okunevpy-create/TRX_27MHz/README.md

# TRX 27 MHz — самодельная КВ/СВ радиостанция

Модульная радиостанция диапазона 27 МГц (AM + SSB фазовым методом) для автомобиля и автономной работы.

## Назначение
- Связь на частотах дальнобойщиков (15-й канал, 27.135 МГц, AM).
- Радиолюбительские связи SSB (вызывная 27.190 МГц).

## Ограничения и риски
- **Мощность**: AM — не более 4 Вт (несущая), SSB — не более 12 Вт (пиковая). Ограничитель AM — обязателен, отключаемый через физический тумблер LIMIT/FULL на УМ.
- **Термостабильность SSB**: открытый вопрос, решается отдельной сессией (кварц Si5351 ±20 ppm).
- **Регуляторика**: безлицензионная СиБи в РФ; отключение ограничителя AM — осознанное действие пользователя.

## Этапы и подэтапы
| Этап | Название | Папка | Подэтапы |
|---|---|---|---|
| **0** | Мастер-лист (интерфейсы) | `KiCad/00_master` | — |
| **1** | Плата управления | `KiCad/01_control` | 1.1–1.5 |
| **2** | Усилитель мощности | `KiCad/02_power_amp` | 2.1–2.4 |
| **3** | Тракт RX/TX | `KiCad/03_rx_tx` | 3.1–3.5 |
| **4** | Корпусирование | `Mechanical/` | 4.1–4.5 |

## Рекомендуемый порядок работ
1. **Этап 0** — мастер-лист: иерархия и все межблочные сигналы.
2. Зафиксировать контракты (`docs/contracts/`).
3. Схемотехника 1.1–1.4.
4. Схемотехника 2.1–2.2.
5. **Совместно** 1.5 + 2.3 (PTT, I_sense, SWR_sense, PWR_LIMIT_EN/SW, RX_audio).
6. ⚠️ **Только теперь** — травление и монтаж платы этапа 1.
7. Доделать 2.4 (тепловой расчёт).
8. Этап 3 (3.1–3.5).
9. Этап 4 (4.1–4.5).

> **⚠️ Важно:** изготовление платы этапа 1 (травление, монтаж) начинается **только после** завершения совместных работ 1.5 + 2.3 и фиксации контракта `control_pa.md`. До этого — только схемотехника и разводка в KiCad, без травления.

## Структура
- `docs/` — документация, контракты, BOM, расчёты.
- `Firmware/` — прошивка (PlatformIO, STM32F411).
- `KiCad/` — проекты плат, локальные библиотеки.
- `Mechanical/` — корпус, панели, крепления (FreeCAD).

## Быстрые ссылки
- [Архитектура и декомпозиция](docs/block-diagram.md)
- [Питание](docs/power-distribution.md)
- [Контракты](docs/contracts/README.md)
- [BOM](docs/bom/README.md)
- [Расчёты](docs/calculations/README.md)
- [Контекст для сессий](docs/context.md)
- [Оборудование](docs/equipment.md)
- [Распиновка](docs/inter-module-pinout.md)
- [Каналы](docs/channels.md)
- [KiCad](KiCad/README.md)
- [Прошивка](Firmware/README.md)
- [Механика](Mechanical/README.md)
