okunevpy-create/TRX_27MHz/docs/README.md

# Документация проекта

- [block-diagram.md](block-diagram.md) — архитектура и декомпозиция этапов
- [power-distribution.md](power-distribution.md) — распределение питания
- [inter-module-pinout.md](inter-module-pinout.md) — сводная распиновка
- [pcb_placement_plan.md](pcb_placement_plan.md) — компоновка плат/разъёмов/кабелей в корпусе (подготовительный регламент PCB)
- [pcb_design_rules.md](pcb_design_rules.md) — правила проектирования PCB (домашнее изготовление): стек, зазоры, VIA, Edge.Cuts, origin
- [pcb_layout_stage1.md](pcb_layout_stage1.md) — поэтапный план размещения компонентов платы `01_control` (кромки разъёмов + блочная раскладка)
- [channels.md](channels.md) — сетки каналов
- [front_panel_elements.md](front_panel_elements.md) — элементы лицевой панели (OLED, энкодер, джойстик, RIT, гарнитура, LED PWR/TX/LIM)
- [led_debug_scheme.md](led_debug_scheme.md) — отладочные светодиоды (дублирующие + power-good); **все LED 0805 — в наличии (STOCK)**
- [kicad_task_stage1.md](kicad_task_stage1.md) — ТЗ KiCad-сессии (F1–F13) для `01_control`
- [context.md](context.md) — контекст для сессий
- [equipment.md](equipment.md) — измерительное оборудование
- [contracts/](contracts/) — интерфейсные контракты
- [bom/](bom/) — списки компонентов
- [calculations/](calculations/) — расчёты
