okunevpy-create/TRX_27MHz/docs/calculations/README.md

# Расчёты

- [power_limit.md](power_limit.md) — ограничитель мощности AM (4 Вт)
- [power_budget_stage1.md](power_budget_stage1.md) — точный бюджет токов 01_control (покомпонентный, с учётом периферии передней панели)
- [rit.md](rit.md) — расстройка SSB (RIT)
- [lpf_27mhz.md](lpf_27mhz.md) — ФНЧ 27 МГц (5-й порядок, Чебышёв 0.1 дБ) — этап 2, подэтап 2.2
- [bpf_27mhz.md](bpf_27mhz.md) — BPF 27 МГц (двухконтурный, ёмкостно-связанный, 2 полюса Баттерворт) — этап 3, подэтап 3.1
- [pa_stage2.md](pa_stage2.md) — УМ этапа 2: push-pull RD16HHF1, трансформаторы, смещение/лимитер, датчики, теплоотвод — этап 2, подэтапы 2.1/2.3/2.4

## Заготовки
- Кварцевый фильтр ПЧ — этап 3, подэтап 3.2
- Согласование/КСВ 27 МГц + защита RX — этап 3
