okunevpy-create/TRX_27MHz/docs/design_decisions_stage3.md

# Проектные решения этапа 3 — тракт RX/TX (03_rx_tx)

> Сессия 2026-10-31. Фиксирует архитектуру и номиналы перед построением схемы
> одним `sch_build_circuit` (3.1–3.5 целиком).

## Частотный план
- ПЧ = **10 МГц**, VFO = **37 МГц** (верхняя гетеродинная), BFO = **10 МГц**.
- RX: 27 МГц × 37 МГц → 10 МГц (разностная). TX: 10 МГц × 37 МГц → 27 МГц (разностная).

## Архитектура (фильтровый метод SSB + AM)
- **U1** (NE612) — двунаправленный смеситель: RX-вниз (RF→ПЧ) и TX-вверх (ПЧ→RF).
- **U2** (NE612) — продукт-детектор SSB (ПЧ × BFO → НЧ).
- **U4** (NE612) — балансный модулятор TX (НЧ × BFO → DSB @10 МГц).
- **X1–X4** — лестничный кварцевый фильтр 4×10 МГц, **общий** для RX (селекция ПЧ)
  и TX (выделение одной боковой из DSB).
- **K1** (реле IM06GR, DPDT) — T/R: переключает порты U1 между RX и TX.
- **Q1** (2SC2314, TO-92L) — драйвер TX, класс A/AB (линейный), ~0.2–0.5 Вт на УМ.
- **U3** (LM386) — УНЧ на динамик.

## T/R-коммутация (K1, IM06GR)
Пинаут IM06GR (подтверждён по схеме этапа 2): катушка **1=+12V, 8=драйвер**;
полюс A **3=COM, 2=NC, 4=NO**; полюс B **7=COM, 6=NC, 5=NO**.

- Полюс A: COM(3)=вход U1 (пин 1), NC(2)=`RX_BPF_OUT`, NO(4)=`IF_MIX` (фильтр).
- Полюс B: COM(7)=выход U1 (пин 4), NC(6)=`IF_MIX` (фильтр), NO(5)=`TX_BPF_IN`.
- RX (PTT=0, реле обесточено): U1.вход←BPF_RX, U1.выход→фильтр.
- TX (PTT=1, реле под током): U1.вход←фильтр, U1.выход→BPF_TX.
- Драйвер катушки: **Q2 = 2N7002** (N-MOSFET), PTT→Q2.G через 10 кОм; катушка 8→Q2.D;
  катушка 1→+12V_RXTX; flyback **D_fb = 1N4148WS** параллельно катушке.

## Переключаемая полоса кварцевого фильтра (полярность решена)
- Топология Dishal-лестница: 4 кварца в серию, связующие ёмкости на землю.
- Направление: **больше связующая ёмкость → уже полоса** (Cc ∝ 1/BW).
- Три промежуточные связующие (между X1–X2, X2–X3, X3–X4) — переключаемые:
  - **SSB (MODE=0, узкая ~2.7 кГц):** 47 пФ + 68 пФ = 115 пФ (диод открыт).
  - **AM (MODE=1, широкая ~6 кГц):** 47 пФ (диод закрыт).
- Ключ (на каждый стык N1/N2/N3): **1N4148WS**, A→узел, K→68 пФ→GND;
  `R_bias 100 кОм` узел→`V_sw` (~+3 В, общий делитель R_a=R_b от +6V);
  `R_mode 10 кОм` K-узел→MODE. MODE=0 → диод открыт (узкий), MODE=3.3 В → закрыт (широкий).
  Диодный ток ~20 мкА (мал для идеального ВЧ-ключа — на bring-up).
- Терминация: **470 Ом** (фикс., SSB) / 220 Ом (AM) — подбор на bring-up.

## Питание
- `+12V_RXTX` → **U5 (LM7809)** → `+9V` → **U6 (L78L06)** → `+6V` (NE612 ×3).
- **U3 (LM386)** на `+9V`; **Q1 (2SC2314)** на `+12V_RXTX` (через RFC).
- Развязка: электролит + 100 нФ на входе/выходе каждого стабилизатора.

## NE612 — single-ended включение (исправлено 2026-10-31)
- VCC(8)=+6V, GND(3). Развязка 100 нФ на VCC.
- Вход: пин 1 = сигнал, пин 2 → GND через 100 нФ (U1/U2) или **4.7 нФ** (U4 — сюда же подаётся смещение несущей).
- **Выход (открытый коллектор):** оба пина **4 и 5** — каждый через свою подтяжку **2.2 кОм к +6V**.
  Пин 4 = сигнал (через 10 нФ к следующему каскаду); пин 5 = 2.2 кОм к +6V + **10 нФ на GND**.
- LO: пин 6 = сигнал (через 10 нФ), пин 7 → GND через 100 нФ.
- U1 LO = `VFO` (37 МГц); U2/U4 LO = `BFO` (10 МГц).

## Несущая AM — разбаланс U4 (решено)
- Фильтровый метод даёт DSB-SC (несущая подавлена). Для AM приоткрываем баланс U4
  постоянным смещением на IN_B (пин 2) → BFO-несущая просачивается → DSB+несущая → фильтр → AM.
- `R22 100 кОм` MODE→U4.2; `RV1 10 кОм` — **делитель**: верхний вывод (1) → `R23 100 кОм` → +6V, нижний (3) → GND, движок (2) → `R24 100 кОм` → U4.2.
- MODE=0 (SSB) → баланс (DSB-SC); MODE=1 (AM) → смещение (несущая). Уровень несущей — подбор на bring-up.

## Ключевые номиналы
| Узел | Номинал |
|---|---|
| BPF 27 МГц | 2×0.47 мкГн + 2×51 пФ + 2×18 пФ + 1×2.7 пФ на фильтр (C0G 100 В) |
| Связующие фильтра ПЧ | 47 пФ (база) + 68 пФ (диод) |
| Терминация фильтра ПЧ | 470 Ом (SSB) / 220 Ом (AM) |
| Защита RX | 1N4148WS ×2 антипараллельно + T-pad 3 дБ (8.2 Ом×2 + 150 Ом) |
| LM386 | gain 20 (пины 1/8 свободны), C_вых 10 мкФ + 47 нФ, выход→J9 |
| 2SC2314 | класс A/AB (линейный): база делитель 47к/10к + C_in 100пФ, эмиттер R_e 47Ом + 10нФ, коллектор RFC 10мкГн→+12V_RXTX + C_out 100пФ, согласование 50 Ом (bring-up) |
| Аттенюатор RX | 3 дБ T-pad (8.2 Ом×2 + 150 Ом) |
| Несущая AM | разбаланс U4: R22 100к MODE→U4.2 + RV1 10к делитель (верх→R23 100к→+6V, низ→GND, движок→R24 100к→U4.2) |

## Сигналы/разъёмы
`J1` RX_RF, `J2` TX_RF, `J3` VFO, `J4` BFO (все SMA); `J5` MODE, `J9` SP (2P);
`J6` PTT_MUTE, `J7` AUDIO (3P); `J8` PWR (клеммник 2P). Референсы схемы — `J1`–`J9`.

## Открытые точки (bring-up)
- Точные связующие ёмкости/терминация кварцевого фильтра — подбор по АЧХ.
- Согласование Q1 (2SC2314) — по выходной мощности.
- Согласование 50 Ом NE612 (при необходимости — трансформаторы/LC).
