okunevpy-create/TRX_27MHz/docs/inter-module-pinout.md

# Сводная распиновка межмодульных разъёмов

> Детальные контракты — в `contracts/`.

## Этап 1 (`01_control`) ↔ Этап 2 (`02_power_amp`)
Контракт: [contracts/control_pa.md](contracts/control_pa.md)

### J_PA_CTRL_1 (XH2.54, 4P)
| Пин | Сигнал | Направление | Примечание |
|-----|---|---|---|
| 1 | GND | — | сигнальная земля |
| 2 | PTT | control → PA | ключ TX, управление T/R реле |
| 3 | PWR_LIMIT_EN | control → PA | программное управление ограничителем |
| 4 | PWR_LIMIT_SW | PA → control | обратная связь: положение тумблера |

### J_I_SENSE_1 (XH2.54, 2P)
| Пин | Сигнал | Направление | Примечание |
|-----|---|---|---|
| 1 | I_sense | PA → control | аналоговый, с шунта (витая пара с пин 2) |
| 2 | GND | — | возврат I_sense |

### J_SWR_1 (XH2.54, 2P)
| Пин | Сигнал | Направление | Примечание |
|-----|---|---|---|
| 1 | SWR_sense | PA → control | аналоговый, направленный ответвитель (витая пара с пин 2) |
| 2 | GND | — | возврат SWR_sense |

### J_PA_PWR_1 (клеммник 2P, 5.0 мм)
| Пин | Сигнал | Направление | Примечание |
|-----|---|---|---|
| 1 | +12V_PA | control → PA | защищённые, звёздой от входного узла control |
| 2 | GND | — | силовая земля, отдельная от сигнальной, соединение в одной точке |

## Этап 1 (`01_control`) ↔ Этап 3 (`03_rx_tx`)
Контракт: [contracts/control_rxtx.md](contracts/control_rxtx.md)

### Интерфейс 1↔3 (5 сигнальных разъёмов)
Единый `J_RXTX_SIG_1` (10P) **разбит на 5 разъёмов** (2026-10-30, обновлено 2026-11-05): VFO/BFO — **SMA** (коаксиал), MODE (2P), PTT/MUTE и аудио — отдельными группами (3P). На `03_rx_tx` эти сигналы приходят на `J3`/`J4`/`J5`/`J6`/`J7`.

#### J_VFO_1 / J_BFO_1 (SMA) + J_MODE_1 (2P)
| Разъём | Пин 1 | Пин 2 | Направление | Примечание |
|---|---|---|---|---|
| J_VFO_1 | VFO | GND | control → rxtx | ~37 МГц, ~1 В pp, коаксиал → `J3` |
| J_BFO_1 | BFO | GND | control → rxtx | 10 МГц, ~1 В pp, коаксиал → `J4` |
| J_MODE_1 | MODE | GND | control → rxtx | 0/3,3 В (0=SSB, 1=AM), обычный провод → `J5` |

#### J_PTT_MUTE_1 (3P)
| Пин | Сигнал | Направление | Примечание |
|-----|---|---|---|
| 1 | PTT | control → rxtx | 0/3,3 В |
| 2 | GND | — | — |
| 3 | MUTE | control → rxtx | 1 = звук заглушён (squelch) |

#### J_AUDIO_1 (3P)
| Пин | Сигнал | Направление | Примечание |
|-----|---|---|---|
| 1 | RX_audio | rxtx → control | для squelch (ADC), витая пара |
| 2 | GND | — | — |
| 3 | MIC_LINE | control → rxtx | line-level ~100 мВ, витая пара |

### J8 (клеммник 2P, 5.0 мм)
| Пин | Сигнал | Направление | Примечание |
|-----|---|---|---|
| 1 | +12V_RXTX | WAGO → rxtx | напрямую с WAGO 221-415 (13,8 В от LTC3780) |
| 2 | GND | — | силовая земля |

## Этап 2 (`02_power_amp`) ↔ Этап 3 (`03_rx_tx`) — ВЧ напрямую, минуя control
Контракт: [contracts/rxtx_pa.md](contracts/rxtx_pa.md)

| Сигнал | Направление | Примечание |
|---|---|---|
| TX_RF | rxtx → PA | ~0,5 Вт раскачки, 50 Ом, SMA |
| RX_RF | PA → rxtx | до 1 Вт просачивания, с T/R реле, защита на входе rxtx |
| GND | — | экран |

## Корпусные соединения (не межплатные)
Гарнитура подключается к корпусным разъёмам, от них — проводами на разъёмы/пады плат.
| Откуда (корпусной разъём) | Куда (плата) | Сигнал |
|---|---|---|
| 2.5 мм (MIC, Tip) | `01_control` `J_HS_1:1` | MIC (сырой с электрета) |
| 2.5 мм (PTT, Ring) | `01_control` `J_HS_1:3` | PTT (замыкание на GND) |
| 2.5 мм (GND, Sleeve) | `01_control` `J_HS_1:2` | GND (общий + экран микрофона) |
| 3.5 мм (SP+) | `J9` на `03_rx_tx` | SP+ (выход УНЧ) |
| 3.5 мм (GND) | `J9` на `03_rx_tx` | GND (общий с УНЧ) |

> **`J_HS_1`** (XH2.54 3P, на `01_control`): 1=MIC, 2=GND, 3=PTT_IN — микрофон/PTT/земля гарнитуры одним разъёмом (экран микрофона — на `J_HS_1:2` GND).

> Полная распиновка контактов (Tip/Ring/Sleeve) гарнитурных разъёмов — в
> [contracts/control_rxtx.md](contracts/control_rxtx.md), раздел «Гарнитура →
> Распиновка корпусных разъёмов гарнитуры».

## Замечания по земле
На Этапе 0 (логическая схема) — один `GND` на всех листах. В реальных платах земля раздельная: `GND_DIG`, `GND_ANA`, `GND_PWR`, соединение — в одной точке на каждой плате.
