okunevpy-create/TRX_27MHz/docs/session_report_stage3.md

# Отчёт сессии — Этап 3 (схема `03_rx_tx`, подэтапы 3.1–3.5)

> Дата: 2026-10-31. Цель: построить схему тракта RX/TX целиком одним `sch_build_circuit` и пройти первые проверки.
>
> ⚠️ **Поправка (2026-11-05):** переименование разъёмов `J1`–`J9` → `J_*_1` (п. 1 ниже) **не сохранилось/отменено** — на схеме `03_rx_tx` разъёмы остались **`J1`–`J9`**. Документация приведена к `J1`–`J9` (см. `pcb_layout_stage3.md`, `control_rxtx.md`).

## Итог
- **Схема `03_rx_tx.kicad_sch` ПОСТРОЕНА целиком** (113 компонентов, auto_layout, лист A2): подэтапы 3.1–3.5.
- **ERC: 0 ошибок / 0 warning — PASS.**
- Разъёмы переименованы в функциональные с индексом `_1`; драйвер TX — **2SC2314**.

## Сделанные исправления (после первого ERC)
1. **Разъёмы J1–J9 → `J_*_1`** (`sch_modify_property` на поле Reference, метки не менялись — связность сохранена):
   `J_RF_RX_1`, `J_RF_TX_1`, `J_VFO_1`, `J_BFO_1`, `J_MODE_1`, `J_PTT_MUTE_1`, `J_AUDIO_1`, `J_RXTX_PWR_1`, `J_SP_1`.
2. **Q1.1 (база драйвера)** — подключён к цепи `Q1_B` (был пропущен в netlist).
3. **NC-маркеры** на неиспользуемые выводы LM386: пины 1/7/8 (gain=20).
4. **Footprint'ы** приведены к реальным именам библиотек:
   - `Package_SO:SOIC-8_3.9x4.9mm_P1.27mm` (U1–U4; handsoldering-варианта SOIC-8 в KiCad нет);
   - `Capacitor_SMD:C_0603_1608Metric_Pad1.08x0.95mm_HandSolder` (все 0603 C; был Pad1.05).

## Ключевые проектные решения (зафиксированы)
- ПЧ = 10 МГц; VFO = 37 МГц (верхняя гетеродинная), BFO = 10 МГц.
- NE612AD ×3: U1 (смеситель RX/TX), U2 (продукт-детектор SSB), U4 (балансный модулятор TX).
- **Выходы NE612 (открытый коллектор):** пин 4 = сигнал (2.2 кОм к +6V + 10 нФ к каскаду); пин 5 = 2.2 кОм к +6V + 10 нФ на GND (НЕ напрямую на +6V).
- **AM-несущая** — разбаланс U4: `R_carr 100к` MODE→U4.2 + триммер `RV_carr 10к` (последовательно 47к к +6V, движок→U4.2). `C_byp` на U4.2 = 4.7 нФ.
- **Переключаемая полоса кварцевого фильтра:** X1–X4 (10 МГц), связующие 47 пФ (база) + 68 пФ (через 1N4148WS-ключ), MODE=0 → узкая SSB / MODE=1 → широкая AM.
- **Драйвер TX = 2SC2314** (TO-92L, класс A/AB линейный; заменил 2SC2078).

## Осталось (не блокирует PCB)
- Номиналы связующих/терминации кварцевого фильтра и согласование Q1 — подбор на bring-up.
- Ревью схем 1+2+3 в GUI KiCad → перенос на PCB → разводка.

## Commits
- `hw:` — схема этапа 3 (`03_rx_tx.kicad_sch`).
- `docs:` — design_decisions_stage3, BOM stage3, context, session_report, README/block-diagram.
