okunevpy-create/TRX_27MHz/docs/session_report_stage2.md

# Отчёт сессии — Этап 2: схемотехника `02_power_amp` (2.1–2.3)

Дата: 2026-10-30

## Область
Построение полной схемы усилителя мощности (`KiCad/02_power_amp`) и приведение
BOM/контрактов в соответствие схеме (простые ref, разъёмы с индексом).

## Сделано

### Схема (KiCad)
- Построены блоки 2.1–2.3:
  - **2.1 Push-pull УМ:** Q1/Q2 (RD16HHF1), входной/выходной балуны T1/T2
    (BN-61-202), RFC L1 (T68-2), развязка стоков C1/C2, bulk C3/C4,
    затворные R1/R2, опц. ООС R17/R18 (DNP).
  - **2.2 ФНЧ 27 МГц:** L2/L3 (T50-6), C6/C8 (120 пФ), C7 (220 пФ) — C0G 100 В.
  - **2.3 Датчики + LIMIT/FULL + смещение + T/R:** реле K1 (IM06GR), ключи
    Q3/Q4 (2N7002), обратный диод D1, диоды «ИЛИ» D2/D3, смещение затворов
    R3–R6 + RV1, делитель PWR_LIMIT_SW R7/R8, I_sense (R16 шунт, U1 LM358,
    R12–R15), КСВ-детектор (L4, D4/D5), LED D6/D7 + R10/R11.
- **ERC: 0 нарушений (PASS).**
- Флаги питания в порядке: `PWR_FLAG` на `+12V_PA`.
- **Разъёмы с индексом (7):** `J_RF_TX_1`, `J_RF_RX_1`, `J_ANT_1`,
  `J_PA_CTRL_1`, `J_PA_PWR_1`, `J_SW_1`, `J_LIM_LED_1`.
- **LM358** (U1) разведён **тремя юнитами** (unit 1/2/3) отдельно от
  `sch_build_circuit`; пины питания/входы/выходы подключены.
- **K1:5/6/7** — `no-connect` (добавлено после сборки через `sch_add_no_connect`).
- **R17/R18** — **DNP** (причина: опц. ООС/стабилизация, не монтировать).

### BOM (`docs/bom/stage2_power_amp.md`)
- Все позиции на схеме — простые ref (`R1…R18`, `C1…C10`, `L1…L4`, `D1…D7`,
  `Q1…Q4`, `T1/T2`, `RV1`, `U1`, `K1`).
- Добавлены отсутствовавшие позиции (R3–R6, C5/C9/C10, D2/D3 и др.).
- **1N4148WS — ×3** (D1 + D2/D3).
- U1 footprint уточнён: `Package_SO:SOIC-8_3.9x4.9mm_P1.27mm` (HandSolder-варианта
  SOIC-8 в KiCad нет).
- В таблицу «Разъёмы (J_*)» добавлен `J_LIM_LED_1`.

### Контракты и документация
- `docs/contracts/control_pa.md`: разъёмы `J_PA_CTRL_1`, `J_PA_PWR_1`, `J_SW_1`,
  `J_LIM_LED_1`, `J_ANT_1`.
- `docs/contracts/rxtx_pa.md`: `J_RF_TX_1`, `J_RF_RX_1`, `J_ANT_1`;
  `J_ANT_1` (SMA, плата) → BNC **BJ2** (панель).
- Расчётные/панельные доки, `kicad_task_stage2.md`, `design_decisions_stage2.md`,
  `README` — разъёмы приведены к индексированным именам.

## Правила (зафиксированы в `AGENTS.md` §7)
- `auto_layout=True` и ручные координаты одновременно не работают.
- Multi-unit символы (LM358) в `sch_build_circuit` не включать — разводить отдельно.
- Разъёмы (`J`) — тоже с индексом на конце (`J_RF_TX_1`); голое имя — ошибка.
- NC добавляется **после** сборки через `sch_add_no_connect`.

## Проверки
- `run_erc`: **0 нарушений (PASS)**.
- `sch_get_symbols`: состав/разъёмы/LM358 (3 юнита) — корректны.
- `sch_get_net_names`: сигнальные/силовые цепи корректны, нет `J_*`-меток.
- `sch_check_power_flags`: флаги питания в порядке.
- `sch_get_population_status`: R17/R18 `dnp=true`.

## Следующие шаги
1. Ревью схемы в GUI KiCad (footprint'ы, в т.ч. LM358 SOIC-8; визуальная проверка
   разводки LM358 и подстроечника).
2. При необходимости — уточнить footprint LM358 (HandSolder-варианта нет,
   оставить стандартный SOIC-8).
3. PCB этапа 2 (2.1–2.3): размещение, трассировка, DRC/DFM.
4. Травление платы — **отдельный шаг** (после PCB + всех проверок).
