okunevpy-create/TRX_27MHz/docs/session_report_1.4.md

# Отчёт по KiCad-сессии: подэтап 1.4 (`01_control`) — MIC-предусилитель + RX_audio RC

> **Дата:** 2026-10-28
> **Статус:** ВЫПОЛНЕНО — ERC без новых ошибок, закоммичено.
> **Промт сессии:** [`session_prompt_1.4.md`](session_prompt_1.4.md)

## Итог

Подэтап 1.4 завершён: неинвертирующий MIC-предусилитель на U7 (LM358, unit A)
с полной обвязкой и RC-фильтр входа `RX_audio` (squelch). Новые refdes
**R23–R28 / C39–C41** уникальны, коллизий нет. Лист увеличен до **A2
(594×420 мм)**.

## Таблица «задача → сделано → отклонения»

| Задача | Сделано | Отклонения |
|---|---|---|
| 3.1 MIC-предусилитель U7 (неинвертирующий) | ✅ unit A обвязан (R23–R27, C39, C41); K≈11, DC gain=1; OUT→`MIC_LINE` | нет |
| 3.2 RC-фильтр `RX_audio` → ADC | ✅ R28=1к + C40=10нФ (τ=10 мкс), узел `RX_audio_F` | нет |
| 3.3 RIT: только цепи | ✅ проверено: `BTN_RIT` (J_BTN:7), `ENC_*` (J_ENC) заведены через RC-фильтры; ничего не добавлялось | нет |
| Unit B U7 | ✅ остаётся на GND/NC (из F3) | нет |
| ERC без новых ошибок | ✅ 68 error + 16 warning (baseline 73+16) | см. «Остаточные ERC» |

## Карта фактических refdes (1.4)

| Ref | Значение | Назначение | Footprint |
|-----|---|---|---|
| R23 | 2.2 кОм | bias электрета (+3V3 → MIC+) | R_0603…HandSolder |
| R24 | 10 кОм | делитель смещения (верх, +3V3 → V+) | R_0603…HandSolder |
| R25 | 10 кОм | делитель смещения (низ, V+ → GND) | R_0603…HandSolder |
| R26 | 100 кОм | обратная связь (Vout → V−) | R_0603…HandSolder |
| R27 | 10 кОм | усиление (V− → C41 → GND) | R_0603…HandSolder |
| R28 | 1 кОм | RC-фильтр `RX_audio` | R_0603…HandSolder |
| C39 | 1 мкФ | входная связь (MIC+ → V+) | C_0603…HandSolder |
| C40 | 10 нФ | RC-фильтр `RX_audio` | C_0603…HandSolder |
| C41 | 10 мкФ | AC-земля в ОС (последовательно с R27) | C_0805_2012Metric_Pad1.15x1.40mm_HandSolder |

## Выбранные футпринты

- Резисторы R23–R28: **0603** (Metric 1608), handsoldering-вариант.
- C39 / C40: **0603**; C41 (10 мкФ) — **0805** (в 0603 нет 10 мкФ).
- U7 LM358: `Package_SO:SOIC-8_3.9x4.9mm_P1.27mm_HandSolder` (из F3, не менялся).

## Топология цепей (подтверждено connectivity graph)

| Цепь | Пины / узлы |
|---|---|
| `MIC` | C39:1, R23:2 |
| `MIC_BIAS` | C39:2, R24:2, R25:1, U7:3 (IN+) |
| `MIC_FB` | R26:2, R27:1, U7:2 (IN−) |
| `MIC_AC` | C41:1, R27:2 |
| `MIC_LINE` | R26:1, U7:1 (OUT) |
| `RX_audio` | R28:1 |
| `RX_audio_F` | C40:1, R28:2 |

**Глобальные (межблочные):** `MIC_LINE` (выход U7), `RX_audio` (вход ADC) —
как и прочие интерфейсные сигналы (PTT, VFO, BFO, I, Q, MUTE, …).
**Локальные:** `MIC`, `MIC_BIAS`, `MIC_FB`, `MIC_AC`, `RX_audio_F`.

## Исправленное в сессии КЗ

Пересечение стабов `sch_add_pin_labels` давало КЗ `MIC`/`MIC_BIAS`/`MIC_FB`
(стабы ~10.16 мм пересекали соседние пины). Устранено переразводкой короткими
проводами/метками; висящие и дублирующие метки удалены. После правки топология
корректна, КЗ нет.

## Остаточные ERC (отложено до 1.5, согласовано)

- **68 error + 16 warning** (baseline после F3–F13: 73 + 16).
- Новых `pin_to_pin` / `multiple_net_names` / `power_pin_not_driven` — **нет**.
- Остаток: 15 висящих интерфейсных глобальных меток (`PTT`, `MIC_LINE`,
  `RX_audio`, `MUTE`, …), 28 свободных GPIO MCU, неиспользуемые пины U7/U8,
  изолированные `*_OUT`/`SPI_*`/`LCD_*`, разъёмы.
- Закрытие — в подэтапе **1.5** (совместно с 2.3, после фиксации контрактов).

## Замечания / отклонения от промта

- В промте `MIC_LINE` названа «иерархической меткой»; по факту использована
  **глобальная** метка — корректно для межблочного сигнала (AGENTS.md §4),
  электрически эквивалентно для мастер-листа `00_master`.
- Лист увеличен с A3 до **A2** (пользователем) для размещения обвязки MIC без
  наложений.
- `J_OLED` переразведён пользователем под фактический порядок модуля ST7789
  (1=GND, 2=`+3V3_DISP`, 3=`OLED_SCK`, 4=`OLED_MOSI`, 5=`LCD_RST`, 6=`OLED_DC`,
  7=`OLED_CS`, 8=`LCD_BLK`) — см. `docs/bom/stage1_control.md` §1.4.

## Definition of Done

- [x] 3.1–3.3 выполнены; каждое изменение подтверждено повторным чтением.
- [x] Нет коллизий refdes (R23–R28 / C39–C41 уникальны).
- [x] ERC без новых `pin_to_pin` / `multiple_net_names` / `power_pin_not_driven`.
- [x] Unit B U7 на GND/NC; unit A обвязан полностью.
- [x] `MIC_LINE` — глобальная метка (выход U7); `RX_audio` заведён через R28/C40.
- [x] Фактические refdes зафиксированы в `docs/bom/stage1_control.md` (1.4) и `docs/context.md`.
- [x] Отчёт — настоящий файл.
