okunevpy-create/TRX_27MHz/docs/context.md

# Контекст для сессий

Обновляетис ося после каждой сессии. Вставляется в начало новой сессии (или Continue читает сам).

## Текущий этап
**Все 3 платы: схемы ПОСТРОЕНЫ, ERC=0.** Этап 1 (`01_control`) — I/Q-балласт удалён, MODE (`J_MODE_1`, PB9), ERC=0. Этап 2 (`02_power_amp`) — ERC=0. **Этап 3 (`03_rx_tx`) — схема 3.1–3.5 ПОСТРОЕНА одним `sch_build_circuit` (113 компонентов), ERC=0 (0 ошибок / 0 warning).** Разъёмы `03_rx_tx` — `J1`–`J9`; драйвер TX = **2SC2314** (TO-92L, кл. A/AB). **01_control: PCB-разводка ЗАВЕРШЕНА (2026-11-02), DRC чист. 02_power_amp: PCB-разводка ЗАВЕРШЕНА (2026-11-04), DRC/ERC чисто.** **Следующий шаг:** изготовление плат `01_control` и `02_power_amp` (текстолит, отдельные шаги) после финального ревью; можно начинать разводку PCB этапа 3. **Этап прошивки (`Firmware/`): скелет реализован и собирается (`pio run` → SUCCESS, RAM 4.2 % / Flash 14.8 %).** Этап 0 — ОТЛОЖЕН.

## 02_power_amp: сдвиг к LTC3780 + крепления + сверка отверстий после merge (сессия 2026-11-05)
- ✅ Плата 2 сдвинута вплотную к LTC3780 (зазор 5 мм): `BOARD2_ORIGIN_X = LTC_ORIGIN_X + LTC_BOARD_X + 5.0 = 17.0` (было по центру 51.0). Освобождает плате 3 до **85 мм** «высоты» (было 51 мм).
- ✅ Добавлены в `params.py`: `BOARD2_HOLES` (H1–H4), `BOARD2_STANDOFF_*`, `board2_hole_positions()`; секция крепления LTC3780 (отверстия **TBD** — по факту заводской платы).
- ⚠️ **Дрейф после merge:** H1 платы 2 сместился на 0.63 мм (Y 52.92 → 52.29, отступ 4.81 → 4.18). Фактическое: H1=(4.83, 4.18). `pcb_layout_stage2.md` §1.1 и `params.py` обновлены.
- ⚠️ **Дрейф после merge:** в `context.md` «Текущий этап» вернулось «разъёмы переименованы в `J_*_1`» — исправлено на `J1`–`J9`. Контракт/планы (`control_rxtx.md`, `pcb_layout_stage3.md`) не пострадали.

## Stock: перенос файлов заказов/склада + оценка достаточности (сессия 2026-11-04)
- ✅ Файлы заказов и доступности остатков перенесены в `Stock/`: `ChipDipCart-Stage_1.csv`, `ChipDipCart-Stage_1.1.csv` (дозаказ этапа 1), `ChipDipCart-Stage_2.csv`, `DKO.csv`, `resistance_0603.csv`, `smd_resistors_0603.csv`, `capacitors_ 0603.csv`.
- ✅ Пути в доках обновлены на `Stock/...` (`AGENTS.md`, `.continue/rules/0603.md`, `stage1_control.md`, `stage2_power_amp.md`, `context.md`, `power_cleanup_plan.md`).
- ✅ Оценка достаточности и излишков: `Stock/surplus_stage1.md`, `Stock/surplus_stage2.md`.
- ℹ️ Тумблер LIMIT/FULL остаётся **ASW-14-102** (ON-ON, SPDT 3P) — замена на KN3(B)-101A-A1 отменена. Тумблер питания — KN3(B)-101A-A1.

## 02_power_amp: финальная проверка PCB — DRC/ERC чисто + net-классы через шаблоны (сессия 2026-11-04)
Полная проверка PCB этапа 2. Исправлено и перепроверено (**DRC=0, ERC=0**):
- ✅ `.kicad_dru`: имена цепей приведены к фактическим (`/PA_RET`, `/RFC_IN` — с ведущим слэшем); ранее правила `PA_RET`/`RFC_IN` без слэша не срабатывали.
- ✅ `/PA_RET` уширена 1.0 → 1.5 мм (обратная силовая шина, ~2–3 А).
- ✅ `/ANT_RELAY` уширена 0.6 → 1.0 мм (RF-тракт).
- ✅ Стабы `+12V_PA` к U1 VCC (LM358, пин 8, ~1 мА) доведены до 1.5 мм; пады SOIC-8 сами 0.6 мм — это норма (ширина дорожки задаётся током, а пад — корпусом компонента).
- ✅ Silkscreen-перекрытие D4 ↔ C11 устранено.
- ✅ **ЗАФИКСИРОВАНО (KiCad 10):** net-классы (`PWR_PA`/`RF_PA`) **определены в `.kicad_pro` (`net_classes`) и привязываются к цепям ЧЕРЕЗ ШАБЛОНЫ** (`netclass_patterns`), а не явным назначением (`netclass_assignments` = null). KiCad сам сопоставляет имя цепи с классом по шаблону; в `.kicad_pcb` секции `net_class` нет — это норма. См. `pcb_design_rules.md`, `pcb_layout_stage2.md` §4. **Не поднимать снова вопрос «net-классы не назначены».**
- Итог: плата этапа 2 готова (габарит 78×59 мм, **59 компонентов**, 41 net).

## 02_power_amp: подтяжка R21 — safe default LIMIT (сессия 2026-11-04)
- ✅ Добавлен **R21 (100 кОм, 0603)** между `PWR_LIMIT_SW` (глобальная метка) и `PLIM_LIM` (локальная метка) — подтяжка затвора Q5 к HIGH при отключённом тумблере → по умолчанию ограничитель активен (LIMIT, 4 Вт), а не полная мощность.
- ✅ ERC = 0; `lib_verify_component_contract(R21)` = PASS; footprint `R_0603_HandSolder` корректен.
- ✅ Счёт компонентов: 61 → **62**; число цепей не изменилось (R21 мостит уже существующие `PWR_LIMIT_SW`/`PLIM_LIM`).
- ⏳ PCB **не синхронизирована**: в GUI KiCad — `Tools → Update PCB from Schematic`, разместить и развести R21, затем `run_drc`/`run_erc`.

## 02_power_amp: вариант C — лимит только через прошивку (сессия 2026-11-04)
- ✅ Удалены **Q5** (аппаратный MOSFET от тумблера), **D2/D3** (диодное ИЛИ LED). Единственный ключ лимита — **Q3** (`PWR_LIMIT_EN`, PB10).
- ✅ Тумблер `PWR_LIMIT_SW` — чистый вход MCU (PA11). LED (`J_LIM_LED_1`/D6) — напрямую от `PWR_LIMIT_EN` (R9/R10).
- ✅ R21 остаётся как подтяжка входа `PWR_LIMIT_SW`→`PLIM_LIM` (нет тумблера = LIMIT).
- ✅ Прошивка: `_applyPowerLimit()` — `PWR_LIMIT_EN = AM && (тумблер LIMIT)`; захардкоженного дефолта нет (читается фактическое положение тумблера). Файлы `app.cpp`/`app.h`/`pins.h`.
- ✅ ERC = 0. Счёт компонентов: 62 → **59**.
- ⏳ PCB **не синхронизирована**: GUI `Tools → Update PCB from Schematic` (удалить Q5/D2/D3, обновить LED-связи), затем `run_drc`/`run_erc`.

## 02_power_amp: план разводки + токовый бюджет + net-классы + заклёпочная via (сессия 2026-11-04)
Подготовлен план разводки этапа 2. Плата изготавливается **дома**, переходные — **заклёпочные пистоны**.
- ✅ **Токовый бюджет** (`docs/calculations/power_budget_stage2.md`): покой **1.0 А** (Idq 0.5 А×2); полная мощность **1.78–2.11 А** (Po=16 Вт, η 55–65 %, 13.8 В); расчётный предел шины **3 А**. Шунт R16 (0.05 Ом) — в минусовой шине (`PA_RET → R16 → GND`).
- ✅ **Ширины дорожек** (IPC-2221, 1 oz, ΔT=10 °C): 3 А→1.367 мм, 1.5 А→0.525 мм, 0.5 А→0.115 мм.
- ✅ **Net-классы** (`docs/pcb_layout_stage2.md` §4): `PWR_PA` **1.5 мм** (`+12V_PA`/`PA_RET`/`RFC_IN`), `RF_PA` **1.0 мм** (`ANT`/`LPF_*`/`TX_RF`/`RX_RF`/`DRAIN1`/`DRAIN2`), Default **0.6 мм**. Назначение — точными именами, без wildcard.
- ✅ **VIA заклёпочная (переопределяет 0.5/1.5 мм только для этапа 2):** сверло **0.9 мм**, площадка **2.5 мм** (аннулюс 0.8 мм). Зафиксировано в `pcb_design_rules.md` §VIA и `pcb_layout_stage2.md` §5.
- ✅ **Зазоры/ширина (этап 2, 2026-11-04):** мин. дорожка **0.6 мм**, зазор медь–медь **0.4 мм**, GND-полигон **0.5 мм** (глобально 0.2/0.2/0.3 мм).
- ✅ **Габарит платы — по факту разводки** (заранее не фиксируется; минимум задают радиатор 102 мм и кромки разъёмов).
- Следующий шаг: пользователь в GUI KiCad — настройка net-классов + via Ø2.5/0.9, размещение + трассировка (Freerouting); агент проверит `run_drc`/gates.

## 02_power_amp: исправление КСВ-детектора — L4 → T3 (сессия 2026-11-04)
Блок КСВ (`L4/D4/D5/C10/R15/J_SWR_1`) был электрически оторван от остальной схемы (только GND). Исправлено:
- ✅ **L4 (2-выв. `Device:L`) → T3 (`Device:Transformer_1P_1S`, 4 выв.)** — токовый трансформатор КСВ: первичка AA/AB = **1 проход линии ANT в разрыв** (`ANT_RELAY`←`K1:3` → `ANT`→`J_ANT_1`); вторичка SA→GND, SB→`SWR_RF`.
- ✅ **D5 (фиксатор BAT54W) A→GND** (было оборвано после перехода на символ `Diode:BAT54W`); D4 (выпрямитель) A←`SWR_RF`, K→`SWR_sense`.
- ✅ **ERC = 0** (0 ошибок / 0 warning). NC-пины BAT54W (D4:2/D5:2) — штатно без no-connect.
- ✅ **Net `ANT_RELAY` добавлен** в `RF_PA` (1.0 мм) — сегмент линии ANT между K1 COM и T3.
- ✅ **Доки синхронизированы:** `bom/stage2_power_amp.md`, `design_decisions_stage2.md` §6, `kicad_task_stage2.md`, `pcb_layout_stage2.md` §4.2/§6/§8.4, `calculations/pa_stage2.md` — L4/T_swr → T3, символ/футпринт обновлены. Счёт: индуктивности 3 + трансформаторы 3 (всего 59).
- ✅ **`.kicad_dru` этапа 2 создан** (`KiCad/02_power_amp/02_power_amp.kicad_dru`) — синтаксис как у этапа 1: edge 0.5, via Ø2.5/0.8, hole-to-hole 0.5, GND clearance 0.5, ширины `+12V_PA`/`PA_RET`/`RFC_IN` 1.5 мм.
- ✅ **T1 футпринт унифицирован (по решению пользователя):** `Transformer_THT:Transformer_Toroid_Horizontal_D14.0mm_Amidon-T50` → `Connector_PinHeader_2.54mm:PinHeader_1x04_P2.54mm_Vertical` — теперь все три трансформатора на PinHeader (T1/T3 = 1x04, T2 = 1x05). BAT54W — осознанно оставлен (цоколёвка 1=A/2=NC/3=K).
- ✅ **Q4 (PTT) pull-down добавлен:** R20 (10 кОм, 0603) с затвора Q4 на GND — при отключённом разъёме реле гарантированно выключено (RX). Счёт компонентов: 60.

## 02_power_amp: return-loss мост — C11 выборка напряжения (сессия 2026-11-04)
Завершён SWR-детектор как **return-loss мост** (отражённая мощность), вместо «упрощённого детектора».
- ✅ **C11 (22 пФ C0G/NP0 100 В, подбор 10–33 пФ)** — конденсатор выборки напряжения с линии ANT на узел `SWR_RF` (`C11:1→ANT`, `C11:2→SWR_RF`).
- ✅ **Мост:** вторичка T3 (ток) + C11 (напряжение) гасят падающую волну → при согласовании 50 Ом `SWR_sense`≈0; в нагрузку/детектор уходит только отражённая волна.
- ✅ **ERC = 0** (0 ошибок / 0 warning). Счёт компонентов: **61** (конденсаторы 11).
- ✅ **Доки синхронизированы:** `design_decisions_stage2.md` §6, `bom/stage2_power_amp.md` §2.3, `pcb_layout_stage2.md` §8.4/итог.
- ⚠️ **Настройка на плате:** с эквивалентом 50 Ом на `J_ANT_1` подобрать C11 (10–33 пФ) и/или фазировку вторички T3 до минимума `SWR_sense`.

## 01_control: аудит подозрительных соединений перед заказом (сессия 2026-11-03)
Геометрический разбор `.kicad_pcb` (508 дорожек / 391 площадок / 45 переходных / 364 зоны) → вычищено полностью:
- ✅ **Маргинальный контакт `/I2C_SCL` исправлен** — дорожка от MCU `U4.42` к EEPROM `U10.6` (AT24C02, SCL) доходит до центра площадки `(124.2025, 78.925)`.
- ✅ **Висячий микро-stub удалён** (остаток правки `d7854017`, 0.0016 мм) — висячих/неприходящих дорожек больше нет.
- ✅ **DRC чисто:** 0 violations / 0 unconnected / 0 courtyard (после правки правил DRC и настроек цепей; teardrop-зазоры закрыты).
- ✅ **Переходные: 45 шт все Ø0.6 / сверло 0.3 мм** — заводские металлизированные via, стандарт завода (ПОДТВЕРЖДЕНО 2026-11-03).

## Firmware: настройка PlatformIO + UI/UX (сессия 2026-11-03)
- **PlatformIO финализирован и проверен** (`Firmware/platformio.ini`): board **`genericSTM32F411CE`** (HSI 16 МГц → 96 МГц, отказ от HSE 25 МГц BlackPill — по решению пользователя), `upload_protocol=dfu`, USB CDC (`USBCON`+`USBD_USE_CDC`), `default_envs`, lib_deps: **Si5351 + Arduino_GFX** (`moononournation/GFX Library for Arduino`). `pio run` → **SUCCESS** (RAM 3.5 %, Flash 3.6 %). Adafruit ST7789 отброшен (не собирается на STM32: `wiring_private.h`).
- **UI/UX СОГЛАСОВАН** — `docs/firmware_ui_ux.md`: экраны (RX/TX/меню/RIT/предупреждение LIM), конечный автомат, маппинг входов (энкодер/джойстик/RIT/PTT), меню, каналы EU/RUS, squelch, ограничитель AM. Остальные правки — **по факту** (bring-up/замеры).
- Маппинг GPIO зафиксирован: дисплей SPI1 PA5/PA7 (+PA4/PA6/PA3/PB0), энкодер PB12–14, джойстик PC13–15/PB1/PB2, RIT PB15, PTT_IN PB5, MODE PB9, MUTE PB8, PWR_LIMIT_* PA11/PB10, ADC PA0–2, I²C PB6/PB7.
- **Предварительные испытания и отладка — через Wokwi Simulator** (до сборки железа).

## Firmware: скелет прошивки + сборка (сессия 2026-11-03)
Реализован компилируемый скелет (`pio run` → SUCCESS, RAM 4.2 % / Flash 14.8 %):
- **`include/pins.h`** — маппинг GPIO (единая точка истины) из BOM §1.5.
- **`include/config.h`** — константы (частотный план VFO=RF+10 МГц, RIT, пороги нажатий) + `Settings` (EEPROM).
- **`src/inputs.{h,cpp}`** — `Button` (антидребезг + CLICK/DOUBLE/LONG) и `Encoder` (квадратура + кнопка).
- **`src/hal_si5351.{h,cpp}`** — Si5351: CLK0=VFO, CLK1=BFO.
- **`src/hal_display.{h,cpp}`** — ST7789 (Arduino_GFX), подсветка PWM PB0.
- **`src/hal_adc.{h,cpp}`** — I_sense/SWR/RX_audio (RMS для squelch).
- **`src/hal_eeprom.{h,cpp}`** — AT24C02C (0x50), load/save `Settings`.
- **`src/app.{h,cpp}`** — конечный автомат BOOT/VFO/TX/MENU/RIT + каналы CEPT 40 + RIT + squelch + PTT + MODE + ограничитель.
- **`src/ui.{h,cpp}`** — экраны VFO/TX/MENU/RIT/BOOT.
- **`src/main.cpp`** — setup/loop (1 мс tick).

Ключевые находки (bring-up):
- **Adafruit Si5351 v1.6.0 — другой API:** `setFrequency(output, pll, freq)` (Гц), `enableOutputs()`, `begin()`→`err_t`. Опорник в библиотеке жёстко **25 МГц** (нет сеттера), у нас TCXO **27.6 МГц** → поэтому в `hal_si5351.cpp` делители считаются сами через низкоуровневые `setupPLL()/setupMultisynth()/setupRdiv()` с реальной опорой `SI5351_REF_HZ = 27.6 МГц` (хак масштабирования ×`125/138` убран).
- **Arduino_GFX цвета** — `RGB565_BLACK/WHITE/RED/GREEN/YELLOW` (не `BLACK` и т.п.); `Arduino_HWSPI(dc, cs, &SPI)` (не пины SCK/MOSI).
- **PA6 = DC**, но это же MISO у SPI1 — решено в коде: `SPI.setMISO(PNUM_NOT_DEFINED)` в `hal_display.cpp`.
- Канальный план CEPT 40 (EU 26.965–27.405 с пропусками) + RUS −5 кГц — таблица в `app.cpp`.
- **Частотный план (в коде):** VFO = RF + 10 МГц (верхняя гетеродинная, RF = VFO − ПЧ), BFO = 10 МГц фикс. **RIT — только в приёме (SSB)**, не в TX: `_vfoHz()` прибавляет RIT лишь при `!_ptt`, пересчёт VFO по PTT (`_freqDirty`).
- **✅ Сверено со схемой (KiCad MCP, 2026-11-03):** Si5351 **CLK0 (pin 10) = VFO**, **CLK1 (pin 9) = BFO**. Путь: `VFO_RAW = U5:10(CLK0) → U8:2(A1) → U8:18(Y1) → R19(22R) → J_VFO_1`; `BFO_RAW = U5:9(CLK1) → U8:3(A2) → U8:17(Y2) → R20(22R) → J_BFO_1`. TCXO 27.6 МГц → `U5:2(XA)` (`REF_CLK`). `U5:6(CLK2)` — NC. Код (`hal_si5351.cpp`: CLK0=VFO, CLK1=BFO) **корректен**. ⚠️ **Контракт `control_rxtx.md` «CLK1 — VFO» — ошибка** — **исправлено (2026-11-03, по согласованию).**
- **Открытое (bring-up §12.1):** точный отстрой BFO от центра кварцевого фильтра (выбор боковой/качество SSB) и калибровка Si5351 (27.6 МГц) — по частотомеру.

## Firmware: BFO_OFFSET_HZ + native/Unity тесты (сессия 2026-11-03)
- **`BFO_OFFSET_HZ`** добавлен в `config.h` (int32_t, по умолч. 0) — отстрой BFO от центра кварцевого фильтра (±1.5 кГц, выбор боковой SSB). Применяется через `bfoHz()` в `app.cpp` (`begin()` + `_applyFrequency()`), со знаковой арифметикой (иначе отрицательный отстрой завернётся в uint32).
- **Каналы вынесены** в чистый header-only `include/channels.h` (`CHANNEL_COUNT`, `EU_CHANNELS`, `channelFreq`, `freqToChannel`) — из `app.cpp` убрана локальная статика; из `config.h` убран `CHANNEL_COUNT`.
- **`[env:native]` + Unity** добавлены в `platformio.ini`; тест `test/test_logic.cpp` (12 тестов: каналы + энкодер + кнопки), шам `Arduino.h` в `test/support/`.
- **Сборка:** `pio run` → SUCCESS (Flash 77804 B). Тест-код компилируется (`arm-none-eabi-g++ -fsyntax-only` → 0).
- ⚠️ **`pio test -e native` НЕ запускается** — на машине нет хостового компилятора (gcc/g++/clang/MSVC). Доступны `winget`/`choco` для установки MinGW-w64.
- **Wokwi:** эмулирует STM32, но **только F103 (Blue Pill)**; STM32F411CEU6 (BlackPill) в Wokwi не поддерживается → полный симулятор прошивки не запустить, нужна реальная плата.

## Firmware: VFO/BFO-математика + FULL@AM (сессия 2026-11-03)
- **VFO/BFO-математика вынесена** в чистый `include/rf_math.h` (`IF_HZ`, `BFO_HZ`, `vfoHz()`, `bfoHz()`); из `config.h` убраны `IF_HZ`/`BFO_HZ`, `app.cpp` использует `rf_math.h`.
- **Покрытие тестов:** +8 (VFO: RIT только в RX/SSB, игнор в TX/AM; BFO: ±отстрой) — всего **20 тестов**, все PASSED (`pio test -e native`).
- **A.2 — предупреждение «FULL @ AM!»** в `ui.cpp` (экраны VFO и TX), когда тумблер FULL при AM (контракт `control_pa.md`).
- **A.3 не делаем** — ограничитель только физический тумблер, `PWR_LIMIT_EN` (PB10) остаётся резервом.
- **Компилятор:** WinLibs 16.2.0 (MinGW-w64) установлен, прописан в пользовательский PATH; тесты 20/20 PASSED (нужен перезапуск редактора, чтобы PATH подхватился без ручного export).

## Mechanical: задняя крышка — разъёмы + держатель предохранителя (сессия 2026-11-03)
Доработана задняя крышка (`build_back_cover.py` + `params.py` секция 11):
- **Антенный разъём BNC** — сквозное отверстие **Ø9.5** (`ANT_HOLE_D`), X=25, Z=25.
- **Разъём внешнего питания KLS1-DC-025A-2.0** — отверстие **Ø8.0** (`PWR_CONN_HOLE_D=8.0`, **TBD по факту детали**), X=155, Z=25 (справа).
- **Держатель предохранителя FH10-S-MZ (5×20 на панель)** — НОВЫЙ элемент, отверстие **Ø12.8** (`FUSE_HOLE_D=12.8`, **TBD**), X=133, Z=25 — **рядом с DC-питанием** (слева, в 22 мм).
- У каждого отверстия — усиливающая бобышка на внутренней грани (`BACK_BOSS_H/WALL=3.0`).
- В сборку добавлены схематичные модели задних разъёмов (`schematic_back_controls()`), sanity — `_back_items()`.
- Проверки: `python params.py` → SANITY OK; `freecadcmd build_back_cover.py` → valid (67 граней, BOP CLEAN); `build_assembly.py` → OK.

## 01_control: точный бюджет токов потребления (сессия 2026-11-03)
Покомпонентный расчёт по фактической схеме — `docs/calculations/power_budget_stage1.md`. Итог: **~105 мА (тип.) / ~160 мА (макс.) от 13.8 В**, шины дорожек подтверждены (все ≤ 0.3 мм хватает). Ключевые находки:
- **U8 (74AC541) питается от `+3V3`** (пин 20), не от `+5V` — раньше в бюджете не был (добавлено 10–20 мА на `+3V3`).
- **MCU на HSI 16 МГц** → реально 15–30 мА, старый запас «100 мА» завышен в ~3–7 раз.
- **Подсветка ST7789 — доминирующая нагрузка (~150–200 мА) и главная неопределённость:** R35=12Ω на 3.3 В физически не даст 200 мА (упадёт 2.4 В). Фактический ток замерить на bring-up, подобрать R35.
- **U9 (RT9193, SOT-23-5) при 200 мА подсветки: P≈0.37 Вт → ΔT≈85°C** — тепловой риск; при реалистичной подсветке 50–60 мА проблемы нет.
- R5 (10Ω) в питании Si5351: падение 0.49 В (макс.) → на Si5351 2.81 В (предел 2.5 В) — запас 0.31 В.
- **U7 (LM358), второй ОУ: IN+→GND, IN−→GND, OUT→NC — НЕ критично (решено 2026-11-03).** Выход разомкнут → тока нет, генерации нет (LM358 медленный, unity-gain stable), выход просто садится на шину по знаку Vos. Травить плату как есть; переразводить/перепечатывать НЕ нужно. Опциональная причёска без респина: перерезать дорожку пин6→GND и перемычка пин6↔пин7 (повторитель).

## Mechanical: генерация корпуса — новые компоненты + плата 1 (сессия 2026-11-03)
Внесены правки в генерацию корпуса (`Mechanical/params.py` + скрипты):
- **Добавлен тумблер LIMIT/FULL (ASW-14-102)** на переднюю панель — 7-й элемент равного шага (было 6). Секция `9b` (`LIM_SW_*`), `X≈154.6`, посадочное Ø12.2/цековка Ø16 «по типу» тумблера питания (**TBD по факту детали**). Добавлен в `FRONT_LAYOUT`, `_front_items()` (sanity), `lim_switch_features()` в `build_front_panel.py`, схематику в `build_assembly.py`.
- **Габариты элементов в `_front_items()` уточнены до лицевой стороны** (энкодер = nut flat 14, джойстик = отверстие под штырёк Ø8.2) — раньше брались модульные платы за панелью, что занижало свободное место.
- **Плата 01_control (120×66) + 4 монтажных отверстия H1–H4 (Ø3.2, M3)** добавлены: `params.py` секция 17 (`BOARD1_*`, `board1_hole_positions()`), стойки Ø8+пилот M3 h=6 на дне `shell_bottom` (`board1_mount_features()` в `build_shells.py`). Позиция платы `BOARD1_ORIGIN_X/Y` — **TBD** (черновая: по центру ширины, у передней панели).
- Проверки: `python params.py` → SANITY OK (11 элементов, без наложений); `py_compile` всех скриптов → OK.

## Mechanical: новая компоновка передней панели (сессия 2026-11-03)
По решению пользователя (панель была «наляпана») компоновка переделана на **явные координаты** (вместо равного шага):
- Порядок слева направо: **гарнитура → экран → джойстик → энкодер → кнопка RIT → тумблер LIMIT/FULL → тумблер питания.**
- Гарнитура — **левее всех** (длинный провод не болтается у кнопок), экран следом.
- **Светодиоды PWR/TX/LIM — горизонтальной линией НАВЕРХУ** (Z=42, над джойстиком/энкодером/RIT), а не вертикальной колонкой справа.
- `led_positions()` переписан на горизонталь (`LED_CENTER_X/Y`, `LED_PITCH_X` вместо `LED_PITCH_Z`/`LED_COLUMN_X`).
- Проверки: SANITY OK; `freecadcmd build_front_panel.py` → valid (176 граней); `build_assembly.py` → OK.

## Mechanical: раздвинута компоновка, органы сдвинуты к экрану (сессия 2026-11-03)
По решению пользователя (первая правка была сделана «наоборот» — джойстик уехал от экрана):
- Органы управления (джойстик/энкодер/RIT) сдвинуты **К ЭКРАНУ** (влево), шаг ~20 мм: джойстик **92**, энкодер **112**, RIT **132**.
- Тумблеры справа, отодвинуты: LIMIT/FULL **154**, питание **172**.
- Светодиоды выровнены по центрам с органами управления: LED_PWR **92** = джойстик, LED_TX **112** = энкодер, LED_LIM **132** = RIT (`LED_CENTER_X=112`, `LED_PITCH_X=20`).
- Зазоры по лицевым посадочным: джойстик↔энкодер 8.9 мм, энкодер↔RIT 5 мм, RIT↔LIMIT **6 мм** (разделение), LIMIT↔PWR 2 мм.
- Проверки: SANITY OK; `freecadcmd build_front_panel.py` → valid (176 граней).

## Mechanical: энкодер↔RIT поменяны местами + крепление энкодера (сессия 2026-11-03)
По решению пользователя:
- **Энкодер и кнопка RIT поменяны местами:** джойстик 92 → кнопка RIT **112** → энкодер **132** → тумблеры 154/172. Светодиоды остались выровнены по X с контролами (LED_TX 112 = RIT, LED_LIM 132 = энкодер).
- **Крепление энкодера исправлено:** плата модуля **26×18×22 мм** (факт, `ENC_BOARD_W/H/D`), **вал смещён от центра платы на 4 мм по УЗКОЙ стороне (Z), ОТ края с отверстиями** (`ENC_SHAFT_DZ=4`), **2 монтажных отверстия по углам вдоль широкой стороны** (26 мм): `ENC_HOLES_DX=22`, `ENC_HOLES_Z=7` (было 2 отверстия в линию по центру). `ENC_STANDOFF_D` 6→5. `ENC_SCHEMA_BOARD` удалён → в схеме используется `ENC_BOARD_W/H`.
- Проверки: SANITY OK; `freecadcmd build_front_panel.py` → valid (184 граней).

## 01_control: разводка ЗАВЕРШЕНА + финальные решения (сессия 2026-11-02)

- **PCB 01_control разведена.** Размер **120 × 66 мм**, origin = левый верхний угол Edge.Cuts, 2 слоя.
- **DRC:** 10 нарушений, **все `excluded`** — на U5/Si5351 (MSOP-10, шаг 0.5 мм; зазор пад-пад 0.15 / дорожка-пад 0.175 мм против 0.2) — **штатно исключены, исправлять нельзя** (шаг корпуса). **0 unconnected, 0 courtyard.**
- **ERC:** 7 warnings, все excluded (footprint link issue), не блокирует.
- **Via:** 46 шт, все Ø1.5 / drill 0.5 (проволочные перемычки). GND — 7 шт. Лишних нет.
- **GND-полигон:** сплошной на F.Cu + B.Cu, без thermal relief, зазор 0.3. Под MCU полигон выведен **не только на внутр. пад 49, но и наружу** (короткий выход к пину GND) — исправлено.
- **Доп. сшивка GND у U4:** перемычка `(118.88, 81.24)` возле пина 47 (левая грань QFN). Одной хватило — вокруг U4 три GND-виа (118.88 слева / 124.16 низ / 130.54 справа), центр-пад 49 на верхнем полигоне. Больше не добавлять.
- **DRC-правило `HomeFab_3v3_width`** (`+3V3` min 0.3 мм) — добавлено в `01_control.kicad_dru`, синтаксис валиден. Net-класс `PWR_3V3` (0.3) покрывает `+3V3` и `/+3V3_SI_F`.
- **Монтажные отверстия H1–H4** (M3, Ø3.2) — см. `docs/pcb_layout_stage1.md` §«Монтажные отверстия».
- **MCU — внутренний HSI 16 МГц** (Y1/C9/C10 удалены). UART_TX — только отладочная консоль, прошивка по SWD.

## Разводка 01_control: размещение R/C элементов управления + что вести по B.Cu (сессия 2026-11-02)

**Вопрос пользователя:** плата в один слой не разводится. Куда ставить подтяжки/конденсаторы на элементах управления (к MCU или к разъёмам) и что вести по B.Cu (сигнал или питание, или и то и другое).

**Ответ (зафиксировано):**
- **Подтяжки + фильтрующие конденсаторы (энкодер `R12`–`R14`/`C35`–`C37`, кнопки `R6`–`R11`/`C29`–`C34`) — к MCU (U4), у входа GPIO, не к разъёмам.** Это RC-антидребезг; фильтр ставим у приёмника — после фильтра минимальный кусок проводника, и у MCU уже есть локальные `+3V3`/`GND` (к разъёму идёт одна сигнальная дорожка вместо трёх). Последовательные `R15`–`R18` (22Ω SPI OLED) — у источника (MCU).
- **B.Cu — можно и сигнал, и питание.** Ограничивают не тип цепи, а: (1) минимум смен слоёв (каждый переход = проволочная перемычка Ø1.5/drill 0.5 = лишняя пайка), (2) целостность GND-заливки на B.Cu. **F.Cu = основной слой (~90%):** короткие сигналы + вся развязка + силовой контур DC-DC U1–L1–D3 (без переходов). **B.Cu =** короткие перемычки через препятствие + опционально длинные магистрали `+5V`/`+3V3`/`VIN_PROT` с короткими подъёмами. Аналог (`RX_audio`/`I_sense`/`SWR_sense`/`MIC`) — только F.Cu, в стороне от DC-DC.

Детали — в `docs/pcb_layout_stage1.md` §«Разводка: что вести по F.Cu / B.Cu + размещение R/C элементов управления».

## PCB-правила и разводка — ФИКСАЦИЯ (сессия 2026-10-31, PCB)

### Жёсткие решения (действуют для всех плат и последующих сессий)
| Параметр | Значение |
|---|---|
| Слои / толщина / медь | 2 слоя, 1.6 мм FR4, 1 oz (35 мкм) |
| Мин. дорожка / мин. зазор | **0.2 / 0.2 мм** (дефолт KiCad — принят как предел дом. изготовления) |
| VIA (сверло / площадка) | **0.3 / 0.6 мм** — заводские металлизированные via (стандарт завода) |
| Edge.Cuts (контур) | линия шириной **0.9 мм** |
| Origin (координаты) | **левый верхний угол** Edge.Cuts |
| Drill origin (сверловка) | тот же угол (левый верхний) |
| Полигон GND | заливка **с обеих сторон**, зазор полигона **0.3 мм** |
| Маска / шелкография | маска **есть**, шелкография **нет** |
| Зазор меди от края | **0.5 мм** |
| Земля | **единый `GND`** + сплошная заливка; разделение «цифра/аналог/силовое» — **геометрией полигона** (звезда в одной точке у bulk-конденсатора C3 / входа `J_12V_IN_1`), **не** отдельными net-ами |
| ВЧ разъёмы | **SMA S-P215** (все VFO/BFO/TX_RF/RX_RF/ANT); символ `Connector:Conn_Coaxial_Small`, footprint `trx_custom:SMA_S-P215` |
| Полигон GND | сплошная заливка, **без thermal relief** |
| Идентификация компонентов | **без шелкографии** — сверка с разводкой + BOM + схема при распайке |
| Габариты | определяются **перед началом разводки**; `01_control` — рабочий лимит **120 × 90 мм** (Ш×Г) |

### Кромки разъёмов (01_control, вид со стороны F.Cu)
- **Слева** — питание: `J_12V_IN_1`.
- **Справа** — ВЧ выходы: `J_VFO_1`, `J_BFO_1`.
- **Сверху/снизу** — коммутационные: сверху межплатные (02/03): `J_PA_CTRL_1`, `J_I_SENSE_1`, `J_SWR_1`, `J_MODE_1`, `J_PTT_MUTE_1`, `J_AUDIO_1`; снизу UI/отладка: `J_OLED_1`, `J_ENC_1`, `J_BTN_1`, `J_HS_1`, `J_LED_1`, `J_SWD_1`, `J_UART_1`.
- «Верх/низ» — физические кромки платы, **НЕ** слои F.Cu/B.Cu.

### Разделение работ
- **Размещение + поворот + трассировка** — пользователь, в GUI KiCad (трассировка через плагин Freerouting).
- **Агент** — готовит правила/доки/план размещения и **проверяет результат** (`run_drc`, gates, bbox/координаты). У агента НЕТ MCP-инструментов `pcb_place/move/rotate` и `route_autoroute_freerouting` (`freeroutingAvailable=false`) — подтверждено 2026-10-31.

### Следующие шаги (для след. сессии)
- ✅ **Токи силовых цепей рассчитаны** (IPC-2221): все ≤ 0.5 А → **0.2 мм достаточно**; net-классы: `+5V` 0.3 / `VIN_PROT` 0.4 (см. `docs/calculations/power_trace_widths.md`).
- ✅ **DRC-правила созданы** в `01_control.kicad_dru` (7 шт): edge 0.5 / via Ø1.5 / annulus 0.5 / hole-to-hole 0.5 / GND зазор 0.3 / VIN 0.4 / +5V 0.3. Осталось в GUI: **Pre-defined via size 1.5/0.5** (иначе Freerouting вставит дефолтные 0.8/0.4).
- ✅ **Net-классы зафиксированы (2026-10-31):** `PWR_12V` 0.4 (`VIN_PROT`), `PWR_5V` 0.3 (`+5V`), `PWR_3V3` 0.3 (`+3V3`), остальное Default 0.2. Назначение — **точными** именами, не wildcard. См. `docs/pcb_layout_stage1.md` §Net-классы.
- ✅ **Земля — РЕШЕНО (2026-10-31):** единый `GND` + сплошная заливка, разделение «цифра/аналог/силовое» — **геометрией полигона** (звезда у bulk-конденсатора C3 / входа `J_12V_IN_1`). В схеме одна цепь `GND` (188 пинов) — это намеренно, отдельные net-ы не вводим.
- ✅ **ПОДТВЕРЖДЕНО (2026-10-31):** `pcb_place/move/rotate` и `route_autoroute_freerouting` **НЕ доступны** агенту через MCP — размещение/поворот/трассировку делает пользователь в GUI.
- Раскладка в корпусе — **в линию вдоль глубины** (задняя крышка → 02 → 03 → 01 → передняя панель); 01_control = 90 мм глубины, остаток ~54 мм на 02+03.

## Схема 01_control: правки разводки (сессия 2026-11-01)
- **Внешний кварц MCU удалён:** `Y1` (8 МГц) + `C9`/`C10` (20 пФ) сняты со схемы. MCU работает от **внутреннего HSI 16 МГц** (вариант B). UART — только отладочная консоль; прошивка — по SWD.
- **Перестановка GPIO (U4):** `PB12(25)=ENC_CLK`, `PB13(26)=ENC_DT`, `PB14(27)=ENC_SW`, `PB15(28)=BTN_RIT`.
- **`J_OLED_1` (8P) переразведён:** 1=GND, 2=+3V3_DISP, 3=LCD_BL, 4=LCD_RST, 5=OLED_CS, 6=OLED_SCK, 7=OLED_DC, 8=OLED_MOSI. **НЕ прямой шлейф 1:1** с ST7789 (шлейф кросс-разведён).
- **`J_ENC_1` (5P):** 1=GND, 2=+3V3, 3=ENC_CLK, 4=ENC_DT, 5=ENC_SW (пины 3/5 поменяны местами).
- **Маппинг развязки +3V3:** U4=C11–C14, U8=C15, U7=C38, U10=C16, C45 — запасной (выход U2.5).

## EEPROM + питание этапов 2/3 (сессия 2026-10-31)

### EEPROM (01_control) — ДОБАВЛЕН
- **U10 = AT24C02CM/TR** (символ `Memory_EEPROM:24LC02`, footprint `SOIC-8_3.9x4.9mm_P1.27mm`, SOP-8). I²C на шине `I2C_SCL`/`I2C_SDA` (PB6/PB7, общая с Si5351). A0/A1/A2→GND (адрес 0x50), WP→GND (запись разрешена) — хранение RIT/каналов. Развязка **C45 100 нФ**.
- **ERC: 0 ошибок** (7 warning `footprint_link_issues`, исключены). BOM/README обновлены. ⚠️ Компонент **TO-ORDER**.

### Питание этапов 2/3 — ответ (финальное решение 2026-10-31)
- `02_power_amp` и `03_rx_tx` питаются **не от АКБ**, а от предрегулятора **LTC3780 (13,8 В)** через **внешние клеммы WAGO 221-415**: `LTC3780 → WAGO(+12V, GND) → {01_control (J_12V_IN_1), 02_power_amp (J_PA_PWR_1), 03_rx_tx (J_RXTX_PWR_1)}`.
- **Раздача +12V снята с `01_control`**: убраны разъёмы `J_PA_PWR_1`/`J_RXTX_PWR_1` и 0Ω-звезда R29/R30; **убраны и входные D1(TVS SMBJ18A)/D2(SS34)** — на плате остался только вход `J_12V_IN_1 → VIN_PROT → C1/C2 + U1`, вся защита — на корпусе. ERC=0 (0 ошибок).
- 13,8 В в пределах «12–14,5 В» (контракты); на PA мощность/смещение задаёт ограничитель, на RXTX LM7809 имеет запас. Ревью: конденсаторы шин +12V_PA/+12V_RXTX ≥16 В.

## PCB-компоновка: черновик регламента (сессия 2026-10-31)

### Сделано
- ✅ Создан `docs/pcb_placement_plan.md` (Вариант А — мастер-док): цели, исходные данные, габариты плат, размещение в корпусе, пинаут-правила, кабельная таблица, стойки M3, DoD+порядок работ, back-annotation.
- ✅ Габариты плат прикинуты по фактическому составу (`sch_get_symbols`): `01_control` ~122 комп → **80×70** (≤9×9 см, README); `02_power_amp` ~61 → **90×70** + радиатор; `03_rx_tx` ~117 → **85×70**.
- ✅ Полость корпуса уточнена: **180×144×50** (X×Y×Z), источник `params.py` (`CASE_W/CASE_D/CASE_H`).
- ✅ Ссылка добавлена в `docs/README.md`.

### Решения пользователя (зафиксированы 2026-10-31)
1. **Силовые провода — по левой стенке**; правая стенка и центр — сигнальные/межплатные.
2. **УМ у задней крышки** + радиатор там же; **жабры на задней стенке + 2 вентилятора 40×40 мм, 12 В, на задней крышке (выдув)**.
3. Панельные органы сильно меньше — конфликта с платами нет (проверено).
4. **Стойки M3 печатаются вместе с корпусом**; на платах — монтажные отверстия Ø3.2.
5. **Габариты плат ПРИНЯТЫ** (80×70 / 90×70+радиатор / 85×70); при увеличении в PCB — правим.
6. **Тумблер PWR разрывает +12V** (вход 12 В автомобильное, GND напрямую).
7. **Предрегулятор питания — LTC3780 (buck-boost, заводская плата), выход 13,8 В, 7 А ном./10 А макс.** — ничего не заменяет; перед ним входная защита (предохранитель 5 А + TVS load dump + диод реверса). **Предохранитель F1 с `01_control` переносится на корпус (на плате убрать).**
8. **Длины жгутов — оценочные**, точность не важна.
9. **Радиатор HS 104-30 — 30 мм** (полость 50 мм, запас ок).

### Следующий шаг
- ✅ Черновик `pcb_placement_plan.md` согласован (габариты/размещение/питание/охлаждение). ✅ Правка схемы 1.1 (убрать F1) и BOM этапа 1 (входная защита: предохранитель 5 А + TVS load dump + SS54) — **ВЫПОЛНЕНЫ**. Дальше: вентиляторы 40×40 — в BOM этапа 4; перенос габаритов/отверстий M3 в PCB → `Update PCB from Schematic` → разводка (начинать с `01_control`).

## Финальная сверка перед PCB (сессия 2026-10-31)

- ✅ **ERC:** `01_control` = 0 ошибок (7 warning `footprint_link_issues`, все исключены); `02_power_amp` = 0 (PASS); `03_rx_tx` = 0 (PASS).
- ✅ **Коннекторы/пинаут сверены по фактической связности** (MCP `sch_get_connectivity_graph`): все три платы совпадают с `contracts/control_pa.md`, `control_rxtx.md`, `rxtx_pa.md` один в один (PTT, PWR_LIMIT_EN/SW, I_sense, SWR_sense, VFO, BFO, MODE, MUTE, RX_audio, MIC_LINE, TX_RF, RX_RF, +12V_PA/RXTX, GND).
- ✅ **Ответные части корпусных разъёмов** зафиксированы: передняя панель (OLED→`J_OLED_1`, энкодер→`J_ENC_1`, джойстик/RIT→`J_BTN_1`, гарнитура→`J_HS_1`+`J_SP_1`, LED PWR/TX→`J_LED_1`, LED LIM→`J_LIM_LED_1`, LIMIT/FULL→`J_SW_1`) и задняя крышка (BNC BJ2→`J_ANT_1`, DC-джек→`J_12V_IN_1` через тумблер питания).
- ⚠️ **`00_master` УСТАРЕЛ:** остались метки `I`/`Q` (удалены 2026-10-31), отсутствует `MODE`. Не блокирует (master без PCB), но перед финальным ревью интерфейсов стоит почистить.
- ⚠️ **Механика (этап 4, не блокирует PCB):** отверстие тумблера LIMIT/FULL на передней панели и отверстия BNC/DC на задней крышке ещё не внесены в FreeCAD-модели (`front_panel_elements.md` §3, `back_cover_elements.md` §4).

## Этап 3 — схема 3.1–3.5 ПОСТРОЕНА (сессия 2026-10-31)

### Сделано
- ✅ Схема `03_rx_tx` построена ЦЕЛИКОМ одним `sch_build_circuit` (auto_layout, A2): 113 компонентов, подэтапы 3.1–3.5.
- ✅ ERC: **0 ошибок / 0 warning** (PASS).
- ✅ Разъёмы переименованы в функциональные с индексом `_1`: `J_RF_RX_1`, `J_RF_TX_1`, `J_VFO_1`, `J_BFO_1`, `J_MODE_1`, `J_PTT_MUTE_1`, `J_AUDIO_1`, `J_RXTX_PWR_1`, `J_SP_1`.
- ✅ Исправлено: `Q1.1` (база драйвера) подключён к `Q1_B`; NC-маркеры на LM386 пины 1/7/8 (gain=20, не используются).
- ✅ Footprint'ы исправлены: NE612/LM386 = `Package_SO:SOIC-8_3.9x4.9mm_P1.27mm`; 0603 C = `Capacitor_SMD:C_0603_1608Metric_Pad1.08x0.95mm_HandSolder`.
- ✅ Драйвер TX = **2SC2314** (TO-92L, `Q_NPN_BCE`, класс A/AB линейный; был 2SC2078). Обновлены `stage3_rx_tx.md`, `design_decisions_stage3.md`, `block-diagram.md`, `03_rx_tx/README.md`.

### Ключевые узлы
- **U1** NE612 — двунаправленный смеситель RX/TX (LO=VFO 37 МГц); **U2** NE612 — продукт-детектор SSB (LO=BFO 10 МГц); **U4** NE612 — балансный модулятор TX (AM-несущая — разбалансом U4).
- **X1–X4** — лестничный кварцевый фильтр 10 МГц с переключаемой полосой AM/SSB (1N4148WS-ключи, `MODE`).
- **K1** (IM06GR) T/R-реле + **Q2** (2N7002) драйвер катушки; **Q1** (2SC2314) драйвер TX; **U3** (LM386) УНЧ; **U5** LM7809 / **U6** L78L06 — питание.
- Защита RX: 1N4148WS ×2 антипараллельно + T-pad 3 дБ.

### Следующий шаг
- Ревью схем 1+2+3 в GUI KiCad → перенос на PCB (`Update PCB from Schematic`) → разводка плат. Этап 0 — ОТЛОЖЕН.

## Удаление I/Q-балласта с этапа 1 (сессия 2026-10-31)

### Решение
- SSB формируется **фильтровым методом** (DSB @10 МГц → лестничный кварцевый фильтр → SSB), а не фазовым. Поэтому квадратурная цепочка этапа 1 стала балластом и **удалена** со схемы `01_control` (проверено фактической связностью через MCP: VFO/BFO идут с Si5351 напрямую, 74HC74 питал только I/Q).
- Удалено: **`U6`** (74HC74 делитель-квадратура, 3 юнита), **`J_I_1`/`J_Q_1`** (разъёмы 1↔3), **`R21`/`R22`** (22 Ом). I/Q-буферы `U8` переведены: входы A5/A6 → GND, выходы Y5/Y6 → NC, `/OE2` (U8:19) → GND. `Si5351 CLK0` (U5:6) → NC.
- Освобождён **PB9** (был `IQ_EN`) — под новый сигнал **`MODE`** (0=SSB/1=AM).
- **ERC `01_control`: 0 ошибок** (8 warning: 7 `footprint_link_issues` pre-existing excluded + 1 `isolated_pin_label` на `IQ_EN` — уйдёт при переименовании в `MODE`).

### Следующий шаг
- ✅ **`MODE` ДОБАВЛЕН** (2026-10-31): `IQ_EN`→`MODE`, новый разъём **`J_MODE_1`** (2P), PB9 ↔ J_MODE_1:1, J_MODE_1:2→GND; ERC=0 err. Доки (contracts/BOM/README/pinout/block-diagram/Firmware) очищены от I/Q и FM. **Дальше:** схема этапа 3 целиком (3.1–3.5) одним `sch_build_circuit`.

## Этап 3.1 — BPF 27 МГц (сессия 2026-10-31)

### Сделано
- ✅ Расчёт BPF 27 МГц (SPICE ngspice): двухконтурный ёмкостно-связанный полосовой фильтр (2 полюса Баттерворт), 50 Ом. Номинал на фильтр: 2×0.47 мкГн + 2×51 пФ + 2×18 пФ + 1×2.7 пФ (C0G/NPO 100 В 0805). Центр ≈27.5 МГц, полоса −3 дБ ≈1.4 МГц, подавление 47 МГц (зеркальный) / 54 МГц (2-я гармоника) ≥45 дБ.
- ✅ Расчёт задокументирован: `docs/calculations/bpf_27mhz.md`; BOM §3.1 обновлён (4×L + 10×C0G вместо черновых «6 C0G»).
- ✅ Схема 3.1 ПОСТРОЕНА (MCP `sch_build_circuit`, auto_layout): RX-входной (J_RF_RX_1 → RX_BPF_OUT) и TX-выходной (TX_BPF_IN → J_RF_TX_1) фильтры, 16 компонентов. SMA footprint = `Connector_Coaxial:SMA_Amphenol_132289_EdgeMount` (как на этапе 2).
- ✅ ERC: **0 ошибок / 2 warning** (`isolated_pin_label` на RX_BPF_OUT и TX_BPF_IN — ожидаемо: интерфейсы к 3.2/3.4, ещё не разведены). Связность: 9 групп, обе фильтра разведены верно, вся земля на GND.

### Следующий шаг
- **3.2** — смеситель NE612AD (U1) + ПЧ 10 МГц + кварцевый фильтр (RX_BPF_OUT → U1).

## Аудит разъёмов + фиксация корпусных решений (сессия 2026-10-31)

### Сделано
- ✅ Аудит разъёмов всех плат: `01_control` (19), `02_power_amp` (9), `03_rx_tx` (9 + динамик) — **все заложены, пропусков нет**; контракты ↔ схемы сходятся.
- ✅ Динамик: выход УНЧ `03_rx_tx` → разъём **`J_SP_1`** (XH2.54 2P, `JST_XH_B2B-XH-A_1x02_P2.50mm_Vertical`), вместо падов. Обновлены `stage3_rx_tx.md`, `control_rxtx.md`, `inter-module-pinout.md`, `README.md`.
- ✅ DC-джек **KLS1-DC-025A-2.0 (DS-046C)** 2.0×5.5 мм — на **задней крышке**, пайкой+проводом к `J_12V_IN_1` (`01_control`). Обновлён `back_cover_elements.md` (таблица).
- ✅ Тумблер питания **KN3(B)-101A-A1** (ON-OFF, SPST) — на **передней панели**, **в разрыв +12V** между DC-джеком и `J_12V_IN_1`; отдельного разъёма не требуется, GND напрямую. Обновлён `front_panel_elements.md`.
- ✅ Не нужны: USB, внешний PTT, тест-пойнты ВЧ/ПЧ, line-out, аксессуарный разъём (S-meter/ALC), доп. клемма заземления (корпус ABS, земля = минус питания + экран BNC BJ2).

### Следующий шаг
- **Готово к этапу 3.1 (BPF 27 МГц)** или ревью схем 1+2 в GUI → PCB.

## Этап 3 — BOM согласован + символ NE612A (сессия 2026-10-31)

### Сделано
- ✅ ПЧ этапа 3: **10,7 → 10 МГц** (кварц 10,7 трудно достать, 10 МГц есть). VFO = **37 МГц** (верхняя), BFO = **10 МГц** (Si5351 с `01_control`; меняется только прошивка/контракт, без изменения железа).
- ✅ Фиксированы компоненты: **NE612AD** (SOP-8) ×3 — смеситель RX + балансный модулятор TX + продукт-детектор SSB; **2SC2078** (TO-220) — драйвер TX; **1N4148WS** ×2 — защита RX; фильтр = **лестничный 4× 10 МГц HC-49SM** (+2 запас на подбор) + C0G.
- ✅ Заказано (весь дефицит этапа 3): NE612AD ×3, 2SC2078, 1N4148WS ×2, кварцы 10 МГц HC-49SM, LM386 (SOP-8), LM7809CT, L78L06ABZ (LDO 6 В), MLF2012DR47KT000 (0.47 мкГн).
- ✅ Символ `trx_custom:NE612A` создан (кастомный, 8 пинов: IN_A/IN_B/GND/OUT_A/OUT_B/OSC_B/OSC_E/VCC) и добавлен в библиотеку `trx_custom`; **проверен через MCP** (`lib_get_symbol_info`).
- ✅ Footprint'ы зафиксированы: NE612AD = `Package_SO:SOIC-8_3.9x4.9mm_P1.27mm`, 2SC2078 = `Package_TO_SOT_THT:TO-220-3_Vertical`, 1N4148WS = `Diode_SMD:D_SOD-323F`, кварц = `Crystal:Crystal_SMD_HC49-SD_HandSoldering`.
- ✅ Доки приведены к 10 МГц: `stage3_rx_tx.md`, `control_rxtx.md`, `inter-module-pinout.md`, `block-diagram.md`, `README.md`.
- ✅ `J_RF_RX` → `J_RF_RX_1` в `control_rxtx.md` (индекс обязателен).
- ✅ Commits: `8d2f2f4` (bom: ПЧ 10 МГц), `b622d7e` (hw: NE612A + `trx_custom`).

### Осталось (не блокирует 3.1)
- C0G/NPO конденсаторы BPF — номиналы по расчёту 3.1 (часть есть в STOCK: 120 пФ/220 пФ со 2-го этапа); разрядник (опц.).
- Номиналы BPF 27 МГц (3.1), связующих конденсаторов фильтра (3.2), фазовращателей I/Q (3.4) — расчёт при проектировании.

### Следующий шаг
- **BOM согласован ✅** → схемотехника 3.1–3.5.

## Off-board wiring cleanup — 1↔3 + гарнитура (сессия 2026-10-30)

### Сделано
- ✅ Интерфейс 1↔3 разбит на 6 разъёмов: `J_VFO_1`/`J_BFO_1`/`J_I_1`/`J_Q_1` (2P) + `J_PTT_MUTE_1`/`J_AUDIO_1` (3P) — сигнал+GND витой парой (см. `control_rxtx.md`).
- ✅ Гарнитура объединена в `J_HS_1` (XH2.54 3P): 1=MIC, 2=GND, 3=PTT_IN; экран микрофона → `J_HS_1:2` GND. `J_PTT_IN_1` (тест-пойнт) удалён.
- ✅ ERC `01_control` = 0 err / 7 warn (все `footprint_link_issues`, excluded).
- ✅ Commit `c143fbd` (hw + docs) — запушен.

### Следующий шаг
- ✅ **Спроектировано в доках (2026-10-30):** `J_PA_CTRL_1` 6P→4P (GND/PTT/PWR_LIMIT_EN/PWR_LIMIT_SW) + `J_I_SENSE_1`/`J_SWR_1` (2P, витая пара) на обеих платах; LIMIT/FULL — SPDT `ASW-14-102` (логика) + MOSFET на плате (`VGG` не покидает `02_power_amp`). Обновлены `control_pa.md`, `inter-module-pinout.md`, `stage1_control.md` §1.5, `stage2_power_amp.md`, `design_decisions_stage2.md`.
- ✅ **Внесено в схемы (2026-10-30):** `02_power_amp` (LIMIT/FULL SPDT: `J_SW_1` 3P, Q5 2N7002 + R19 100k, `J_PA_CTRL_1` 4P, `J_I_SENSE_1`/`J_SWR_1` 2P) и `01_control` (`J_PA_CTRL_1` 4P, `J_I_SENSE_1`/`J_SWR_1`). ERC `02_power_amp` = 0 err (PASS); `01_control` = 0 err / 7 warn (`footprint_link_issues`, excluded). Commits `b15a644`, `8bccf85` — запушены.
- **Осталось:** ревью GUI → PCB.

## Этап 2 — построение схемы 2.1–2.3 + сверка BOM/контрактов (сессия 2026-10-30)

### Сделано
- ✅ Схема `02_power_amp` построена целиком (2.1–2.3): push-pull RD16HHF1 (Q1/Q2), балуны T1/T2, RFC L1, ФНЧ 5-го порядка (L2/L3, C6/C7/C8), реле T/R K1 (IM06GR), смещение затворов (R3–R6, RV1), лимитер/тумблер (`J_SW_1`, Q3, D2/D3), датчики I_sense/SWR (U1 LM358, R12–R16, D4/D5, L4), LED (D6/D7, R10/R11).
- ✅ **ERC = 0 нарушений (PASS)**; флаги питания в порядке (`PWR_FLAG` на `+12V_PA`).
- ✅ Разъёмы все с индексом: `J_RF_TX_1`, `J_RF_RX_1`, `J_ANT_1`, `J_PA_CTRL_1`, `J_PA_PWR_1`, `J_SW_1`, `J_LIM_LED_1`.
- ✅ LM358 разведён 3 юнитами; K1:5/6/7 — `no-connect`; R17/R18 — **DNP**.
- ✅ BOM сверен со схемой (простые ref), добавлены отсутствовавшие позиции; 1N4148WS ×3; U1 footprint = `Package_SO:SOIC-8_3.9x4.9mm_P1.27mm`; в таблицу разъёмов добавлен `J_LIM_LED_1`.
- ✅ Контракты `control_pa.md` / `rxtx_pa.md` и расчётные/панельные доки приведены к индексированным именам.

### Правила (зафиксированы в AGENTS.md §7)
- `auto_layout=True` и ручные координаты одновременно не работают; multi-unit символы в `sch_build_circuit` не включать.
- Разъёмы (`J`) — тоже с индексом на конце; голое имя — ошибка.
- NC добавляется **после** сборки через `sch_add_no_connect`.

### Следующий шаг
- Ревью схемы в GUI KiCad (footprint'ы, в т.ч. LM358 SOIC-8).
- Затем PCB этапа 2 (2.1–2.3) + DRC/DFM, после — травление (отдельный шаг).

## Этап 2/4 — радиатор НЕ на задней крышке (сессия 2026-10-30)
По решению пользователя: **радиатора на задней крышке корпуса НЕ будет.**
- ✅ Радиатор УМ **HS 104-30** (30×102×24.5 мм, Rth 3.1 °C/Вт, общий на 2× TO-220) — **заказан** и остаётся теплоотводом УМ.
- ✅ Монтируется на плате `02_power_amp`, а **НЕ на задней крышке** (не «заменит заднюю стенку»). Задняя крышка — финальная заглушка (BNC `J_ANT` + разъём питания `KLS1-DC-025A-2.0`).
- ✅ Обновлены: `docs/back_cover_elements.md`, `Mechanical/{README,requirements}.md`, `Mechanical/params.py` (§11–12), `build_shells.py`, `docs/block-diagram.md`, `KiCad/02_power_amp/README.md`, `docs/bom/stage2_power_amp.md` (§2.4), `docs/calculations/pa_stage2.md` (§5), `docs/calculations/lpf_27mhz.md`.
- ✅ **Драйвер-каскад — НЕ НУЖЕН** (расчёт: 0.5 Вт раскачки достаточно, запас ×1.67 / +2.2 дБ); место/пады зарезервировать.
- ✅ **Термопаста — в наличии.** Разъём питания — **KLS1-DC-025A-2.0 (DS-046C)**.
- ⚠️ Нет этапа макета: вся настройка — на готовой плате после изготовления.

## Этап 1+2 — отладочные светодиоды (сессия 2026-10-30)
По запросу пользователя добавлены **дублирующие** и **вспомогательные** LED для отладки. Решение зафиксировано в **`docs/led_debug_scheme.md`**.

### Сделано
- ✅ **Принцип**: панельный LED → дубль SMD на плате (тот же сигнал, свой резистор); «power-good» LED после LDO. Новых GPIO не потребовалось.
- ✅ **`01_control` (схема, MCP):** добавлены D4–D8 (0805), R36–R42 (0603), разъём `J_LED_1` (XH2.54 3-pin, панельные PWR/TX). ERC: **0 err / 7 warn** (все `footprint_link_issues`, исключены — новые 0).
  - Дублирующие: **D4** (PWR, `+5V`), **D5** (TX, `PTT`).
  - Power-good: **D6** (`+3V3`, U2), **D7** (`+3V3_SI`, U3, до R5), **D8** (`+3V3_DISP`, U9).
  - Панель: `J_LED_1` 1=`PWR_LED`(R37), 2=`TX_LED`(R39), 3=`GND`.
- ✅ **BOM** обновлён: `stage1_control.md` §1.6 (LED 0805 ×5 — **STOCK (в наличии)**; резисторы 0603 — STOCK; `J_LED_1` — STOCK).
- ✅ **`02_power_amp` (не разводится сейчас, схема пустая):** требования в `stage2_power_amp.md` §2.5 и `kicad_task_stage2.md` §4.5 — `D_lim_b`+`R_led_b` (дубль LIM), `D_pa_pwr`+`R_pa_pwr` (power-good `+12V_PA`).
- ✅ `docs/front_panel_elements.md` §2.1/§2.5/§4 — обновлены (LED «ЗАЛОЖЕНА»).

### Ключевые решения
- Панельный **LIM** остаётся на `02_power_amp` (через существующий `J_LIM_LED`), не на `J_LED_1`.
- `D_SI` на `+3V3_SI` **до** R5 (не нагружаем фильтрованный `+3V3_SI_F` для Si5351).
- Токоограничивающие резисторы — **всегда на плате** (даже для панельных LED, аналог `J_LIM_LED`/`R_led`).
- Светодиоды 0805 — **STOCK (в наличии)**.
- Реле T/R **IM06GR** (`K1`): кастомные символ **`trx_custom:IM06GR`** + footprint **`trx_custom:Relay_DPDT_AXICOM_IM06GR_GullWing`** (gull-wing) — созданы пользователем; BOM этапа 2 и `kicad_task_stage2.md` обновлены.

### Дефицит (TO-ORDER)
- **Дефицита по LED нет** — все светодиоды 0805 (этап 1: 5 шт; этап 2: 2 шт) в наличии (STOCK). Резисторы 0603 — склад.

### Следующий шаг
- KiCad-сессия 2.1–2.3 (схемотехника УМ), включая §4.5 (LED).

## Этап 2 — заказ компонентов и символы (2026-10-30)

### Сделано
- ✅ **Символ RD16HHF1** (`trx_custom:RD16HHF1`) — создан пользователем, цоколёвка проверена (**1=G, 2=S, 3=D, 4=FIN(S)**). BOM §2.1 и `kicad_task_stage2.md` §1 обновлены.
- ✅ **RD16HHF1 по даташиту:** Po=16–19 Вт, ηD=55–65 % (VDD=12.5 В, Pin=0.4 Вт, f=30 МГц, Idq=0.5 А), Rth_j-c=2.2 °C/Вт. Покой Idq=0.5 А×2=1 А → 12.5 Вт; на транзистор радиатор ≤ ~15 °C/Вт; выбран HS 104-30 (3.1 °C/Вт) — с запасом.
- ✅ **Заказ ChipDip `Stock/ChipDipCart-Stage_2.csv`** (12 позиций, доставка 30 окт–10 ноя): BN-61-202 ×3, T50-6 ×2, T68-2 ×1, реле IM06GR ×1, шунт PA2512 ×1, 120пФ C0G ×10, 220пФ C0G ×5, подстроечник 3296W ×1, 2N7002 ×2, BAT54 ×2, 1N4148WS ×3, LM358 ×2.
- ✅ **Заказ ДКО электронщик:** RD16HHF1-501 ×2, AO3401 ×1, MMZ2012R601AT000.
- ✅ **Тумблер LIMIT/FULL:** **ASW-14-102** (ON-ON, SPDT 3P, 20A 12VDC) — заказан.
- ✅ **Теплоотвод:** радиатор **HS 104-30** ×1 + изоляторы TO-220 ×2 + втулки 3 мм (под M3) ×2 — заказаны.

### Статус BOM — СОГЛАСОВАН ✅
- **1N4148WS ×3** + **LM358 ×2** — дозаказаны в `Stock/ChipDipCart-Stage_2.csv` (EVVO / Hottech). **TO-ORDER — нет.**
- DEFERRED (не блокирует 2.1–2.3): BNC (корпус, этап 4). Радиатор/изоляторы — заказаны (см. ниже).

### ✅ Тумблер SW1 — тип подтверждён
- **ASW-14-102** — ON-ON, **SPDT 3P** (1 полюс, 3 контакта), 20A 12VDC. Коммутирует только логику `PWR_LIMIT_SW` (COM) между `PLIM_LIM` (LIMIT) и `GND` (FULL). Старый KN3(B)-202-A2 удалён.

### ✅ Ферриты/трансформаторы — символы и footprint'ы зафиксированы (2026-10-30)
- **T1** (входной балун, BN-61-202): `Device:Transformer_1P_1S` (4 выв. P1/P2/S1/S2) + `Transformer_THT:Transformer_Toroid_Horizontal_D14.0mm_Amidon-T50` (4 пада 1–4).
- **T2** (выходной балун, BN-61-202): `Device:Transformer_SP_1S` (5 выв. PR1/PM/PR2/S1/S2 — первичка с отводом) + `Connector_PinHeader_2.54mm:PinHeader_1x05_P2.54mm_Vertical` (5 падов 1–5).
- **T_swr** (токовый КСВ, BN-61-202): `Device:L` (2 выв., вторичная обмотка) + `Inductor_THT:L_Toroid_Vertical_L13.0mm_W6.5mm_P5.60mm` (2 пада).
- **L_rfc** (T68-2): `Device:L` + `Inductor_THT:L_Toroid_Vertical_L17.8mm_W8.1mm_P7.62mm_Bourns_5700`.
- **L_lpf1/2** (T50-6): `Device:L` + `Inductor_THT:L_Toroid_Vertical_L13.0mm_W6.5mm_P5.60mm`.
- **BN-61-202 — бинокуляр** (2 отверстия); стандартного footprint в KiCad нет → generic-пады (тора/пин-хедер), silkscreen декоративный. `Connector:CUI_PD-30S_CircularHoles` **отклонён** (пады пронумерованы 1/2/3/4/SH — пин 5 `S2` не связался бы). Поле `Value` = название сердечника (`BN-61-202`/`T50-6`/`T68-2`).
- **Блокирующих вопросов для 2.1–2.3 больше нет** — все символы/footprint'ы зафиксированы; можно начинать KiCad-сессию.

### ✅ J_SW (тумблер на панели) + теплоотвод (2026-10-30)
- **SW1 монтируется на панель (корпус)**; на плате `02_power_amp` — разъём **`J_SW_1`** (XH2.54 3-pin vertical). Пинаут: 1=`PWR_LIMIT_SW`, 2=`PLIM_LIM`, 3=`GND` (логика LIMIT/FULL, тумблер ASW-14-102). Зафиксировано в BOM §2.3, контракте `control_pa.md`, `kicad_task_stage2.md` §4.2.
- **Теплоотвод закрыт:** радиатор **HS 104-30** (30×102×24.5 мм, Rth 3.1 °C/Вт) ×1 (общий на 2× TO-220), изоляторы TO-220 ×2, втулки изолирующие 3 мм (под винт M3) ×2 — **заказаны**. Решение: изолированный монтаж TO-220 (изолятор + втулка + термопаста; термопаста — в наличии). Tj ≈ 96–98 °C, запас до 150 °C ~52–54 °C — с запасом. Радиатор на плате `02_power_amp`, НЕ на задней крышке корпуса.
- **Открытых вопросов для старта 2.1–2.3 больше нет.**

### ✅ BNC BJ2 + расчёт витков + правило «считать инструментами» (2026-10-30)
- **J_ANT = BNC BJ2** (панельная розетка, задняя крышка, Ø9.5 мм) — модель зафиксирована в BOM, контракте `rxtx_pa.md`, `back_cover_elements.md`.
- **Правило зафиксировано:** расчёты — только инструментами (`calculate`/`sqrt`), в уме нельзя; перед расчётом витков — определить тип намоточной проволоки. Внесено в `AGENTS.md` (Общие правила) и `.continue/rules/calculations.md`.
- **Тип провода (ПЭВ-2, 2 бухты) + витки (посчитано инструментами):** L_lpf (T50-6, AL=4.0) = **10 витков Ø0.5 мм** (√(360/4.0)=9.49); L_rfc (T68-2, AL=5.7) = **26–32 витка Ø0.5 мм**, номинал **30** (√(5000/5.7)=29.62); T1/T2 (BN-61-202) = **3–4 витка бифиляра 2×Ø0.3 мм**; T_swr = первичка 1 проход + вторичка **20–30 витков Ø0.3 мм**. Итого **2 диаметра**: Ø0.5 (iron powder) + Ø0.3 (бинокуляр). Укладка проверена (T50 24.19 мм / T68 29.53 мм; 30×Ø0.5=15.0 мм — влезает). Расход ≈ 1.9 м Ø0.5 + ~1.5 м Ø0.3. Финальная настройка — на готовой плате.

## Этап 2 — подготовка BOM/контрактов/расчётов (сессия 2026-10-29)
Подготовлена база для схемотехники УМ (`02_power_amp`). Контракты `control_pa.md` и `rxtx_pa.md` — зафиксированы; по решению пользователя уточнён `rxtx_pa.md` (`J_ANT` → **BNC**, панельный, задняя крышка).

### Сделано
- ✅ **BOM `docs/bom/stage2_power_amp.md`** — переписан из черновика: состав по подэтапам 2.1–2.4 + разъёмы, номиналы, footprint'ы/символы, статусы (STOCK/ORDERED/TO-ORDER), альтернативы, чек-лист приёмки.
- ✅ **Расчёты:** `docs/calculations/lpf_27mhz.md` (ФНЧ Чебышёв 0.1 дБ, fc=30 МГц: **C–L–C–L–C = 120 пФ–360 нГн–220 пФ–360 нГн–120 пФ**, C0G 100 В, T50-6) и `docs/calculations/pa_stage2.md` (push-pull RD16HHF1, трансформаторы BN-61-202, смещение/лимитер, I_sense/SWR_sense, теплоотвод).
- ✅ **ТЗ для KiCad-сессии `docs/kicad_task_stage2.md`** — самодостаточный промт (кастомные символы, топология 2.1–2.3, DoD).
- ✅ `docs/calculations/README.md` обновлён.

### Ключевые проектные решения (этап 2)
- **УМ:** 2× **RD16HHF1** (push-pull, класс AB), ~12–15 Вт на 50 Ом при раскачке ~0.5 Вт; активный драйвер — опционально (место зарезервировать).
- **Трансформаторы:** входной/выходной балун — бифиляр на **BN-61-202**; RFC стока — T68-2 (4–6 мкГн).
- **ФНЧ:** 5-й порядок Чебышёв 0.1 дБ, fc=30 МГц; конденсаторы **C0G 100 В (не X7R!)**, индуктивности T50-6.
- **Ограничитель AM (2.3, блокирующий):** тумблер **DPDT** LIMIT/FULL: полюс A — смещение (RV1=4 Вт vs полный Vgg), полюс B — `PWR_LIMIT_SW` (делитель 27к/10к от +12 В → 3.3 В). `PWR_LIMIT_EN` — ключ 2N7002 («ИЛИ» с тумблером). LED — горит при LIMIT.
- **Смещение:** Vgg ≈ 2–2.5 В делителем от `+12V_PA`, опц. NTC/диод для термокомпенсации.
- **Датчики:** I_sense — шунт 0.05 Ом 1%/2 Вт (Yageo PA2512FKE7W0R05E) + LM358 (single 12 В, G≈22, 0–3.3 В); SWR_sense — мост Стоктона (BN-61-202) + BAT54.
- **T/R:** реле **TE IM06GR (2-1462037-3)** — SMD gull-wing, 12 В/140 мВт, DPDT 2А (K1), ключ Q_ptt (2N7002/MMBT3904) + 1N4148WS; COM→J_ANT, NO→ФНЧ(TX), NC→RX_RF; антенна J_ANT = BNC (задняя крышка).
- **Питание:** `+12V_PA` напрямую через LC (без стабилизатора), электролит 470 мкФ/25 В + керамика.

### Сводный дефицит (TO-ORDER)
RD16HHF1-501 ×2 — **ЗАКАЗАН (ДКО электронщик)**; **плата (TO-ORDER):** сердечники BN-61-202 ×3, T68-2 ×1, T50-6 ×2; конденсаторы C0G 100 В 0805 (120 пФ×2 + 220 пФ×1), подстроечник Bourns 3296W-1-103LF (10к), реле **TE IM06GR (2-1462037-3)**, шунт 0.05 Ом 1%/2 Вт (Yageo PA2512FKE7W0R05E), радиатор+изоляторы TO-220 (заказ после готовности PCB, 2.4), 2N7002 ×2, BAT54 ×2, 1N4148WS, LM358 (2-я). **Корпус (DEFERRED, не в этой сессии):** тумблер LIMIT/FULL, BNC (J_ANT), светодиод LIMIT (на панель).

> ⚠️ **Корзина ChipDip (`Stock/ChipDipCart-Stage_1.csv`) — этап 1** (для этапа 2 в ней ничего нет).
> ✅ **Заказ «ДКО электронщик»:** **RD16HHF1-501 ×2** (этап 2) + **AO3401 ×1** (этап 1). Остальные позиции `02_power_amp` — TO-ORDER (заказ отдельной корзиной).

### Уточнения после ревью (пользователь)
- **Тумблер LIMIT/FULL → на корпус (передняя панель)** — внесён в `docs/front_panel_elements.md` (§2.4; раскладка требует пересчёта 6→7 элементов). На плате `02_power_amp` — только разъём XH2.54. **Заказ отложен до этапа 4 (сборка в корпус).**
- **Антенный разъём → BNC на заднюю крышку** — создан `docs/back_cover_elements.md`; `Mechanical/params.py` → `ANT_CONN_TYPE="BNC"`, `ANT_HOLE_D=9.5`. Туда же — **разъём внешнего питания** (тип НЕ определён, факт наличия зафиксирован).
- **Драйвер-каскад — опция, сразу не делаем** (место зарезервировать).
- **RD16HHF1 — корпус TO-220, footprint штатный (`TO-220-3`), НО цоколёвка НЕСТАНДАРТНАЯ: 1=G, 2=S, 3=D, 4=FIN(S)** (вывод 2=Source, вывод 3=Drain, фланец=Source) — учесть в символе. Риск — доступность (EOL). Альтернативы: RD15HVF1 / RD06HVF1 / 2SC2078.
- **AL сердечников — комментарий добавлен** (`docs/calculations/pa_stage2.md` §2.6): формула `N=√(L/AL)`, типовые AL, вариант воздушной катушки для ФНЧ, готовые тора Amidon/Fair-Rite.
- **SMD-корпуса:** 1N4148 → **1N4148WS (SOD-323)**, шунт → **2512 SMD**, LED → **0805 SMD**.
- **Аудит STOCK/TO-ORDER:** исправлены ошибочные STOCK (1N4148, LED, LM358-2-я) → TO-ORDER.
- **Реле T/R:** выбран **TE IM06GR (2-1462037-3)** — SMD gull-wing, 12 В/140 мВт, DPDT 2А, RF-пригодно (37 дБ @100 МГц). ✅ **РЕШЕНО (2026-10-30):** созданы кастомные символ `trx_custom:IM06GR` + footprint `trx_custom:Relay_DPDT_AXICOM_IM06GR_GullWing` (gull-wing).
- **Светодиод LIMIT (D_lim) → на переднюю панель** (не на плату); на плате `02_power_amp` — только разъём `J_LIM_LED` (XH2.54 2-pin). C_bulk_pa → 470 мкФ/35 В SMD 10×10.5 (в наличии, STOCK).

### Следующий шаг
1. **Перепроверка BOM пользователем** (STOCK/TO-ORDER) → зафиксировать базовый BOM.
2. **Обсудить каждую TO-ORDER-деталь отдельно** (RD16HHF1, сердечники, реле, тумблер, BNC, шунт, разъём питания и т.д.).
3. Заказ TO-ORDER (срок 3–4 дня).
4. **KiCad-сессия `docs/kicad_task_stage2.md`** — схемотехника 2.1–2.3 (MCP).
5. Совместно **2.3 + 1.5**; затем — травление платы этапа 1.

## BOM сверен с реальным заказом (сессия BOM этапа 1)
BOM `docs/bom/stage1_control.md` перезаписан под фактическое наличие и заказ ChipDip. Введены статусы **STOCK / ORDERED / TO-ORDER** по каждой позиции.

**Заказано ChipDip (заказ НЕ ОТПРАВЛЕН, редактируется):** U4 STM32F411 (29 окт), U5 Si5351 (26 окт), U6 74HC74D (26 окт), **U8 74AC541SC** (29 окт), **U1 LM2596S-5.0 TO-263-5** (29 окт), **U2+U3+U9 RT9193-33GB ×3** (29 окт), D1 SMBJ18A (29 окт), Y1 8 МГц (26 окт), Y2 TG2520SMN (29 окт), **C3 EEEFK1C471P** (26 окт), **L1 SPQ105-330M** (29 окт), **F1 держатель BC507-040 + 522.1300 T3A 5×20 ×2**, **L2/L3 MMZ2012R601AT000 ×2**, **WJ127R-5.0-02P ×2**.
**Заказано Ozon:** C1 1000 мкФ/25 В SMD 12.5×13, энкодер HW-040 (KY-040).
**TO-ORDER:** **ST7789 2.0" 240×320 SPI** (основной дисплей), кнопки/джойстик.
**В наличии (STOCK):** LM358DR (U7), SS34 ×2, OLED 0.96" SSD1306 (резервный), резисторы/конденсаторы 0603, XH2.54, PinHeader 2.54, SMA s-p215, провода 26 AWG.

## UX-решения (сессия BOM этапа 1)
- **Дисплей: переход на SPI.** Основной — **ST7789 2.0" 240×320 SPI** (TO-ORDER). Причины: SPI+DMA → нет фризов отрисовки; не блокирует Si5351 (I²C на отдельной шине); 2-колоночное меню + S-метр влезают. OLED 0.96" остаётся резервным/отладочным.
- **Питание дисплея:** отдельный LDO **U9 = RT9193-33GB** (третий), т.к. подсветка ST7789 150–200 мА не должна грузить U2.
- **`J_OLED_1` → 8-pin** (VCC/GND/SCK/MOSI/CS/DC/RST/BLK).
- **Интерфейс 1↔3 (2026-10-30):** единый `J_RXTX_SIG_1` (10-pin) **заменён на 6 разъёмов** — `J_VFO_1`/`J_BFO_1`/`J_I_1`/`J_Q_1` (2P, сигнал+GND витой парой), `J_PTT_MUTE_1` (3P), `J_AUDIO_1` (3P). См. `contracts/control_rxtx.md`.
- **Разъёмы:** заказан **набор XH2.54 угловых 2P–12P** — покрывает J_OLED_1 8P, J_BTN_1 8P, J_PA_CTRL_1 6P / J_ENC_1 5P, VFO/BFO/I/Q (2P), PTT/MUTE и аудио (3P) + запас на этапы 2/3.
- **`J_ENC_1` → 5-pin, кнопка энкодера ФУНКЦИОНАЛЬНА:** фиксация частоты / выбор канала (короткое), режим частота↔канал (длинное).
- **`J_BTN_1` → 8-pin:** **джойстик 5-поз.** (UP/DOWN/LEFT/RIGHT/PUSH) **+ отдельная кнопка RIT** + GND. Все кнопки — тактильные «без фиксации», состояние в прошивке (короткое/двойное/длинное нажатие). Джойстик — модуль с платой **20×25 мм**, 6 выводов (5 кнопок + COM), крепление винтами к стойкам, штырёк в отверстие панели Ø8 мм + резиновый колпачок.
- **RC-фильтры UI — обязательны:** R_pu 10к + C 100нФ на каждую линию кнопок (J_BTN_1 ×6, J_ENC_1 ×3), R 22 Ом последовательно в SPI-линии OLED ×4. Провода до корпуса = антенна, рядом ВЧ 37 МГц.
**Дозаказ (TO-ORDER):** **ДЕФИЦИТА НЕТ — BOM этапа 1 закрыт.**
**Ozon:** C1 1000 мкФ/25 В SMD, энкодер HW-040, **ST7789 2.0" 240×320 SPI**, **джойстик 5-поз. 20×25 мм**.
**ChipDip:** 15 позиций + RT9193 ×3 (U2, U3, U9).
**Буферы VFO/BFO/IQ решены:** **74AC541SC** (SOIC-20, буфер ×8, OE) — в заказе (ORDERED); альтернатива 74AC244 (SO-20).

**⚠️ ЗАДАНИЕ KICAD-СЕССИИ (F1–F7) — привести проект к реальному BOM до начала 1.4.** Правки в KiCad выполняет отдельная сессия с MCP; BOM — это ТЗ для неё.
- F1: U1 LM2596S-5.0 → **TO-263-5** (`TO-263-5_TabPin3`), сейчас TO-263-3.
- F2: U2/U3 → **RT9193-33GB SOT-23-5**, сейчас AMS1117-3.3 SOT-223.
- F3: U7 → **LM358DR SOIC-8 `SOIC-8_3.9x4.9mm_P1.27mm_HandSolder`** (символ LM358 + footprint).
- F4: U6 74HC74D,653 SO-14 — проверить цоколёвку.
- F5: J_OLED_1/J_ENC_1/J_BTN_1/J_PA_CTRL_1/J_RXTX_SIG_1 → **XH2.54 угловые папы**. **F5b: J_SWD_1/J_UART_1 — ОСТАВИТЬ PinHeader 2.54** (в наличии, удобно для отладки).
- F6: J_PA_PWR_1/J_RXTX_PWR_1 → **WJ127R-5.0-02P**.
- F7: добавить **U8 = 74AC541SC** (буфер ×8, **SOIC-20**, OE) — буферы VFO/BFO/IQ (**ORDERED**; альтернатива 74AC244 SO-20).
- F8: C1/C3 — **SMD-электролиты** (не THT!): `CP_Elec_12.5x13` (C1) и `CP_Elec_8x10.2` (C3 EEEFK1C471P).
- F9: L2/L3 — **феррит MMZ2012R601AT000** (0805, 600 Ом@100 МГц), `Inductor_SMD:L_0805_2012Metric`. L1 = SPQ105-330M (10.4×10.2 мм SMD).
- F11: **U9 = RT9193-33GB** — отдельный LDO 3.3 В для дисплея ST7789 (подсветка 150–200 мА), + C22 1 мкФ / C23 10 мкФ.
- F12: **U10 = ST7789 2.0" 240×320 SPI** — основной дисплей; `J_OLED_1` → **8-pin** (VCC/GND/SCK/MOSI/CS/DC/RST/BLK).
- F13: **RC-фильтры UI (ОБЯЗАТЕЛЬНО)** — R_pu 10к ×6 + C 100нФ ×6 (J_BTN_1), R_pu 10к ×3 + C 100нФ ×3 (J_ENC_1), R 22 Ом ×4 (SPI OLED). Все 0603 со склада. τ = 1 мс.
- Доп.: в схеме 1.2 VCAP1 — **4.7 мкФ** (рекомендовано для одного VCAP; VCAP2 отсутствует; альтернатива 2.2 мкФ + 100 нФ) + VDDA 100 нФ+1 мкФ; старый единый C17 неверен.
- Прочее: XH2.54 папа/мама — комплектом; сигнальные провода — **26 AWG** (AWG-16 избыточен, только для силовых).

> Этап 0 в KiCad — концептуальная блок-схема. Источник правды по интерфейсам — `docs/contracts/` и `docs/inter-module-pinout.md`, а НЕ ERC мастера.

## Принятые решения (кратко)
- 4 этапа + этап 0 (мастер-лист); подэтапы внутри.
- Питание: общая защита, локальная стабилизация. **Топология — звезда**: входной узел защиты физически на `01_control`, отдельные линии на PA и rxtx (PA даёт импульсные броски — общая шина недопустима).
- Имена питания межблочные: `+12V_PA` (control→PA), `+12V_RXTX` (control→rxtx) — разные цепи.
- Ограничитель AM: физический тумблер LIMIT/FULL на УМ, обратная связь PWR_LIMIT_SW.
- RIT: программный, энкодер 10/100 Гц, кнопка, OLED, EEPROM.
- Squelch: программный на `01_control`, сигнал RX_audio с `03_rx_tx`.
- T/R: реле на `02_power_amp`, защита RX диодами + аттенюатор на `03_rx_tx`.
- ВЧ-связь PA↔rxtx — **напрямую, минуя control**: `TX_RF` (rxtx→PA), `RX_RF` (PA→rxtx). Отдельный контракт `rxtx_pa.md`.
- Земля: на Этапе 0 один `GND`; на реальных платах раздельная (GND_DIG/GND_ANA/GND_PWR), соединение в одной точке.
- Гарнитура — Baofeng/Kenwood 2-pin (K1). Разъёмы на корпусе, на платах — пады под проводной монтаж. MIC/PTT → `01_control`, SP+/GND → `03_rx_tx`. `MIC_LINE` и `MUTE` — в контракте `control_rxtx.md`.
- FM: опционально, место заложено, монтаж после AM/SSB.
- BOM: обязателен до разводки, срок доставки 3–4 дня.
- **BOM этапа (новое правило):** перед началом каждого этапа — подготовить и согласовать базовый BOM, убедиться в наличии/доступности к заказу, зафиксировать корпуса (особенно заказываемых), проверить наличие footprint'ов/символов.
- **Изготовление платы (новое правило):** отдельный шаг каждого этапа; допустимо только после готового PCB + устранения недочётов + прохождения проверок; шаг не блокирует начало следующего этапа.
- **ЭЛЕМЕНТЫ УПРАВЛЕНИЯ (энкодер KY-040, кнопки, OLED) монтируются НА КОРПУС, подключаются проводами. На платах — только разъёмы/пады под провода.**

## Правила работы (зафиксированы в Rules)
- Не редактировать один файл параллельно — по одной операции, перечитывать перед следующей.
- Не запускать параллельно несколько KiCad MCP запросов — по одному, ждать результат.
- Если не удаётся отредактировать текстовый файл за 3 попытки — удалить и пересоздать целиком (create_new_file).
- **Добавление кастомных компонентов/footprint'ов (обновлено 2026-10-29):** после генерации через MCP **ничего не переносить и не копировать** — пользователь сам добавляет компонент в нужное место; после его подтверждения проверить доступность (`sch_get_symbols` для символа, `pcb_get_footprints`/`lib_search_footprints` для footprint).

## Статус Этапа 0 — ОТЛОЖЕН (вариант А)
**Сделано и оставлено:**
- ✅ Контракты: `control_pa.md`, `control_rxtx.md` (+MIC_LINE/MUTE, раздел «Гарнитура»), `rxtx_pa.md`.
- ✅ `docs/inter-module-pinout.md` — новые имена + раздел «Корпусные соединения».
- ✅ Все 4 проекта выровнены (`.kicad_pro`+`.kicad_sch`+`.kicad_pcb` в корне; у `00_master` — без PCB).
- ✅ Мастер: 3 листа, пины импортированы (36, вкл. MIC_LINE/MUTE).

**Отложено:** доведение `00_master` до чистого ERC.
- Причина: `sch_wire_sheet_pins` породил 72 ошибки `label_dangling`; ручные правки меток/проводов и вариант global labels — не устраняют.
- Решение: мастер остаётся концептуальной блок-схемой. Чистый ERC НЕ требуется.
- Если когда-нибудь вернёмся: соединять пины вручную проводами по одному сигналу.

"## Сессия KiCad F1–F13 (этап 1) — фиксация состояния (проект заморожен)

**Важно:** это фиксация факта. Проверки/разводку в этой сессии НЕ продолжаем; проект остановлен на текущем состоянии до отдельного решения.

### Сделано
- **F8**: C1 → `CP_Elec_10x12.5`, C3 → `CP_Elec_8x10.5` (SMD-электролиты).
- **F2 (символы)**: U2, U3 заменены на **RT9193-33** (в схеме `trx_custom:RT9193-33`, footprint `SOT-23-5`).
- **U2/U3 разводка** — выполнена вручную в GUI (power-символы на пины; **C20 = 10 нФ на BP U2**, **C21 = 10 нФ на BP U3**).
- Кастомный символ: `KiCad/libs/symbols/RT9193-33.kicad_sym`; библиотека `trx_custom` в `sym-lib-table` проекта. **Папка `libs` возвращена в `KiCad/libs` (корень).**

### Выявленные дефекты — ЧАСТИЧНО ИСПРАВЛЕНЫ (сессия чистки питания)
1. ✅ **КЗ +5V↔GND на L2** — устранено (удалены `#PWR40021 GND` и `#PWR38286 PWR_FLAG`).
2. ✅ **Топология V3V3_SI** — метка выхода U3 переименована `V3V3_SI_F` → `+3V3_SI`.
3. ✅ **КЗ VIN_PROT(12В)↔GND** — устранено (удалён провод `e0530440`).
4. ✅ Удалены ошибочные GND на шине +3V3 (`#PWR43497`, `#PWR47002`).
5. ✅ **КЗ +3V3↔GND устранено** (сессия 3): удалены мостовые провода `08dcc58a`, `14f965ea`, `6a784c95` (по одному `+3V3`→`GND` в развязке MCU) и лишний junction `3b23953a`. Группа `+3V3, GND` распалась на отдельные `+3V3` (U2:5) и `GND` (U2:2/U3:2). Коммит `bda50b5`.
   ⚠️ **Секция питания требует системной переразводки**: выявлено, что провода входного узла (F1/D1/D2/C1), выхода U1 (L1/D3) и развязки C5/C6/C7/C8/L2 частично **не соединяются с пинами** (концы проводов смещены на 1.27 мм от пинов; пины U1 не входят ни в одну именованную цепь). Осталось: вход 12В (PWR_FLAG, C1), FB→+5V, +5V→L2→U3 IN, +3V3→C5/C6→U4 VDD, +3V3_SI→C7/C8→U5 VDD, BOOT0/VCAP1/VDDA. См. **`docs/next_session_prompt.md`**.
6. ✅ **Конфликт имён C21 РАЗРЕШЁН** (сессия MCP-продолжение): `C21→C24` (10нФ BP U3),
   `C20(BP U2)→C23` (10нФ); `C20` = VDDA 100нФ. Освободившийся `C21` — под F10 (1мкФ).
7. ✅ **Секция U2/U3 переразведена** (сессия 4): `+5V→L2→U3 IN` (новая цепь `+5V_SI`), `C5/C6→+3V3`, `C7→+3V3_SI` (выходные конденсаторы LDO). Устранён скрытый КЗ +3V3↔GND — лишний power-символ `#PWR42306 +3V3` стоял на C5:2. C20/C21 (BP) и C8 уже были корректны, не трогались.
   ✅ **L3 (феррит +5V→U2 IN) + PWR_FLAG на `U2_IN`** — СДЕЛАНО (сессия MCP-продолжение): L3 добавлен в GUI, PWR_FLAG добавлен MCP — ERC `power_pin_not_driven` U2:1 снят. Финальный ERC: 43 error + 4 warning (всё отложенное до 1.5).
   ⚠️ **Уточнения (важно для следующих сессий):** (1) шаг выводов 2-выводных пассивов (`Device:C`/`C_Polarized`/`FerriteBead`) = **±3.81 мм** (пин1 сверху = y−3.81), а не ±2.54. (2) MCP видит только библиотеку `trx_custom` — `sch_add_power_symbol`/`sch_add_pin_labels` не работают; для +5V/+3V3/GND используются **глобальные метки** (электрически эквивалентно). Следствие: `U3 IN` даёт `power_pin_not_driven` — нужен `PWR_FLAG` на `+5V_SI` (добавить в GUI или после восстановления power-библиотеки MCP).
8. ✅ **Секция U1 (вход/выход 12В→5В) переразведена** (сессия 5): исправлены неверные метки/символы — D1(TVS) левый пин `VIN_PROT`→`VIN_F` (TVS теперь на VIN_F), C1(−) `VIN_PROT`→`GND`, C3(−) `+5V`→`GND`, C4(−) отсоединён от U4 VDD и заземлён. Удалены: плавающий `#PWR23689 PWR_FLAG` + локальная метка `VIN_F`@(59.69,64.77), `#PWR11374 +5V`, `#PWR19962 +3V3`, провод `0a6b338c` (C4↔VDD). Итоговая топология: `+12V_IN→F1→VIN_F→D1(TVS→GND)+D2(анод)`, `D2(катод)→VIN_PROT→C1(+)+U1 VIN`, `U1 OUT→SW_OUT→L1→+5V`, `D3(катод→SW_OUT, анод→GND)`, `+5V→C3(+)/C4(+)→GND`, `U1 FB→+5V`, `U1 ON/OFF→GND`, `U1 GND→GND`. ERC: 51 err / 5 warn (убран warning `same_local_global_label` VIN_F). ⚠️ Дальше (сессия 5, часть C): **U4 VDD(36)→+3V3 сделано** (провод+глобальная метка на пине 36, ERC 49 err / 5 warn). ⚠️ Осталось: BOOT0→R1 (R1 сейчас оба пина на GND, «оторван»), VCAP1→4.7µF, VDDA→100nF+1µF; PWR_FLAG на VIN_PROT/GND/+5V/+3V3/+5V_SI — в GUI (MCP не добавляет power-символы).

### Не сделано (из задания до 1.4)
- ✅ C5/C6/C7/C8/C17/VCAP/VDDA — выровнены сессией «чистка питания» (см. `docs/power_cleanup_plan.md`).
- L3 (феррит +5V→U2 IN) — отсутствует (MCP не резолвит пины `trx_custom`; делать в GUI).
- R_si 10 Ом + C21 1мкФ в питание Si5351 (F10) + разделение `+3V3_SI_F` — отсутствует (GUI).
- U8 = 74AC541SC — отсутствует (F7).
- U6 74HC74 (unit A/B/PWR) — цоколёвка не проверена.
- U1 LM2596S-5 (5 пинов, FB/ON-OFF) — не проверено.
- Адекватность C4/C5/C7/C17 — не проверена.

### Инфраструктура MCP
- MCP-сервер перезапускался пользователем (смена конфига).
- Симптом: `PERMISSION_DENIED: Errno 13 'libs/symbols'` и `Request timed out` на `lib_search_symbols`/`get_pin_positions` — **транслируется из KiCad** (не баг MCP). После возврата `libs` в `KiCad/libs` доступ не перепроверялся (по решению — не проверяем).
- ERC на текущей схеме: ~87 нарушений (прогон ранее); по категориям (КЗ/висящие/конфликты) **не разбирались**.

### Следующий шаг
Питание **полностью готово** (сессия F10): U1/U2/U3 переразведены, L3 добавлен,
PWR_FLAG на `U2_IN` и `+3V3_SI_F` добавлены, VCAP1/VDDA сделаны, refdes BP зафиксированы (C23/C24).
**F10 выполнен**: R5(=R_si) 10Ω + C21(1мкФ) → цепочка `+3V3_SI → R5 → +3V3_SI_F`
(C18/C19/C21/R3/R4/U5:1/U5:7 на фильтрованной стороне; C7 остаётся на `+3V3_SI`).
ERC по питанию чист (43 error + 4 warning — только отложенное до 1.5). Осталась мелочь:
сдвинуть C5 вниз (~2.54 мм) для снятия наложения C5/L3 (~1 мм²).
Затем F3–F13 (U7/U8/U9/U10, разъёмы, RC-фильтры) и 15 интерфейсных меток. Разводка платы
запрещена до чистого ERC по питанию.

**📄 Промт новой KiCad-сессии: [`docs/session_prompt_F3_F13.md`](session_prompt_F3_F13.md)** — самодостаточный, вставлять целиком в **новый диалог** (контекст сброшен). Артефакты синхронизированы: `docs/kicad_task_stage1.md` (F9/F10/F11, секция 3) и `docs/bom/stage1_control.md` (refdes, ферриты, VCAP/VDDA).

**Выполнено (питание):** F1 (U1 TO-263-5), F2 (U2/U3 RT9193), F8 (электролиты SMD), F9 (L2/L3 = **MMZ2012R601AT000**), F10 (R5 + C21).

**Осталось:** F3 (U7 LM358DR), F4 (проверка U6 74HC74), F5 (разъёмы XH2.54; F5b — J_SWD_1/J_UART_1 оставить), F6 (J_PA_PWR_1/J_RXTX_PWR_1 — клеммники 5.0 мм), F7 (U8 74AC541SC), F11 (U9 RT9193 + C26/C27/C28), F12 (J_OLED_1 цепи), F13 (RC-фильтры UI).

**J_PA_CTRL_1 — РЕШЕНО: 6-pin XH2.54** (PTT/I_sense/SWR_sense/PWR_LIMIT_EN/PWR_LIMIT_SW/GND, по одному на пин). VCAP — **C22 = 4.7 мкФ** (рекомендовано для одного VCAP; альтернатива 2.2 мкФ + 100 нФ). Феррит L2/L3 = **MMZ2012R601AT000 — заказан**.

## Открытые вопросы"
- Термостабильность SSB (кварц Si5351 ±20 ppm) — отдельная сессия.
- Архитектура прошивки (UI, меню, real-time, watchdogs) — отдельная сессия.

## Следующий шаг — Этап 1 (`01_control`): 1.5 + 2.3 (совместно)
BOM `stage1_control.md` сверен с реальным заказом. Схемотехника 1.1–1.4 готова; **KiCad-сессия F1–F13 — ВЫПОЛНЕНА**; **1.4 — ГОТОВА**; **1.5 (control-часть) — ГОТОВА** (GPIO-привязка + питание-звезда R29/R30, ERC 0/0 (чисто)).
**📄 Подробное ТЗ для KiCad-сессии: [`docs/kicad_task_stage1.md`](kicad_task_stage1.md)** (F1–F13) и [`docs/session_prompt_F3_F13.md`](session_prompt_F3_F13.md) (F3–F13).
**Порядок:**
1. **KiCad-сессия F1–F13 — ГОТОВО** (см. «Прогресс Этапа 1»).
2. **1.4 (UI / RIT / squelch / MIC-предусилитель)** — ГОТОВО (сессия `session_prompt_1.4.md`).
3. **1.5 (control-часть: GPIO-привязка, интерфейсные метки, буферы VFO/BFO/IQ, питание-звезда)** — ГОТОВО (сессия `session_prompt_1.5.md`).
4. **2.3 (УМ: лимитер/тумблер LIMIT/FULL, смещение RD16HHF1)** — следующий блокирующий шаг перед травлением этапа 1.

### Решения (Этап 1 — анализ)
- MCU: корпус **UFQFPN-48 7x7** (STM32F411CEUx + QFN-48-1EP_7x7mm_P0.5mm_EP5.6x5.6mm).
- TVS: **SMBJ18A** (SMB, D_SMB_Handsoldering).
- Диод входа: SS34 (SMA, D_SMA_Handsoldering).
- Пассивные: **0603** (номиналы из Stock/resistance_0603.csv / Stock/capacitors_ 0603.csv).
- Footprint: правило handsoldering (при наличии), иначе обычный SMD/THT.
- BOM `stage1_control.md` разбит по подэтапам 1.1–1.5.

### Прогресс Этапа 1
- **1.1 — СХЕМОТЕХНИКА ГОТОВА** (17 компонентов: F1/D1/D2, DC-DC LM2596 U1+L1+D3, LDO 3.3В U2+C5/C6, LDO +3V3_SI U3+L2+C7/C8, пассив C1/C2/C3/C4). Цепи соединены метками. ERC: реальных ошибок 1.1 нет.
- 15 каркасных интерфейсных меток (PTT…MUTE) оставлены в корне до 1.5 → ERC «красный» по ним (согласовано).
- Footprint'ы: L1=L_12x12mm_H4.5mm, C6=Tantalum CP_EIA-3216-18_Kemet-A_HandSolder.
- **1.2 — СХЕМОТЕХНИКА ГОТОВА** (U4 STM32F411CEU6 QFN-48, Y1 8МГц+C9/C10 20пФ, развязка C11–C17, R2 NRST pull-up 10к, R1 BOOT0 pull-down 10к, J_SWD_1, J_UART_1 1x04). Цепи: +3V3/GND, OSC_IN/OUT, NRST, BOOT0, SWDIO/SWCLK, UART_TX/RX. Лист A4→A3.
- ERC 1.2: реальных ошибок по задействованным пинам нет; «Pin not connected» у неиспользуемых GPIO — ожидаемо.
- **1.3 — СХЕМОТЕХНИКА ГОТОВА**: U5 Si5351A-B-GT (MSOP-10), Y2 TG2520SMN-27.6МГц (TCXO 2520, 4-pin: OUT→REF_CLK→XA, XB→NC, VCC→+3V3_SI_F, C42 100нФ), C18/C19 развязка, R3/R4 I2C pull-up 4.7к; U6 74HC74 (3 юнита) — делитель IQ (CLK←IQ_CLK, D1=/Q2, D2=Q1, CLR/PRE→+3V3). Выходы: CLK0→BFO_RAW, CLK1→VFO_RAW, CLK2→IQ_CLK; I(Q1), Q(Q2). I2C: MCU PB6/PB7 → I2C_SCL/SDA. Буферы VFO/BFO/IQ и подключение VFO_RAW/BFO_RAW — в 1.5.
- ERC 1.3: ошибки по U5/U6/Y2/C18/C19 устранены. Остаются: неиспользуемые GPIO MCU (до 1.5) + изолированные VFO_RAW/BFO_RAW (до буферов 1.5).
- **F3–F13 — ВЫПОЛНЕНЫ** (сессия `session_prompt_F3_F13.md`): U7 LM358 (символ, unit B→GND/NC), U8 74AC541 (буферы `VFO_OUT`/`BFO_OUT`/`I_OUT`/`Q_OUT`, входы A3/A4/A7/A8→GND, `IQ_EN`), U9 RT9193 (`+3V3_DISP`), разъёмы J_OLED_1 8P / J_ENC_1 5P / J_BTN_1 8P / J_PA_CTRL_1 6P / J_RXTX_SIG_1 10P, клеммники J_PA_PWR_1/J_RXTX_PWR_1 5.0 мм, RC-фильтры (R6–R14, C29–C37) и SPI-резисторы (R15–R18).
- ERC F3–F13: **без новых** `pin_to_pin` / `multiple_net_names` / `power_pin_not_driven`. Остаток (73 error + 16 warning) — «отложено до 1.5» (15 интерфейсных меток, 28 свободных GPIO MCU, неиспользуемые пины U8/U7, разъёмы, изолированные `*_OUT`/`SPI_*`/`LCD_*`).
- **1.4 — СХЕМОТЕХНИКА ГОТОВА** (сессия `session_prompt_1.4.md`): MIC-предусилитель U7 LM358 unit A (неинвертирующий, K≈11) с обвязкой R23–R27/C39/C41 (`MIC`→C39→`MIC_BIAS`→IN+, `MIC_FB`→IN−, OUT→`MIC_LINE`); вход `RX_audio` через R28/C40 (RC τ=10 мкс → ADC squelch). Исправлено КЗ `MIC`/`MIC_BIAS`/`MIC_FB` (пересечение стабов `sch_add_pin_labels`). ERC: 68 error + 16 warning, **без новых** `pin_to_pin`/`multiple_net_names`/`power_pin_not_driven`.
- **ST7789 ПРИШЁЛ (сверено, J_OLED_1 переразведён — ГОТОВО):** модуль 8-pin `GND/VDD/SCL/SDA/RES/DC/CS/BL` = SPI 4-wire (`SCL`=SCK, `SDA`=MOSI). `J_OLED_1` разведён под порядок модуля (прямой шлейф 1:1): 1=GND, 2=`+3V3_DISP`, 3=`OLED_SCK`, 4=`OLED_MOSI`, 5=`LCD_RST`, 6=`OLED_DC`, 7=`OLED_CS`, 8=`LCD_BLK`.
- **1.5 (control-часть) — СХЕМОТЕХНИКА ГОТОВА** (сессия `session_prompt_1.5.md`): привязка GPIO (23 сигнала) + питание-звезда **R29/R30 = 0 Ом 1206** (`VIN_PROT`→`+12V_PA` / `VIN_PROT`→`+12V_RXTX`); буферы VFO/BFO/IQ разведены (`VFO_OUT`/`BFO_OUT`/`I_OUT`/`Q_OUT`), NC на неиспользуемые GPIO. ERC: **0 error + 3 warning** (предсуществующие: `lib_symbol_mismatch` U9, 2× микро-стаб U6). Блокер `isolated_pin_label` на `+12V_PA`/`+12V_RXTX` устранён.
  - **GPIO (MCU → сигналы):** PA0=I_sense, PA1=SWR_sense, PA2=RX_audio_F, PA3=LCD_RST, PA4=SPI_CS, PA5=SPI_SCK, PA6=SPI_DC, PA7=SPI_MOSI, PA8=PTT, PA11=PWR_LIMIT_SW; PB0=LCD_BLK, PB1=BTN_RIGHT, PB2=BTN_PUSH, PB5=PTT_IN, PB8=MUTE, PB9=IQ_EN, PB10=PWR_LIMIT_EN, PB12=BTN_RIT, PB13=ENC_CLK, PB14=ENC_DT, PB15=ENC_SW; PC13=BTN_UP, PC14=BTN_DOWN, PC15=BTN_LEFT. (полная таблица — `docs/bom/stage1_control.md` §1.5)
  - **Валидация (read-only) — ИСПРАВЛЕНО** (сессия `session_report_validation.md`): добавлен входной клеммник **J_12V_IN_1** (2P 5.0 мм, `+12V_IN`/GND), феррит **L4** на VDDA (`+3V3`→VDDA, MMZ2012R601AT000; VDDA-сеть = U4:9 + C20 + C25), F1 → держатель **Keystone 3512P** (5×20 THT), C1 размер/footprint исправлены (**10×12.5**, `CP_Elec_10x12.5`), Phoenix MKDS-1,5-2 ≡ WJ127R-5.0-02P (функциональные эквиваленты). ERC: **0 error / 7 warning** (все `footprint_link_issues`, `excluded`).
    - **Y2 → TCXO TG2520SMN (исправлено):** символ `Device:Crystal` (2 pin) заменён на `Oscillator:TG2520SMN-xx.xxxxxxMhz-xxxxNM` (4 pin), footprint Epson 2520 4-pin. Разводка: OUT(3)→`REF_CLK`→U5 XA(2), XB(3)→NC, VCC(4)→`+3V3_SI_F`, GND(2)→GND, NC(1)→NC; добавлена развязка **C42 100 нФ**. ERC: **0 error / 7 warning** (все `footprint_link_issues`, `excluded`).
      - **C43 (bulk входа U3) — добавлен:** на `+5V_SI` не хватало ≥1 мкФ (был только C8=100 нФ; RT9193 рекомендует 1 мкФ на IN). Добавлен **C43 = 1 мкФ** (0603 X7R) параллельно C8, у U3 IN.
        - **J_SWD_1 (SWD 5-pin + NRST) — добавлен NRST:** разъём расширен 4→5 pin, pin 5 = `NRST` (connect-under-reset + аппаратный сброс со ST-Link). Footprint → `PinHeader_1x05_P2.54mm_Vertical`, символ `Conn_01x05`. Раскладка: 1=SWDIO, 2=SWDCLK, 3=GND, 4=+3V3, 5=NRST.

### Уточнения компонентов (по решению пользователя)
- TVS D1: **SMBJ18A** (SMB, uni 18В), footprint D_SMB_Handsoldering; value обновлён.
- Кварц MCU Y1: **8 МГц HC-49SM, P/N SJK-6C-8.000-16-30-50-C-50-H** (SMD), footprint Crystal_SMD_HC49-SD_HandSoldering; value = P/N.
- TCXO Si5351 Y2: **TG2520SMN-27.6000M-MCGNNM3** (27.6 МГц, SMD 2520, 4-pin), footprint Oscillator_SMD_SeikoEpson_TG2520SMN-xxx-xxxxxx-4Pin_2.5x2.0mm. Цоколёвка: 1=NC, 2=GND, 3=OUT, 4=VCC; OUT→XA (REF_CLK), XB→NC, VCC→+3V3_SI_F, развязка C42=100нФ.
- Энкодер: **KY-040 на корпус**, на плате — разъём 5-pin (J_ENC_1).
- Дисплей: **ST7789 2.0" 240×320 SPI на корпус** (ПРИШЁЛ, сверено), на плате — разъём 8-pin J_OLED_1. Маркировка модуля: GND/VDD/SCL/SDA/RES/DC/CS/BL (SPI 4-wire; `SCL`=SCK, `SDA`=MOSI).
- Кнопки: на корпус, на плате — разъём J_BTN_1 (8-pin).

Схемотехника подэтапов:
1. **1.1** — входной узел защиты + DC-DC 12→5 В + LDO 3.3 В + `+3V3_SI`. (ГОТОВО)
2. **1.2** — MCU STM32F411 + кварц + SWD + UART. (ГОТОВО)
3. **1.3** — Si5351 + 74HC74 + буферы VFO/BFO/IQ. (ГОТОВО; U8 74AC541 размещён, финальное подключение `VFO_OUT`/`BFO_OUT`/`I_OUT`/`Q_OUT` — 1.5)
4. **1.4** — UI (разъёмы J_OLED_1/J_ENC_1/J_BTN_1), RIT, squelch; MIC-предусилитель (U7), `MIC_LINE`, вход RX_audio (ADC). (ГОТОВО)
5. **1.5 + 2.3 совместно** — control-часть ГОТОВА: интерфейсные метки (PTT, I_sense, SWR_sense, PWR_LIMIT_*, RX_audio, MUTE), питание-звезда R29/R30, буферы VFO/BFO/IQ разведены (`VFO_OUT`/`BFO_OUT`/`I_OUT`/`Q_OUT`), NC на неиспользуемые GPIO, привязка GPIO (1.5). Осталась **2.3 (УМ): лимитер/тумблер LIMIT/FULL + смещение RD16HHF1** на `02_power_amp`.

⚠️ Плату этапа 1 не травить до завершения 1.5 + 2.3. `control_pa.md` — **зафиксирован** (2026-10-28); `control_rxtx.md` — зафиксирован только пинаут разъёмов, остальное черновик до этапа 3.

### Решения по итогам валидации (session_report_validation.md)
- **PTT гарнитуры добавлен:** `PTT_IN` (J_PTT_IN_1, Conn_01x01, тест-пойнт) → R32 1к → R31 10к (pull-up +3V3) + C44 100 нФ → **PB5**. Имя `PTT_IN` не конфликтует с выходным `PTT` (PA8).
- **+5V:** одиночная глобальная метка заменена на power-символ `power:+5V` (warning `single_global_label` устранён).
- **C3:** footprint зафиксирован `CP_Elec_8x10.5` (деталь 8×10.2, запас 0.3 мм).
- **C38:** внесён в BOM (100 нФ, развязка +3V3).
- **R29/R30 → 1206 (ИСПРАВЛЕНО пользователем):** 0 Ом-джампер в звезде питания `+12V_PA`/`+12V_RXTX` переведён с 0805 на **1206** (запас по току ~1.8 А пик). Закрывает §8 п.4.
- **C44 → `100nF` (ИСПРАВЛЕНО пользователем):** value символа приведён к `100nF` (единообразие BOM). Закрывает §8 п.6.
- **I²C pull-up R3/R4 = 4.7 кОм (ПРИНЯТО):** Si5351 работает на **100 кГц** (типовой режим); 4.7 кОм для 100 кГц — норма, 400 кГц не нужен. Закрывает §8 п.3.
- **`LCD_BLK` (PB0) — ключ ДОБАВЛЕН в схему (Q1 AO3401 + R33 100R + R34 100k + R35 12R):** PB0→R33→Q1.G, Q1.S/R34→`+3V3_DISP`, Q1.D→R35→`LCD_BL`→`J_OLED_1:8`; active-low. Полярность `BL` = анод (подтверждено). **AO3401 — заказан.** R35 — заглушка, проверить яркость при bring-up. Закрывает §8 п.2.
- Остальные замечания §8 (U8 AHC/AC, I_sense/SWR_sense, Y1 20пФ, делитель /4, R19–R22) — зафиксированы как принятые решения/отложены.

### Read-only валидация схемы 01_control (2026-10-29)
Проведена read-only валидация `01_control.kicad_sch` — см. `docs/session_report_validation.md` (схема НЕ менялась). Итог: ERC **0 error / 7 warning** (все `footprint_link_issues`, все excluded); review `stm32f4` **0 error / 14 warning** (все безвредные NC/ложные); contract-проверка всех IC/passive/разъёмов — **PASS** (только `J_PTT_IN_1` WARN — нет 3D на тест-пойнте). Решения по замечаниям (приняты пользователем 2026-10-29): **R35** (подсветка 12R/0.5Вт, derating 96 % при 200 мА) → **резистор подбирается по факту включения дисплея (bring-up)**; **U8** `74AHC541` vs `74AC541SC` → принято как совместимые; **Si5351** `CLK0→BFO_RAW, CLK1→VFO_RAW` → **§1.3 приведён в соответствие** (прошивка: VFO на CLK1, BFO на CLK0).
- **`LCD_RST` (PA3 → `J_OLED_1:5` RESET) — подтяжка подтверждена (2026-10-29):** на модуле ST7789 есть pull-up на RESET (замер: **3.26 В** на `RES` при питании модуля и свободном `RES`). Advisory `reset_pullup` закрыт — правок схемы не требуется.

### Подстроечные места и настройка ВЧ (решение)
- В `01_control` **подстроечных элементов нет** (ни потенциометров, ни подстроечных конденсаторов) — намеренно.
- **R19–R22 = 22 Ом** (0603) — демпфирующие резисторы на выходах VFO/BFO/I/Q (74AC541 → межплатный разъём). На 37/10 МГц это гашение звона, а не точное согласование; точное значение некритично. При необходимости уточняется **перепайкой 0603**, не респином платы.
- **Уровни VFO/BFO выставляются прошивкой**, а не железом: у Si5351 программируемый ток выхода (2/4/6/8 мА на CLK).
- **R15–R18 = 22 Ом** — последовательные в SPI-линии OLED (гашение звона); **R5 = 10 Ом** — RC-ячейка в питание Si5351 (+C21 1 мкФ).
- Реальные подстроечные места — на этапах **2** (ограничитель AM 4 Вт, подстроечник по `control_pa.md`) и **3** (согласование/КСВ 27 МГц, защита RX).

## Зафиксированные контракты и пинаут разъёмов (2026-10-28)

Интерфейсные контракты зафиксированы для подэтапов 1.5 + 2.3. Источник правды — `docs/contracts/` + `docs/inter-module-pinout.md`.

### `control_pa.md` — ЗАФИКСИРОВАН
- **J_PA_CTRL_1** (`Connector_JST:JST_XH_B6B-XH-A_1x06_P2.50mm_Vertical`, XH2.54 6P vertical):
  1=GND, 2=PTT, 3=PWR_LIMIT_EN, 4=PWR_LIMIT_SW, 5=I_sense, 6=SWR_sense
- **J_PA_PWR_1** (`TerminalBlock_Phoenix:TerminalBlock_Phoenix_MKDS-1,5-2_1x02_P5.00mm_Horizontal`, клеммник 2P 5.0 мм horizontal):
  1=+12V_PA, 2=GND

### `control_rxtx.md` — зафиксирован для разводки этапа 1 (2026-10-29, пинаут обновлён 2026-10-30)
Зафиксировано для разводки этапа 1: тип+пинаут разъёмов, направления и уровни сигналов (проектные цели, подтверждение на bring-up этапа 3). Черновик до этапа 3 (на плату этапа 1 не влияет): `J_RF_RX`, защита входа RX, физическая прозвонка гарнитуры, RIT/XIT (прошивка).
- **Интерфейс 1↔3** (единый `J_RXTX_SIG_1` 10P **разбит на 6 разъёмов**, 2026-10-30):
  - `J_VFO_1` (XH2.54 2P): 1=VFO, 2=GND · `J_BFO_1` (2P): 1=BFO, 2=GND
  - `J_I_1` (2P): 1=I, 2=GND · `J_Q_1` (2P): 1=Q, 2=GND
  - `J_PTT_MUTE_1` (3P): 1=PTT, 2=GND, 3=MUTE
  - `J_AUDIO_1` (3P): 1=RX_audio, 2=GND, 3=MIC_LINE
- **J_RXTX_PWR_1** (тот же клеммник 2P 5.0 мм):
  1=+12V_RXTX, 2=GND

> `00_master` содержит только имена сигналов (иерархические пины), физического пинаута там нет. Пинаут — в `docs/contracts/` и `docs/inter-module-pinout.md`.

## Этап 4 (Mechanical) — прогресс
- **Передняя панель (корытце)** `Mechanical/enclosure/front_panel.FCStd` — **готово**
  (186 × 13.4 × 56 мм, STEP чистый). Раскладка — `docs/front_panel_elements.md`.
- **Наружная галтель сделана** (`OUTER_FILLET = 2.0`) — по всему периметру лицевой
  стороны (кромка «фронтальная плита → стенки»), нативный `makeFillet`. Ключ:
  галтель наносится на простую призму ДО выреза полости (иначе дефекты и
  `InvalidCurveOnSurface`). Финал: valid, 1 solid, 35 659.0 мм³, BOP check CLEAN.
- **Внутреннее скругление `BASIN_FILLET`** — остаётся отключено (0.0), отдельная задача.
- **Тумблер питания + раскладка**: добавлен KN3(B)-101A-A1 (ON-OFF 10A, Ø12.2 +
  цековка Ø16) справа; все элементы размещены с равным шагом — «экран → край
  панели» поделено на 6 равных отрезков (гарнитура, энкодер, RIT, джойстик, LED,
  тумблер). `sanity_check` — без перекрытий.
- **Скорлупы (верх/низ)** `Mechanical/scripts/build_shells.py` — **готово**.
  Вместо 6 деталей — 3: корытце + две скорлупы (верх = крышка + верхние половины
  боковин, низ = дно + нижние половины). Шов на Z=25 — **«1 язычок + 1 паз» на
  каждой скорлупе** (верх: язычок слева + паз справа; низ — зеркально), без
  винтов; язычки скорлуп — в пазы корытца + **саморез M3 сквозь язычок в гайку
  бобышки панели** (конусная зенковка на наружной грани язычка); жабры в
  боковинах; на верхней/нижней и боковых гранях — **8 задних пазов под крышку**
  (2 сверху + 2 снизу + 2 слева + 2 справа, зеркально передней панели; паз +
  отверстие + бобышка); зад закрывается задней крышкой. Галтель `SHELL_FILLET=2.5`
  (=`CORNER_R`) на двух рёбрах «крышка↔боковина» (до выреза полости). Финал:
  top 102 984.0 / bottom 102 981.8 мм³, оба 1 solid, BOP CLEAN; попарные
  пересечения четырёх тел сборки = 0.
- **Исправлен дефект**: правый паз шва нижней скорлупы откалывал угол-«занозу»
  (2 solid) — паз был с зазором внутрь полости (`CASE_W - c`), переведён на
  `CASE_W` (зазор наружу, зеркально левому).
- **Доработки сессии**: (1) исправлен баг цековок — цилиндр цековки начинался с
  `-DEPTH` и фактически не углублялся (~0.02 мм); теперь старт `-0.02`, высота
  `DEPTH + 0.02` (углубление реальное). (2) Радиус скругления унифицирован:
  `SHELL_FILLET` 2.0 → 2.5 = `CORNER_R`. (3) На язычки скорлуп добавлены
  отверстия Ø3.4 + конусные зенковки Ø6.0 (винт снаружи внутрь). (4) На
  верхней/нижней грани скорлуп — пазы под заднюю крышку (паз + винт + бобышка).
- **Задняя крышка + сборочный макет**: `build_back_cover.py` (плоская панель
  186×56, **8 язычков** (2+2+2+2) в задние пазы скорлуп — зеркально передней
  панели, 26 211.6 мм³, 1 solid, BOP CLEAN; на язычках — конусная зенковка под
  потайную головку, винт снаружи внутрь) + `build_assembly.py` (4 детали +
  схематичные модели органов управления в одном документе `assembly.FCStd`,
  сводный STL/STEP). Попарные пересечения четырёх тел = 0 (язычки входят в пазы
  без наложения).
- **Боковые язычки/пазы заднего соединения**: задняя крышка теперь зеркалит
  переднюю панель — 8 язычков (2 сверху + 2 снизу + 2 слева + 2 справа) против
  8 пазов передней; скорлупы получили 8 задних пазов (верх/низ + лево/право выше/
  ниже шва). Задняя крышка стыкуется с передней панелью даже без скорлуп.
- Зафиксировано: в `freecadcmd script.py` `__name__` = basename (не `"__main__"`);
  признак прямого запуска — basename скрипта в `sys.argv[1:]` (см. `_is_main()` в
  `Mechanical/scripts/build_front_panel.py`).

## Технический долг / прочее
- `00_master` в рабочем дереве может содержать несохранённые эксперименты (метки/провода) — на работу не влияет.
- NC-GPIO MCU: NC-крестики расставлены в 1.5 (все пины распределены и привязаны).
- Git: коммит сессии 1.3 сделан, залито в remote пользователем (сессия закрыта).
- Сессия BOM этапа 1: BOM сверен с заказом ChipDip/Ozon и складом, **дефицита нет**, задание KiCad-сессии F1–F13 вынесено в отдельный документ **`docs/kicad_task_stage1.md`**. **UX: SPI-дисплей ST7789 2.0" 240×320**, отдельный LDO U9, J_OLED_1 8-pin, J_ENC_1 5-pin (кнопка энкодером функциональна), **J_BTN_1 8-pin (джойстик 5-поз. + RIT)**, **RC-фильтры UI обязательны**.
- Открыто: ~~при получении ST7789 проверить пины (DC/CS/BLK)~~ ✅; замерить Ø и высоту штырька джойстика → требования этапа 4; к 2.3 — согласование выхода 74AC541SC с 50-омным трактом VFO/BFO/IQ. ~~GPIO для `IQ_EN` и всех UI-линий~~ ✅ (1.5).
- **Насадка-колпачок на штырёк джойстика + окантовка панели — этап 4 (3D-печать в FreeCAD)**, не покупная позиция BOM.
- Буферы 74AC541SC: **банк 1 (VFO/BFO) — OE на GND** (всегда вкл.); **банк 2 (I/Q) — OE на `IQ_EN`** (GPIO MCU, активный низкий; 1 = I/Q погашены в AM/FM/настройке).
