okunevpy-create/TRX_27MHz/docs/pcb_layout_stage2.md

# План разводки — 02_power_amp (этап 2)

Дата: **2026-11-04**. Плата **2 слоя (F.Cu / B.Cu)**, **1.6 мм FR4**, **1 oz (35 мкм)**.
Вид — **со стороны F.Cu**, origin — **левый верхний угол** Edge.Cuts (X → вправо, Y → вниз).

Источник правды: `docs/contracts/control_pa.md`, `docs/contracts/rxtx_pa.md`,
`docs/bom/stage2_power_amp.md`, `docs/calculations/power_budget_stage2.md` (токи/ширины),
`docs/pcb_design_rules.md` (глобальные правила).

> ⚠️ **Особенность изготовления (зафиксировано пользователем):** плата изготавливается
> **дома**, переходные отверстия — **заклёпочные (пистоны)**: сверло **Ø0.9 мм**,
> площадка **Ø2.5 мм**. Это **переопределяет** глобальное правило VIA 0.5/1.5 мм
> (проволочные перемычки) **только для платы этапа 2**.

---

## 1. Габариты (ЗАФИКСИРОВАНО 2026-11-05)

| Параметр | Значение | Статус |
|---|---|---|
| Радиатор HS 104-30 | база **30 × 102 мм** (высота 24.5 мм), 2× TO-220 | заказан |
| Габарит платы | **78 × 59 мм** (X × Y) | ✅ зафиксировано 2026-11-05 (по факту разводки) |
| Монтажные отверстия | **4 × M3 Ø3.2** (H1–H4) | ✅ добавлены 2026-11-05 |

> Решение (2026-11-04): габарит определялся по факту разводки. Финальный контур —
> **78 × 59 мм** (`gr_rect start 108.07 48.11 / end 186.07 107.11`).

### 1.1 Монтажные отверстия (плата 02_power_amp)

Origin = левый верхний угол Edge.Cuts (X → вправо, Y → вниз). Координаты центров
отверстий (относительно origin платы):

| Отв. | X (мм) | Y (мм) | Примечание |
|---|---|---|---|
| H1 | **4.83** | **4.18** | верхний левый ⚠️ дрейф 0.63 |
| H2 | **4.83** | **53.68** | нижний левый |
| H3 | **66.77** | **4.81** | верхний правый |
| H4 | **66.77** | **53.68** | нижний правый |

> Абсолютные координаты в `.kicad_pcb`: H1 (112.90, 52.29), H2 (112.90, 101.79),
> H3 (174.84, 52.92), H4 (174.84, 101.79). Отступы от края: слева 4.83, справа
> **11.23**, сверху 4.81 (H3) / 4.18 (H1), снизу 5.32 мм. Правый отступ больше —
> осознанно под edge-mount SMA `J_ANT_1`/`J_RF_TX_1`/`J_RF_RX_1` на правой кромке.
>
> ⚠️ **H1 сместился на 0.63 мм** после merge (в доке было 52.92, стало 52.29) —
> сверить с KiCad: если нужна симметрия, вернуть H1 на Y=52.92 (отступ 4.81).

---

## 2. Кромки разъёмов (рекомендация, вид F.Cu)

Раскладка в корпусе — в линию вдоль глубины: **задняя крышка → 02 → 03 → 01 → передняя панель**.

| Кромка | Назначение | Разъёмы |
|---|---|---|
| **ТЫЛ** (к задней крышке) | антенна + питание | `J_ANT_1` (SMA → BNC BJ2 на крышке), `J_PA_PWR_1` (клеммник 2P 5.0 мм, +12V_PA) |
| **ПЕРЕД** (к 03/01) | ВЧ + управление | `J_RF_TX_1` (SMA, вход), `J_RF_RX_1` (SMA, выход), `J_PA_CTRL_1` (XH 4P), `J_I_SENSE_1` (XH 2P), `J_SWR_1` (XH 2P) |
| **БОК** | панельный монтаж | `J_SW_1` (XH 3P, тумблер LIMIT/FULL), `J_LIM_LED_1` (XH 2P, LED LIMIT) |

> Пины разъёмов — строго по контрактам `control_pa.md` / `rxtx_pa.md` и BOM §2.3.
> `J_RF_TX_1`/`J_RF_RX_1`/`J_ANT_1` — SMA s-p215 (footprint `trx_custom:SMA_S-P215`).

---

## 3. Зональная схема (рекомендация)

```
        ТЫЛ (Y≈0): J_ANT_1 (SMA)                     J_PA_PWR_1 (+12V_PA/GND)
      ┌───────────────────────────────────────────────────────────────┐
      │                                                               │
      │  [1. ВЧ/СИЛОВОЙ ТРАКТ]                                        │
      │   T1 → R1/R2 → Q1/Q2 (2× TO-220 на радиаторе HS 104-30)      │
      │   → T2 → L1(RFC) → ФНЧ L2/L3+C6/C7/C8 → K1 (реле)            │
      │                                                               │
      │  [2. ДАТЧИКИ + УПРАВЛЕНИЕ + СМЕЩЕНИЕ]                          │
      │   R16(шунт) + U1(LM358) + Q3/Q4(2N7002) + RV1     │
      │   + J_PA_CTRL_1/J_I_SENSE_1/J_SWR_1                           │
      │                                                               │
      │  [3. LED + разъёмы панели]  D6/D7 + J_SW_1 + J_LIM_LED_1      │
      └───────────────────────────────────────────────────────────────┘
        ПЕРЕД: J_RF_TX_1  J_RF_RX_1  J_PA_CTRL_1  J_I_SENSE_1  J_SWR_1
```

- **Силовой ВЧ-тракт** (Q1/Q2, T1/T2, L1, LPF, K1) — компактно, по одной линии
  сигнала, вдали от датчиков и разъёмов управления.
- **Радиатор HS 104-30** — вдоль одной из длинных кромок, 2× TO-220 на общий
  радиатор (изоляторы + втулки M3 + термопаста).
- **Датчики/управление** (LM358, 2N7002, шунт, RV1) — отдельно от ВЧ, у разъёмов
  управления; аналоговые `I_sense`/`SWR_sense` — короткими дорожками к своим разъёмам.
- **Шунт R16 (2512)** — в минусовой шине `PA_RET → R16 → GND`, максимально близко
  к истокам Q1/Q2 и ко входу LM358 (IN1+ = `PA_RET`).

---

## 4. Net-классы цепей (Board Setup → Net Classes, через шаблоны)

> ✅ **ЗАФИКСИРОВАНО (2026-11-04, KiCad 10):** net-классы `PWR_PA` (1.5 мм) и
> `RF_PA` (1.0 мм) **определены и привязываются к цепям ЧЕРЕЗ ШАБЛОНЫ**, а не явным
> назначением. В KiCad 10 это хранится в проектном файле `.kicad_pro` (не в
> `.kicad_pcb`):
> - секция `net_classes` — сами классы (`track_width`, `clearance`, `priority`);
> - секция `netclass_patterns` — список `{ "netclass": "...", "pattern": "..." }`,
>   по которому KiCad **сам** сопоставляет имя цепи с классом;
> - `netclass_assignments` = `null` (явного назначения цепей нет).
>
> ⚠️ Поэтому в `.kicad_pcb` секции `net_class` **нет**, а `pcb_get_net_statistics`
> может показывать пустой `class_name` — это **не** означает отсутствие классов:
> класс вычисляется KiCad по шаблону из `.kicad_pro`. **Не поднимать снова вопрос
> «net-классы не назначены»** — механизм здесь — шаблоны, а не явное назначение.
> Кастомные DRC-правила `.kicad_dru` (§6) дублируют те же имена как страховку.

### 4.1 Классы для создания

| Net class | Ширина (мм) | Зазор (мм) | Назначение |
|---|---|---|---|
| `PWR_PA` | **1.5** | 0.4 | силовая магистраль УМ (3 А) |
| `RF_PA` | **1.0** | 0.4 | ВЧ-тракт 50 Ом + стоки (низкие потери) |
| *Default* | 0.6 | 0.4 | всё остальное (логика/датчики) |

### 4.2 Назначение цепей (шаблоны `netclass_patterns`, точные имена)

| Имя цепи | Net class |
|---|---|
| `+12V_PA` | `PWR_PA` |
| `PA_RET` | `PWR_PA` |
| `RFC_IN` | `PWR_PA` |
| `ANT` | `RF_PA` |
| `ANT_RELAY` | `RF_PA` |
| `LPF_IN` | `RF_PA` |
| `LPF_MID1` | `RF_PA` |
| `LPF_OUT` | `RF_PA` |
| `TX_RF` | `RF_PA` |
| `RX_RF` | `RF_PA` |
| `DRAIN1` | `RF_PA` |
| `DRAIN2` | `RF_PA` |
| всё остальное | *Default* |

> ⚠️ **Точные имена, НЕ wildcard** (`+12V*` и т.п.): иначе под шаблон попадут
> низкотоковые ветки `GATE1/GATE2`, `VGG*`, `G1_RF/G2_RF` — они должны остаться
> на Default 0.6.

### 4.3 Земля — отдельно (не net-класс)

- В схеме одна цепь `GND` (69 пинов). Отдельных `GND_DIG/GND_ANA/GND_PWR` **нет**.
- `GND` — сплошная заливка **с обеих сторон**, зазор полигона **0.5 мм**, **без
  thermal relief** (прямое соединение падов с полигоном).
- Разделение «силовое/сигнальное» — геометрией полигона (звезда в одной точке у
  bulk `C4` / входа `J_PA_PWR_1`), не отдельными net-ами.

---

## 5. Переходные отверстия (VIA) — ЗАФИКСИРОВАНО

Технология — **заклёпочные пистоны** (не проволочные перемычки).

| Параметр | Значение |
|---|---|
| Сверло | **0.9 мм** |
| Площадка (внешний Ø) | **2.5 мм** |
| Аннулюс | (2.5 − 0.9)/2 = **0.8 мм** |
| Pre-defined via (Board Setup) | **Ø2.5 / drill 0.9** |

> Один глобальный размер **Ø2.5 / drill 0.9** (Board Setup → Pre-defined Sizes).
> Per-class via не нужен. **Переопределяет** глобальный 0.5/1.5 мм только для этой платы.

---

## 6. DRC-правила `.kicad_dru` (добавить в GUI, синтаксис KiCad 10)

> ⚠️ MCP `drc_rule_create` пишет невалидный для KiCad 10 формат — правила добавлять
> **вручную в GUI** (как на этапе 1, см. `pcb_design_rules.md` §DRC).

| Правило | Ограничение | Назначение |
|---|---|---|
| `Stage2_edge_clearance` | `A.Type != 'Pad'` → `edge_clearance min 0.5mm` | зазор меди от края |
| `Stage2_via_geometry` | `A.Type == 'Via'` → `via_diameter min 2.5mm`, `annular_width min 0.8mm` | заклёпочная via |
| `Stage2_hole_to_hole` | `A.Type == 'Pad' \|\| A.Type == 'Via'` → `hole_to_hole min 0.5mm` | сверление 0.9 мм |
| `Stage2_gnd_clearance` | `A.NetName == 'GND'` → `clearance min 0.5mm` | зазор земли 0.5 мм |
| `Stage2_12v_width` | `A.NetName == '+12V_PA'` → `track_width min 1.5mm` | контроль силовой шины |
| `Stage2_pa_ret_width` | `A.NetName == '/PA_RET'` → `track_width min 1.5mm` | контроль силовой шины |
| `Stage2_rfc_in_width` | `A.NetName == '/RFC_IN'` → `track_width min 1.5mm` | контроль силовой шины |

> Плюс дефолтные (Board Setup / Net Classes, НЕ custom-правило): мин. дорожка **0.6 мм**, мин. зазор медь–медь **0.4 мм**.

> ⚠️ **Локальные метки = ведущий слэш (KiCad 10).** Цепи от локальных меток в PCB
> получают имя с ведущим слэшем (`/PA_RET`, `/RFC_IN`, `/ANT`, `/DRAIN1`…), а цепи
> питания/глобальные — без (`+12V_PA`, `GND`). В `.kicad_dru` имя в условии
> `A.NetName == '...'` должно **точно** совпадать с `pcb_get_nets`. Прецедент
> 2026-11-04: правила `PA_RET`/`RFC_IN` без слэша не срабатывали, из-за чего
> `/PA_RET` 1.0 мм не ловилась — исправлено на `/PA_RET`, `/RFC_IN`.

---

## 7. Разводка: F.Cu / B.Cu

**Ограничивает не тип цепи, а (1) минимум смен слоёв и (2) целостность GND-заливки.**

| Слой | Что ведём |
|---|---|
| **F.Cu** (основной, ~90 %) | весь ВЧ-тракт (`TX_RF`→T1→Q1/Q2→T2→LPF→K1→`ANT`), силовая магистраль `+12V_PA`/`PA_RET`/`RFC_IN`, датчики |
| **B.Cu** | короткие «перемычки через препятствие» (не влезло на F.Cu), при необходимости магистрали `+12V_PA` |

Жёсткие ограничения:
- **Каждый переход F.Cu↔B.Cu = заклёпочный пистон = лишняя ручная операция** → переходов минимум.
- **ВЧ-тракт — только F.Cu**, одной короткой линией, без перемычек по B.Cu; под ВЧ-дорожками — сплошной GND (B.Cu полигон).
- **Аналог (`I_sense`, `SWR_sense`, `PA_RET` к U1) — только F.Cu**, коротко, в стороне от ВЧ.
- **GND-заливка на B.Cu — максимально цельная** (обратный путь тока); длинные параллельные сигнальные дорожки по B.Cu режут землю — избегать.
- Силовой контур `C4/C3/C1/C2 → L1 → T2` — компактно, минимальная петля.

---

## 8. Размещение компонентов (полный состав — сверка по схеме, 59 шт)

Порядок блоков: **1 ВЧ-тракт → 2 Питание → 3 Смещение/LIMIT → 4 Датчики → 5 T/R → 6 Разъёмы → 7 LED**.

### 8.1 Блок 1 — Силовой ВЧ-тракт (14)
| Ref | Значение | Роль | Куда |
|-----|---|---|---|
| Q1, Q2 | RD16HHF1 | push-pull, класс AB | 2× TO-220 на радиаторе HS 104-30 (изоляторы + втулки M3) |
| T1 | BN-61-202 | входной балун 50 Ом → затворы | рядом с J_RF_TX_1 / Q1-Q2 |
| T2 | BN-61-202 | выходной балун (стоки → 50 Ом) | между Q1/Q2 и ФНЧ |
| L1 | T68-2 (4–6 мкГн) | RFC питания стоков | у T2 (центр первички) |
| L2, L3 | T50-6 (360 нГн) | катушки ФНЧ | в линии ФНЧ C–L–C–L–C |
| C6, C8 | 120 пФ C0G 100 В | конденсаторы ФНЧ (вх/вых) | в линии ФНЧ |
| C7 | 220 пФ C0G 100 В | конденсатор ФНЧ (серед.) | в линии ФНЧ |
| R1, R2 | 4.7 Ом | затворные антипаразитные | у затворов Q1/Q2 (между T1 и Q) |
| R17, R18 | 150 Ом (DNP) | отрицательная ОС (резерв) | место зарезервировать, не монтировать |

### 8.2 Блок 2 — Питание/развязка (5)
| Ref | Значение | Роль | Куда |
|-----|---|---|---|
| J_PA_PWR_1 | клеммник 2P 5.0 мм | вход +12V_PA/GND | тыльная кромка |
| C4 | 470 мкФ/35 В | электролит bulk | у J_PA_PWR_1 |
| C3 | 10 мкФ X7R | керамика bulk 12 В | у C4 |
| C1, C2 | 100 нФ | ВЧ-развязка +12V_PA | у C4 / у L1 (стоки) |

### 8.3 Блок 3 — Смещение затворов + LIMIT/FULL (16)
| Ref | Значение | Роль | Куда |
|-----|---|---|---|
| R5 / R6 | 10к / 2.7к | делитель VGG_FULL (≈2.55 В) | у RV1 |
| RV1 | 3296W 10к | подстроечник VGG_LIMIT (калибр. 4 Вт) | у R5/R6 |
| R19 | 100к | подтяжка VGG к VGG_FULL (по умолч. FULL) | у узла VGG |
| R3, R4 | 10к | подача VGG на затворы Q1/Q2 | между узлом VGG и R1/R2 |
| R7 / R8 | 27к / 10к | делитель PLIM_LIM (3.24 В) | у J_SW_1 |
| C5 | 100 нФ | фильтр узла VGG | у R19/R3/R4 |
| Q3 | 2N7002 | единственный LIMIT (PWR_LIMIT_EN) | у RV1/R19 |
| R9 | 2.2к | токоограничение панельного LED LIM | у J_LIM_LED_1 |
| J_SW_1 | XH 3P | разъём тумблера LIMIT/FULL | боковая кромка |
| J_LIM_LED_1 | XH 2P | разъём панельного LED LIM | боковая кромка |

### 8.4 Блок 4 — Датчики (12)
| Ref | Значение | Роль | Куда |
|-----|---|---|---|
| R16 | 0.05 Ом 1 %/2 Вт (2512) | шунт тока | в минусовой шине PA_RET→GND, у истоков Q1/Q2 |
| U1 | LM358 | усилитель I_sense (G≈23) | рядом с R16 |
| R12 | 1к | вход усилителя I_sense | у U1 |
| R13 | 22к | ОС усилителя I_sense | у U1 |
| R14 | 1к | выход I_sense | у U1 → J_I_SENSE_1 |
| C9 | 100 нФ | фильтр I_sense | у R14/J_I_SENSE_1 |
| T3 | BN-61-202 | токовый трансформатор КСВ (первичка — 1 проход линии ANT в разрыв) | на линии ANT (K1 COM → J_ANT_1), вторичка → SWR_RF |
| D4, D5 | BAT54 | детектор SWR | у T3 |
| C11 | 22 пФ C0G 100 В (10–33 пФ) | конденсатор выборки напряжения return-loss моста (ANT → SWR_RF) | у T3 |
| R15 | 10к | нагрузка/фильтр SWR_sense | у D4/D5 |
| C10 | 100 нФ | фильтр SWR_sense | у R15/J_SWR_1 |

### 8.5 Блок 5 — T/R реле (4)
| Ref | Значение | Роль | Куда |
|-----|---|---|---|
| K1 | IM06GR | реле T/R (DPDT 12 В) | между ФНЧ (TX) и J_ANT_1 (COM) |
| Q4 | 2N7002 | ключ реле (PTT) | у K1 |
| D1 | 1N4148WS | обратный диод катушки | у K1 (параллельно катушке) |
| R20 | 10к | подтяжка затвора Q4 (PTT) к GND | у Q4 |

### 8.6 Блок 6 — Разъёмы ВЧ + управления (6) — на кромках (§2)
| Ref | Тип | Куда |
|-----|-----|---|
| J_RF_TX_1 | SMA | передняя кромка (вход TX_RF) |
| J_RF_RX_1 | SMA | передняя кромка (выход RX_RF) |
| J_ANT_1 | SMA | тыльная кромка (антенна) |
| J_PA_CTRL_1 | XH 4P | передняя кромка |
| J_I_SENSE_1 | XH 2P | передняя кромка |
| J_SWR_1 | XH 2P | передняя кромка |

### 8.7 Блок 7 — LED + панель (4)
| Ref | Значение | Роль | Куда |
|-----|---|---|---|
| D6 | LED красный 0805 | дубль LIMIT (PWR_LIMIT_EN) | у R10 |
| R10 | 2.2к | ток D6 | у D6 |
| D7 | LED зелёный 0805 | power-good (+12V_PA) | у R11 |
| R11 | 3.3к | ток D7 | у D7 |

> Итого **61 компонент** (сверено с `sch_get_symbols`): диоды/LED 7 + транзисторы 5 +
> U1 1 + резисторы 20 + конденсаторы 11 + индуктивности 3 + трансформаторы 3 +
> реле K1 1 + потенциометр RV1 1 + разъёмы 9 = **61**. Плюс 39 power-символов
> (GND / +12V_PA / PWR_FLAG) — не компоненты.

---

## 9. Разделение работ

- **Размещение + поворот + трассировка** — пользователь в GUI KiCad (Freerouting).
- **Агент** — подготовил правила/доки/план (этот файл) и **проверяет результат**
  (`run_drc`, gates, bbox/координаты). У агента нет `pcb_place/move/rotate` и
  `route_autoroute_freerouting` (подтверждено 2026-10-31).

---

## 10. Статус

**PCB-разводка этапа 2 ЗАВЕРШЕНА (2026-11-04), DRC=0, ERC=0.** Зафиксированы:
токовый бюджет и ширины (`power_budget_stage2.md`), ширины цепей (контроль —
кастомные `.kicad_dru` правила, **net-классы НЕ назначаются**, см. §4), размер
заклёпочной via (Ø2.5 / drill 0.9), мин. дорожка **0.6 мм**, зазор медь–медь
**0.4 мм**, зазор GND-полигона **0.5 мм**, габарит платы — **по факту разводки**
(§1). Итоговый габарит: **78 × 59 мм**, 61 компонент, 41 net.
