okunevpy-create/TRX_27MHz/docs/pcb_layout_stage3.md

# План разводки — 03_rx_tx (этап 3)

Дата: **2026-11-05**. Плата **2 слоя (F.Cu / B.Cu)**, **1.6 мм FR4**, **1 oz (35 мкм)**.
Вид — **со стороны F.Cu**, origin — **левый верхний угол** Edge.Cuts (X → вправо, Y → вниз).

Источник правды: `docs/contracts/control_rxtx.md`, `docs/contracts/rxtx_pa.md`,
`docs/bom/stage3_rx_tx.md`, `docs/calculations/power_budget_stage3.md`,
`docs/design_decisions_stage3.md`, `docs/pcb_design_rules.md` (глобальные правила).

> ⚠️ **Особенность изготовления (зафиксировано пользователем):** плата изготавливается
> **дома**, переходные отверстия — **заклёпочные (пистоны)**: сверло **Ø0.9 мм**,
> площадка **Ø2.5 мм**. **Дефолтная ширина дорожки — 0.6 мм.** Это повторяет рецепт
> платы этапа 2 (`02_power_amp`) и переопределяет глобальное правило VIA 0.5/1.5 мм
> только для этой платы.

---

## 1. Габариты (предварительно зафиксированы 2026-11-05)

| Параметр | Значение |
|---|---|
| Габарит платы 3 | **90 × 60 мм** (итоговый: X=90, Y=60 в СК платы/KiCad) |
| Размещение | вдоль **правой стенки**, за платой 1 (X 120..180, Y 87..177) |

> Глубина корпуса увеличена до **180 мм** (`CASE_D = 180`). Раскладка плат:
> плата 1 — фронт (по центру), плата 2 — зад (по центру), плата 3 — правая стенка
> (за платой 1), LTC3780 — левая стенка (вертикально, посередине).

---

## 2. Кромки разъёмов (вид F.Cu)

Плата 3 стоит **вдоль правой стенки** (90 × 60 мм: 90 вдоль стенки, 60 от стенки). Разъёмы по кромкам:

| Кромка | Разъёмы |
|---|---|
| **ЛЕВО** (к плате 2) | `J2` (TX_RF, SMA → 02 TX), `J1` (RX_RF, SMA → 02 RX) |
| **ПРАВО** (к плате 1) | `J3` (VFO, SMA → 01 VFO), `J4` (BFO, SMA → 01 BFO) |
| **НИЗ** (питание + управление) | `J8` (клеммник 2P), `J5` (2P), `J6` (3P), `J7` (3P), `J9` (2P) |

Пинаут разъёмов — по `control_rxtx.md` и BOM §Разъёмы:
- `J1` / `J2` / `J3` / `J4` — SMA S-P215 (footprint `trx_custom:SMA_S-P215`).
- `J6`: 1=PTT, 2=GND, 3=MUTE. `J7`: 1=RX_audio, 2=GND, 3=MIC_LINE.

---

## 3. Зональная схема (рекомендация)

```
            ЛЕВО (к плате 2):                  ПРАВО (к плате 1):
            J2  (TX_RF, SMA → 02 TX)           J3   (VFO, SMA → 01 VFO)
            J1  (RX_RF, SMA → 02 RX)           J4   (BFO, SMA → 01 BFO)
          ┌──────────────────────────────────────────────────────────────┐
          │                                                              │
          │  [1. RX-ВХОД 27 МГц]                                         │
          │   J1 → D1/D2 + T-pad (R1/R2/R3) → BPF RX (L1/L2+C1–C5)       │
          │   → K1 (реле, NC)                                            │
          │                                                              │
          │  [2. СМЕСИТЕЛЬ U1 + T/R]  U1 (NE612) + K1 (IM06GR) + Q2      │
          │                                                              │
          │  [3. КВАРЦЕВЫЙ ФИЛЬТР 10 МГц]  X1–X4 + C16–C21 + D3–D5        │
          │                                                              │
          │  [4. ДЕТЕКТОР/МОДУЛЯТОР + УНЧ + ДРАЙВЕР TX]                   │
          │   U2 → U3 (LM386) → J9;  U4 → Q1 → BPF TX → J2               │
          │                                                              │
          │  [5. ПИТАНИЕ]  U5 (LM7809) + U6 (L78L06) + C40–C45           │
          └──────────────────────────────────────────────────────────────┘
            НИЗ (питание + управление): J8  J5  J6  J7  J9
```

- **Тракт 27 МГц** (RX: `J1` → BPF RX → K1/U1; TX: U4 → Q1 → BPF TX → `J2`) —
  у левой кромки, по одной линии сигнала, компактно, вдали от аудио.
- **Кварцевый фильтр 10 МГц** — симметричный «лесенкой», X1–X4 в одну линию,
  связующие ёмкости/диоды по бокам; минимум паразитных петель.
- **Гетеродины VFO (37 МГц) / BFO (10 МГц)** — приходят справа (`J3`/`J4`), дорожки к своим
  NE612 вести раздельно (VFO → U1, BFO → U2/U4); не вести параллельно длинными участками.
- **Аудио (U2 → LM386 → J9; RX_audio/MIC_LINE)** — у нижней кромки, в стороне от ВЧ.
- **Питание (U5/U6)** — у нижнего входа `J8`, развязка у каждой ИС.

---

## 4. Ширина дорожек — единый Default (Board Setup → Net Classes)

**Решение (2026-11-05): всё разводим одним классом `Default` 0.6 мм.**

- Отдельные net-классы (`RF_RXTX`/`LO_RXTX`/`PWR_RXTX`) **не создаём**: все токи
  ≤ 0.25 А, единая ширина **0.6 мм** покрывает всё с запасом >10×
  (`power_budget_stage3.md` §4 — ΔU ≤ 8.4 мВ, ΔT ≤ 0.1 °C).
- `Board Setup → Net Classes`: **Default = 0.6 мм**, зазор **0.4 мм**. Больше ничего.
- Классы не давали бы выигрыша: они не меняли бы ширину (всё и так 0.6 мм), а явных
  DRC-правил по ширине нет (нет цепей с током > 0.25 А). Согласование 50 Ом не
  требуется — на 27 МГц все трассы ≪ λ/20 (λ ≈ 11 м).

### 4.1 «Чувствительные» цепи — заметка для трассировки (НЕ net-класс)

Ниже — **список для дисциплины трассировки**, а не для Net Class Assignment.
Эти цепи ведём коротко/прямо и вдали от аудио, но ширина у них та же 0.6 мм.

| Группа | Имена цепей |
|---|---|
| Тракт 27 МГц | `RX_RF`, `RX_PROT`, `RX_ATT`, `RX_T1`, `RX_T2`, `RX_BPF_OUT`, `U1_IN`, `U1_OUT`, `TX_BPF_IN`, `TX_T1`, `TX_T2`, `TX_BPF_OUT`, `TX_RF`, `Q1_B`, `Q1_C` |
| ПЧ 10 МГц (кварцевый фильтр) | `IF_MIX`, `N1`, `N2`, `N3`, `IF_BB`, `DSB`, `U2_IN` |
| Гетеродины | `VFO`, `BFO`, `U1_LO`, `U2_LO`, `U4_LO` |

### 4.2 Земля — отдельно (не net-класс)

- В схеме одна цепь `GND` (129 пинов). Отдельных `GND_DIG/GND_ANA/GND_PWR` **нет**.
- `GND` — сплошная заливка **с обеих сторон**, зазор полигона **0.5 мм**, **без
  thermal relief** (прямое соединение падов с полигоном).
- Разделение «ВЧ/аудио/питание» — геометрией полигона и зонированием (§3), не
  отдельными net-ами. Звезда земли — у bulk-конденсатора входа `J8` (C40/C41).

---

## 5. Переходные отверстия (VIA) — ЗАФИКСИРОВАНО

Технология — **заклёпочные пистоны** (не проволочные перемычки).

| Параметр | Значение |
|---|---|
| Сверло | **0.9 мм** |
| Площадка (внешний Ø) | **2.5 мм** |
| Аннулюс | (2.5 − 0.9)/2 = **0.8 мм** |
| Pre-defined via (Board Setup) | **Ø2.5 / drill 0.9** |

> Один глобальный размер **Ø2.5 / drill 0.9** (Board Setup → Pre-defined Sizes).
> Per-class via не нужен. Переопределяет глобальный 0.5/1.5 мм только для этой платы.

---

## 6. DRC-правила `.kicad_dru` (добавить в GUI, синтаксис KiCad 10)

> ⚠️ MCP `drc_rule_create` пишет невалидный для KiCad 10 формат — правила добавлять
> **вручную в GUI** (см. `pcb_design_rules.md` §DRC).

| Правило | Ограничение | Назначение |
|---|---|---|
| `Stage3_edge_clearance` | `A.Type != 'Pad'` → `edge_clearance min 0.5mm` | зазор меди от края |
| `Stage3_via_geometry` | `A.Type == 'Via'` → `via_diameter min 2.5mm`, `annular_width min 0.8mm` | заклёпочная via |
| `Stage3_hole_to_hole` | `A.Type == 'Pad' \|\| A.Type == 'Via'` → `hole_to_hole min 0.5mm` | сверление 0.9 мм |
| `Stage3_gnd_clearance` | `A.NetName == 'GND'` → `clearance min 0.5mm` | зазор земли 0.5 мм |

> Плюс дефолтные (Board Setup / Net Classes, НЕ custom-правило): мин. дорожка
> **0.6 мм**, мин. зазор медь–медь **0.4 мм**. Явных DRC-правил по ширине не нужно —
> всё Default 0.6 мм (нет цепей с током > 0.25 А).

---

## 7. Разводка: F.Cu / B.Cu

**Ограничивает не тип цепи, а (1) минимум смен слоёв и (2) целостность GND-заливки.**

| Слой | Что ведём |
|---|---|
| **F.Cu** (основной, ~95 %) | весь тракт 27 МГц (`RX_RF`→…→`TX_RF`), ПЧ 10 МГц (`IF_MIX`/`N1–N3`/`IF_BB`/`DSB`), гетеродины `VFO`/`BFO`, питание `+12V_RXTX`/`+9V`/`+6V`, аудио |
| **B.Cu** | только короткие «перемычки через препятствие» (не влезло на F.Cu); **GND-заливка** |

Жёсткие ограничения:
- **Каждый переход F.Cu↔B.Cu = заклёпочный пистон = лишняя ручная операция** → переходов минимум.
- **ВЧ/ПЧ/гетеродины — только F.Cu**, одной короткой линией, без перемычек по B.Cu; под ними — сплошной GND (B.Cu полигон).
- **Кварцевый фильтр** — X1–X4 по одной прямой, связующие ёмкости/диоды прижаты к узлам N1/N2/N3; дорожки N-узлов минимальной длины, симметрично.
- **Гетеродины VFO и BFO — разнести** (VFO у U1, BFO у U2/U4), дорожки короткие, не вести параллельно длинными участками (наводка 37↔10 МГц).
- **Аудио (LM386, `RX_audio`, `MIC_LINE`, `SP`) — в стороне от ВЧ/гетеродинов**, обратный путь аудио — своя зона GND.
- **GND-заливка на B.Cu — максимально цельная**; длинные параллельные сигнальные дорожки по B.Cu режут землю — избегать.
- **Flyback `D6`** — максимально близко к катушке реле `K1` (параллельно катушке 1–8).

---

## 8. Размещение компонентов по узлам (полный состав — сверка по схеме, 113 шт)

Порядок блоков — по тракту сигнала: **1 RX-вход → 2 TX-выход → 3 Смеситель/T-R →
4 Кварцевый фильтр → 5 Детектор+УНЧ → 6 Модулятор → 7 Питание → 8 Разъёмы**.

> **Ссылочные обозначения (ref) в схеме — `J1`–`J9`**, значение (`Value`) = функциональное
> имя: `J1`=RX_RF, `J2`=TX_RF, `J3`=VFO, `J4`=BFO, `J5`=MODE, `J6`=PTT_MUTE, `J7`=AUDIO,
> `J8`=PWR, `J9`=SP. На стороне `01_control` те же сигналы сидят на `J_VFO_1`/`J_BFO_1`/
> `J_MODE_1`/`J_PTT_MUTE_1`/`J_AUDIO_1` (см. `control_rxtx.md`).

### 8.1 Блок 1 — RX-вход 27 МГц (13)   ✅ ВЫПОЛНЕНО
| Ref | Значение | Роль | Куда |
|-----|---|---|---|
| J1 | RX_RF (SMA) | вход приёма с УМ (до 1 Вт просачивания) | левая кромка (§2) |
| D1, D2 | 1N4148WS | антипараллельная защита входа | сразу у J1 |
| R1, R3 | 8.2 Ом | T-pad аттенюатор (последовательные) | между D1/D2 и BPF |
| R2 | 150 Ом | T-pad аттенюатор (параллельный) | между R1 и R3 |
| L1, L2 | 0.47 мкГн | BPF RX (катушки) | в линии RX-фильтра |
| C1, C5 | 18 пФ | BPF RX (крайние ёмкости) | у L1/L2 |
| C2, C4 | 51 пФ | BPF RX (ёмкости связи) | у L1/L2 |
| C3 | 2.7 пФ | BPF RX (связь контуров, середина) | между L1 и L2 |

### 8.2 Блок 2 — TX-выход 27 МГц + драйвер (16) ✅ ВЫПОЛНЕНО
| Ref | Значение | Роль | Куда |
|-----|---|---|---|
| J2 | TX_RF (SMA) | выход TX на УМ (02) | левая кромка (§2) |
| L3, L4 | 0.47 мкГн | BPF TX (катушки) | в линии TX-фильтра |
| C6, C10 | 18 пФ | BPF TX (крайние ёмкости) | у L3/L4 |
| C7, C9 | 51 пФ | BPF TX (ёмкости связи) | у L3/L4 |
| C8 | 2.7 пФ | BPF TX (связь контуров, середина) | между L3 и L4 |
| Q1 | 2SC2314 | драйвер TX (кл. A/AB, TO-92L) | между U1 и BPF TX |
| L5 | 10 мкГн | RFC питания коллектора Q1 | у Q1 |
| C46 | 100 пФ | связь входа драйвера (DSB → Q1.B) | у Q1 (вход) |
| C48 | 100 пФ | связь выхода драйвера (Q1.C → BPF TX) | у Q1 (выход) |
| C47 | 10 нФ | эмиттерный bypass Q1 | у R27 |
| R25 | 47 кОм | верхнее плечо делителя смещения Q1 | у Q1 |
| R26 | 10 кОм | нижнее плечо делителя смещения Q1 | у Q1 |
| R27 | 47 Ом | эмиттерный резистор Re | у Q1 (эмиттер) |

### 8.3 Блок 3 — Смеситель U1 + T/R K1 (13) ✅ ВЫПОЛНЕНО
| Ref | Значение | Роль | Куда |
|-----|---|---|---|
| U1 | NE612A | смеситель RX (27 МГц → 10 МГц IF) | центр тракта RX |
| K1 | IM06GR | реле T/R (DPDT 12 В, GullWing) | между BPF RX/TX и U1 |
| Q2 | 2N7002 | ключ реле (PTT) | у K1 |
| D6 | 1N4148WS | flyback-диод катушки K1 | параллельно катушке 1–8 |
| R6 | 10 кОм | PTT → затвор Q2 | у Q2 |
| R7 | 100 кОм | pull-down затвора Q2 | у Q2 |
| R4, R5 | 2.2 кОм | подтяжки OUT_A/OUT_B (U1) | у U1 |
| C11 | 100 нФ | IN_B U1 (связь) | у U1 |
| C12 | 10 нФ | OUT_B U1 (IF) | у U1 |
| C13 | 10 нФ | LO U1 (VFO 37 МГц) | у U1 |
| C14 | 100 нФ | OSC_E U1 (развязка) | у U1 |
| C15 | 100 нФ | VCC U1 (+6V развязка) | у U1 |

### 8.4 Блок 4 — Кварцевый фильтр 10 МГц (23) ✅ ВЫПОЛНЕНО
| Ref | Значение | Роль | Куда |
|-----|---|---|---|
| X1–X4 | 10 МГц | кварцы «лесенкой» (HC49-SD) | в одну линию, симметрично |
| C16–C18 | 47 пФ | ёмкостный мост (связь) | между узлами N1/N2/N3 |
| C19–C21 | 68 пФ | ёмкостный мост (связь) | между узлами N1/N2/N3 |
| D3–D5 | 1N4148WS | ключи AM/SSB (перестройка полосы) | у узлов N1/N2/N3 |
| R12–R14 | 100 кОм | bias N → V_sw | у D3–D5 |
| R15–R17 | 10 кОм | S → MODE | у D3–D5 |
| R10, R11 | 100 кОм | делитель V_sw | у узла V_sw |
| R8, R9 | 470 Ом | терминация входа/выхода фильтра | у входа/выхода X1/X4 |

### 8.5 Блок 5 — Детектор U2 + УНЧ U3 (19)
| Ref | Значение | Роль | Куда |
|-----|---|---|---|
| U2 | NE612A | детектор SSB/AM (10 МГц → аудио) | тракт ПЧ |
| U3 | LM386 | УНЧ (динамик) | нижняя зона, вдали от ВЧ |
| Q3 | 2N7002 | MUTE-ключ (squelch) | у U3 |
| R28 | 10 кОм | MUTE → затвор Q3 | у Q3 |
| R29 | 100 кОм | pull-down затвора Q3 | у Q3 |
| C27 | 10 нФ | IF → U2 | у U2 |
| C24 | 10 нФ | BFO → U2 | у U2 |
| C22 | 100 нФ | развязка U2 | у U2 |
| C23 | 10 нФ | связь U2 | у U2 |
| C25, C26 | 100 нФ | развязка U2/U3 | у U2/U3 |
| R18, R19 | 2.2 кОм | подтяжки U2 | у U2 |
| C35 | 100 нФ | AUDIO → RX_audio (squelch) | у J_AUDIO |
| C36 | 100 нФ | AUDIO → SP_IN (LM386) | у U3 |
| C38 | 100 мкФ | выход УНЧ → SP | у U3/J_SP |
| R30 | 10 Ом | Zobel-цепь LM386 | у U3 (выход) |
| C39 | 47 нФ | Zobel-цепь LM386 | у R30 |
| C37 | 100 нФ | +9V развязка LM386 | у U3 |

### 8.6 Блок 6 — Модулятор U4 (14)
| Ref | Значение | Роль | Куда |
|-----|---|---|---|
| U4 | NE612A | модулятор TX (DSB) | тракт TX |
| C28 | 1 мкФ | MIC вход (связь) | у U4 |
| C29 | 4.7 нФ | IN_B U4 | у U4 |
| C30 | 10 нФ | OUT_B U4 | у U4 |
| C31 | 10 нФ | BFO LO U4 | у U4 |
| C32 | 100 нФ | развязка U4 | у U4 |
| C33 | 100 нФ | VCC U4 (+6V) | у U4 |
| C34 | 10 нФ | DSB выход (→ Q1.B) | у U4 |
| R20, R21 | 2.2 кОм | подтяжки U4 | у U4 |
| R22 | 100 кОм | MODE → U4.2 | у U4 |
| R23 | 100 кОм | +6V → RV1 | у RV1 |
| R24 | 100 кОм | RV1 → U4.2 | у RV1/U4 |
| RV1 | 10 кОм | несущая AM (подстроечник 3214W) | у R23/R24 |

### 8.7 Блок 7 — Питание (8)
| Ref | Значение | Роль | Куда |
|-----|---|---|---|
| U5 | L7809 | стабилизатор +9V (TO-220) | нижняя зона, у J8 |
| U6 | L78L06 | стабилизатор +6V (TO-92) | у U5 |
| C40 | 10 мкФ | bulk +12V (вход U5) | у J8/U5 |
| C41 | 100 нФ | развязка +12V | у U5 |
| C42 | 10 мкФ | bulk +9V (выход U5) | у U5 |
| C43, C44 | 100 нФ | развязка +9V | у U5/U6 |
| C45 | 100 нФ | развязка +6V | у U6 |

### 8.8 Блок 8 — Разъёмы управления/питания (7) — на кромках (§2)
| Ref | Тип | Куда |
|-----|-----|---|
| J3 | SMA | правая кромка (VFO 37 МГц с 01) |
| J4 | SMA | правая кромка (BFO 10 МГц с 01) |
| J5 | XH 2P | нижняя кромка (MODE) |
| J6 | XH 3P | нижняя кромка (PTT/MUTE) |
| J7 | XH 3P | нижняя кромка (RX_audio/MIC_LINE) |
| J8 | клеммник 2P (MKDS 5.0) | нижняя кромка (+12V_RXTX/GND) |
| J9 | XH 2P | нижняя кромка (SP+ динамик) |

> Итого **113 компонентов** (сверено с `sch_get_symbols`): разъёмы 9 + диоды 6 +
> транзисторы 3 + ИС 6 (U1–U6) + реле K1 1 + кварцы 4 + подстроечник RV1 1 +
> резисторы 30 + конденсаторы 48 + индуктивности 5 = **113**. Плюс 89 power-символов
> (GND / +9V / +6V / PWR_FLAG) — не компоненты.

### 8.9 Порядок трассировки (рекомендация, по убыванию чувствительности)

1. **Кварцевый фильтр 10 МГц** (X1–X4, C16–C21, D3–D5, R8–R17) — симметрично, компактно.
2. **Тракт 27 МГц**: `J1 → D1/D2 → T-pad → BPF RX → K1 → U1`; `U4 → Q1 → BPF TX → J2`.
3. **Гетеродины**: `J3 → VFO → C13 → U1`; `J4 → BFO → C24/C31 → U2/U4`.
4. **Питание**: `J8 → U5 (L7809) → +9V → U6 (L78L06) → +6V` + развязка у ИС.
5. **Аудио/управление**: U2 → U3 (LM386) → `J9`; `J5`, `J6`, `J7`.

---

## 9. Разделение работ

- **Размещение + поворот + трассировка** — пользователь в GUI KiCad (Freerouting).
- **Агент** — подготовил правила/доки/план (этот файл) и **проверяет результат**
  (`run_drc`, gates, bbox/координаты). У агента нет `pcb_place/move/rotate` и
  `route_autoroute_freerouting` (подтверждено 2026-10-31).

**Пользователь в GUI:**
1. `Board Setup → Net Classes` — **Default 0.6 мм / зазор 0.4 мм** (классы не создавать).
2. `Board Setup → Pre-defined Sizes` — via **Ø2.5 / drill 0.9**.
3. `Board Setup → Design Rules → Custom Rules` — добавить 4 правила §6.
4. Трассировка (Freerouting) + заливка GND (0.5 мм, без thermal relief).
5. Агент проверит `run_drc` / `pcb_quality_gate` / `validate_design`.

---

## 10. Статус

**Подготовлен план разводки этапа 3.** Зафиксированы: бюджет токов
(`power_budget_stage3.md`), единая ширина **Default 0.6 мм** (отдельные net-классы
отменены решением 2026-11-05), размер заклёпочной via (Ø2.5 / drill 0.9), мин.
дорожка **0.6 мм**, зазор медь–медь **0.4 мм**, зазор GND-полигона **0.5 мм**,
габарит платы — **по факту разводки** (§1).
