okunevpy-create/TRX_27MHz/docs/back_cover_elements.md

# Задняя крышка — размещаемые элементы

Документ фиксирует **что именно** выносится на заднюю крышку корпуса. Аналог
`docs/front_panel_elements.md` для передней панели.

Геометрические параметры задней части — в [`Mechanical/params.py`](../Mechanical/params.py)
(секция 11 «Разъёмы задней крышки»). Модель задней крышки —
`Mechanical/enclosure/back_cover.FCStd` (186 × 56, заглушка заднего проёма).

> **Радиатора на задней крышке НЕТ.** Охлаждение УМ — радиатор **HS 104-30**
> (общий на 2× TO-220) на плате `02_power_amp`. Задняя крышка — заглушка; в ней
> только отверстия под разъёмы (антенна, питание).

---

## 1. Размещаемые элементы

| # | Элемент | Тип | Статус | Источник |
|---|---|-----|---|---|
| 1 | **Антенный разъём BNC** | BNC (панельный, гайка, **BJ2**) | **тип зафиксирован** | решение (этап 2, `docs/bom/stage2_power_amp.md` J_ANT_1) |
| 2 | **Разъём внешнего питания** | **KLS1-DC-025A-2.0 (DS-046C)** DC jack, 2.0×5.5 мм | **тип зафиксирован** | решение (этап 1, вход 12 В) |
| 3 | **Держатель предохранителя** | **FH10-S-MZ** на панель, 5×20 мм (винтовой колпачок) | **тип задан** | решение (2026-11-03, вход 12 В, предохранитель 5 А) |

---

## 2. Антенный разъём BNC

- **Куда:** задняя крышка (задняя часть корпуса). В ВЧ-тракте это `J_ANT_1`
  (антенна) — контракт `docs/contracts/rxtx_pa.md`.
- **Тип:** BNC (панельный, с гайкой/фланцем, **BJ2**). Посадочное отверстие **Ø9.5 мм**
  (`params.py` `ANT_HOLE_D = 9.5`).
- **Связь с платой:** BNC ↔ `02_power_amp` коротким коаксиалом (RG-174/RG-316,
  50 Ом) или пайкой на пады платы.
- **Координаты:** `ANT_CENTER_X = 155.0`, `ANT_CENTER_Z = 25.0` (**справа**, вид с фронта).

---

## 3. Разъём внешнего питания

- **Факт:** на задней крышке предусматривается разъём подачи внешнего питания
  (12 В от бортовой сети/АКБ) на `01_control` (вход `+12V_IN`, `J_12V_IN_1`).
- **Тип — ЗАФИКСИРОВАН:** **KLS1-DC-025A-2.0 (DS-046C)** — гнездо питания на
  панель **2.0×5.5 мм** с гайкой (DC jack, панельный).
- **Посадочное:** отверстие **Ø8.0 мм** под резьбу (M8×0.75) — в
  `Mechanical/params.py` (`PWR_CONN_HOLE_D=8.0`, **TBD по факту детали**).
- **Положение:** `PWR_CONN_CENTER_X=25.0`, `PWR_CONN_CENTER_Z=25.0` (**слева**, вид с фронта).

---

## 4. Держатель предохранителя FH10-S-MZ (5×20, на панель)

- **Факт:** предохранитель **5 А, 5×20 мм, медленный (T)** перенесён с платы
  `01_control` на корпус (входная защита перед предрегулятором LTC3780) — см.
  `docs/power-distribution.md` и `docs/bom/stage1_control.md`.
- **Тип — ЗАДАН:** **FH10-S-MZ** — держатель предохранителя **5×20 мм на панель**
  (винтовой колпачок), встраивается в отверстие панели с гайкой.
- **Посадочное:** отверстие **Ø12.8 мм** — в `Mechanical/params.py`
  (`FUSE_HOLE_D=12.8`, **TBD по факту детали**).
- **Положение:** `FUSE_CENTER_X=47.0`, `FUSE_CENTER_Z=25.0` — **рядом с разъёмом
  внешнего питания** (справа от него, в 22 мм).

---

## 5. Статус

| Пункт | Состояние |
|---|---|
| Задняя крышка (модель) | готово (`back_cover.FCStd`, 186×56, язычки) |
| Антенный разъём BNC | **отверстие Ø9.5 внесено** (`ANT_HOLE_D=9.5`, X=155, Z=25, справа) |
| Разъём внешнего питания | **отверстие Ø8.0 внесено** (`PWR_CONN_HOLE_D=8.0`, X=25, Z=25, слева) |
| Держатель предохранителя FH10-S-MZ | **отверстие Ø12.8 внесено** (`FUSE_HOLE_D=12.8`, X=47, Z=25, рядом с питанием) |
| Посадочные Ø (DC/предохранитель) | ⚠️ TBD — замерить по факту деталей и обновить `params.py` |
