okunevpy-create/TRX_27MHz/docs/power_cleanup_plan.md

# План чистки питания — `01_control` (сессия «переразводка питания»)

## Цель
Привести секцию питания платы управления (`KiCad/01_control/01_control.kicad_sch`)
в соответствие с BOM и финальными решениями пользователя, устранить
короткозамкнутые развязочные конденсаторы, добавить недостающие элементы
(VDDA, F10, L3, R_si) и выровнять refdes/значения. **Только schematic — PCB не трогать.**
Плату этапа 1 не травить/монтировать (запрет до 1.5+2.3 и фиксации `control_pa.md`).

## Финальные решения (согласованы с пользователем — НЕ переспрашивать)
1. **VCAP2 отсутствует.** `MCU_ST_STM32F4:STM32F411CEUx` имеет единственный VCAP
   (pin 22 = VCAP1, `power_out`). → **C17b удалить из BOM**, VCAP1 = **C22 (2.2 мкФ)**.
2. **F10 (R_si) топология:** `U3 OUT → C7(10мкФ) → GND`, затем
   `+3V3_SI → R_si(10Ω) → +3V3_SI_F`, локально `C21(1мкФ)+C18(100нФ)+C19(100нФ) → GND`.
   Выходной конденсатор U3 (C7) стоит **до** R_si.
3. **Тантал C6 убирается.** RT9193 требует керамику 1–10 мкФ на выходе; тантала нет
   на складе; правило 0603. C6 = **10 мкФ 10В X7R** (керамика).
4. **Ферриты L2 и L3:** BLM21SP181SN1D → **MMZ2012R601AT000** (0805, 600Ω@100МГц).

## Наличие номиналов (сверено по складу)
- `Stock/capacitors_ 0603.csv`: **10 мкФ в 0603 НЕТ** (ряд до 2.2 мкФ). Есть: 1 мкФ/10В/X7R,
  100 нФ/25В/X7R, 2.2 мкФ/6.3В/X7R, 10 нФ/25В/X7R.
- Правило для 10 мкФ: приоритет 0603; номинала нет → **0805**
  `C_0805_2012Metric_Pad1.15x1.40mm_HandSolder` (или 1206 `C_1206_3216Metric_...`).
- `Stock/resistance_0603.csv`: **10Ω есть** (R_si), 10к/4.7к есть.

## Финальная таблица конденсаторов
| Ref | Значение | Назначение | Корпус |
|-----|---|---|---|
| C1 | 1000 мкФ/25В | VIN_PROT (электролит) | CP_Elec_12.5x13 |
| C2 | 100 нФ | VIN_PROT (вход) | 0603 |
| C3 | 470 мкФ/16В | +5V (электролит) | CP_Elec_8x10.2 |
| C4 | 10 мкФ 10В X7R | +5V bulk | **0805** |
| C5 | 1 мкФ 10В X7R | вход U2 (после L3, +5V) | 0603 |
| C6 | 10 мкФ 10В X7R | выход U2 = +3V3 | **0805** |
| C7 | 10 мкФ 10В X7R | выход U3 = +3V3_SI | **0805** |
| C8 | 100 нФ | вход U3 = +5V_SI | 0603 |
| C9,C10 | 20 пФ | кварц | 0603 |
| C11–C16 | 100 нФ | развязка +3V3 MCU | 0603 |
| C18,C19 | 100 нФ | Si5351 | 0603 |
| C20 | 100 нФ | VDDA | 0603 |
| C21 | 1 мкФ 10В X7R | F10 (`+3V3_SI_F`) | 0603 |
| C22 | 2.2 мкФ | VCAP1 (U4:22) | 0603 |
| C23 | 10 нФ | BP U2 (bypass) | 0603 |
| C24 | 10 нФ | BP U3 (bypass) | 0603 |
| C25 | 1 мкФ 10В X7R | VDDA (2-й) | 0603 |

### Резисторы / ферриты
| Ref | Значение | Назначение |
|-----|---|---|
| R1 | 10 к | BOOT0 pull-down |
| R2 | 10 к | NRST pull-up |
| R3,R4 | 4.7 к | I2C pull-up |
| R5 (=R_si) | 10 Ω | F10 последовательно (НОВЫЙ) |
| L1 | 33 мкГн | DC-DC |
| L2 | **MMZ2012R601AT000** (600Ω@100МГц, 0805) | +5V → +5V_SI → U3 IN |
| L3 | **MMZ2012R601AT000** (600Ω@100МГц, 0805) | +5V → U2 IN (НОВЫЙ) |

## Целевая топология питания
```
+12V_IN → F1 → VIN_F → D1(TVS→GND) + D2(анод)
D2(катод) → VIN_PROT → C1(+)+C2(+) → GND; U1 VIN
U1 OUT → SW_OUT → L1 → +5V; D3(SW_OUT→GND)
+5V → C3+C4 → GND
+5V → L3(MMZ2012R601) → U2 IN; C5(1мкФ) на входе U2
U2 OUT → +3V3 → C6(10мкФ) → GND
+5V → L2(MMZ2012R601) → +5V_SI → U3 IN; C8(100нФ) на входе U3
U3 OUT → +3V3_SI → C7(10мкФ) → GND
+3V3_SI → R_si(10Ω, refdes R5) → +3V3_SI_F
   └─ C21(1мкФ)+C18(100нФ)+C19(100нФ) → GND; R3/R4 → I2C; U5:1, U5:7
+3V3: C11–C16(100нФ), C20(VDDA 100нФ)+C25(VDDA 1мкФ), U4 VDD/VDDA
VCAP1 = C22 (2.2мкФ) → U4:22
BP U2 = C23 (10нФ), BP U3 = C24 (10нФ)
```

## Изменения refdes
- `C20` (10нФ BP U2) → **C23**; `C21` (10нФ BP U3) → **C24**.
- Освободившиеся `C20` = VDDA 100нФ, `C21` = F10 1мкФ.
- Добавить: `C25` = VDDA 1мкФ, `R5` = R_si 10Ω, `L3` = феррит.
- Удалить: старый `C17` (1мкФ, КЗ). VCAP1 = `C22` (C17b удалить из BOM).

## Текущие КЗ (ERC не видит; подтверждено connectivity graph)
- **C2** — оба пина GND → pin1 должен быть `VIN_PROT`.
- **C11/C12/C13** — оба пина `+3V3` → pin2 должен быть GND.
- **C15/C16** — оба пина GND → pin1 должен быть `+3V3`.
- C14 корректен (+3V3/GND).

## Порядок работ
1. Переименовать `C20→C23`, `C21→C24` (`sch_update_properties`, поле Reference).
2. Удалить старый `C17` (1мкФ, КЗ).
3. Снять КЗ: C2 pin1→`VIN_PROT`; C11/C12/C13 pin2→GND; C15/C16 pin1→`+3V3`.
4. Значения/рельсы: C4→10мкФ(0805), C5→1мкФ на вход U2 (+5V), C6→10мкФ(0805) на +3V3,
   C7→10мкФ(0805) на +3V3_SI, C8→+5V_SI (вход U3).
5. Добавить VDDA: `C20`(100нФ)+`C25`(1мкФ) на U4 pin9 (+3V3).
6. Добавить F10: `R5`(10Ω) последовательно + `C21`(1мкФ) на `+3V3_SI_F`;
   C18/C19/R3/R4/U5 — на фильтрованную сторону.
7. Добавить `L3` (MMZ2012R601AT000) +5V→U2 IN; обновить value `L2` → MMZ2012R601AT000.
8. Проверка: `sch_get_connectivity_graph` (нет КЗ) + `run_erc`.
   Бороться с наложениями (`sch_visual_qa`; игнорировать ложный ~6.5мм² на power-на-пине).
9. Обновить `docs/context.md` и `docs/bom/stage1_control.md`; коммит `hw:`.

## Подводные камни
- **ERC не ловит короткие пассивы** — проверять по `sch_get_connectivity_graph` + `sch_get_wires`.
- **U2/U3 не резолвятся в connectivity graph / pin positions** (MCP не резолвит координаты
  пинов `trx_custom`). Выводить пины по `lib_get_symbol_info` (1 IN, 2 GND, 3 EN, 4 BP, 5 OUT)
  + координатам соседних power-символов/проводов; не полагаться на граф для U2/U3.
- Пины 2-выводных пассивов (`Device:C`/`C_Polarized`/`FerriteBead`) rot=0: pin1 сверху = y−3.81,
  pin2 снизу = y+3.81.
- Требование: **никаких наложений** символов/полей/текста — проверять после вставок.

## Статус выполнения (сессия MCP)
✅ **Сделано (через MCP, проверено по connectivity graph + ERC):**
1. Все КЗ сняты: C2 → VIN_PROT/GND; C11/C12/C13 → +3V3/GND; C15/C16 → +3V3/GND.
2. Удалён старый C17 (КЗ) + 2 осиротевших GND-символа (#PWR52, #PWR63425).
3. Переименованы BP-конденсаторы: C20→C23 (BP U2), C21→C24 (BP U3).
4. Значения: C4=10мкФ(0805), C5=1мкФ(0603, +5V), C6=10мкФ(0805, +3V3), C7=10мкФ(0805),
   L2=MMZ2012R601AT000.
5. C6 переведён из тантала (C_Polarized) в керамику (Device:C).
6. Рельсы: C5 → +5V (вход U2), C8 → +5V_SI (вход U3).
7. Добавлены VDDA: **C20 = 100нФ**, **C25 = 1мкФ** (на +3V3, рядом с U4 pin 9).

✅ **Сделано (сессия MCP-продолжение — проверено по connectivity graph + ERC):**
8. **L3** — феррит MMZ2012R601AT000 последовательно `+5V → U2 IN` (нов. узел `U2_IN`);
   C5 перенесён на `U2_IN`. (Сделано пользователем в GUI, проверено MCP.)
9. **PWR_FLAG на `U2_IN`** — добавлен (снимает ERC `power_pin_not_driven` U2:1).
10. **Refdes BP-конденсаторов фактически зафиксированы:** `C21→C24` (BP U3),
   `C20(BP U2)→C23`; `C20` остаётся VDDA (100нФ).

✅ **Сделано (сессия F10 — проверено по connectivity graph + ERC):**
11. **R5 (=R_si) 10Ω** добавлен последовательно `+3V3_SI → R5 → +3V3_SI_F`;
    **C21 (1мкФ, F10)** добавлен на `+3V3_SI_F` (pin2 → GND).
12. **Цепь `+3V3_SI_F`** сформирована: C18/C19/C21/R3/R4/R5:2/U5:1/U5:7;
    `+3V3_SI` = C7/U3 OUT/R5:1.
13. **PWR_FLAG на `+3V3_SI_F`** — добавлен (снимает ERC `power_pin_not_driven` U5:1).
14. **C22** — символ уже `Device:C` (неполярная керамика 2.2мкФ) — подтверждено.

⏳ **Осталось (мелочь, не блокирует):**
- Сдвинуть C5 вниз (~2.54 мм), чтобы убрать наложение C5/L3 (~1 мм²).

### Финальный ERC: 43 error + 4 warning (только отложенное до 1.5 — 15 интерфейсных
меток + 28 свободных GPIO MCU + 4 предупреждения I/Q, VFO_RAW/BFO_RAW).
