okunevpy-create/TRX_27MHz/Stock/surplus_stage1.md

# Излишки — Этап 1 (01_control)

Дата оценки: 2026-11-04. Источники: `docs/bom/stage1_control.md` (потребность),
`Stock/ChipDipCart-Stage_1.csv`, `Stock/ChipDipCart-Stage_1.1.csv`,
`Stock/DKO.csv`, Ozon-заказ, склад 0603 (`Stock/*.csv`).

## Итог
Этап 1 обеспечен полностью — **дефицита нет**. Ниже — излишки/резерв (заказано
сверх потребности или снято со схемы).

## Излишки (таблица)

| Позиция | Кол-во | Источник | Причина |
|---|---|---|---|
| 74HC74D,653 (D-триггер SO-14) | 1 | `Stock/ChipDipCart-Stage_1.csv` | U6 удалён (I/Q-квадратура — балласт) |
| SMBJ18A (TVS) | 1 | `Stock/ChipDipCart-Stage_1.csv` | D1 снят (защита перенесена на корпус) |
| Кварц 8 МГц HC-49SM | 1 | `Stock/ChipDipCart-Stage_1.csv` | Y1 удалён (MCU на HSI) |
| Предохранитель 3 А 5×20 (522.1300) | 2 | `Stock/ChipDipCart-Stage_1.csv` | F1 снят с платы; корпус — 5 А |
| MMZ2012R601AT000 (феррит 0805) | 2 | Stage_1 ×2 + Stage_1.1 ×2 + DKO ×1 = 5 | нужно 3 (L2/L3/L4) → излишек 2 |
| BC507-040 (держатель 5×20) | 1 | `Stock/ChipDipCart-Stage_1.csv` | перенесён на корпус (этап 4), на плате этапа 1 не ставится |

## Примечания
- Тумблеры: питание — `KN3(B)-101A-A1` ×1; LIMIT/FULL — `ASW-14-102` (из
  `Stock/ChipDipCart-Stage_2.csv`). В `Stock/ChipDipCart-Stage_1.1.csv`
  `KN3(B)-101A-A1` ×2 → 1 = тумблер питания, 1 = запас (излишек).
- `WJ127R-5.0-02P` (клеммник 2P 5.0 мм) ×2 — закрывает J_12V_IN_1 (этап 1) и
  J_PA_PWR_1 (этап 2); для J_RXTX_PWR_1 (этап 3) понадобится ещё 1 шт.
- Склад 0603 (`Stock/resistance_0603.csv`, `Stock/smd_resistors_0603.csv`,
  `Stock/capacitors_ 0603.csv`) покрывает все номиналы 0603 этапа 1 (10 мкФ — 0805).
