okunevpy-create/TRX_27MHz/Stock/surplus_stage2.md

# Излишки — Этап 2 (02_power_amp)

Дата оценки: 2026-11-04. Источники: `docs/bom/stage2_power_amp.md` (потребность),
`Stock/ChipDipCart-Stage_2.csv`, `Stock/DKO.csv`, `Stock/ChipDipCart-Stage_1.1.csv`.

## Итог
Этап 2 обеспечен полностью — **дефицита нет**. Ниже — излишки/резерв (заказано
сверх потребности или заменено).

## Излишки (таблица)

| Позиция | Кол-во | Источник | Причина |
|---|---|---|---|
| Конденсатор 120 пФ C0G 100 В (0805) | 8 | `Stock/ChipDipCart-Stage_2.csv` (×10) | нужно 2 (C6, C8) |
| Конденсатор 220 пФ C0G 100 В (0805) | 4 | `Stock/ChipDipCart-Stage_2.csv` (×5) | нужно 1 (C7) |
| LM358 SOP-8 | 1 | `Stock/ChipDipCart-Stage_2.csv` (×2) | нужно 1 (U1, I_sense) |

## Примечания
- Тумблер LIMIT/FULL — `ASW-14-102` ×1 (`Stock/ChipDipCart-Stage_2.csv`) — используется, не излишек. Тумблер питания — `KN3(B)-101A-A1` ×1; второй KN3 из дозаказа — запас (см. `surplus_stage1.md`).
- 2N7002: в `Stock/ChipDipCart-Stage_2.csv` фактически **×3** (Q3/Q4/Q5) — ровно
  по потребности; в тексте BOM местами осталось устаревшее «×2» (править на ×3).
- FH10-S-MZ (панельный держатель 5×20) ×1 — на корпус (этап 4), не на плату этапа 2.
- Покрытие ровно (без излишков): RD16HHF1-501 ×2, BN-61-202 ×3, T50-6 ×2,
  T68-2 ×1, IM06GR ×1, PA2512 ×1, 3296W ×1, BAT54 ×2, 1N4148WS ×3,
  втулки изолирующие ×2, радиатор HS 104-30 ×1.
