okunevpy-create/TRX_27MHz/docs/front_panel_elements.md

# Передняя панель — размещаемые элементы (зафиксировано)

Документ фиксирует **что именно** вынесено на переднюю панель корпуса и
**откуда это взялось**. Разделён на две части: заложенное в проекте
(контракты/README этапов) и добавленное решением по корпусу — с явным
указанием, что требует доработки прошивки/разводки.

Геометрические параметры — в [`Mechanical/params.py`](../Mechanical/params.py).

---

## 1. Заложено в проекте (документировано ранее)

| Элемент | Источник | Статус |
|---|---|---|
| Экран OLED / ST7789 | `01_control` README (1.4 UI), `docs/kicad_task_stage1.md` (J_OLED_1, F12) | ✅ разводка есть |
| Энкодер | `01_control` README (1.4 UI), J_ENC_1 | ✅ разводка есть |
| Джойстик 5-позиционный | `01_control` (J_BTN_1: BTN_UP/DOWN/LEFT/RIGHT/PUSH) | ✅ разводка есть |
| **Кнопка RIT** | `docs/contracts/control_rxtx.md` — «отдельная кнопка RIT» | ✅ цепь BTN_RIT в J_BTN_1 |
| Гарнитура Kenwood 2-pin 3.5 + 2.5 мм | `docs/contracts/control_rxtx.md`, «Разъёмы — на корпусе (передняя панель)» | ✅ пады на платах |

---

## 2. Добавлено решением по корпусу — ТРЕБУЕТ ДОРАБОТКИ

### 2.1. Светодиодная индикация PWR / TX / LIM — ✅ ЗАЛОЖЕНА (дубль на плате + power-good)

**Решение (2026-10-30):** каждый панельный LED дублируется SMD-LED на плате;
дополнительно добавлены «power-good» LED после LDO. Полная схема и номиналы —
[`docs/led_debug_scheme.md`](../led_debug_scheme.md); BOM обновлён
(`stage1_control.md` §1.6, `stage2_power_amp.md` §2.5).

| LED (панель) | Смысл | Откуда сигнал | Дубль на плате |
|---|---|---|---|
| PWR | питание включено | `+5V` | **D4** (`01_control`) |
| TX | передача | `PTT` | **D5** (`01_control`) |
| LIM | ограничитель активен | узел ограничителя УМ | **D_lim_b** (`02_power_amp`) |

**Power-good (только на плате):** `D6` (`+3V3`, U2), `D7` (`+3V3_SI`, U3),
`D8` (`+3V3_DISP`, U9) на `01_control`; `D_pa_pwr` (`+12V_PA`) на `02_power_amp`.

**Реализация:** новых GPIO MCU **не требуется** (PWR/питание — на шине, TX —
с `PTT`, LIM — с узла ограничителя). Панельные PWR/TX — разъём `J_LED_1`
(XH2.54 3-pin) на `01_control`; панельный LIM — существующий `J_LIM_LED_1` на
`02_power_amp`. Токоограничивающие резисторы — на платах (0603).

### 2.2. Разъёмы гарнитуры — уточнение

Контракт говорит «на корпусе (передняя панель)», но **между пунктами
контракта есть противоречие**: фраза «MIC, PTT → пады на `01_control` →
корпусной разъём 2.5 мм» не указывает сторону панели.

**Зафиксировано решением по корпусу:** оба разъёма — на **передней** панели,
в зазоре между экраном и энкодером, вертикально (3.5 сверху, 2.5 снизу).

**Риск:** провод гарнитуры будет свисать спереди через экран и энкодер.
Если окажется неудобно — перенос на заднюю панель это правка одного
параметра (`HS_CENTER_X/Y`), геометрия пересоберётся.

### 2.3. Тумблер питания KN3(B)-101A-A1 — ✅ РЕШЕНО (в разрыв +12V)

**Добавлено:** тумблер ON-OFF (10A 250VAC, SPST, 2 вывода), крепление гайкой
на резьбу M12×0.75 (отверстие Ø12.2). Размещён справа (вместо светодиодов),
светодиодная колонка смещена левее.

**Решение:** тумблер включается **в разрыв +12V** между DC-джеком
`KLS1-DC-025A-2.0` (задняя крышка) и клеммником `J_12V_IN_1` на `01_control`;
отдельного разъёма на плате не требуется, GND идёт напрямую.

### 2.4. Тумблер LIMIT/FULL (ограничитель AM) — ⚠️ ДОБАВЛЕН (этап 2)

**Источник:** контракт `docs/contracts/control_pa.md` («физический тумблер
SPDT/DPDT на `02_power_amp`»), BOM `docs/bom/stage2_power_amp.md` (§2.3).

**Решение:** тумблер LIMIT/FULL (**ASW-14-102**, ON-ON, SPDT 3P, 20A 12VDC) выносится **на корпус
(переднюю панель)** — рядом с тумблером питания / светодиодами. На плате
`02_power_amp` — только разъём XH2.54 под проводной монтаж (3 цепи тумблера).

**Смысл положений:** LIMIT (по умолчанию) — ограничитель AM активен (4 Вт
несущей), FULL — полная мощность (12 Вт PEP, SSB). Обратная связь положения —
`PWR_LIMIT_SW` (читается MCU).

**Что требуется:**
1. **Раскладка панели** — добавить 7-й элемент (пересчитать равный шаг
   «экран → край»: сейчас 6 элементов, станет 7). ✅ **ВЫПОЛНЕНО (2026-11-03):**
   тумблер LIMIT/FULL добавлен в `params.py` (7 элементов, X≈154.6).
2. **Схема `02_power_amp`** — контактные пады/разъём под тумблер (KiCad-сессия
   `docs/kicad_task_stage2.md`).
3. **BOM** — тумблер **ASW-14-102** (ON-ON, SPDT 3P, 20A 12VDC) — **заказан**.

---

## 2.5. Светодиод LIMIT (этап 2)

**Источник:** BOM `docs/bom/stage2_power_amp.md` (§2.3, `D_lim`). Ранее светодиод
был на плате `02_power_amp`; решено перенести **на переднюю панель** (тот же
индикатор LIMIT, что в колонке PWR/TX/LIM, §2.1).

**Решение:** светодиод LIMIT (красный, 3 мм THT) — **на передней панели**. На
плате `02_power_amp` — разъём **J_LIM_LED_1 (XH2.54 2-pin)** под проводной
монтаж + **дубль на плате `D_lim_b`** (0805 SMD, через `R_led_b`);
резистор-ограничитель панельного `R_led` (0603) остаётся на плате.

**Статус:** DEFERRED (корпус, заказ на этапе 4). Контракт `control_pa.md`
обновлён (2026-10-29): «Индикация: светодиод LIMIT — на передней панели; на
плате `02_power_amp` — только разъём `J_LIM_LED_1`».

## 3. Раскладка (итог)

| Элемент | X (центр) | Z (центр) | Посадочный размер |
|---|---|---|---|
| Гарнитура 3.5 мм | 14.0 | 32.0 | Ø6.2 + цековка Ø9 |
| Гарнитура 2.5 мм | 14.0 | 17.0 | Ø4.2 + цековка Ø7 |
| Экран | 50.0 | 25.0 | окно 42.4 × 32.2 + 4 стойки M3 |
| Джойстик | 92.0 | 25.0 | Ø8.2 + 4 стойки M2 |
| Кнопка RIT | 112.0 | 25.0 | Ø12.2 + цековка Ø16 |
| Энкодер | 132.0 | 25.0 | плата 26×18, 2 стойки M2 в линию |
| Тумблер LIMIT/FULL | 154.0 | 25.0 | Ø12.2 + цековка Ø16 (TBD) |
| Тумблер питания | 172.0 | 25.0 | Ø12.2 + цековка Ø16 |
| LED PWR | 92.0 | 42.0 | Ø3.2 + цековка Ø5.2 |
| LED TX | 112.0 | 42.0 | Ø3.2 + цековка Ø5.2 |
| LED LIM | 132.0 | 42.0 | Ø3.2 + цековка Ø5.2 |

Порядок слева направо: **гарнитура → экран → джойстик → кнопка RIT → энкодер →
тумблер LIMIT/FULL → тумблер питания**. Светодиоды — **горизонтальной линией
наверху**, выровнены по центрам с органами управления (джойстик/RIT/энкодер).
Координаты — `params.py` (секции 4/4a/8).

> ⚠️ Тумблер LIMIT/FULL добавлен (2026-11-03), посадочное Ø12.2 — «по типу»
> тумблера питания, **TBD по факту детали** (ASW-14-102).
> Энкодер: плата модуля **26×18×22 мм** (факт), вал **смещён от центра платы на
> 4 мм по УЗКОЙ стороне (Z), ОТ края с отверстиями**, 2 монтажных отверстия
> **по углам вдоль широкой стороны** (26 мм), `params.py` секция 5
> (`ENC_SHAFT_DZ`, `ENC_HOLES_DX/Z`).
> Компоновка (2026-11-03): гарнитура — **левее всех** (длинный провод);
> органы управления сдвинуты **к экрану**; тумблеры — справа; джойстик выровнен с LED_PWR.

Валидация раскладки (перекрытия, выход за контур) — `params.sanity_check()`.

---

## 4. Статус

| Пункт | Состояние |
|---|---|
| Геометрия панели | готово (186 × 13.4 × 56, STEP чистый) |
| Наружная галтель | **сделана** (`OUTER_FILLET = 2.0`, кромка «лицо → стенки») |
| Внутреннее скругление | отключено (`BASIN_FILLET = 0.0`) — отдельная задача |
| Решение по LED | **заложено**: дубль на плате + power-good (см. `docs/led_debug_scheme.md`) |
| Тумблер LIMIT/FULL | **добавлен (этап 2), раскладка требует пересчёта** |
| Контракты | **без изменений** (LED не меняют межблочные сигналы) |
| BOM `01_control` | **обновлён** (§1.6, отладочные LED) |

Наружная галтель по периметру лицевой стороны реализована
(`makeFillet` по простой призме ДО выреза полости) — STEP чистый, BOP check
CLEAN. Подробности — [`Mechanical/README.md`](../Mechanical/README.md).
