okunevpy-create/TRX_27MHz/docs/session_prompt_F3_F13.md

# Промт для новой KiCad-сессии: F3–F13 (`01_control`)

> Самодостаточный промт. Вставляй целиком в **новый диалог** (контекст сброшен).
> Ты — агент с доступом к KiCad MCP. Работаешь по шагам, ничего не перескакивая.

## 0. Проект и файл

- Активный проект: **`KiCad/01_control`** (путь `D:\Sources\git-hub\OkunevPY\TRX_27MHz\KiCad\01_control`).
- Целевой файл схемы: **`01_control.kicad_sch`**.
- Перед началом: прочитай `docs/context.md`, `docs/bom/stage1_control.md`, `docs/contracts/control_pa.md`, `docs/contracts/control_rxtx.md`.
- Убедись через `kicad_set_project`, что активен именно `01_control` (не `00_master`).

## 1. Правила (КРИТИЧНО, не нарушать)

1. Файлы `.kicad_sch` / `.kicad_pro` / `.kicad_pcb` править **ТОЛЬКО через KiCad MCP-инструменты**. `write_file`/`edit_file`/`str_replace` на них **запрещены**.
2. Не редактировать один файл параллельно. Одна MCP-операция → перечитать → следующая. Не запускать параллельные KiCad-вызовы.
3. **Не запускать `sch_annotate`** — он перенумерует уже зафиксированные refdes.
4. **Никаких наложений** символов/полей/текста/проводов (§6 AGENTS.md). Перед вставкой смотри `sch_get_bounding_boxes`/`sch_find_free_placement`, после — `sch_visual_qa` (игнорируй ложное ~6.5 мм² «power-на-пине»).
5. Корпуса пассивов: **0603** (Metric 1608) + **HandSolder**-вариант футпринта. Исключения (осознанные): ферриты и электролиты — SMD; 10 мкФ в 0603 нет → **0805** `C_0805_2012Metric_Pad1.15x1.40mm_HandSolder`.
6. Пины 2-выводных пассивов (`Device:C`/`C_Polarized`/`FerriteBead`) при rot=0: **pin1 сверху = y−3.81 мм**, pin2 снизу = y+3.81 мм (НЕ ±2.54).
7. Питание (+5V/+3V3/+3V3_SI/+3V3_DISP) и GND соединять **глобальными метками** (MCP не добавляет power-символы для `trx_custom`). Это электрически эквивалентно. Для «горячих» цепей, которые ERC помечает `power_pin_not_driven`, ставь **`PWR_FLAG`** (символ `power:PWR_FLAG`).
8. Не трогай `sym-lib-table`/`fp-lib-table`. Символ **`trx_custom:RT9193-33`** резолвится, цоколёвка: **1=IN, 2=GND, 3=EN, 4=BP, 5=OUT**.
9. Имена межблочных сигналов НЕ менять: `VFO`, `BFO`, `I`, `Q`, `PTT`, `MIC_LINE`, `MUTE`, `RX_audio`, `+12V_PA`, `+12V_RXTX`, `PWR_LIMIT_EN`, `PWR_LIMIT_SW`, `I_sense`, `SWR_sense`.

## 2. Текущее состояние (УЖЕ СДЕЛАНО — НЕ переделывать)

Секция питания `01_control` **полностью завершена и согласована**. ERC-базовая линия: **43 error + 4 warning** — всё «отложенное до 1.5» (15 интерфейсных меток, 28 свободных GPIO MCU, I/Q, VFO_RAW/BFO_RAW). Новых КЗ/`power_pin_not_driven` по питанию нет.

**Фиксированная таблица refdes (заняты):**

| Ref | Значение / назначение |
|-----|---|
| C1 | 1000 мкФ/25В (VIN_PROT, электролит) |
| C2 | 100 нФ (вход) |
| C3 | 470 мкФ/16В (+5V, электролит) |
| C4 | 10 мкФ (+5V bulk, 0805) |
| C5 | 1 мкФ (вход U2, после L3) |
| C6 | 10 мкФ (выход U2 = +3V3, 0805) |
| C7 | 10 мкФ (выход U3 = +3V3_SI, 0805) |
| C8 | 100 нФ (вход U3 = +5V_SI) |
| C9,C10 | 20 пФ (кварц) |
| C11–C16 | 100 нФ (развязка MCU) |
| C18,C19 | 100 нФ (Si5351) |
| C20 | 100 нФ (VDDA) |
| C21 | 1 мкФ (F10, +3V3_SI_F) |
| C22 | 4.7 мкФ (VCAP, U4:22) |
| C23 | 10 нФ (BP U2) |
| C24 | 10 нФ (BP U3) |
| C25 | 1 мкФ (VDDA 2-й) |
| R1 | 10 к (BOOT0 pull-down) |
| R2 | 10 к (NRST pull-up) |
| R3,R4 | 4.7 к (I2C pull-up) |
| R5 | 10 Ом (= R_si, F10) |
| L1 | 33 мкГн (DC-DC) |
| L2 | MMZ2012R601AT000 (0805, +5V→+5V_SI→U3 IN) |
| L3 | MMZ2012R601AT000 (0805, +5V→U2 IN) |
| U1 | LM2596S-5 (DC-DC) |
| U2,U3 | RT9193-33 (LDO) |
| U4 | STM32F411CEU6 (MCU) |
| U5 | Si5351A-B-GTR |
| U6 | 74HC74 (3 юнита A/B/PWR) |
| D1,D2,D3 | TVS / Шоттки |
| Y1,Y2 | кварцы |
| J_SWD,J_UART | PinHeader 2.54 (ОСТАВИТЬ) |

**Уже выполненные F:** F1 (U1 TO-263-5), F2 (U2/U3 RT9193), F8 (электролиты SMD), F9 (L2/L3 = MMZ2012R601AT000), F10 (R5 + C21). **C17 (VCAP/VDCA) удалён; VCAP2 отсутствует (UFQFPN-48 — один VCAP).** **VCAP C22 = 4.7 мкФ** (0603, X7R, ≥6.3 В — рекомендовано для одного VCAP). Если в схеме значение ещё 2.2 мкФ — обновить через `sch_modify_property` (C22 → Value = «4.7 мкФ»). Допустимая альтернатива: 2.2 мкФ + 100 нФ параллельно.

## 3. Задачи сессии (F3–F13, по порядку)

После каждой вставки — перечитать элемент через MCP и проверить наложения.

### F3 — U7: LM358DR (SOIC-8)
- Символ: `Amplifier_Operational:LM358` (unit A; unit B — не используется).
- Footprint: `Package_SO:SOIC-8_3.9x4.9mm_P1.27mm_HandSolder`.
- Unit B: оба входа на GND, выход — NC (no-connect). Питание unit A/B общее (+3V3 / GND).
- Полную обвязку MIC-предусилителя (R_bias/R_in/R_fb/R_g/C_cpl) делать **НЕ здесь** — это 1.4.

### F4 — U6: 74HC74D (проверка цоколёвки)
- Символ `74xx:74HC74`, footprint `Package_SO:SOIC-14_3.9x8.7mm_P1.27mm` — оставить.
- Сверить цоколёвку со стандартом: 1=1CLR, 2=1D, 3=1CLK, 4=1PRE, 5=1Q, 6=1/Q, 7=GND, 8=2/Q, 9=2Q, 10=2PRE, 11=2CLK, 12=2D, 13=2CLR, 14=VCC. Отклонение — зафиксировать в отчёте.

### F5 — разъёмы → XH2.54 (угловые)
| Ref | Пины | Footprint |
|---|---|---|
| J_OLED | 8 | `Connector_JST:JST_XH_B8B-XH-A_1x08_P2.54mm_Vertical` (или `..._Horizontal` по монтажу) |
| J_ENC | 5 | `JST_XH_B5B-XH-A_1x05_P2.54mm_*` |
| J_BTN | 7 | `JST_XH_B7B-XH-A_1x07_P2.54mm_*` |
| J_PA_CTRL | **6** | `JST_XH_B6B-XH-A_1x06_P2.54mm_*` |
| J_RXTX_SIG | **10 (ОДИН, не 2×5)** | `JST_XH_B10B-XH-A_1x10_P2.54mm_*` |

Нет `Horizontal`-варианта XH — брать `Vertical` и зафиксировать.

### F5b — J_SWD / J_UART: НЕ МЕНЯТЬ (PinHeader 2.54, осознанное решение).

### F6 — J_PA_PWR / J_RXTX_PWR → клеммник 2-pin 5.0 мм (угловой)
- Footprint: `TerminalBlock_*:...1x02_P5.00mm_Horizontal` — подобрать ближайший (например `TerminalBlock_Phoenix:TerminalBlock_Phoenix_MKDS-1.5-2_1x02_P5.00mm_Horizontal`), зафиксировать выбор.
- Сигналы: `+12V_PA`/GND и `+12V_RXTX`/GND.

### F7 — U8: 74AC541SC (SOIC-20) + буферы VFO/BFO/IQ
- Символ `74xx:74AC541`; footprint `Package_SO:SOIC-20W_7.5x12.8mm_P1.27mm` (HandSolder при наличии).
- R_buf ×4 = **R19–R22** (22–47 Ом, 0603); C_buf ×1 = **C38** (100 нФ, 0603) у Vcc.
- Разводка:

| Банк | Буфер | Вход | Выход | OE |
|---|---|---|---|---|
| 1 | A1 | `VFO_RAW` (от U5 CLK1) | `VFO_OUT` через R_buf | 1OE → GND |
| 1 | A2 | `BFO_RAW` (от U5 CLK0) | `BFO_OUT` через R_buf | 1OE → GND |
| 1 | A3, A4 | **GND** | NC | 1OE → GND |
| 2 | A5 | `I` (от U6 Q1) | `I_OUT` через R_buf | 2OE → `IQ_EN` |
| 2 | A6 | `Q` (от U6 /Q2) | `Q_OUT` через R_buf | 2OE → `IQ_EN` |
| 2 | A7, A8 | **GND** | NC | 2OE → `IQ_EN` |

- `IQ_EN` — GPIO MCU (активный низкий), локальный, в межплатный разъём не выходит.
- Неиспользуемые входы (A3/A4/A7/A8) — **обязательно на GND** (AC-family не терпит висящих входов).

### F11 — U9: RT9193-33 (LDO дисплея) + развязка
- Символ `trx_custom:RT9193-33`, footprint `Package_TO_SOT_SMD:SOT-23-5` (как U2/U3).
- Вход от **+5V**, выход **+3V3_DISP** (только для J_OLED). EN → IN (всегда вкл), GND → GND.
- Развязка: **C26 = 1 мкФ (вход, 0603)**, **C27 = 10 мкФ (выход, 0805)**, **C28 = 10 нФ (BP, 0603)** — ровно как блок U2 (C5/C6/C23).

### F12 — J_OLED (8-pin) + именованные цепи
`J_OLED` (уже добавлен в F5) — раскладка:
| Пин | Сигнал | Цепь |
|---|---|---|
| 1 | VCC | `+3V3_DISP` (от U9) |
| 2 | GND | GND |
| 3 | SCK | `SPI_SCK` |
| 4 | MOSI | `SPI_MOSI` |
| 5 | CS | `SPI_CS` |
| 6 | DC/RS | `SPI_DC` |
| 7 | RST | `LCD_RST` |
| 8 | BLK | `LCD_BLK` |

Отдельный символ модуля (U10) не нужен — модуль на корпусе, на плате только разъём `J_OLED`.

### F13 — RC-фильтры UI (ОБЯЗАТЕЛЬНО)
| Назначение | Refdes | Значение | Кол-во |
|---|---|---|---|
| Pull-up J_BTN ×6 | R6–R11 | 10 кОм | 6 |
| Фильтр J_BTN ×6 | C29–C34 | 100 нФ | 6 |
| Pull-up J_ENC ×3 (CLK/DT/SW) | R12–R14 | 10 кОм | 3 |
| Фильтр J_ENC ×3 | C35–C37 | 100 нФ | 3 |
| Последоват. SPI OLED ×4 | R15–R18 | 22 Ом | 4 |

Схема на линию кнопки/энкодера:
```
+3V3 ── R_pu 10к ──┬── линия разъёма (кнопка замыкает на GND)
                   ├── C 100нФ ── GND
                   └── пин MCU
```
SPI-линии дисплея: R 22 Ом последовательно в SCK, MOSI, CS, DC. RST и BLK — без резистора.

## 4. Рекомендованная карта новых refdes (сводно)

| Диапазон | Что |
|---|---|
| C26 | 1 мкФ — вход U9 |
| C27 | 10 мкФ (0805) — выход U9 |
| C28 | 10 нФ — BP U9 |
| C29–C34 | 100 нФ ×6 — фильтры J_BTN |
| C35–C37 | 100 нФ ×3 — фильтры J_ENC |
| C38 | 100 нФ — развязка U8 |
| R6–R11 | 10 кОм ×6 — pull-up J_BTN |
| R12–R14 | 10 кОм ×3 — pull-up J_ENC |
| R15–R18 | 22 Ом ×4 — SPI OLED |
| R19–R22 | 22–47 Ом ×4 — R_buf U8 |
| U7 | LM358DR |
| U8 | 74AC541SC |
| U9 | RT9193-33 |

> Если при размещении фактический порядок изменится — допустимо перенумеровать **последовательно**, но без коллизий, и **обязательно** отразить фактические имена в `docs/bom/stage1_control.md` (раздел 1.4) в конце сессии.

## 5. J_PA_CTRL — РЕШЕНО: 6-pin (XH2.54 6P)

Сигналы (по одному на пин): `PTT`, `I_sense`, `SWR_sense`, `PWR_LIMIT_EN`, `PWR_LIMIT_SW`, `GND`.
Footprint: `JST_XH_B6B-XH-A_1x06_P2.54mm_*` (Vertical, если нет Horizontal).
Не объединять и не убирать сигналы — все 6 по отдельному пину.

## 6. Новые цепи, которые должны появиться

`+3V3_DISP` (выход U9 → J_OLED:1), `VFO_OUT`, `BFO_OUT`, `I_OUT`, `Q_OUT` (иерархические метки, для 1.5), `IQ_EN` (локально, GPIO MCU без номера), `SPI_SCK/MOSI/CS/DC`, `LCD_RST`, `LCD_BLK`, `ENC_CLK/DT/SW`, `BTN_UP/DOWN/LEFT/RIGHT/PUSH/RIT`.

> Номера GPIO — задача **1.5**. Сейчас допустимы именованные метки без номеров.

## 7. Definition of Done

- [ ] F3–F13 выполнены; каждое изменение подтверждено повторным чтением элемента через MCP.
- [ ] Нет коллизий refdes (проверить `sch_get_symbols` — каждый Reference уникален).
- [ ] `run_erc(save_report=true)`: нет **новых** `pin_to_pin` / `multiple_net_names` / `power_pin_not_driven` по добавленным компонентам (кроме штатных «Pin not connected» на неиспользуемых GPIO и изолированных `*_OUT`).
- [ ] Неиспользуемые входы U8 (A3/A4/A7/A8) и unit B U7 — на GND.
- [ ] C22 = **4.7 мкФ** (VCAP; значение обновлено, если было 2.2 мкФ).
- [ ] Разъёмы: J_OLED 8P, J_ENC 5P, J_BTN 7P, J_PA_CTRL 6P, J_RXTX_SIG 10P (один); J_SWD/J_UART остались PinHeader; J_PA_PWR/J_RXTX_PWR — клеммники 5.0 мм.
- [ ] Фактические refdes зафиксированы в `docs/bom/stage1_control.md` (раздел 1.4).
- [ ] Отчёт: таблица «F# → сделано → отклонения», выбранные футпринты, остаточные ERC.

## 8. Что НЕ делать

- Не трогать `00_master`, не трогать `libs`-таблицы.
- Не менять уже зафиксированную таблицу refdes из §2.
- Не запускать `sch_annotate`.
- Не разводить PCB (`01_control.kicad_pcb`) — только схема.
- Не травить/монтировать плату (запрет до 1.5+2.3 и фиксации `control_pa.md`).
- Не выполнять 1.4 (полная обвязка MIC U7) и 1.5 (привязка GPIO, интерфейсные метки) — это следующие сессии.

## 9. Порядок работы (checkpoints)

1. `kicad_set_project` → активен `01_control`; перечитать `docs/context.md`.
2. F4 (проверка U6) → F3 (U7) → F5/F6 (разъёмы) → F7 (U8) → F11 (U9) → F12 (J_OLED цепи) → F13 (RC).
3. `sch_get_symbols` — проверка уникальности refdes.
4. `run_erc(save_report=true)` — сравнение с базовой линией.
5. Обновить `docs/bom/stage1_control.md` (фактические refdes) и `docs/context.md`.
6. Коммит (стиль `<scope>: <описание>`, scope `hw`/`docs`/`bom`). Не коммитить без явного согласия пользователя.
