okunevpy-create/TRX_27MHz/docs/session_prompt_1.4.md

# Промт для KiCad-сессии: подэтап 1.4 (`01_control`) — UI / RIT / squelch / MIC-предусилитель

> Самодостаточный промт. Вставляй целиком в **новый диалог** (контекст сброшен).
> Ты — агент с доступом к KiCad MCP. Работаешь по шагам, ничего не перескакивая.

## 0. Проект и файл

- Активный проект: **`KiCad/01_control`** (`D:\Sources\git-hub\OkunevPY\TRX_27MHz\KiCad\01_control`).
- Целевой файл: **`01_control.kicad_sch`**.
- Перед началом прочитай: `docs/context.md`, `docs/bom/stage1_control.md` (раздел 1.4), `docs/contracts/control_rxtx.md` (справочно — уровни `MIC_LINE`/`RX_audio`).
- Убедись через `kicad_set_project`, что активен `01_control` (не `00_master`).

> **Контракты:** `control_pa.md` / `control_rxtx.md` — статус «Черновик». Для **1.4** фиксация НЕ требуется (сигналы `MIC_LINE`/`RX_audio` уже определены и не меняются). **1.5 — только после фиксации контрактов** (совместно с 2.3).

## 1. Правила (КРИТИЧНО, не нарушать)

1. `.kicad_sch` / `.kicad_pro` / `.kicad_pcb` править **ТОЛЬКО через KiCad MCP**. `write_file`/`edit_file`/`str_replace` на них запрещены.
2. Не редактировать один файл параллельно. Одна MCP-операция → перечитать → следующая. Не запускать параллельные KiCad-вызовы.
3. **Не запускать `sch_annotate`** — перенумерует зафиксированные refdes.
4. **Никаких наложений** символов/полей/текста/проводов (§6 AGENTS.md). Перед вставкой — `sch_get_bounding_boxes`/`sch_find_free_placement`, после — `sch_visual_qa`.
5. Корпуса пассивов: **0603** (Metric 1608) + **HandSolder**-вариант. Исключения: ферриты/электролиты SMD; **10 мкФ в 0603 нет → 0805** `C_0805_2012Metric_Pad1.15x1.40mm_HandSolder`.
6. Пины 2-выводных пассивов (`Device:C`/`C_Polarized`/`FerriteBead`) при rot=0: **pin1 сверху = y−3.81 мм**, pin2 снизу = y+3.81 мм (НЕ ±2.54).
7. Питание (`+3V3`/`+5V`/`+3V3_SI`/`+3V3_DISP`) и GND — **глобальными метками** (MCP не добавляет power-символы для `trx_custom`). Для «горячих» цепей, где ERC пишет `power_pin_not_driven`, — `power:PWR_FLAG`.
8. Не трогать `sym-lib-table`/`fp-lib-table`. Символ `trx_custom:RT9193-33`: 1=IN, 2=GND, 3=EN, 4=BP, 5=OUT.
9. Имена межблочных сигналов НЕ менять: `VFO`, `BFO`, `I`, `Q`, `PTT`, `MIC_LINE`, `MUTE`, `RX_audio`, `+12V_PA`, `+12V_RXTX`, `PWR_LIMIT_EN`, `PWR_LIMIT_SW`, `I_sense`, `SWR_sense`.

## 2. Текущее состояние (УЖЕ СДЕЛАНО — НЕ переделывать)

- **1.1** (питание), **1.2** (MCU), **1.3** (Si5351 + 74HC74) — готовы.
- **F3–F13 — готовы:** U7 LM358 (символ, unit B → GND/NC), U8 74AC541, U9 RT9193 (`+3V3_DISP`), разъёмы J_OLED/J_ENC/J_BTN/J_PA_CTRL/J_RXTX_SIG, клеммники J_PA_PWR/J_RXTX_PWR, RC-фильтры (R6–R14, C29–C37), SPI-резисторы (R15–R18), буферы R19–R22, C38.
- **ERC baseline: 73 error + 16 warning** — «отложено до 1.5» (интерфейсные метки, свободные GPIO MCU, неиспользуемые пины U7/U8, изолированные `*_OUT`/`SPI_*`/`LCD_*`).
- **U7 уже размещён** (unit A свободен, unit B входы на GND / выход NC). В 1.4 обвязать **unit A**.

**Занятые refdes (не трогать):** C1–C38 (C17 удалён; C22=4.7 мкФ), R1–R22, L1–L3, U1–U9, D1–D3, Y1–Y2, J_OLED / J_ENC / J_BTN / J_PA_CTRL / J_RXTX_SIG / J_PA_PWR / J_RXTX_PWR / J_SWD / J_UART. **Новые — строго R23+, C39+.**

## 3. Задачи (1.4)

### 3.1 — MIC-предусилитель U7 (LM358, unit A, **неинвертирующий**)

Цоколёвка LM358 (SOIC-8): 1=OUT A, 2=IN− A, 3=IN+ A, 4=GND(V−), 8=VCC(V+). Unit B (5/6/7) уже на GND/NC.

Однополярное питание **+3V3**, смещение 0.5×Vcc = **1.65 В**, усиление ≈ **11** (`1 + R_fb/R_g = 1 + 100к/10к`).

```
+3V3 ── R_bias 2.2к ── MIC+   (электрет; MIC− → GND)
MIC+ ── C_cpl 1мкФ ── V+   (U7 pin 3)
V+ ── R_in 10к ── +3V3
V+ ── R_g 10к  ── GND        → смещение 1.65 В
Vout(pin1) ── R_fb 100к ── V− (U7 pin 2)
V− ── R_gain 10к ── C_fb ── GND   → усиление ≈ 11 (DC gain = 1 за счёт C_fb)
Vout(pin1) ── MIC_LINE (иерархическая метка)
```

> **Почему R_gain и C_fb:** неинвертирующий усилитель требует путь от V− к земле (R_gain) для задания усиления. На однополярном питании C_fb в ОС нужен, чтобы по постоянному току усиление было = 1 (выход держится на 1.65 В), а по переменному — ≈ 11. Без C_fb выход уйдёт в насыщение (~1.8 В) и потеряет переменную составляющую.

### 3.2 — Вход `RX_audio` → ADC MCU (RC, squelch программный)

```
RX_audio ── R_rc 1к ──┬── к пину MCU (ADC)
                       └── C_rc 10нФ ── GND
```
τ = 1к × 10нФ = 10 мкс — антиалиасинг, не давит звук (squelch — в прошивке).

### 3.3 — RIT: только цепи (логика в прошивке)

Кнопка RIT уже в `J_BTN` (8-pin), энкодер в `J_ENC` (5-pin). Ничего нового не добавлять — проверить, что линии `BTN_RIT`/`ENC_*` заведены через RC-фильтры.

## 4. Карта новых refdes (строго последовательно, без коллизий)

| Ref | Значение | Назначение | Footprint |
|-----|---|---|---|
| R23 | 2.2 кОм | bias электрета (+3V3 → MIC+) | R_0603…HandSolder |
| R24 | 10 кОм | делитель смещения (верх, +3V3 → V+) | R_0603…HandSolder |
| R25 | 10 кОм | делитель смещения (низ, V+ → GND) | R_0603…HandSolder |
| R26 | 100 кОм | обратная связь (Vout → V−) | R_0603…HandSolder |
| R27 | 10 кОм | усиление (V− → C_fb → GND) | R_0603…HandSolder |
| R28 | 1 кОм | RC-фильтр `RX_audio` | R_0603…HandSolder |
| C39 | 1 мкФ | входной конденсатор связи (MIC+ → V+) | C_0603…HandSolder |
| C40 | 10 нФ | RC-фильтр `RX_audio` | C_0603…HandSolder |
| C41 | 10 мкФ | AC-земля в ОС (последовательно с R27) | C_0805…HandSolder |

> 10 мкФ (C41) — **0805**. Остальные — 0603. Все номиналы — склад/стандарт; при необходимости отразить в `docs/bom/stage1_control.md` (1.4) в конце сессии.

## 5. Новые цепи, которые должны появиться

`MIC` (узел электрета), `MIC_LINE` (иерархическая метка, выход U7 → J_RXTX_SIG), `RX_audio` (уже есть как метка, добавить RC-узел `RX_audio_F`).

## 6. Definition of Done

- [ ] 3.1–3.3 выполнены; каждое изменение подтверждено повторным чтением через MCP.
- [ ] Нет коллизий refdes (`sch_get_symbols` — каждый Reference уникален, новые R23–R28 / C39–C41 не пересекаются с занятыми).
- [ ] `run_erc(save_report=true)`: нет **новых** `pin_to_pin` / `multiple_net_names` / `power_pin_not_driven` по добавленным компонентам (кроме штатных изолированных `MIC_LINE`/`RX_audio`).
- [ ] Unit B U7 остаётся на GND/NC; unit A обвязан полностью.
- [ ] `MIC_LINE` — иерархическая метка (выход U7); `RX_audio` заведён на MCU через R28/C40.
- [ ] Фактические refdes зафиксированы в `docs/bom/stage1_control.md` (1.4) и `docs/context.md`.
- [ ] Отчёт: таблица «задача → сделано → отклонения», остаточные ERC.

## 7. Что НЕ делать

- Не выполнять **1.5** (привязка GPIO, интерфейсные метки, PTT/I_sense/SWR_sense/PWR_LIMIT_*/MUTE) — это совместно с 2.3, после фиксации контрактов.
- Не трогать `00_master`, `sym-lib-table`/`fp-lib-table`.
- Не менять занятую таблицу refdes (C1–C38, R1–R22, U1–U9, …).
- Не запускать `sch_annotate`.
- Не разводить PCB (`01_control.kicad_pcb`) — только схема.
- Не травить/монтировать плату (запрет до 1.5+2.3 и фиксации `control_pa.md`).

## 8. Порядок работы (checkpoints)

1. `kicad_set_project` → активен `01_control`; перечитать `docs/context.md`.
2. `sch_get_symbols` → проверить уникальность refdes и текущее состояние U7.
3. 3.1 (MIC-предусилитель U7) → 3.2 (RX_audio RC) → 3.3 (проверка RIT).
4. `sch_get_symbols` — уникальность refdes.
5. `run_erc(save_report=true)` — сравнение с baseline (73+16).
6. Обновить `docs/bom/stage1_control.md` (1.4) и `docs/context.md`.
7. Коммит (стиль `<scope>: <описание>`, scope `hw`/`docs`/`bom`). **Не коммитить без явного согласия пользователя.**
