okunevpy-create/TRX_27MHz/docs/calculations/power_budget_stage3.md

# Бюджет токов и ширины цепей — 03_rx_tx (этап 3)

Дата: **2026-11-05**. Метод: **IPC-2221**, внешний слой, **1 oz (35 мкм)**, ΔT = 10 °C.
Источник токов — фактические имена цепей схемы `03_rx_tx` (`sch_get_symbols` +
`sch_get_connectivity_graph`), `docs/bom/stage3_rx_tx.md` и
`docs/design_decisions_stage3.md`. Все арифметические операции — инструментами
(`calculate`/`sqrt`, правило AGENTS.md).

Дополняет `docs/calculations/power_budget_stage1.md` (этап 1) и
`power_budget_stage2.md` (этап 2). Плата этапа 3 — **малосигнальная** (в отличие от
силового `02_power_amp`), все токи ≪ 0.5 А.

---

## 1. Дерево питания (факт, по схеме)

```
J8:1 (+12V_RXTX, 13.8 В от LTC3780 через WAGO 221-415)
  │
  ├─ K1:1 (катушка реле IM06GR) → K1:8 → RELAY_DRV → Q2 (2N7002) → GND
  ├─ L5:1 (RFC драйвера TX) → L5:2 → Q1_C (коллектор 2SC2314)
  ├─ R25:1 → Q1_B (делитель базы драйвера 47к/10к)
  ├─ C40/C41 (развязка) + D6 (flyback реле)
  └─ U5:1 (LM7809) → +9V
         │
         ├─ U3:6 (LM386, питание УНЧ)
         ├─ C42/C43/C44 (развязка)
         └─ U6:3 (L78L06) → +6V
                │
                ├─ U1/U2/U4:8 (NE612 ×3, VCC)
                ├─ R4/R5, R10/R11, R18/R19, R20/R21, R23 (подтяжки/делители)
                └─ C15/C26/C33/C45 (развязка)
```

Ключевые узлы питания:
- `+12V_RXTX` — силовая шина: катушка реле + драйвер TX + вход LM7809.
- `+9V` (LM7809) — УНЧ LM386 + вход L78L06.
- `+6V` (L78L06) — питание NE612 ×3 и делителей смещения.

---

## 2. Токи (худший случай)

### 2.1 Постоянные / НЧ

| Узел | Ток | Расчёт (инструментами) |
|---|-----|---|
| Драйвер TX `Q1` (2SC2314), класс A/AB | **≈ 91 мА** | Po=0.5 Вт, η=0.4 → Pin=0.5/0.4=**1.25 Вт**; I=1.25/13.8=**0.0906 А** |
| Катушка реле `K1` (IM06GR, ~720 Ом) | **≈ 17 мА** | 12/720 = **0.0167 А** |
| Вход `LM7809` (≈ вся нагрузка +9V) | ≈ 100–250 мА | LM386 (аудио, до 250 мА пик) + L78L06 (≈15 мА) |
| **Шина `+12V_RXTX` (итог)** | **≤ 150 мА** | 91 (драйвер) + 17 (реле) + ~40 (7809 вход, типовой) |
| `+9V` (LM7809 выход) | ≤ 250 мА (пик аудио) | LM386 + L78L06 |
| `+6V` (L78L06 выход) | ≈ 5–10 мА | NE612 ×3 (≈2.4–5 мА каждая) + делители |

### 2.2 ВЧ-токи (50 Ом)

| Цепь | Мощность | I_rms = √(P/R) |
|---|---|---|
| `TX_RF` (выход драйвера на УМ) | 0.5 Вт | √(0.5/50)=**0.100 А** |
| `RX_RF` (просачивание с УМ) | ≤1 Вт | √(1/50)=**0.141 А** |
| VFO/BFO/ПЧ (гетеродины и тракт ПЧ) | ~1 В pp, мВт | ≪ 1 мА |

---

## 3. Требуемая ширина дорожки (IPC-2221, внешний слой, 1 oz, ΔT = 10 °C)

| Ток | Требуемая ширина |
|-----|---|
| 0.25 А | 0.041 мм |
| 0.15 А | 0.021 мм |
| 0.02 А | ≈ 0.003 мм |

> Наименьшая практически используемая ширина по правилам домашнего изготовления
> этапов 2/3 — **0.6 мм**. При 0.6 мм и 1 oz расчётная токонесущая способность
> составляет единицы ампер — то есть **0.6 мм покрывает все токи этапа 3 с
> многократным запасом**.

---

## 4. Проверка падения напряжения (0.6 мм) — инструмент `pdn_calculate_voltage_drop`

| Цепь | Ток | Ширина × длина | ΔU | ΔT | Вердикт |
|---|-----|---|-----|-----|---|
| `+12V_RXTX` | 0.15 А | 0.6 мм × 50 мм | **6.3 мВ** | 0.0 °C | PASS |
| `+9V` | 0.25 А | 0.6 мм × 40 мм | **8.4 мВ** | 0.1 °C | PASS |
| `+6V` | 0.02 А | 0.6 мм × 30 мм | **0.5 мВ** | 0.0 °C | PASS |

> Оценка первого порядка (не распределённый solver, не sign-off). Все три — PASS
> с практически нулевым нагревом.

---

## 5. Выбранные ширины (итог)

| Группа цепей | Ток (расч.) | **Ширина** | Обоснование |
|---|---|---|---|
| `+12V_RXTX`, `+9V`, `+6V` | ≤ 0.25 А | **0.6 мм** | питание, запас > 10× |
| ВЧ/ПЧ/гетеродины (27 МГц + 10 МГц) | ≪ 0.15 А | **0.6 мм** | малосигнальный тракт, короткие линии |
| всё остальное (логика/аудио/смещение) | ≪ 0.1 А | **0.6 мм** | дефолт |

**Вывод: единая ширина 0.6 мм для всей платы.** На 27 МГц длина всех трактов
много меньше λ/20 (λ≈11 м), поэтому точная 50-омная микрополоска (~3 мм) не
требуется — важна **короткая прямая разводка над сплошной землёй**, а не ширина.
Отдельные net-классы **отменены решением 2026-11-05** — всё разводится одним
`Default` 0.6 мм (см. `pcb_layout_stage3.md` §4).
