okunevpy-create/TRX_27MHz/docs/contracts/control_rxtx.md

# Контракт: этап 1 (`01_control`) ↔ этап 3 (`03_rx_tx`)

## Статус фиксации
- ✅ **Зафиксировано для разводки этапа 1 (2026-10-29, пинаут обновлён 2026-10-30):**
  - тип + пинаут разъёмов (см. таблицу ниже) — меняется только по явному согласованию;
  - направления сигналов;
  - **уровни сигналов** (проектные цели; подтверждаются при bring-up этапа 3).
- 🔁 **Изменение (2026-10-30, согласовано; обновлено 2026-11-05):** единый `J_RXTX_SIG_1` (10P XH2.54) **разбит на 5 сигнальных разъёмов** (Вариант A): `J_VFO_1`/`J_BFO_1` (SMA), `J_MODE_1` (2P), `J_PTT_MUTE_1` (3P), `J_AUDIO_1` (3P). Причина: физическое разнесение гетеродинов; VFO/BFO — коаксиалом (SMA) для помехозащищённости.
- ⏳ **Черновик до этапа 3 (на плату этапа 1 не влияет):**
  - `J_RF_RX_1` (27 МГц, SMA);
  - защита входа RX (диоды + аттенюатор + разрядник);
  - физическая прозвонка гарнитуры (распиновка корпусных разъёмов уже зафиксирована);
  - RIT/XIT — прошивка.

## Разъёмы
| Разъём | Назначение | Тип | Footprint |
|---|---|-----|---|
| J_VFO_1 | VFO (гетеродин 37 МГц) | SMA (розетка) | `trx_custom:SMA_S-P215` |
| J_BFO_1 | BFO (гетеродин 10 МГц) | SMA (розетка) | `trx_custom:SMA_S-P215` |
| J_MODE_1 | MODE (0=SSB / 1=AM) | XH2.54, 2-pin, vertical | `Connector_JST:JST_XH_B2B-XH-A_1x02_P2.50mm_Vertical` |
| J_PTT_MUTE_1 | PTT, MUTE | XH2.54, 3-pin, vertical | `Connector_JST:JST_XH_B3B-XH-A_1x03_P2.50mm_Vertical` |
| J_AUDIO_1 | RX_audio, MIC_LINE | XH2.54, 3-pin, vertical | `Connector_JST:JST_XH_B3B-XH-A_1x03_P2.50mm_Vertical` |
| J_RF_RX_1 | Вход приёма с УМ (RX_RF) | SMA (см. [rxtx_pa.md](rxtx_pa.md)) | — |

> **Сторона `03_rx_tx` (референсы схемы — `J1`–`J9`):** VFO → `J3`, BFO → `J4`,
> MODE → `J5`, PTT/MUTE → `J6`, RX_audio/MIC_LINE → `J7`, SP → `J9`, RX_RF → `J1`,
> TX_RF → `J2`, питание → `J8`. VFO/BFO — **SMA** с обеих сторон.

## Сигналы (пинаут по разъёмам)

### J_VFO_1 (SMA)
| Контакт | Сигнал | Направление | Уровень | Тип | Провод |
|---|---|---|---|-----|---|
| центр | VFO | control → rxtx | ~1 В pp | ВЧ ~37 МГц | коаксиал (экран = GND) |
| экран | GND | — | — | — | |

### J_BFO_1 (SMA)
| Контакт | Сигнал | Направление | Уровень | Тип | Провод |
|---|---|---|---|-----|---|
| центр | BFO | control → rxtx | ~1 В pp | ВЧ 10 МГц | коаксиал (экран = GND) |
| экран | GND | — | — | — | |

### J_MODE_1 (2P)
| Пин | Сигнал | Направление | Уровень | Тип | Провод |
|-----|---|---|---|-----|---|
| 1 | MODE | control → rxtx | 0/3,3 В | цифровой (0=SSB, 1=AM) | обычный |
| 2 | GND | — | — | — | |

### J_PTT_MUTE_1 (3P)
| Пин | Сигнал | Направление | Уровень | Тип | Провод |
|-----|---|---|---|-----|---|
| 1 | PTT | control → rxtx | 0/3,3 В | цифровой | обычный |
| 2 | GND | — | — | — | |
| 3 | MUTE | control → rxtx | 0/3,3 В | цифровой (1=заглушён, 0=открыт) | обычный |

### J_AUDIO_1 (3P)
| Пин | Сигнал | Направление | Уровень | Тип | Провод |
|-----|---|---|---|-----|---|
| 1 | RX_audio | rxtx → control | ~0,5 В pp | аналоговый (squelch, ADC) | витая пара (с пин 2) |
| 2 | GND | — | — | — | |
| 3 | MIC_LINE | control → rxtx | ~100 мВ pp | аналоговый (line-level с микрофона) | витая пара (с пин 2) |

> VFO/BFO — гетеродины, передаются **коаксиалом (SMA)**. Строгое 50-Ом согласование не требуется (в отличие от антенного тракта).

## Питание RX/TX (+12V_RXTX)
- Разъём `J_RXTX_PWR_1` **убран** (2026-10-31). Питание тракта RX/TX теперь подаётся на клеммник `J8` (2P 5.0 мм) **напрямую с внешней клеммы WAGO 221-415** (шина +12V, фактически 13,8 В от LTC3780), а не звездой с `01_control`.
- Уровень `+12V_RXTX` = **12–14,5 В** (13,8 В от LTC3780), защита входа — общая (5 А + TVS load dump + SS54) перед LTC3780; на плате — LM7809 → 9 В.
- GND — силовая земля (общая шина GND).

## Сигналы (J_RF_RX_1)
| Сигнал | Направление | Уровень | Тип | Примечание |
|---|---|---|-----|---|
| RX_RF | PA → rxtx | до 1 Вт просачивания | ВЧ 27 МГц | защита: диоды + аттенюатор 3–6 дБ |
| GND | — | — | — | экран |

## Гарнитура (микрофон + динамик + PTT)
- **Тип**: Baofeng/Kenwood 2-pin (K1), 3.5 мм (SP+/GND) + 2.5 мм (MIC/PTT).
- **Разъёмы — на корпусе** (передняя панель), не на платах. На плате `01_control` — разъём `J_HS_1` (XH2.54 3P) под проводной монтаж микрофона/PTT/земли гарнитуры.
- **Микрофон**: электретный, ~2.2 кОм, ~−38 дБ. Питание — на `01_control`.
- **Предусилитель**: на `01_control`, выдаёт `MIC_LINE` (line-level ~100 мВ).
- **Динамик**: 8 Ом. Выход УНЧ (LM386) с `03_rx_tx` идёт на разъём `J9` (XH2.54 2P), оттуда проводом на корпусной разъём 3.5 мм (SP+/GND).
- **PTT**: кнопка на гарнитуре замыкает линию на GND. Читается MCU на `01_control` (вход `PTT_IN`, разъём `J_HS_1:3`).
- **MUTE**: сигнал с `01_control` на `03_rx_tx`, закрывает УНЧ при squelch.
- **Физическое подключение гарнитуры**:
  - MIC, PTT_IN, GND → `J_HS_1` (XH2.54 3P) на `01_control` → корпусной разъём 2.5 мм (экран микрофона — на `J_HS_1:2` GND).
  - SP+, GND → `J9` (XH2.54 2P) на `03_rx_tx` → корпусной разъём 3.5 мм.

### Распиновка корпусных разъёмов гарнитуры (ЗАФИКСИРОВАНО)

**2.5 мм (TRS) — микрофон / PTT:**
| Контакт | Сигнал | Назначение | Подключение (плата) |
|---|---|---|---|
| Tip | `MIC` | электретный микрофон, сигнал (+) | `J_HS_1:1` на `01_control` |
| Ring | `PTT_IN` | кнопка, замыкается на GND при передаче | `J_HS_1:3` на `01_control` |
| Sleeve | `GND` | общий (в т.ч. экран микрофона) | `J_HS_1:2` на `01_control` |

**3.5 мм (TS) — динамик:**
| Контакт | Сигнал | Назначение | Подключение (плата) |
|---|---|---|---|
| Tip | `SP+` | динамик, сигнал (+) | `J9:1` (выход УНЧ LM386, `03_rx_tx`) |
| Sleeve | `GND` | динамик, обратный (−) | `J9:2` (общий GND УНЧ, `03_rx_tx`) |

### J_HS_1 (XH2.54 3P) — разъём гарнитуры на плате `01_control`
| Пин | Сигнал | Назначение |
|-----|---|---|
| 1 | `MIC` | электретный микрофон, сигнал (+) (Tip 2.5 мм) |
| 2 | `GND` | общий + экран микрофона (Sleeve 2.5 мм) |
| 3 | `PTT_IN` | кнопка, замыкается на GND при передаче (Ring 2.5 мм) |

> Микрофон и PTT приходят с корпусного гнезда 2.5 мм тремя проводами (MIC/PTT/GND); экран микрофонного провода сажается на `J_HS_1:2` GND.

> **Стандарт**: Kenwood K1 2-pin (Baofeng UV-5R и совместимые).
> **При получении гарнитуры** прозвонить контакты и сверить с таблицей;
> при расхождении у конкретного экземпляра корректировать распайку панельных
> гнёзд, а не контракт. Линия `PTT_IN` требует pull-up на стороне MCU
> (`01_control`, обвязка в 1.5).

## Расстройка SSB (RIT/XIT) — обязательное требование
- **RIT**: ±1 кГц, шаг 10 Гц (мелкий) / 100 Гц (крупный, при нажатой кнопке).
- **XIT**: опционально.
- **Управление**: энкодер в режиме SSB; отдельная кнопка «RIT» — вкл/сброс; двойное нажатие — быстрый сброс.
- **Индикация**: OLED — «RIT +250 Hz».
- **Хранение**: в EEPROM, привязано к каналу (опционально — глобально).
- **Реализация**: программная поправка Si5351 (VFO = CLK0, BFO = CLK1; RIT сдвигает VFO/CLK0).
- **Плавность**: обновление Si5351 раз в 50–100 мс, без «щелчков».
- **Автосброс при смене канала** — настраиваемо.

## Защита входа RX
- Антипараллельные диоды (1N4148 или BAT54).
- Аттенюатор 3–6 дБ (резистивный).
- Место под разрядник (опционально).

## Статус
Зафиксировано для разводки этапа 1 (2026-10-29; пинаут разъёмов обновлён 2026-10-30 — см. «Статус фиксации» вверху). **Изменение 2026-10-31:** `J_RXTX_PWR_1` убран — питание RX/TX через внешнюю клемму WAGO 221-415 (шина +12V от LTC3780). **Изменение 2026-11-03:** исправлена ошибка в §«Расстройка SSB (RIT/XIT)» — VFO на **CLK0**, BFO на **CLK1** (сверено со схемой `01_control` через KiCad MCP). Черновик до этапа 3 — только пункты, не влияющие на плату этапа 1.
