okunevpy-create/TRX_27MHz/docs/calculations/power_budget_stage2.md

# Бюджет токов и ширины силовых цепей — 02_power_amp (этап 2)

Дата: **2026-11-04**. Метод: **IPC-2221**, внешний слой, **1 oz (35 мкм)**, ΔT = 10 °C.
Источник токов — фактические имена цепей схемы `02_power_amp` (`sch_get_symbols` +
`sch_get_connectivity_graph`) и расчёты `docs/calculations/pa_stage2.md`. Все
арифметические операции — инструментами (`calculate`/`divide`/`sqrt`, правило AGENTS.md).

Дополняет `docs/calculations/power_trace_widths.md` (там — только `01_control`).

---

## 1. Дерево питания (факт, по схеме)

```
J_PA_PWR_1:1 (+12V_PA, 13.8 В от LTC3780 через WAGO 221-415)
  │
  ├─ C4 (470 мкФ/35 В, bulk) + C3 (10 мкФ) + C1/C2 (100 нФ) — развязка
  │
  ├─ L1 (RFC, T68-2) ──► RFC_IN ──► T2 (центр первички выходного балуна)
  │                                     │
  │                     ┌───────────────┴──────────────┐
  │                     ▼                              ▼
  │                 DRAIN1 (Q1.3)                 DRAIN2 (Q2.3)
  │                     │                              │
  │              Q1.2 (Source) ────────────► Q2.2 (Source)
  │                     └──────────────┬───────────────┘
  │                                    ▼
  │                                 PA_RET ──► R16 (шунт 0.05 Ом, 2512) ──► GND
  │
  ├─ K1:1 (+12V_PA, катушка реле) → K1:8 → RELAY_DRV → Q4 → GND
  ├─ U1:8 (LM358, питание +12V_PA)
  ├─ R5/R6 (делитель VGG_FULL), R7/R8 (делитель PLIM_LIM)
  └─ R11 (D7 power-good LED)
```

Ключевая находка по графу связности: **шунт R16 включён в минусовую шину** —
`PA_RET → R16 (0.05 Ом) → GND`. Весь ток УМ возвращается через истоки Q1/Q2 в узел
`PA_RET`, затем через шунт в `GND`. LM358 канал A снимает падение на шунте (IN1+ =
`PA_RET`), канал B заглушён повторителем (IN2+ → GND, IN2− → OUT2).

---

## 2. Токи

| Узел | Режим | Ток | Расчёт (инструментами) |
|---|---|-----|---|
| Покой (Idq) | приём, FULL | **1.0 А** | 0.5 А × 2 = 1 А |
| Полная мощность (Po=16 Вт, η=55 %) | CW/PEP | **2.11 А** | Pin=16/0.55=29.09 Вт; I=29.09/13.8=2.108 А |
| Полная мощность (Po=16 Вт, η=65 %) | CW/PEP | **1.78 А** | Pin=16/0.65=24.62 Вт; I=24.62/13.8=1.784 А |
| **Расчётный предел силовой шины** | запас | **3 А** | (документировано в BOM: «полный ток ~2–3 А») |

**ВЧ-токи (50 Ом):**

| Цепь | Мощность | I_rms = √(P/R) |
|---|---|---|
| `ANT` (выход на антенну) | 12 Вт PEP | √(12/50)=0.490 А |
| `LPF_IN`/`LPF_MID1`/`LPF_OUT` (тракт ФНЧ) | 12 Вт PEP | 0.490 А |
| `TX_RF` (раскачка) | 0.5 Вт | √(0.5/50)=0.100 А |
| `RX_RF` (просачивание) | ≤1 Вт | √(1/50)=0.141 А |

**Служебные:**

| Цепь | Ток |
|---|-----|
| `RELAY_DRV` (катушка реле K1) | 12/1029 = 11.7 мА |
| `PTT`, `PWR_LIMIT_EN`, `PWR_LIMIT_SW`, `PLIM_LIM`, `VGG*`, `I_sense`, `SWR_sense`, LED | ≪ 10 мА |

---

## 3. Требуемая ширина дорожки (IPC-2221, внешний слой, 1 oz, ΔT = 10 °C)

| Ток | Требуемая ширина |
|-----|---|
| 3.0 А | 1.367 мм |
| 2.5 А | 1.063 мм |
| 2.0 А | 0.781 мм |
| 1.5 А | 0.525 мм |
| 0.5 А | 0.115 мм |

---

## 4. Выбранные ширины (с запасом)

| Группа цепей | Ток (расч.) | Мин. ширина | **Выбрано** | Обоснование |
|---|---|---|---|---|
| `+12V_PA`, `PA_RET`, `RFC_IN` | 3 А (запас) | 1.367 мм | **1.5 мм** | силовая магистраль УМ |
| `DRAIN1`, `DRAIN2` | ~1.5 А на плечо | 0.525 мм | **1.0 мм** | DC + ВЧ, короткий участок сток→балун |
| `ANT`, `LPF_IN`, `LPF_MID1`, `LPF_OUT`, `TX_RF`, `RX_RF` | 0.5 А (ВЧ) | 0.115 мм | **1.0 мм** | ВЧ 50 Ом: малые потери/индуктивность, не ток |
| всё остальное (логика, делители, датчики) | ≪ 0.1 А | — | **0.6 мм** | дефолт |

> **Падение напряжения (худший случай):** `+12V_PA`, 3 А, 1.5 мм × 50 мм →
> **50.5 мВ** (ΔT = 8.7 °C, PASS). Проверено инструментом
> `pdn_calculate_voltage_drop` (оценка первого порядка, не sign-off).

> **Примечание:** настоящая 50-омная микрополоска на 1.6 мм FR4 (εr≈4.5) требует
> ~2.9–3.0 мм. Но на 27 МГц длина тракта ФНЧ/АУ много меньше λ/20, а посадочные
> площадки конденсаторов 0805 ≈ 1.2 мм — поэтому выбран компромисс **1.0 мм**
> (низкие потери и индуктивность без нереально широких дорожек). Точное согласование —
> на готовой плате по КСВ.

---

## 5. Итог

Плата в steady-state потребляет от `+12V_PA`:
- **покой ~1.0 А** (Idq 0.5 А × 2),
- **полная мощность 1.78–2.11 А** (Po=16 Вт, η 55–65 %),
- расчётный предел шины принят **3 А**.

Ширины дорожек: силовые 1.5 мм, ВЧ/стоковые 1.0 мм, логика 0.6 мм. Net-классы и их
назначение — в `docs/pcb_layout_stage2.md` §Net-классы.
