okunevpy-create/TRX_27MHz/docs/contracts/control_pa.md

# Контракт: этап 1 (`01_control`) ↔ этап 2 (`02_power_amp`)

Фиксируется **до** разводки подэтапов 1.5 и 2.3. От него зависит, можно ли травить плату этапа 1.

> **ВЧ-связь `03_rx_tx` ↔ `02_power_amp` вынесена в отдельный контракт** — см. [rxtx_pa.md](rxtx_pa.md). Антенный разъём (J_ANT_1) и ВЧ-вход УМ там же. В этом контракте — только управление, датчики и питание.

## Разъёмы
| Разъём | Назначение | Тип | Footprint |
|---|---|-----|---|
| J_PA_CTRL_1 | Цифровое управление (PTT, PWR_LIMIT) | XH2.54, 4-pin, vertical | `Connector_JST:JST_XH_B4B-XH-A_1x04_P2.50mm_Vertical` |
| J_I_SENSE_1 | Датчик тока I_sense (витая пара с GND) | XH2.54, 2-pin, vertical | `Connector_JST:JST_XH_B2B-XH-A_1x02_P2.50mm_Vertical` |
| J_SWR_1 | Датчик КСВ SWR_sense (витая пара с GND) | XH2.54, 2-pin, vertical | `Connector_JST:JST_XH_B2B-XH-A_1x02_P2.50mm_Vertical` |

## Сигналы (J_PA_CTRL_1)
| Пин | Сигнал | Направление | Уровень | Тип | Примечание |
|-----|---|---|---|-----|---|
| 1 | GND | — | — | — | сигнальная земля |
| 2 | PTT | control → PA | 0/3,3 В | цифровой | ключ TX, управление T/R реле |
| 3 | PWR_LIMIT_EN | control → PA | 0/3,3 В | цифровой | 1 = программно включить ограничитель |
| 4 | PWR_LIMIT_SW | PA → control | 0/3,3 В | цифровой | 1 = тумблер в LIMIT, 0 = FULL (обратная связь) |

## Сигналы (J_I_SENSE_1)
| Пин | Сигнал | Направление | Уровень | Тип | Примечание |
|-----|---|---|---|-----|---|
| 1 | I_sense | PA → control | 0–3,3 В | аналоговый | с шунта, через делитель (витая пара с пин 2) |
| 2 | GND | — | — | — | возврат для I_sense |

## Сигналы (J_SWR_1)
| Пин | Сигнал | Направление | Уровень | Тип | Примечание |
|-----|---|---|---|-----|---|
| 1 | SWR_sense | PA → control | 0–3,3 В | аналоговый | направленный ответвитель (витая пара с пин 2) |
| 2 | GND | — | — | — | возврат для SWR_sense |

## Питание PA (+12V_PA)
- Разъём `J_PA_PWR_1` **убран** (2026-10-31). Питание УМ теперь подаётся **напрямую с внешней клеммы WAGO 221-415** (шина +12V, фактически 13,8 В от LTC3780), а не звездой с `01_control`.
- Уровень `+12V_PA` = **12–14,5 В** (13,8 В от LTC3780), защита входа — общая (5 А + TVS load dump + SS54) перед LTC3780; на УМ — LC-фильтр.
- GND — силовая земля (с общей шины GND, соединение в одной точке).

## T/R switch
- **Реле на `02_power_amp`**, антенный разъём (J_ANT_1) там же — см. [rxtx_pa.md](rxtx_pa.md).
- Управление — PTT с `01_control`.
- Защита входа RX на `03_rx_tx`: антипараллельные диоды + аттенюатор 3–6 дБ.

## Ограничитель мощности AM (обязательное требование)
- **Назначение**: не превышать 4 Вт (несущая) в AM согласно нормам РФ.
- **Реализация**: управление смещением на затворах RD16HHF1 через подстроечник RV1.
- **`VGG` (аналог) остаётся на плате `02_power_amp`**; на панель через тумблер уходит только логика.
- **Физический тумблер** (SPDT, **ASW-14-102**, ON-ON 3P, 20A 12VDC) — монтируется **на панель (корпус)**; на плате `02_power_amp` — разъём **`J_SW_1`** (XH2.54 3-pin):
  - **LIMIT** — ограничитель активен (прошивка включает Q3), 4 Вт.
  - **FULL** — ограничитель отключён, полная мощность.
- **Выбор смещения на плате**: `VGG` по умолчанию = FULL (через R19); единственный ключ **Q3** (`PWR_LIMIT_EN`) притягивает `VGG` к `VGG_LIMIT` (RV1). Ключ Q5 и диодное ИЛИ D2/D3 **удалены** (вариант C).
- **Управление — только прошивка**: тумблер `PWR_LIMIT_SW` — вход в MCU; MCU сам выставляет `PWR_LIMIT_EN` (1 = ограничить). Захардкоженного дефолта нет — прошивка читает фактическое положение тумблера.
- **Обратная связь**: `PWR_LIMIT_SW` — прошивка знает реальное положение.
- **Индикация**: светодиод LIMIT (на **передней панели**; на плате `02_power_amp` — только разъём `J_LIM_LED_1`, XH2.54 2-pin) — зажигается от `PWR_LIMIT_EN` (состояние Q3). На OLED — «LIM» + предупреждение при FULL в AM.
- **Логика**: `PWR_LIMIT_EN = AM && (тумблер LIMIT)`. Тумблер в FULL + AM → предупреждение на OLED.
- **SSB**: ограничитель не действует (лимит 12 Вт пиковой).
- **Калибровка**: подстроечником RV1 выставить 4 Вт в LIMIT.

> **`J_SW_1` (внутренний разъём тумблера, не межмодульный):** пины 1=`PWR_LIMIT_SW` (COM), 2=`PLIM_LIM` (LIMIT), 3=`GND` (FULL) (подробно — `docs/bom/stage2_power_amp.md` §2.3).

## Статус
**Зафиксирован** (2026-10-28; обновлён 2026-10-30): типы и пинаут разъёмов согласованы. Изменение 2026-10-30: `J_PA_CTRL_1` 6P→4P (I_sense/SWR_sense вынесены в `J_I_SENSE_1`/`J_SWR_1`), LIMIT/FULL переведён на SPDT ASW-14-102 + MOSFET на плате (`VGG` не покидает плату). **Изменение 2026-10-31:** `J_PA_PWR_1` убран — питание УМ через внешнюю клемму WAGO 221-415 (шина +12V от LTC3780). **Изменение 2026-11-04 (вариант C):** лимит управляется только прошивкой — Q5 и D2/D3 удалены; `PWR_LIMIT_SW` — чистый вход MCU, `PWR_LIMIT_EN` (PB10) — единственный ключ Q3. Изменение — только по явному согласованию.
