okunevpy-create/TRX_27MHz/.continue/rules/0603.md

---
description: Для резисторов и конденсаторов в этом проекте по умолчанию
  использовать корпус 0603 (при наличии номинала в наличии). Применять при
  выборе footprint и составлении BOM.
alwaysApply: true
---

Для резисторов и керамических конденсаторов по умолчанию выбирать SMD-корпус 0603 (Metric 1608), если номинал присутствует в наличии (Stock/resistance_0603.csv / Stock/smd_resistors_0603.csv / Stock/capacitors_ 0603.csv). Только если номинала нет в 0603 — брать другой корпус. Мощные/силовые и электролитические элементы — вне этого правила. Решение фиксировать в BOM.
