okunevpy-create/TRX_27MHz/docs/calculations/power_budget_stage1.md

# Бюджет токов потребления — плата 01_control (этап 1)

Дата: **2026-11-03**. Метод: **покомпонентный расчёт** по фактической схеме
(`sch_get_symbols` + `sch_get_connectivity_graph`) с учётом **всех подключаемых
периферийных элементов передней панели**. Все арифметические операции выполнены
инструментом `calculate` (правило AGENTS.md: «в уме считать нельзя»).

Дополняет и уточняет `docs/calculations/power_trace_widths.md` (там токи заданы
«с запасом», здесь — точный покомпонентный разбор).

---

## 1. Дерево питания (факт, по схеме)

```
J_12V_IN_1 (13.8 В от LTC3780)
  └─ VIN_PROT ──► U1 LM2596S-5.0 (buck) ──► +5V
                    │
                    ├─ L3 (феррит) → U2_IN → U2 (RT9193) → +3V3      (MCU+цифра)
                    ├─ L2 (феррит) → +5V_SI → U3 (RT9193) → +3V3_SI → R5(10Ω) → +3V3_SI_F (Si5351+TCXO)
                    ├─ U9 (RT9193) → +3V3_DISP                        (ST7789+подсветка)
                    ├─ D4 PWR-LED (R36=1к)                            (с +5V)
                    └─ панельный PWR-LED (R37=1к)                     (с +5V)
```

Подтверждено по графу связности (ключевые находки):
- **`U8` (74AC541, буфер VFO/BFO) питается от `+3V3`** (пин 20), НЕ от `+5V`.
- **`U7` (LM358) — от `+3V3`** (пин 8).
- **`U9` (LDO дисплея) — напрямую от `+5V`** (пины 1=VIN, 3=EN), без феррита.
- **Подсветка ST7789 — от `+3V3_DISP`**: `+3V3_DISP → Q1(S) → Q1(D) → R35(12Ω) → LCD_BL → J_OLED_1:3`.
- **I²C подтяжки `R3`/`R4` (4.7к) — на `+3V3_SI_F`**, не на `+3V3`.

---

## 2. Покомпонентный разбор токов

### 2.1. Шина `+3V3` (выход U2, RT9193-33)

| Потребитель | Тип. | Макс. | Источник значения |
|---|---|---|---|
| MCU U4 STM32F411CEU6 (HSI 16 МГц, не 100 МГц) | 15 мА | 30 мА | DS10314: Run@16МГц ~3.5–4.5 мА ядро + периферия (I²C+SPI+USART+ADC+TIM) |
| EEPROM U10 AT24C02 | 1 мА | 3 мА | DS: активное чтение/запись ≤3 мА, standby ~1 мкА |
| LM358 U7 (MIC-предусилитель, 1 ОУ) | 1 мА | 1.2 мА | DS: supply current ~0.5–1.2 мА (весь чип) |
| 74AC541 U8 (2 выхода: VFO 37 МГц + BFO 10 МГц) | 10 мА | 20 мА | динамический ток 2 выходов в ~50 Ом тракт (оценка, **замерить**) |
| D6 power-good LED (R40=470Ω) | 2.8 мА | 2.8 мА | (3.3−2.0)/470 |
| Смещение микрофона R23 (2.2к, ~0.5 мА на электрет) | 0.5 мА | 0.5 мА | ток FET электрета |
| Делитель смещения R24/R25 (10к+10к) | 0.17 мА | 0.17 мА | 3.3/20к |
| Подтяжки кнопок/энкодера R6–R14, PTT R31 (idle) | ~0 | ~2 мА | 3.3/10к = 0.33 мА на нажатую линию |
| **ИТОГО `+3V3`** | **30.5 мА** | **60 мА** | |

### 2.2. Шина `+3V3_SI` / `+3V3_SI_F` (выход U3, RT9193-33)

| Потребитель | Тип. | Макс. | Источник значения |
|---|---|---|---|
| Si5351A U5 (2 выхода + 1 PLL) | 22 мА | 45 мА | DS Si5351A: IDD@3.3В, 2–3 выхода |
| TCXO Y2 TG2520SMN 27.6 МГц | 2 мА | 3 мА | DS: supply current CMOS-выход |
| I²C подтяжки R3/R4 (4.7к, `+3V3_SI_F`) | 0.5 мА | 0.7 мА | 3.3/4.7к на заниженную линию (сред.) |
| D7 power-good LED (R41=470Ω, до R5) | 2.8 мА | 2.8 мА | (3.3−2.0)/470 |
| **ИТОГО `+3V3_SI`** | **27.3 мА** | **51.5 мА** | |
| — из них `+3V3_SI_F` (через R5=10Ω) | 24.5 мА | 48.7 мА | без D7 |

> **Падение на R5 (10Ω):** 0.245 В (тип.) / 0.487 В (макс.) → Si5351 получает
> **3.06 В (тип.) / 2.81 В (макс.)**. Нижний предел Si5351A = 2.5 В — запас есть,
> но при макс. токе всего 0.31 В. Привести к замечанию (см. §6).

### 2.3. Шина `+3V3_DISP` (выход U9, RT9193-33)

| Потребитель | Тип. | Макс. | Источник значения |
|---|---|---|---|
| ST7789 логика (VDD) | 10 мА | 15 мА | типовой контроллер+панель 240×320 @3.3В |
| **Подсветка** (Q1 → R35 → BL) | **150 мА** | **200 мА** | BOM §1.4 (документировано) |
| D8 power-good LED (R42=470Ω) | 2.8 мА | 2.8 мА | (3.3−2.0)/470 |
| R34 (100к, затвор) | ~0 | 33 мкА | пренебрежимо |
| **ИТОГО `+3V3_DISP`** | **162.8 мА** | **217.8 мА** | |

> ⚠️ **Подсветка — главная неопределённость всего бюджета.** См. §6, п.1.

### 2.4. Шина `+5V` (выход U1, LM2596S-5.0)

| Потребитель | Тип. | Макс. |
|---|---|---|
| U2 (→ `+3V3`) | 30.5 мА | 60 мА |
| U3 (→ `+3V3_SI`) | 27.3 мА | 51.5 мА |
| U9 (→ `+3V3_DISP`) | 162.8 мА | 217.8 мА |
| D4 PWR-LED (R36=1к) | 3.0 мА | 3.0 мА |
| Панельный PWR-LED (R37=1к) | 3.0 мА | 3.0 мА |
| **ИТОГО `+5V`** | **226.6 мА** | **335.3 мА** |

> TX-LED (D5, R38) и панельный TX-LED (R39) питаются **от линии `PTT` (GPIO
> PA8)**, т.е. уже внутри тока MCU — отдельно не суммируются.

### 2.5. Вход `VIN_PROT` (13.8 В)

Входной ток = `+5V` ток, пересчитанный через КПД buck + собственный Iq LM2596.

- КПД LM2596 (13.8→5 В, нагрузка 0.23–0.34 А): **0.82** (DS, консервативно).
- Iq LM2596: 5 мА (тип.) / 10 мА (макс.).

| Режим | +5V ток | Мощность на выходе | Ток VIN_PROT (через КПД) | + Iq | **Итог VIN_PROT** |
|---|---|---|---|---|---|
| тип. | 226.6 мА | 1.133 Вт | 100.1 мА | 5 мА | **105 мА** |
| макс. | 335.3 мА | 1.677 Вт | 148.2 мА | 10 мА | **158 мА** |

> Пусковой бросок (заряд C1 1000 мкФ) краток и перекрывается медленным
> предохранителем 5 А на корпусе; на steady-state бюджет не влияет.

---

## 3. Сводная таблица (итог)

| Цепь | U | Тип. | Макс. | Регулятор | Запас регулятора (макс.) |
|---|---|---|---|---|---|
| `+3V3` | 3.3 В | 30.5 мА | 60 мА | U2 RT9193 (300 мА) | 5× (20%) |
| `+3V3_SI` | 3.3 В | 27.3 мА | 51.5 мА | U3 RT9193 (300 мА) | 5.8× (17%) |
| `+3V3_DISP` | 3.3 В | 162.8 мА | 217.8 мА | U9 RT9193 (300 мА) | 1.4× (73%) ⚠️ |
| `+5V` | 5 В | 226.6 мА | 335.3 мА | U1 LM2596 (3 А) | 9× (11%) |
| `VIN_PROT` | 13.8 В | 105 мА | 158 мА | (вход) | — |

---

## 4. Передняя панель — явный список потребителей

| Элемент панели | Разъём | Потребление от платы |
|---|---|---|
| Энкодер HW-040 (KY-040) | J_ENC_1 | ~0 (механика; ток только через подтяжки R12–R14 при замыкании, ≤0.33 мА/линия) |
| Джойстик 5-поз. (5 кнопок) | J_BTN_1 | ~0 (механика; подтяжки R6–R11) |
| Кнопка RIT (тактильная) | J_BTN_1 (BTN_RIT) | ~0 (механика; подтяжка R11) |
| **ST7789 2.0"** — логика VDD | J_OLED_1:2 | **10–15 мА** (с `+3V3_DISP`) |
| **ST7789 2.0"** — подсветка BL | J_OLED_1:3 | **150–200 мА** (с `+3V3_DISP`, через Q1+R35) |
| Панельный LED PWR (3 мм, зел.) | J_LED_1:1 | 3.0 мА (с `+5V` через R37) |
| Панельный LED TX (3 мм, красн.) | J_LED_1:2 | ~2.8 мА (с `PTT` через R39, при TX) |
| Панельный LED LIM | (с 02_power_amp, не сюда) | — |

**Итого периферия панели добавляет к бюджету платы:** ~166–218 мА, из них
**~160–215 мА — один только дисплей** (логика + подсветка). Всё остальное —
пренебрежимо (механика).

---

## 5. Проверка разводки (ширины дорожек vs фактические токи)

Ширины по `docs/pcb_layout_stage1.md`: сигнал 0.2 / `+3V3` 0.3 / `+5V` 0.3 / `VIN_PROT` 0.4 мм.

Требуемая ширина (IPC-2221, внешний слой, 1 oz, ΔT=10°C, из `power_trace_widths.md`):
0.5 А → 0.115 мм; 0.25 А → 0.044 мм.

| Цепь | Факт. ток (макс.) | Ширина в разводке | Требуемая | Вердикт |
|---|---|---|---|---|
| `VIN_PROT` | 158 мА | 0.4 мм | 0.03 мм | ✅ с запасом ×13 |
| `+5V` | 335 мА | 0.3 мм | 0.07 мм | ✅ с запасом ×4 |
| `+3V3` | 60 мА | 0.3 мм | 0.01 мм | ✅ |
| `+3V3_DISP` | 218 мА | 0.2 мм (Default) | 0.04 мм | ✅ |
| `+3V3_SI` | 51 мА | 0.2 мм (Default) | 0.01 мм | ✅ |

> Вывод: **все дорожки достаточны**, подтверждено фактическими токами (не
> только запасом). Трассировка `+3V3_DISP` (0.2 мм) при 218 мА допустима, но
> участок `U9.out → Q1 → R35 → J_OLED_1:3` желательно держать коротким и
> широким (см. §6, п.3).

---

## 6. Находки и риски (для bring-up)

1. **Подсветка ST7789 — доминирующая и неопределённая нагрузка.** В документации
   заложено 150–200 мА, но **R35 = 12 Ом на шине 3.3 В физически не даст такой
   ток**: при 200 мА на R35 падает 12×0.2 = **2.4 В**, на светодиоды остаётся
   ~0.9 В — подсветка не загорится. Реалистичная оценка:
   - один белый LED (~3.0 В): (3.3−3.0)/12 ≈ **25 мА**;
   - несколько LED в параллель: ~40–60 мА.
   → **R35 — заглушка; фактический ток подсветки замерить амперметром на
   bring-up и подобрать R35** (это уже отмечено в BOM §1.4). До замера считать
   худший случай 200 мА.

2. **Тепловой режим U9 (RT9193, SOT-23-5) при подсветке 200 мА.** P =
   (5−3.3)×0.218 = **0.37 Вт**. При θJA ≈ 230 °C/Вт (SOT-23-5) подъём **~85 °C**
   → в корпусе (T_amb 50–60 °C) переход приближается к пределу 125 °C. При
   реалистичной подсветке 50–60 мА (P ≈ 0.11 Вт) — проблемы нет. **Если
   подсветка реально окажется >150 мА — рассмотреть** перевод подсветки на
   `+5V` напрямую (мимо U9) или LDO в более крупном корпусе.

3. **Запас U9 по току 73%** — электрически в норме (RT9193 = 300 мА), но это
   самый нагруженный LDO на плате; остальные (U2 20%, U3 17%) — с большим
   запасом.

4. **`U8` (74AC541) реально сидит на `+3V3`** (пин 20), чего не было в старом
   бюджете `power_trace_widths.md`. Динамический ток 2 выходов (VFO 37 МГц +
   BFO 10 МГц в ~50 Ом) оценён в 10–20 мА — **замерить** при bring-up, т.к. он
   зависит от реального импеданса входа смесителя этапа 3.

5. **MCU работает от HSI 16 МГц** (внешний кварц удалён), поэтому старый бюджет
   «100 мА» завышен в ~3–7 раз: реально 15–30 мА. Это освобождает запас U2.

6. **R5 (10 Ом) в питании Si5351** даёт при макс. токе падение 0.49 В → на
   Si5351 остаётся 2.81 В (предел 2.5 В). Запас 0.31 В — приемлемо, но не
   увеличивать R5; при малейших проблемах зарядки Si5351 проверить это
   напряжение первым.

---

## 7. Статус

Расчёт выполнен по фактической схеме (`sch_get_connectivity_graph`), все суммы —
инструментом `calculate`. Итог: **плата в steady-state потребляет ~105 мА от
13.8 В (тип.) / ~160 мА (макс.)**, что существенно ниже прежнего запаса 0.5 А.
Ширины дорожек подтверждены. Главный риск — подсветка дисплея (200 мА) и
тепло U9; до bring-up считать худший случай.
