okunevpy-create/TRX_27MHz/docs/calculations/power_trace_widths.md

# Ширины силовых цепей — 01_control (расчёт)

Дата: **2026-10-31**. Метод: **IPC-2221**, внешний слой, **1 oz (35 мкм)**, ΔT = 10 °C.
Источник токов — BOM (`docs/bom/stage1_control.md`) и фактические имена цепей со схемы
(`sch_get_net_names`).

## Дерево питания и токи (с запасом)

| Цепь | U | Потребители | Ток (запас) |
|---|---|---|---|
| `VIN_PROT` | 13.8 В | вход LM2596S-5.0 (buck 5 В) | **0.5 А** (ном. ~0.2 А + пусковой бросок) |
| `+5V` (вых. LM2596) | 5 В | U2 (120 мА) + U3 (50 мА) + U9 (213 мА) + LED (~6 мА) | **0.5 А** |
| `U2_IN` (через L3) | 5 В | вход U2 (LDO 3.3 В) | ~0.12 А |
| `+5V_SI` (через L2) | 5 В | вход U3 (LDO 3.3 В) | ~0.06 А |
| `+3V3` | 3.3 В | MCU (100 мА) + EEPROM (3) + LM358 (2) + LED (3) | **0.15 А** |
| `+3V3_SI` / `+3V3_SI_F` | 3.3 В | Si5351 (40 мА) + TCXO (3) + LED (3) | **0.08 А** |
| `+3V3_DISP` | 3.3 В | ST7789 логика (10 мА) + подсветка (200 мА) + LED (3) | **0.25 А** |
| `VDDA` | 3.3 В | аналоговое питание MCU (входит в 100 мА MCU) | ~0.02 А |

> Детализация токов:
> - **MCU STM32F411** — до 100 мА (ядро 100 МГц + периферия).
> - **Si5351A** — до 40 мА (3 выхода).
> - **Подсветка ST7789** — 150–200 мА (через Q1/R35 с `+3V3_DISP`, BOM §1.4).
> - **LED** — ~3 мА каждый (3.3 В / 470 Ом).

## Расчёт ширины (IPC-2221, внешний слой, 1 oz, ΔT = 10 °C)

| Ток | Требуемая ширина |
|---|---|
| 0.5 А | 0.115 мм |
| 0.25 А | 0.044 мм |
| 0.15 А | 0.022 мм |
| 0.08 А | 0.009 мм |

## Вывод

Все токи ≤ 0.5 А → требуемые ширины **меньше 0.2 мм**. Дефолтный минимум **0.2 мм
достаточен для всех силовых цепей**.

Падение напряжения (худший случай): `+5V`, 0.5 А, 0.2 мм × 60 мм → **76 мВ**
(ΔT = 4.1 °C, PASS). Для RT9193 (LDO) запас по входному напряжению сохраняется.

## Рекомендованные net-классы (для разводки)

| Цепь | Ширина | Примечание |
|---|---|---|
| Сигнал | **0.2 мм** | дефолт |
| `+3V3`, `+3V3_SI`, `+3V3_DISP`, `+5V_SI`, `U2_IN`, `VDDA` | **0.2 мм** | ток ≤ 0.25 А |
| `+5V` | **0.3 мм** | комфорт (0.5 А, меньше падение) |
| `VIN_PROT` | **0.4 мм** | запас на пусковой бросок (заряд C1 1000 мкФ) |
