okunevpy-create/TRX_27MHz/.continue/rules/kicad-custom-symbols-location.md

---
description: "Расположение кастомных символов и footprint'ов KiCad: MCP пишет
  в output, агент ничего не переносит — пользователь сам размещает компонент
  в нужном месте; каноническая папка хранения библиотек — KiCad/libs."
alwaysApply: true
---

Сгенерированные кастомные символы KiCad (.kicad_sym) и посадочные места (.kicad_mod) MCP-инструменты пишут в output/ проекта. Агент НИЧЕГО НИКУДА НЕ ПЕРЕНОСИТ и не копирует: пользователь сам добавляет компонент в нужное место вручную в GUI KiCad. Каноническая папка хранения кастомных библиотек — KiCad/libs (символы — KiCad/libs/symbols, footprint'ы — KiCad/libs/footprints, 3D-модели — KiCad/libs/3dmodels); регистрацию в sym-lib-table/fp-lib-table при необходимости выполняет пользователь.
