okunevpy-create/TRX_27MHz/.continue/rules/wires.md

---
globs: '["**/*.kicad_sch"]'
description: "Правило для схемотехники KiCad: если провода (wires) получаются
  слишком длинными или их не удаётся развести без пересечений/наложений,
  использовать локальные или глобальные метки (labels / global labels) вместо
  прокладки длинных проводов."
alwaysApply: false
---

При проектировании схемы в KiCad, если провод (wire) получается слишком длинным либо его не удаётся развести без наложений/пересечений, не тянуть длинный провод — соединять цепи по имени с помощью локальных меток (local labels), а для межлистовых/межблочных соединений — глобальных меток (global labels). Одинаковое имя метки = одна цепь. Предпочитать этот подход длинной запутанной разводке.
