okunevpy-create/TRX_27MHz/Mechanical/README.md

# Mechanical — корпусирование (этап 4)

Корпус станции: **3D-печать, ABS**, сборка **шип/паз (без винтов)**.
Компоновка — **Вариант B «рация-коробка»** (не 1-DIN).

## Что делаем / что НЕ делаем

**Делаем:** внешнюю оболочку — передняя панель (корытце) + верхняя/нижняя скорлупы (крышка+боковины / дно+боковины) + задняя крышка-заглушка + сборочный макет. Радиатора на задней крышке нет (охлаждение УМ — радиатор HS 104-30 на плате `02_power_amp`).

**НЕ делаем:** внутреннюю компоновку. Платы (`01_control`, `02_power_amp`, `03_rx_tx`) ещё в разработке, кабель-менеджмент неизвестен. Крепления плат, стойки, кабельные каналы — **не прорабатываются** на этой итерации.

## Документы

| Файл | Назначение |
|---|---|
| [`requirements.md`](requirements.md) | Зафиксированные требования (что и почему) |
| [`params.py`](params.py) | **ЕДИНСТВЕННЫЙ** источник числовых параметров |
| `scripts/` | Скрипты генерации геометрии (FreeCAD Python) |
| `enclosure/` | Исходники `.FCStd`, `exports/` — `.stl` / `.step` |
| `mounting/` | Кронштейны, крепления в авто (4.4) |
| `drawings/` | 2D-чертежи, скриншоты, PDF |

## Статус деталей

| Деталь | Файл | Статус |
|---|---|---|
| Передняя панель (корытце) | `enclosure/front_panel.FCStd` | **готово**, 186 × 13.4 × 56 мм, STEP чистый |
| Верхняя скорлупа (крышка + боковины) | `enclosure/shell_top.FCStd` | **готово**, галтель R2.5, жабры |
| Нижняя скорлупа (дно + боковины) | `enclosure/shell_bottom.FCStd` | **готово**, галтель R2.5, жабры |
| Задняя крышка | `enclosure/back_cover.FCStd` | **готово**, 186 × 56, язычки в задние пазы |

### Передняя панель — конструктив

Передняя панель — **корытце**: фронтальная плита 2.4 мм + стенки по контуру
3.0 мм глубиной 11 мм. Соединение с дном/крышкой/боковинами — **паз +
язычок** (язычок принадлежит будущим деталям).

* **Пазы** — выемки **со стороны полости**, 11 × 11 мм, высота выреза 1.5 мм
  (стенка остаётся 1.5 + 1.5 = 3.0). Снаружи стенка гладкая. 8 шт:
  верх 2, низ 2, боковины по 2 (верх/низ — под верхнюю и нижнюю скорлупы).
* **Саморез** M3 вкручивается снаружи сквозь язычок скорлупы в **закладную
  гайку** на бобышке панели. Конусная зенковка (потайная головка) — на
  наружной грани язычка скорлупы.
* **Бобышки** под гайку M3 (Ø8 × 4 мм) — на внутренней стороне стенки, за
  пазом. Карман под гайку и отверстие под винт — **сквозные**, строго
  в пределах бобышки/стенки, за габариты не выходят.
* **Углы контура** — R2.5 (`CORNER_R`).
* **Раскладка по X** — явные координаты (слева направо): **гарнитура → экран →
  джойстик → энкодер → кнопка RIT → тумблер LIMIT/FULL → тумблер питания**.
  Координаты — `params.py` (секции 4/4a).
* **Светодиоды (PWR/TX/LIM)** — горизонтальной линией **наверху** (над
  джойстиком/энкодером/RIT) — `params.py` секция 8.
* **Тумблер питания** KN3(B)-101A-A1 (ON-OFF, 10A 250VAC, SPST): Ø12.2 +
  цековка под гайку Ø16. Размещён справа.
* **Тумблер LIMIT/FULL** ASW-14-102 (ON-ON, SPDT 3P, 20A 12VDC): Ø12.2 +
  цековка Ø16 (посадочное «по типу» тумблера питания, **TBD по факту детали**).
  Рядом с тумблером питания (`params.py` секция 9b).

### Статус выпуска

```
bad faces   0        BOP check   CLEAN
volume      35 659.0 мм³          solids 1, valid
outer fillet R2.0 (лицевая кромка), STEP без InvalidCurveOnSurface
```

### Скругления

**Наружная галтель — сделана.** `OUTER_FILLET = 2.0` — галтель по всему
периметру лицевой стороны (кромка «фронтальная плита → стенки», 4 прямые
+ 4 дуги углов). Торец открытого конца (стык с дном/крышкой/боковинами)
и внутренние переходы не затрагиваются.

Ключ к работоспособности — **порядок операций**: `makeFillet` наносится
на простую призму ДО выреза полости и прочих элементов. Нанесение по телу
с вырезами давало дефекты (потеря объёма ~850 мм³, «пропавшие» отверстия,
`InvalidCurveOnSurface` в STEP). В правильном порядке:
- заготовка (призма + галтель) — valid, 1 solid;
- финал — valid, 1 solid, **36 290.2 мм³** (галтель R2 убирает ~409.4 мм³ с
  периметра лицевой стороны);
- BOP check — CLEAN, STEP пишется без `InvalidCurveOnSurface`.

**Внутреннее скругление (`BASIN_FILLET`) — по-прежнему отключено (0.0).**
Переход «пол → стенка» внутри корытца остаётся под 90°. Это отдельная
задача, на посадочные места не влияет.

### Скорлупы (верхняя/нижняя) — конструктив

Вместо 6 деталей — 3: передняя панель + две скорлупы. Скорлупы флеш с
корытцем (наружный габарит 186 × 56 мм), стенка 3 мм.

* **Верхняя скорлупа** (`shell_top`) = крышка + верхние половины левой/правой
  боковин. **Нижняя** (`shell_bottom`) = дно + нижние половины боковин.
* **Шов** скорлуп — горизонталь на Z=25 (середина высоты), **«1 язычок + 1 паз»
  на каждой скорлупе** (зазор `SEAM_CLEAR`): верхняя — язычок ВНИЗ слева +
  паз ВВЕРХ справа, нижняя — зеркально. Без винтов.
* **Соединение с передней панелью** — **язычки** скорлуп (внешние 1.5 мм
  стенки, продолженные вперёд) входят в пазы корытца + **саморез M3 сквозь
  язычок в закладную гайку бобышки панели** (конусная зенковка на наружной
  грани язычка).
* **Задняя крышка** (отдельная деталь) — её **8 язычков** входят в **8 задних
  пазов** скорлуп (2 сверху + 2 снизу + 2 слева + 2 справа, зеркально передней
  панели): паз + отверстие под винт + бобышка под гайку (по аналогии с передней).
* **Жабры** — в боковинах (верх и низ), сетка `VENT_ROWS × VENT_COLS`.
* **Зад** закрывается задней крышкой (отдельная деталь, 8 язычков).

**Скругление скорлуп:** галтель `SHELL_FILLET = 2.5` (нативный `makeFillet`) по
двум продольным рёбрам «крышка ↔ боковина» (верх: z=+53; низ: z=−3). Наносится
на простую призму ДО выреза полости. Шов и торцы (стык с панелью, открытый зад)
не скругляются.

Статус выпуска скорлуп: `shell_top` — 102 984.0 мм³, `shell_bottom` —
102 981.8 мм³, оба 1 solid, BOP CLEAN. Попарные пересечения четырёх тел сборки —
0 (язычки/шипы заполняют пазы без наложения).

### Стойки под плату `01_control` (на дне нижней скорлупы)

Плата `01_control` — **120 × 66 мм**, монтируется горизонтально на дне
(плоскость X-Y). 4 монтажных отверстия H1–H4 (Ø3.2 мм, M3) — по факту разводки
(`docs/pcb_layout_stage1.md` §«Монтажные отверстия»).

* Стойки печатаются вместе с нижней скорлупой: бобышки **Ø8** + пилот под
  самонарез M3 (Ø2.5), высота **6 мм** (по `pcb_placement_plan.md` §6).
* Координаты и габарит — `params.py` секция **17** (`BOARD1_*`,
  `board1_hole_positions()`); позиция платы в корпусе — `BOARD1_ORIGIN_X/Y`
  (**TBD**, черновая: по центру ширины, у передней панели).
* Стойки добавляются только к `shell_bottom` (функция `board1_mount_features()`
  в `build_shells.py`).

### Задняя крышка — конструктив

Плоская панель **186 × 56** (углы R2.5, `CORNER_R`), толщина `T_BACK` = 2.4 мм.
Закрывает задний проём, выступая назад от торца скорлуп (y=160).

* **8 язычков** (2 сверху + 2 снизу + 2 слева + 2 справа) входят в задние пазы
  скорлуп — зеркально 8 пазам передней панели. Язычок = `GROOVE_W` (11 мм),
  паз в скорлупе = `GROOVE_W + GROOVE_CLEAR` (зазор 0.2 мм под печать).
* **Винт M3 Ø3.4** проходит сквозь язычок (ось Z сверху/снизу, ось X слева/справа)
  в бобышку скорлупы. Конусная зенковка (потайная головка) — на наружной грани,
  винт снаружи внутрь (по аналогии с передней).
* Радиатора на задней крышке нет — охлаждение УМ радиатором HS 104-30 на плате `02_power_amp`.

Статус выпуска: `back_cover` — **26 211.6 мм³**, 1 solid, BOP CLEAN. Попарные
пересечения четырёх тел сборки — 0 (язычки входят в пазы без наложения).

### Сборочный макет

`Mechanical/scripts/build_assembly.py` собирает в один документ
(`enclosure/assembly.FCStd`) все 4 детали + **схематичные модели органов
управления** (простые боксы/цилиндры): экран ST7789, энкодер HW-040, джойстик,
тумблер KN3, 3 светодиода, 2 гнезда гарнитуры, кнопка RIT. Габариты моделей —
placeholder в `params.py` (секция 16), уточняются по фактическим компонентам.

Экспорт: `exports/assembly.stl` + `exports/assembly.step` (сводная сборка).

## Подэтапы
- **4.1** — Корпус (передняя панель-корытце + две скорлупы)
- **4.2** — Передняя панель (окно экрана, энкодер, джойстик; разъёмы гарнитуры Kenwood 2-pin — резерв)
- **4.3** — Задняя панель (антенный разъём BNC, разъём питания)
- **4.4** — Крепления в автомобиль
- **4.5** — Вентиляция (жабры в боковинах)

## Параметризация — правило

Все размеры — **только в `params.py`**. Никаких «магических чисел» в скриптах.
Посадочные отверстия (антенна, экран, энкодер, джойстик) — отдельные переменные,
чтобы менять диаметр/положение одной правкой.

Проверка инвариантов раскладки:
