okunevpy-create/TRX_27MHz/KiCad/02_power_amp/README.md

# 02_power_amp — усилитель мощности (этап 2)

## Подэтапы
- **2.1** — Драйвер + 2× RD16HHF1 (push-pull, класс AB)
- **2.2** — ФНЧ 27 МГц (5-го порядка)
- **2.3** — Датчики тока/КСВ + тумблер LIMIT/FULL + подстроечник + светодиод + вход PWR_LIMIT_EN + выход PWR_LIMIT_SW
- **2.4** — Тепловой расчёт + радиатор

## Назначение
- ~10–15 Вт на 50 Ом при раскачке ~0,5 Вт.
- В AM — ограничение до 4 Вт (тумблер LIMIT + подстроечник).
- Питание: 12 В напрямую через LC-фильтр.
- Радиатор обязателен.

## T/R switch и антенна
- **Реле на `02_power_amp`**, антенный разъём J_ANT_1 — здесь.
- Управление — PTT с `01_control`.

## Контракт
- `docs/contracts/control_pa.md` — PTT, I_sense, SWR_sense, PWR_LIMIT_EN, PWR_LIMIT_SW, 12 В.

## Связь с этапом 1
Подэтап **2.3** разводится совместно с **1.5**, до изготовления платы этапа 1.

## Статус
Заготовка. Схемотехника 2.1–2.2 — после 1.4.
