okunevpy-create/TRX_27MHz/docs/contracts/README.md

# Интерфейсные контракты

Контракт фиксирует сигналы на межмодульном разъёме **до** разводки плат. Это **предварительное условие**, а не этап. Меняется только по явному согласованию.

## Правила
- Каждый контракт — отдельный файл.
- Таблица: сигнал, направление, уровень, тип, разъём/пин.
- При изменении — обновить контракт, затем обе платы.
- Если контракт не зафиксирован — разводку не начинать.

## Список
- [control_pa.md](control_pa.md) — этап 1 ↔ этап 2 (фиксируется первым)
- [control_rxtx.md](control_rxtx.md) — этап 1 ↔ этап 3 (фиксируется до этапа 3)
