okunevpy-create/TRX_27MHz/Mechanical/requirements.md

# Требования к корпусу (этап 4) — зафиксированы

> **Статус:** зафиксировано, прототип (v0). Меняется только по явному согласованию.
> **Источник числовых значений — ТОЛЬКО `Mechanical/params.py`.** Этот документ объясняет *что* и *почему*, а не хранит цифры.

## 0. Рамки работ (важно)

**Прорабатываем только внешнюю оболочку:** передняя панель (корытце) + две скорлупы (верхняя/нижняя) + задняя крышка (заглушка). Радиатора на задней крышке нет (охлаждение УМ — радиатор HS 104-30 на плате `02_power_amp`).

**Внутренняя компоновка НЕ прорабатывается.** Платы (`01_control`, `02_power_amp`, `03_rx_tx`) находятся в разработке, кабель-менеджмент неизвестен. Крепления плат, отверстия под стойки, кабельные каналы — **не делаем**. Оставляем внутренний объём пустым; при необходимости крепления добавляются на следующей итерации.

## 1. Технология и материал

| Параметр | Значение |
|---|---|
| Технология | **3D-печать (FDM)** |
| Материал | **ABS** |
| Усадка ABS | ~0.6–0.8% — учитывать в допусках посадок (заложено в `params.py`) |
| Минимальная стенка | см. `params.py` (`T_WALL`, `T_LID`) |

## 2. Компоновочный вариант

**Вариант B — «рация-коробка»** (аналог автомобильной CB-рации, не 1-DIN).

Обоснование: экран ST7789 2.0" имеет габарит платы 37.5 × 58.04 мм; при DIN-габарите 180×50 он не помещается по высоте в portrait-ориентации. Формат «коробка» даёт место под экран + энкодер + джойстик и оставляет резерв под будущие органы управления.

## 3. Разбивка на блоки (модульность)

Каждая часть — **отдельный body / отдельный `.stl`**. Это упрощает печать (нет поддержек в глубине), замену одной детали и доработку.

| # | Блок | Описание |
|---|---|---|
| 1 | **Передняя панель (корытце)** | Экран, энкодер, джойстик, органы управления |
| 2 | **Верхняя скорлупа** | Крышка + верхние половины левой/правой боковин (жабры) |
| 3 | **Нижняя скорлупа** | Дно + нижние половины боковин (жабры) |
| 4 | **Задняя крышка** | Заглушка заднего проёма, язычки в задние пазы скорлуп |

Радиатора на задней крышке нет — задняя крышка финальная заглушка; охлаждение УМ — радиатор HS 104-30 на плате.

## 4. Сборка

- Соединение скорлуп между собой — **шип/паз** по шву (горизонталь на середине высоты, Z=25), **«1 язычок + 1 паз» на каждой скорлупе**, **без винтов**.
- Соединение скорлуп с передней панелью — **язычки скорлуп в пазы корытца** (скрытое соединение «внешние 1.5 мм стенки») + **саморез M3 сквозь язычок в закладную гайку бобышки панели** (конусная зенковка на наружной грани язычка).
- Задняя крышка — язычки крышки входят в **пазы на верхней/нижней грани скорлуп** (паз + отверстие под винт + бобышка под гайку), по аналогии с передней панелью.
- Крепёж/бобышки M3 на передней панели — используются как ответная часть для саморезов язычков скорлуп.

## 5. Внешние элементы на передней панели

Гарантированно:

| Элемент | Посадочное | Примечание |
|---|---|---|
| **Экран ST7789 2.0"** | окно под активную область + 4 стойки M3 по посадочным отверстиям | габарит платы 37.5×58.04, отверстия Ø3.0, межцентровые 31.0×53.4 |
| **Энкодер HW-040 (KY-040)** | отверстие под вал + паз под язычок-фиксатор + гайка | размеры — типовые (см. `params.py`) |
| **Джойстик 5-поз.** | отверстие под штырёк Ø8 мм + 4 отверстия M2 под плату 20×25 мм | **фактические Ø/высота штырька — TBD, замерить по получении** |
| **Тумблер питания KN3(B)-101A-A1** | отверстие Ø12.2 + цековка под гайку Ø16 | ON-OFF, 10A 250VAC, SPST (2 вывода) |

Остальные органы управления — **резерв**, на прототипе не размещаем.

## 6. Охлаждение УМ (не на корпусе)

Радиатора на задней крышке корпуса **НЕТ**. Охлаждение усилителя мощности — радиатор **HS 104-30** (30×102×24.5 мм, Rth 3.1 °C/Вт, общий на 2× TO-220 RD16HHF1, изолированный монтаж), монтируется на плате `02_power_amp`, а не на корпусе. Тепловой расчёт — `docs/calculations/pa_stage2.md` §5. Задняя крышка — финальная заглушка (отверстия только под разъёмы).

## 7. Вентиляция

**Боковины скорлуп — воздухозаборные жабры.** Жалюзи/жабры в левой и правой стенках (верхняя и нижняя половины). Отдельный вентилятор на прототипе не предусматривается. Сплошных отверстий в крышке/дне не делаем.

## 8. Параметризация — КРИТИЧНО

Все числовые значения (габариты, толщины, диаметры отверстий, координаты, допуски, зазоры) хранятся **в одном файле `Mechanical/params.py`**.

Требования к параметризации:

- Каждое посадочное отверстие — **переменная** (например, `ANT_HOLE_D`), чтобы быстро поменять «диаметр под выход антенны» и т.п.
- Ни одна геометрическая величина в скриптах **не должна быть магическим числом** — только через `params.py`.
- TBD-величины помечены явно и собраны в отдельный блок, чтобы их было видно и легко заменить после замеров.
- Внешние скругления унифицированы: `CORNER_R = SHELL_FILLET = 2.5 мм` (радиус углов контура = радиус галтели «крышка ↔ боковина» скорлуп).

## 9. Инструмент и структура скриптов

| Что | Где |
|-----|-----|
| Параметры | `Mechanical/params.py` |
| Скрипты генерации геометрии | `Mechanical/scripts/*.py` (FreeCAD Python) |
| Исходники `.FCStd` | `Mechanical/enclosure/*.FCStd` |
| Экспорты | `Mechanical/enclosure/exports/*.stl`, `*.step` |
| Чертежи/скриншоты | `Mechanical/drawings/` |

Скрипты должны запускаться:

- из GUI FreeCAD (Macro → Execute), и
- из консоли: `freecadcmd Mechanical/scripts/<script>.py` (с добавлением пути к `Mechanical/` в `sys.path`).

Экспорт — автоматически в `enclosure/exports/`.

## 10. Открытые вопросы (TBD, не блокируют прототип)

| # | Вопрос | Что делать |
|---|---|---|
| 1 | Ø и высота штырька джойстика | замерить по получении → `params.py` |
| 2 | Реальные габариты энкодера/вала | замерить по получении → `params.py` |
| 3 | Тип и габарит антенного разъёма — **решено: BNC** | `ANT_CONN_TYPE="BNC"`, `ANT_HOLE_D=9.5` |
| 4 | Тип разъёма внешнего питания — **решено: KLS1-DC-025A-2.0 (DS-046C)** | DC jack 2.0×5.5 мм, панельный, с гайкой |
| 5 | Колпачок джойстика и окантовка панели | отложено (отдельная задача) |
| 6 | Монтажные отверстия/крепления плат | не делаем (платы в разработке) |
