okunevpy-create/TRX_27MHz/docs/power-distribution.md

# Распределение питания

## Принцип
Общая только защита. Стабилизация — локально на каждом модуле.

## Входной узел (на плате этапа 1)
12 В (бортсеть/АКБ) → DC-джек → тумблер PWR (разрыв +12V) → **предохранитель 5 А (перенесён с платы на корпус)** + **TVS load dump** + **диод реверса** → **LTC3780 (buck-boost, заводская плата, выход 13,8 В, 7 А ном.)** → `J_12V_IN_1` → электролит ≥1000 мкФ + керамика 0,1–1 мкФ → шина 12 В (номинал, фактически 13,8 В).

> LTC3780 — заводская buck-boost плата **до** `01_control`, ничего не заменяет
> (LM2596S-5.0 на плате — как есть). **Вход LTC3780 ≤ 32 В**, поэтому
> входная защита (TVS load dump + диод + предохранитель) перед ним обязательна.
> **Предохранитель F1 и входные TVS/диод (D1/D2) с `01_control` убраны** — их роль
> выполняет входная защита на корпусе (5 А + TVS load dump + SS54). Раздача 12 В
> на другие платы **снята с платы**, вынесена на WAGO.
> Подробнее — `pcb_placement_plan.md`.

## Плата этапа 1 (`01_control`)
- Вход: защищённые 12 В.
- **LM2596S-5.0** (TO-263) → LC-фильтр → 5 В.
- **LDO 3,3 В** (AMS1117-3.3 или RT9193-33) → 3,3 В.
- **Отдельная ветка `+3V3_SI`**: от 5 В → LC-фильтр → отдельный LDO 3,3 В только для Si5351.
- Джамперы по питанию для поэтапной отладки.

## Плата этапа 2 (`02_power_amp`)
12 В (с WAGO, факт. 13,8 В) → LC-фильтр → напрямую, без стабилизатора. Датчик тока и КСВ (подэтап 2.3).

## Плата этапа 3 (`03_rx_tx`)
12 В (с WAGO, факт. 13,8 В) → LM7809 (аналог) → 9 В → локальные LDO 5 В / 3,3 В.

## Раздача 12 В — внешние клеммы WAGO (2026-10-31)
Раздача `+12V` (номинал 12 В, фактически **13,8 В** от LTC3780) **снята с платы `01_control`** — убраны `J_PA_PWR_1`, `J_RXTX_PWR_1` и 0Ω-звезда R29/R30. Вместо этого — внешняя коммутация клеммами **WAGO 221-415** (5-проводные, 32 А / 450 В, 0.14–4 мм²).

Топология:
- **+12V**: один WAGO 221-415 — провода от LTC3780, `01_control` (`J_12V_IN_1`), `02_power_amp`, `03_rx_tx` (4 провода, 1 свободная клемма).
- **GND**: отдельный WAGO 221-415 — те же 4 провода.

На `01_control` остаётся только свой вход: `J_12V_IN_1 → VIN_PROT → C1/C2 + U1(LM2596S-5.0)`. Входные D1 (TVS)/D2 (SS34) **сняты** — вся защита на корпусе.

Влияние 13,8 В вместо 12 В (изменений схемы не требуется):
- **02_power_amp** (напрямую на RD16HHF1, через LC): 13,8 В в пределах «12–14,5 В» (`contracts/control_pa.md`). Мощность/смещение задаёт ограничитель (VGG/RV1).
- **03_rx_tx** (LM7809 → 9 В): запас 4,8 В, в норме.
- **Ревью-пункт:** конденсаторы на шинах `+12V_PA`/`+12V_RXTX` ≥16 В (уже рассчитаны на 14,5 В макс).

## Ограничение мощности AM
Физический тумблер LIMIT/FULL на `02_power_amp` управляет смещением RD16HHF1. В положении LIMIT — не более 4 Вт (несущая). Подробности — `contracts/control_pa.md`.

## Запрещено
- AMS1117-5.0 от 12 В (перегрев).
- Питание Si5351 от общего 3,3 В без отдельного LDO/LC.
