okunevpy-create/TRX_27MHz/docs/channels.md

# Каналы и сетки

Шаг перестройки: **5 кГц**.

## Европейская сетка (EU)
Каналы от 26,965 МГц с шагом 10 кГц (и 5 кГц для «промежуточных»).

## Русская сетка (RUS)
Сдвиг **−5 кГц** относительно EU.
Пример: 15-й канал дальнобойщиков — **27,135 МГц** (в EU был бы 27,140).

## Радиолюбительские частоты
- Вызывная SSB: **27,190 МГц**.

## Хранение
Память каналов во внутренней Flash STM32F411 (эмуляция EEPROM через сектор).
Формат записи: TBD при разработке прошивки.
