okunevpy-create/TRX_27MHz/docs/equipment.md

# Измерительное оборудование

## Есть
- (заполнить)

## Нужно / желательно
- Осциллограф (полоса ≥ 50 МГц).
- Частотомер (до 50 МГц).
- Генератор сигналов (или Si5351 как источник).
- КСВ-метр / эквивалент нагрузки 50 Ом (≥ 20 Вт).
- Мультиметр.
- SDR-приёмник (RTL-SDR) — как панорама и анализатор спектра.
- Антенный анализатор (опционально).

## Статус
Заготовка. Заполняется по мере приобретения.
