okunevpy-create/TRX_27MHz/docs/calculations/pa_stage2.md

# УМ этапа 2 — расчёты и проектные решения

Покрывает подэтапы 2.1 (push-pull RD16HHF1, трансформаторы), 2.3 (смещение/лимитер, датчики) и 2.4 (теплоотвод).

## 1. Целевые параметры
| Параметр | Значение |
|---|---|
| Питание | `+12V_PA` — номинал 12 В, факт. **13,8 В** от LTC3780 через внешние WAGO 221-415 |
| Выход SSB (PEP) | до 12 Вт (норма РФ, пиковая) |
| Выход AM (несущая) | ≤ 4 Вт (обязательный ограничитель) |
| Раскачка | ~0.5 Вт (`TX_RF`, 50 Ом, контракт `rxtx_pa.md`) |
| Класс | AB (push-pull, 2× RD16HHF1) |
| Нагрузка | 50 Ом |

## 2. Выходной каскад и трансформаторы (2.1)
### 2.1 Выбор транзистора
**RD16HHF1** (Mitsubishi): N-MOSFET, `VDS=30 В`, `ID=4 А`. По даташиту: **Po=16–19 Вт, ηD=55–65 %** (условия: `VDD=12.5 В, Pin=0.4 Вт, f=30 МГц, Idq=0.5 А`), **`Rth_j-c=2.2 °C/Вт`**. Пара в push-pull даёт 16–19 Вт на 50 Ом; в проекте ограничена нормами РФ — SSB ≤12 Вт PEP, AM ≤4 Вт (несущая).

**Корпус:** **TO-220**, но **цоколёвка НЕСТАНДАРТНАЯ: 1=GATE, 2=SOURCE, 3=DRAIN, 4=FIN(SOURCE)** — вывод 2 = **Source** (а не Drain), вывод 3 = **Drain** (а не Source), фланец = Source. Footprint штатный (`TO-220-3`); нюанс только в нумерации пинов символа. **Риск — доступность (возможен EOL):** альтернативы — RD15HVF1 (TO-220), RD06HVF1 (TO-220, меньшая мощность), BJT 2SC2078/2SC1971 (TO-220).

**Драйвер (раскачка) — РЕШЕНО: НЕ НУЖЕН.** По даташиту RD16HHF1 (single-ended, VDD=12.5 В, f=30 МГц, Idq=0.5 А): Po=16–19 Вт при Pin=0.4 Вт → усиление 16.0–16.8 дБ. Для push-pull 12 Вт PEP (по 6 Вт на транзистор) требуется Pin ≈ 6/40 ≈ 0.15 Вт на транзистор → 0.3 Вт суммарно; раскачка `TX_RF` = 0.5 Вт даёт запас ×1.67 (+2.2 дБ). Активный драйвер не ставим; место/пады зарезервировать (не монтировать).

### 2.2 Сопротивление нагрузки (push-pull, класс AB)
Для одного плеча в классе AB при напряжении питания `Vdd` и мощности `Po`:
`RL = Vdd² / (2·Po_на_плечо)`.

Для `Po=12 Вт` (по 6 Вт на плечо, `Vdd=12 В`):
`RL = 12² / (2·6) = 12 Ом` на плечо.

Между стоками (двухтактно) нагрузка `RL_dd = 2·RL = 24 Ом` (каждое плечо видит половину).

### 2.3 Выходной трансформатор T2
Преобразует `24 Ом (сток-сток)` → `50 Ом` (несбалансированный выход). Коэффициент импеданса `k = 50/24 ≈ 2` → отношение витков `n ≈ √2 ≈ 1.4` (практически 1:1 или 2:1 в зависимости от намотки). Центральный отвод первички — на `+12V_PA` через RFC. Сердечник — **BN-61-202** (бинокуляр, феррит 61), бифилярная намотка.

> Точное число витков/коэффициент подбирается на готовой плате (материал 43 — 10–50 МГц). Место под 1:1 и 2:1 — зарезервировать.

### 2.4 Входной трансформатор T1
Согласует `TX_RF` (50 Ом, несбаланс.) с затворным контуром пары (балансный вход). Бифилярный балун на **BN-61-202** (1:1 или 4:1). Затворные резисторы **R_g 4.7–10 Ом** — антипаразитное гашение (предотвращает самовозбуждение на ВЧ). Опционально отрицательная ОС **R_fb 100–220 Ом** (сток→затвор) для устойчивости и линейности.

### 2.5 RFC (дроссель питания стоков)
Индуктивность 4–6 мкГн на ток ~2 А. Тор **T68-2** (iron powder №2), ~26–32 витка. Параллельно питанию — электролит **C_bulk_pa 470 мкФ/25 В** + керамика **10 мкФ** и **100 нФ** (развязка ВЧ).

### 2.6 Сердечники: AL, расчёт витков и готовые варианты
**AL** — индуктивность одного витка² сердечника. Индуктивность намотки: `L = AL · N²` → число витков `N = √(L / AL)`.

> **Соглашение AL:** в Amidon/Micrometals AL указывается как «мкГн на 100 витков». Пересчёт в «нГн/вит²»: `AL[нГн/вит²] = AL[мкГн/100вит] × 10` (100² = 10⁴; 1 мкГн = 10³ нГн). Пример: 40 мкГн/100вит → 4.0 нГн/вит².

**Мотаем (тип провода зафиксирован — 2 бухты) и число витков (посчитано инструментами):**
| Элемент | Сердечник | Провод (ПЭВ-2 эмаль) | AL (нГн/вит²) | Цель L / роль | N = √(L/AL) → витков |
|---|---|---|---|---|---|
| L_lpf1/2 | T50-6 (µ=8) | **Ø0.5 мм** (бухта 1) | 4.0 | 360 нГн | √(360/4.0)=√90=9.49 → **10** (→400 нГн) |
| L_rfc | T68-2 (µ=10) | **Ø0.5 мм** (бухта 1) | 5.7 | 4–6 мкГн | 26.49 / 29.62 / 32.44 → **26–32**, номинал **30** (≈5 мкГн) |
| T1 (вх. балун) | BN-61-202 (µ=125) | бифиляр **2×Ø0.3 мм** (бухта 2) | ~340 | 1:1 | **3–4 витка бифиляра** |
| T2 (вых. балун) | BN-61-202 | бифиляр **2×Ø0.3 мм** (бухта 2) | ~340 | 24Ω→50Ω | **3–4 витка бифиляра** + отвод |
| T3 (токовый КСВ) | BN-61-202 | вторичка **Ø0.3 мм** (бухта 2) | ~340 | мост КСВ | первичка **1 проход**, вторичка **20–30** |

> **Итого 2 диаметра (2 бухты):** Ø0.5 мм (iron powder) + Ø0.3 мм (бинокуляр).

> **Проверка укладки (внутренняя окружность сердечника, π·ID):**
> - T50-6: 24.19 мм против 10×0.5 = 5.0 мм — свободно.
> - T68-2: 29.53 мм против 30×0.5 = 15.0 мм — в один слой (запас большой).
> - BN-61-202: бифиляр 2×Ø0.3 ≈ 0.6 мм через отверстия (~2.4 мм) — 3–4 витка свободно.

> **Расход провода (прикидка):**
> - Ø0.5 мм: T50 10 витков × 2 катушки = 641 мм + T68 30 витков = 1268 мм → **~1.9 м** (+ выводы ≈ 2.2 м).
> - Ø0.3 мм: T1/T2 бифиляр (4 витка × 2 провода × 2 тр.) + T3 (25 витков) → **~1–1.5 м**.
> - Брать по одной бухте (или на отрез); остаток — ходовые диаметры для дальнейших катушек (этап 3).

> **BN-61-202 (реактивное сопротивление для проверки):** 3 витка → L=3.06 мкГн, XL(27 МГц)=519 Ом; 4 витка → L=5.44 мкГн, XL=923 Ом (требование XL>200 Ом выполнено). AL полного витка ≈ 0.3–0.4 мкГн/вит² — **уточнить по даташиту Fair-Rite** (µ=125). Трансформаторы — по коэффициенту, не по абсолютной L; T3 (токовый) — первичка = 1 проход линии ANT (центрального проводника коаксиала).

**Готовые варианты (не мотать):**
- **Индуктивности ФНЧ (360 нГн):** основной вариант — тор **T50-6** (заказан). Запасной — **воздушная катушка** (~10 витков эмалированной проволоки Ø0.5–0.7 мм на оправке Ø6 мм, формула Уилера: `L(µH) ≈ d²·N²/(18d+40l)`, d/l в дюймах). Готовые SMD power-индукторы 360 нГн — только с проверкой рабочего тока/добротности на 27 МГц (мелкие чип-индукторы не держат 15 Вт).
- **Трансформаторы (T1/T2, RFC, мост КСВ):** ферритовые тора/бинокуляры Amidon/Fair-Rite (BN-61-202, T68-2) — дешёвые, широко доступны (AliExpress/Amidon). Готовых «трансформаторов 27 МГц под RD16HHF1» в продаже нет — мотается вручную (типовое решение для КВ-УМ).

## 3. Смещение затворов и ограничитель AM (2.3)
### 3.1 Принцип
RD16HHF1 — MOSFET: выходная мощность и ток покоя определяются напряжением затвор-исток (`VGS`). Снижение `VGS` → снижение тока покоя и усиления → снижение выходной несущей при том же уровне раскачки.

- **LIMIT (AM):** пониженное `VGS` через подстроечник RV1 → несущая **4 Вт**.
- **FULL (SSB):** полное `VGS` → **12 Вт PEP** (линейность для SSB).

### 3.2 Формирование `VGS`
Делитель от `+12V_PA` (стабилизированный, опционально с NTC/диодом для термокомпенсации). Рабочая точка AB: `VGS ≈ 2–2.5 В`, ток покоя **`Idq = 0.5 А` на плечо** (по даташиту RD16HHF1; для пары суммарно 1 А). Смещение выставить на готовой плате по току покоя.

- Путь **FULL**: `VGS` полный (резистивный делитель).
- Путь **LIMIT**: `VGS` через **RV1** (многооборотный 10к) — калибруется на 4 Вт.

### 3.3 Логика тумблера и сигналов
| Сигнал | Направление | Логика |
|---|---|---|
| `PWR_LIMIT_SW` | PA → control | 1 = тумблер в LIMIT, 0 = FULL |
| `PWR_LIMIT_EN` | control → PA | 1 = программно включить LIMIT |
| Тумблер LIMIT/FULL | (на PA) | аппаратно выбирает путь смещения |

**DPDT тумблер:**
- Полюс A: общий → `VGS`; LIMIT → RV1; FULL → полный `VGS`.
- Полюс B: формирует `PWR_LIMIT_SW` (делитель 27к/10к от +12 В → 3.3 В = LIMIT; GND = FULL).

**`PWR_LIMIT_EN` (active-high):** ключ **2N7002** принудительно подключает RV1 (LIMIT) независимо от тумблера. Итоговая логика — «ИЛИ»: ограничитель активен, если `(тумблер=LIMIT) ИЛИ (PWR_LIMIT_EN=1)`. В LIMIT программное отключение игнорируется (контракт `control_pa.md`).

**Светодиод:** горит при активном LIMIT (та же логика «ИЛИ»); размещён на **передней панели**, на плате — разъём `J_LIM_LED_1` (XH2.54 2-pin).

### 3.4 Расчёт делителя `PWR_LIMIT_SW`
`+12 В → R1(27к) → узел → R2(10к) → GND`; узел = `12 · 10/(27+10) = 3.24 В` (логическая «1», > VIH=2.31 В для 3.3 В CMOS). В FULL узел принудительно заземляется тумблером → 0 В. Резисторы 0603 (27к и 10к — есть на складе).

## 4. Датчики (2.3)
### 4.1 I_sense (ток)
Шунт **R_shunt = 0.05 Ом 1% / 2 Вт** (Yageo PA2512FKE7W0R05E) в шине `+12V_PA`. При токе `I=2–3 А` падение `V = I·R = 100–150 мВ`.

Усиление LM358 (single supply `+12V_PA`) → масштаб 0–3.3 В на ADC (PA0).
`Vout = V_shunt · G`; при полной шкале 3 А и `V_shunt = 150 мВ` → `G ≈ 22`. Выход ограничивается делителем/стабилитроном до ≤3.3 В.

### 4.2 SWR_sense (return-loss мост, отражённая мощность)
Return-loss мост: трансформатор тока **T3 (BN-61-202)** (первичка — 1 проход линии ANT в разрыв, вторичка SA→GND / SB→`SWR_RF`) + конденсатор выборки напряжения **C11 = 22 пФ C0G/NP0** (`ANT → SWR_RF`). Xc(C11) = 1/(2π·27 МГц·22 пФ) ≈ **268 Ом**; вместе с вторичкой T3 гасит падающую волну → при согласовании 50 Ом `SWR_sense`≈0, в детектор уходит только отражённая волна.

Диодный детектор **BAT54 (D4/D5)** → DC 0–3.3 В (PA1). Подбор: с эквивалентом 50 Ом на `J_ANT_1` подобрать C11 (10–33 пФ) и/или фазировку вторички до минимума `SWR_sense`.

## 5. Тепловой расчёт радиатора (2.4)
### 5.1 Диссипация
- **Полная мощность (Po=16 Вт, ηD=55–65 %):** `Pdiss = Po/η - Po`:
  - η=55 %: `16/0.55 - 16 = 13.1 Вт` суммарно (~6.5 Вт на транзистор).
  - η=65 %: `16/0.65 - 16 = 8.6 Вт` суммарно (~4.3 Вт на транзистор).
- **Покой (Idq=0.5 А × 2 = 1 А, VDD=12.5 В):** `Pdiss = 12.5 × 1 = 12.5 Вт` суммарно (~6.25 Вт на транзистор) — это максимум при зажатой передаче без сигнала в FULL.
- **AM (4 Вт, ограничитель):** смещение снижено → `Pdiss ≈ 4–6 Вт` — заметно ниже.

### 5.2 Требуемое тепловое сопротивление
`Rth_sa ≤ (Tj_max - Tamb) / Pdiss - Rth_jc - Rth_cs`
- `Tj_max = 150 °C`, `Tamb = 40 °C` → `Tj_max - Tamb = 110 °C`.
- **`Rth_jc = 2.2 °C/Вт`** (по даташиту RD16HHF1), `Rth_cs ≈ 0.5 °C/Вт` (изолятор+паста; с втулкой/силпадом — до 1 °C/Вт).

На транзистор (покой FULL, Pdiss ≈ 6.25 Вт): `Rth_sa ≤ 110/6.25 - 2.2 - 0.5 = 17.6 - 2.7 = 14.9 °C/Вт`.

**Вывод:** на каждый транзистор нужен радиатор **≤ ~15 °C/Вт**. Выбран **HS 104-30** (30×102×24.5 мм, **Rth 3.1 °C/Вт**, общий на 2× TO-220): покой Tj = 40 + 12.5×3.1 + 6.25×2.7 = **95.6 °C**; полная (Po=16 Вт) Tj = 40 + 13.1×3.1 + 6.55×2.7 = **98.3 °C**. Запас до `Tj_max=150 °C` — **~52–54 °C** — с запасом. Радиатор монтируется на плате `02_power_amp` (не на задней крышке корпуса).

> Изоляторы (слюда/силпад) обязательны, если фланец (Source) не общий; при общем Source на корпус — заземление.

## 6. Итог
Проектные решения зафиксированы; номиналы внесены в BOM. Точная настройка (смещение, трансформаторы, ФНЧ) — на готовой плате с 50-омной нагрузкой и КСВ-метром/осциллографом.
