okunevpy-create/TRX_27MHz/docs/calculations/power_limit.md

# Ограничитель мощности AM (4 Вт)

## Требование
Не превышать 4 Вт несущей в AM (нормы РФ, безлицензионная СиБи). SSB — до 12 Вт пиковой.

## Реализация
- Управление смещением на затворах RD16HHF1: снижение напряжения смещения → снижение тока покоя → снижение выходной мощности.
- **Физический тумблер SPDT/DPDT** на `02_power_amp`:
  - LIMIT (по умолчанию) — смещение идёт через подстроечник, задающий 4 Вт.
  - FULL — смещение полное, мощность не ограничена.
- Сигнал `PWR_LIMIT_EN` с `01_control` (0/3,3 В) — программное управление.
- Сигнал `PWR_LIMIT_SW` с `02_power_amp` на `01_control` — обратная связь о положении тумблера.
- Светодиод LIMIT (красный, 3 мм) — **на передней панели**; на плате `02_power_amp` — только разъём `J_LIM_LED_1` (XH2.54 2-pin) под проводной монтаж. Индикация активного ограничителя.
- Калибровка: подстроечником выставить 4 Вт при LIMIT.
- Отключение: только физическим тумблером (осознанно).

## Статус
Черновик. Уточняется в подэтапах 1.5 + 2.3.
