okunevpy-create/TRX_27MHz/docs/contracts/rxtx_pa.md

# Контракт: этап 3 (`03_rx_tx`) ↔ этап 2 (`02_power_amp`)

Прямая ВЧ-связь между трактом RX/TX и усилителем мощности. `01_control` в ВЧ-тракте не участвует — только PTT и питание.

## Разъёмы
| Разъём | Сторона | Назначение | Тип |
|---|---|---|-----|
| J_RF_TX_1 | 03_rx_tx → 02_power_amp | ВЧ раскачка на вход УМ | SMA |
| J_RF_RX_1 | 02_power_amp → 03_rx_tx | ВЧ с T/R реле на вход приёма | SMA |
| J_ANT_1 | со схемы `02_power_amp` (SMA, на плате) → гнездо BNC **BJ2** на задней крышке (панель) | Антенна | SMA (плата) → BNC BJ2 (панель) |

## Сигналы
| Сигнал | Направление | Уровень | Тип | Примечание |
|---|---|---|-----|---|
| TX_RF | rxtx → PA | ~0,5 Вт | ВЧ 27 МГц | 50 Ом, раскачка УМ |
| RX_RF | PA → rxtx | до 1 Вт просачивания | ВЧ 27 МГц | с T/R реле, защита на входе rxtx |
| GND | — | — | — | экран |

## T/R switch
- **Реле на `02_power_amp`**, антенный разъём (J_ANT_1) там же.
- Управление — PTT с `01_control` (см. `control_pa.md`).
- Защита входа RX на `03_rx_tx`: антипараллельные диоды + аттенюатор 3–6 дБ (см. `control_rxtx.md`).

## Статус
Зафиксирован на Этапе 0. Меняется только по явному согласованию.
> Уточнение (2026-10-30): со схемы `02_power_amp` выходит `J_ANT_1` (SMA, на плате) и уходит коаксиалом на гнездо **BNC BJ2** на задней крышке корпуса.
