okunevpy-create/TRX_27MHz/.continue/rules/calculations.md

---
description: Расчёты выполнять только через инструменты (calculate/sqrt/…),
  не в уме. Перед расчётом витков определить тип намоточной проволоки.
alwaysApply: true
---

# Расчёты — только инструментами

- **В уме считать нельзя.** Любые арифметические/инженерные расчёты выполнять
  через инструменты (`calculate`, `sqrt`, `logarithm`, `trigonometry` и т.п.),
  не в уме и не «на глаз». Каждый результат — с единицами измерения.
- **Прежде чем считать витки — определить, что мотаем.** Число витков зависит от
  типа/диаметра намоточной проволоки (эмаль ПЭВ/ПЭТВ, обмотка бифиляром, толщина
  меди и изоляции) и от сердечника. Порядок:
  1) зафиксировать тип провода и сердечник;
  2) посчитать `N = √(L / AL)` инструментом;
  3) проверить укладку витков на сердечник (внутренняя окружность/окно).
