okunevpy-create/TRX_27MHz/.continue/rules/max-retry.md

---
description: Применяется при редактировании любых текстовых (markdown/текст)
  файлов, когда последовательные правки не проходят или вносят артефакты.
alwaysApply: true
---

Если не удаётся отредактировать текстовый файл (edit/single_find_and_replace) за 3 попытки — прекрати точечные правки, удали файл и создай его заново целиком через create_new_file с полным корректным содержимым.
