okunevpy-create/TRX_27MHz/docs/bom/stage1_control.md

# BOM — Этап 1: плата управления (01_control)

> Правила: пассивные резисторы/керамика — корпус 0603; footprint — по правилу handsoldering (при наличии), иначе обычный SMD/THT; крупные THT/TO-263/SOT-223 — стандартные (ручная пайка).
>
> **ЭЛЕМЕНТЫ УПРАВЛЕНИЯ (энкодер KY-040, кнопки, OLED-дисплей) монтируются НА КОРПУС и подключаются проводами. На плату ставятся только разъёмы/пады под эти провода — сами элементы управления на плате отсутствуют.**

## Назначение документа
BOM сверен с реальным заказом/складом и **служит техническим заданием для отдельной сессии, работающей с KiCad через MCP**. Правки footprint'ов в этом документе не выполняются — здесь только зафиксировано, что и как должно быть в проекте.

## Статус наличия — BOM ЗАКРЫТ, ДЕФИЦИТА НЕТ
**Все позиции этапа 1 заказаны или в наличии.**

| Статус | Значение |
|---|---|
| **STOCK** | Подтверждено в наличии у пользователя (найдено физически) |
| **ORDERED** | Заказано (ChipDip / Ozon), с датой доставки |
| **TO-ORDER** | Нет, требуется заказать/найти |

> Источники:
> **ChipDip:** Si5351A-B-GTR, STM32F411CEU6, 74AC541SC, **RT9193-33GB ×3** (U2, U3, U9-дисплей), LM2596S-5.0 (TO-263-5), кварц 8 МГц HC-49SM, TG2520SMN 27.6 МГц, EEEFK1C471P (C3), SPQ105-330M (L1), BC507-040 (F1 держатель), 522.1300 T3A 5×20 ×2 (F1), MMZ2012R601AT000 ×2 (L2/L3), WJ127R-5.0-02P ×3 (J_12V_IN_1 — 01_control; J_PA_PWR_1 — 02_power_amp; J_RXTX_PWR_1 — 03_rx_tx).
> - **Ozon:** C1 1000 мкФ/25 В SMD 10×12.5, энкодер HW-040 (KY-040), **ST7789 2.0" 240×320 SPI**, джойстик 5-поз. 20×25 мм.
> - **Склад 0603:** `Stock/smd_resistors_0603.csv`, `Stock/resistance_0603.csv`, `Stock/capacitors_ 0603.csv`.
> - **STOCK:** SS34 (SMA) ×1 (D3), SMA s-p215, XH2.54 набор 2P–12P, PinHeader 2.54, провода 26 AWG, OLED SSD1306 0.96" (резерв), LM358DR.

## ⚠️ ЗАДАНИЕ ДЛЯ KICAD-СЕССИИ: расхождения footprint'ов/символов
**KiCad-сессия (с MCP) должна привести проект к реальному BOM. Ниже — карта исправлений. Выполнить до начала 1.4.**

| # | Ref | Что сейчас в проекте | Что должно быть (реально) | Действие в KiCad |
|---|-----|---|---|---|
| F1 | U1 | `TO-263-3_TabPin2` | **TO-263-5** (`Package_TO_SOT_SMD:TO-263-5_TabPin3`) — LM2596S-5.0 в заказе 5-выводной | Сменить footprint; проверить соответствие пинов символа (VIN/OUT/GND/FB/ON-OFF) |
| F2 | U2, U3 | `AMS1117-3.3` / `SOT-223-3_TabPin2` | **RT9193-33GB** (Richtek), `SOT-23-5` | Сменить символ на RT9193-33 и footprint на `Package_TO_SOT_SMD:SOT-23-5` |
| F3 | U7 | TBD | **LM358DR**, `SOIC-8_3.9x4.9mm_P1.27mm_HandSolder` | Добавить символ LM358 (unit A), footprint SOIC-8 HandSolder |
| F4 | U6 | ~~`Package_SO:SOIC-14_3.9x8.7mm_P1.27mm`~~ | ~~**74HC74D,653**~~ **УДАЛЁН** (квадратура — балласт) | Удалён со схемы |
| F5 | J_OLED_1, J_ENC_1, J_BTN_1, J_PA_CTRL_1, J_RXTX_SIG_1 | `PinHeader_2.54mm` | **XH2.54** угловые папы; **J_OLED_1 → 8-pin (SPI)**, J_ENC_1 → 5-pin, **J_BTN_1 → 8-pin** (джойстик 5-поз. + RIT + GND), **J_PA_CTRL_1 → 6-pin** | Сменить footprint'ы |
| F5b | J_SWD_1, J_UART_1 | `PinHeader_2.54mm` | **ОСТАВИТЬ PinHeader 2.54** (в наличии; удобно для отладки) | Без изменений |
| F6 | ~~J_PA_PWR_1, J_RXTX_PWR_1~~ | ~~клеммник 2-pin~~ | **УБРАНО (2026-10-31)**: раздача +12V снята с платы → внешние WAGO 221-415 | Удалены со схемы (свои входные разъёмы `J_PA_PWR_1`/`J_RXTX_PWR_1` есть на платах 2/3) |
| F7 | U8 (BUF) | нет | **74AC541SC** (буфер ×8, **SOIC-20**, OE) — буферы VFO/BFO | Добавить символ 74AC541 + `Package_SO:SOIC-20W_7.5x12.8mm_P1.27mm` (HandSolder при наличии). См. 1.3 |

| F8 | C1, C3 | `CP_Radial_D10.0mm_P5.00mm` / `CP_Radial_D8.0mm_P3.50mm` (THT) | **SMD-электролиты**: C1 1000 мкФ/25 В 10×12.5 мм (Ozon), C3 470 мкФ/16 В EEEFK1C471P 8×10.2 мм | Сменить footprint'ы на SMD `CP_Elec_10x12.5` / `CP_Elec_8x10.5` (`Capacitor_SMD:CP_Elec_*`); C3 — деталь 8×10.2, footprint 8×10.5 (запас 0.3 мм, принято) |
| F9 | L2, L3 | ✅ сделано | **Феррит MMZ2012R601AT000** (600 Ом@100 МГц, **0805**) | Добавить символ FerriteBead + `Inductor_SMD:L_0805_2012Metric` ✅ |
| F10 | R5, C21 | ✅ сделано | **Компенсация слабого ВЧ-фильтра Si5351**: R5(=R_si) 10 Ом последовательно в питание Si5351, C21 1 мкФ 0603 параллельно C8 | Добавить R + C в схему 1.3 ✅ |
| F11 | **U9 (LDO дисплея)** | нет | **RT9193-33GB** (SOT-23-5) — отдельный LDO 3.3 В для ST7789 (подсветка 150–200 мА не должна грузить U2) | Добавить U9 + развязку: **C26=1 мкФ (вход, 0603), C27=10 мкФ (выход, 0805), C28=10 нФ (BP, 0603)** в схему 1.4 |
| F12 | **U10 (ST7789)** | нет | **ST7789 2.0" 240×320 SPI** — основной дисплей | Добавить символ/разъём; J_OLED_1 8-pin |
| F13 | **R/C фильтры UI** | нет | **RC-фильтры (обязательно):** R_pu 10к ×6 + C 100нФ ×6 (J_BTN_1), R_pu 10к ×3 + C 100нФ ×3 (J_ENC_1), R 22 Ом ×4 (SPI-линии OLED) | Добавить в схему 1.4 |

> **Доп. проверка схемы 1.2 (ФИНАЛ):** UFQFPN-48 имеет один VCAP — **C22 = 4.7 мкФ** (U4:22). **VCAP2 отсутствует.** VDDA = **C20 100 нФ** + **C25 1 мкФ**. Старый единый **C17 удалён**. Допустимая альтернатива VCAP: 2.2 мкФ + 100 нФ параллельно.
> **Правило 0603 не распространяется на ферриты и электролиты** — феррит 0805, электролиты SMD-корпуса. Это осознанное исключение.

## Принятые решения по корпусам
- MCU: UFQFPN-48 7x7 (STM32F411CEUx + QFN-48-1EP_7x7mm_P0.5mm_EP5.6x5.6mm). — ORDERED
- ~~TVS: SMBJ18A (SMB uni-directional 18В)~~ — **СНЯТ** (2026-10-31): защита на корпусе (TVS load dump), на плате не нужен.
- Диод DC-DC: SS34, SMA (Diode_SMD:D_SMA_Handsoldering) — STOCK (1 шт, D3).
- 74AC541: SOIC-20 — буферы ВЧ VFO/BFO (неинвертирующие, 8 буферов, OE).
- LDO 3.3 В: **RT9193-33GB** (SOT-23-5), не AMS1117.
- MIC-предусилитель: **LM358DR** (SO-8, HandSolder), однополярное +3V3.
- Электролиты: **SMD** (C1 1000мкФ/25В 10×12.5; C3 EEEFK1C471P 470мкФ/16В — деталь 8×10.2, footprint `CP_Elec_8x10.5`, запас 0.3 мм, принято), не THT.
- Индуктивность L1: **SPQ105-330M** (33 мкГн, 2.4 А, 10.4×10.2×4.8 SMD).
- Ферриты L2/L3: **MMZ2012R601AT000** (0805, 600 Ом@100 МГц).
- Держатель предохранителя: **BC507-040** (5×20, на плату THT) + сам предохранитель 3 А.

## Ключевые позиции
| Позиция | Кол-во | Статус | Примечание | Альтернатива |
|---|---|---|---|---|
| STM32F411CEU6 | 1 | ORDERED (29 окт) | UFQFPN-48 7x7 | STM32F103C8T6 |
| Si5351A-B-GTR | 1 | ORDERED (26 окт) | MSOP-10 | готовый модуль Si5351 |
| 74AC541SC | 1 | **ORDERED** (SOIC-20) | буфер ×8, OE — буферы VFO/BFO | 74AC244 (SO-20) |
| LM2596S-5.0 | 1 | ORDERED (29 окт) | **TO-263-5** (UMW) | MC34063 + обвязка |
| RT9193-33GB | **3** | **ORDERED** (29 окт) | SOT-23-5 (U2, U3, U9-дисплей) | AMS1117-3.3 (SOT-223) |
| ~~SMBJ18A (TVS)~~ | ~~1~~ | **СНЯТ** (2026-10-31) | дублирует TVS load dump на корпусе | — |
| SS34 | 1 | **STOCK** | SMA, D_SMA_Handsoldering (D3, catch-диод LM2596) | B340A |
| Кварц 8 МГц | 1 | ORDERED (26 окт) | SJK HC-49SM SMD | — |
| TCXO 27.6 МГц | 1 | ORDERED (29 окт) | TG2520SMN (2520 SMD) | — |
| LM358DR | 1 | **STOCK** | SO-8, MIC-предусилитель | — |
| **ST7789 2.0" 240×320 SPI** (осн. дисплей) | 1 | **ORDERED** (Ozon) | на корпус, J_OLED_1 8-pin | SSD1306 1.3" |
| OLED 0.96" 128×64 I2C синий | 1 | **STOCK** | резервный/отладочный, разъём не делаем | — |
| Энкодер HW-040 (KY-040) | 1 | **ORDERED** (Ozon) | модуль, 5 В, 20 шагов/оборот, на корпус | — |
| **Джойстик 5-поз. (модуль)** | 1 | **ORDERED** | плата **20×25 мм**, 6 выводов (UP/DOWN/LEFT/RIGHT/PUSH + COM), монтажные отверстия | — |
| Разъёмы XH2.54 (набор 2P–12P угловые) | по числу разъёмов | **ORDERED** (набор) | J_OLED_1 8P, J_BTN_1 8P, J_PA_CTRL_1 6P, J_ENC_1 5P, J_MODE_1 (2P), J_PTT_MUTE_1/J_AUDIO_1 (3P) + запас | — |
| PinHeader 2.54 | для SWD/UART | **STOCK** | J_SWD_1, J_UART_1 | — |
| SMA s-p215 («стульчик») | — | **STOCK** | 5 выводов (центр + 4), VFO/BFO на этапе 1 + этапы 2/3 | — |

## 1.1 — Входная защита + питание (DC-DC + LDO + +3V3_SI)
| Ref | Позиция | Значение | Кол-во | Символ | Footprint | Статус |
|-----|---|---|---|---|---|---|
| J_12V_IN_1 | Вход 12В (клеммник 2-pin 5.0 мм) | +12V_IN, GND | 1 | Conn_01x02 | TerminalBlock_Phoenix:TerminalBlock_Phoenix_MKDS-1,5-2_1x02_P5.00mm_Horizontal | **ORDERED** |
| ~~F1~~ | Предохранитель — **перенесён на корпус** (см. примечание) | **5 А**, 5×20, медленный (T) | 1 | — | — | **СНЯТ С ПЛАТЫ** |
| ~~D1~~ | ~~TVS SMBJ18A~~ | ~~SMBJ18A~~ | ~~1~~ | ~~Device:D_TVS~~ | ~~Diode_SMD:D_SMB_Handsoldering~~ | **СНЯТ** (2026-10-31) |
| ~~D2~~ | ~~Шоттки вход~~ | ~~SS34~~ | ~~1~~ | ~~Diode:SS34~~ | ~~Diode_SMD:D_SMA_Handsoldering~~ | **СНЯТ** (2026-10-31) |
| C1 | Электролит вход | 1000 мкФ/25В, SMD 10×12.5 | 1 | Device:C_Polarized | **CP_Elec_10x12.5** ⚠️ F8 | **ORDERED** (Ozon) |
| U1 | DC-DC 5В | LM2596S-5 | 1 | LM2596S-5 | **TO-263-5_TabPin3** ⚠️ F1 | ORDERED (29 окт) |
| L1 | Индуктивность | **SPQ105-330M**, 33 мкГн, 2.4 А, 10.4×10.2×4.8 | 1 | Device:L | L_10.4x10.2mm / SMD | **ORDERED** |
| D3 | Диод DC-DC | SS34 | 1 | Diode:SS34 | D_SMA_Handsoldering | **STOCK** |
| C3 | Электролит 5В | **EEEFK1C471P**, 470 мкФ/16В, SMD 8×10.2 | 1 | Device:C_Polarized | **CP_Elec_8x10.5** ⚠️ F8 | **ORDERED** (ChipDip) |
| U2 | LDO 3.3В | RT9193-33GB | 1 | RT9193-33 | SOT-23-5 ⚠️ F2 | ORDERED (29 окт) |
| U3 | LDO +3V3_SI | RT9193-33GB | 1 | RT9193-33 | SOT-23-5 ⚠️ F2 | **ORDERED** |
| L2 | Феррит +5V→+5V_SI | **MMZ2012R601AT000**, 600Ω@100МГц, 1А, 0805 | 1 | Device:FerriteBead | `Inductor_SMD:L_0805_2012Metric` ⚠️ F9 | **ORDERED** |
| L3 | Феррит +5V→U2 IN | **MMZ2012R601AT000**, 600Ω@100МГц, 1А, 0805 | 1 | Device:FerriteBead | `Inductor_SMD:L_0805_2012Metric` ⚠️ F9 | **ORDERED** |
| C2 | Керамика вход | 100 нФ | 1 | Device:C | C_0603...HandSolder | **STOCK** |
| C4 | Керамика 5В (bulk) | 10 мкФ (10В X7R) | 1 | Device:C | **C_0805_2012Metric_Pad1.15x1.40mm_HandSolder** | **STOCK** |
| C5 | Керамика вход U2 | 1 мкФ (10В X7R) | 1 | Device:C | C_0603...HandSolder | **STOCK** |
| C6 | Керамика выход U2 (+3V3) | 10 мкФ (10В X7R) | 1 | Device:C | **C_0805_2012Metric_Pad1.15x1.40mm_HandSolder** | **STOCK** |
| C7 | Керамика выход U3 (+3V3_SI) | 10 мкФ (10В X7R) | 1 | Device:C | **C_0805_2012Metric_Pad1.15x1.40mm_HandSolder** | **STOCK** |
| C8 | Керамика вход U3 (+5V_SI) | 100 нФ | 1 | Device:C | C_0603...HandSolder | **STOCK** |
| C43 | Bulk вход U3 (+5V_SI) | 1 мкФ (10В X7R) | 1 | Device:C | C_0603...HandSolder | **STOCK** |
| C21 | Керамика F10 (+3V3_SI_F) | 1 мкФ (10В X7R) | 1 | Device:C | C_0603...HandSolder | **STOCK** |
| R_si (R5) | Последоват. в питание Si5351 | 10 Ом | 1 | Device:R | R_0603...HandSolder | **STOCK** |
| C23 | Керамика BP U2 (bypass) | 10 нФ | 1 | Device:C | C_0603...HandSolder | **STOCK** |
| C24 | Керамика BP U3 (bypass) | 10 нФ | 1 | Device:C | C_0603...HandSolder | **STOCK** |

> ⚠️ **Фильтр питания Si5351 (F10):** ферриты L2/L3 = **MMZ2012R601AT000** (600Ω@100МГц, 0805, 1А). Дополнительно в питание Si5351 — **R_si (R5) 10 Ом последовательно + C21 1 мкФ** (RC-ячейка ≈15.9 кГц, давит НЧ-помехи; бусина — ВЧ). 10 мкФ — 0805 (нет в 0603), остальное 0603 из склада.

> Ряд 0603 — склад (`Stock/capacitors_ 0603.csv`); 10 мкФ в 0603 нет → 0805. Наличие подтверждено.

> ⚠️ **Входное питание (ИЗМЕНЕНИЕ 2026-10-31):** предохранитель **F1 (3 А)** и входные **D1 (TVS SMBJ18A)/D2 (SS34)** **сняты с платы** — вся входная защита (предохранитель 5 А + TVS load dump + диод реверса SS54) на корпусе перед предрегулятором LTC3780. Плата `01_control` питается напрямую: `J_12V_IN_1 → VIN_PROT → C1/C2 + U1(LM2596S-5.0)` — см. `docs/power-distribution.md` и `docs/pcb_placement_plan.md`.

> ⚠️ **Защита на корпусе (перед LTC3780, узел этапа 4):** предохранитель **5 А** (5×20 мм, медленный T, держатель BC507-040 или аналогичный) + **TVS под load dump** (SM8T/SMDJ 18–24 В или LDP24A) + **диод реверса SS54 (5 А)**.

## 1.2 — MCU STM32F411 + SWD + UART (внешний кварц удалён → HSI)
| Ref | Позиция | Значение | Кол-во | Символ | Footprint | Статус |
|-----|---|---|---|---|---|---|
| U4 | MCU STM32F411CEU6 | — | 1 | STM32F411CEUx | QFN-48-1EP_7x7mm_P0.5mm_EP5.6x5.6mm | ORDERED (29 окт) |
| ~~Y1~~ | ~~Кварц 8 МГц HC-49SM~~ | — | — | — | — | **УДАЛЁН (2026-11-01)** |
| ~~C9,C10~~ | ~~Нагруз. кварца~~ | — | — | — | — | **УДАЛЁН (2026-11-01)** |
| C11–C16 | Развязка VDD | 100 нФ | 6 | Device:C | C_0603...HandSolder | **STOCK** |
| C38 | Развязка +3V3 (доп.) | 100 нФ | 1 | Device:C | C_0603...HandSolder | **STOCK** |
| C22 | VCAP1 | 4.7 мкФ | 1 | Device:C | C_0603...HandSolder | **STOCK** |
| C20 | VDDA развязка | 100 нФ | 1 | Device:C | C_0603...HandSolder | **STOCK** |
| C25 | VDDA фильтр | 1 мкФ (10В X7R) | 1 | Device:C | C_0603...HandSolder | **STOCK** |
| L4 | Феррит +3V3→VDDA | MMZ2012R601AT000, 600Ω@100МГц, 0805 | 1 | Device:FerriteBead | Inductor_SMD:L_0805_2012Metric | **ORDERED** |
| R1 | BOOT0 pull-down | 10 к | 1 | Device:R | R_0603...HandSolder | **STOCK** |
| R2 | NRST pull-up | 10 к | 1 | Device:R | R_0603...HandSolder | **STOCK** |
| J_SWD_1 | SWD 5-pin (+NRST) | — | 1 | Conn_01x05 | **PinHeader_1x05_P2.54mm_Vertical** | **STOCK** |
| J_UART_1 | UART 4-pin | — | 1 | Conn_01x04 | **PinHeader_2.54mm** (оставить) | **STOCK** |
| U10 | EEPROM AT24C02C | AT24C02CM/TR (2 Кб = 256×8, I²C 2-wire, 1.7–5.5 В) | 1 | Memory_EEPROM:24LC02 | Package_SO:SOIC-8_3.9x4.9mm_P1.27mm | **TO-ORDER** |
| C45 | Развязка питания EEPROM | 100 нФ | 1 | Device:C | C_0603...HandSolder | **STOCK** |

> На STM32F411CEU6 — **один** VCAP (pin 22 = VCAP1), требует **4.7 мкФ** (рекомендовано для одного VCAP) → **C22**; допустимо: 2.2 мкФ + 100 нФ параллельно. VDDA — отдельно 100 нФ (**C20**) + 1 мкФ (**C25**). См. F7 в задании для KiCad.

> **J_SWD_1 (SWD 5-pin):** 1=SWDIO, 2=SWDCLK, 3=GND, 4=+3V3, 5=NRST. NRST выведен для connect-under-reset (аппаратный сброс со ST-Link).

> **U10 (EEPROM AT24C02C):** I²C на шине `I2C_SCL`/`I2C_SDA` (PB6/PB7, общая с Si5351). A0/A1/A2 → GND (7-бит адрес **0x50**), **WP → GND** (запись разрешена) — хранение RIT и каналов. Развязка C45 100 нФ по +3V3. Питание 1.7–5.5 В → +3V3.

## 1.3 — Синтезатор Si5351 + буферы
| Ref | Позиция | Значение | Кол-во | Символ | Footprint | Статус |
|-----|---|---|---|---|---|---|
| U5 | Si5351A-B-GTR | — | 1 | Oscillator:Si5351A-B-GTR | Package_SO:MSOP-10_3x3mm_P0.5mm | ORDERED (26 окт) |
| Y2 | TCXO 27.6 МГц TG2520SMN | TG2520SMN-27.6000M-MCGNNM3 | 1 | Oscillator:TG2520SMN-xx.xxxxxxMhz-xxxxNM | Oscillator:Oscillator_SMD_SeikoEpson_TG2520SMN-xxx-xxxxxx-4Pin_2.5x2.0mm | ORDERED (29 окт) |
| C18,C19 | Развязка Si5351 | 100 нФ | 2 | Device:C | C_0603...HandSolder | **STOCK** |
| C42 | Развязка VCC TCXO Y2 | 100 нФ | 1 | Device:C | C_0603...HandSolder | **STOCK** |
| R3,R4 | I2C pull-up | 4.7 к | 2 | Device:R | R_0603...HandSolder | **STOCK** |
| **U8** | **74AC541SC** (буфер ×8, OE) | — | 1 | 74xx:74AC541 | Package_SO:SOIC-20W_7.5x12.8mm_P1.27mm ⚠️ F7 | **ORDERED** |
| R_buf ×n | Нагруз./согласование буферов | 22–47 Ом | 2 | Device:R | R_0603...HandSolder | **STOCK** |
| C_buf ×n | Развязка 74AC541 | 100 нФ | 1 | Device:C | C_0603...HandSolder | **STOCK** |

> **Y2 — TCXO TG2520SMN (27.6 МГц), не кварц.** Цоколёвка: 1=NC, 2=GND, 3=OUT, 4=VCC. Подключение: OUT(3)→`REF_CLK`→U5 XA(2), XB(3)→NC, VCC(4)→`+3V3_SI_F`, GND(2)→GND; развязка VCC — **C42 100 нФ** (0603). Нагрузочные ёмкости не нужны (генератор).

> **Буферы VFO/BFO — на 74AC541SC** (8 неинвертирующих буферов, 2 группы по OE). Используется только Банк 1 (VFO/BFO); Банк 2 (A5–A8) переведён: входы A5/A6 → GND, выходы Y5/Y6 → NC, `2OE` → GND.
>
> | Банк | Входы/выходы | Сигналы | OE |
> |------|--------------|---------|-----|
> | **Банк 1** (A1–A4) | 4 буфера | **VFO_RAW→VFO_OUT**, **BFO_RAW→BFO_OUT**, 2 резерв | **1OE → GND** (всегда включён) |
> | **Банк 2** (A5–A8) | 4 буфера | резерв (входы → GND, выходы → NC) | **2OE → GND** |
>
> Схема каждого выхода: `сигнал → U8x → R_buf 22–47 Ом → выход`. Последовательный R обязателен (звон на фронтах AC-family).
> Неиспользуемые входы резервных буферов — на GND (не оставлять в воздухе, AC-family чувствительна).

## 1.4 — UI / RIT / squelch / MIC-предусилитель
| Ref | Позиция | Значение | Кол-во | Символ | Footprint | Статус |
|-----|---|---|---|---|---|---|
| **U10** | **ST7789 2.0" 240×320 SPI** (на корпус) | — | 1 | Conn_01x08 (или спец. символ) | XH2.54 8-pin угловой папа ⚠️ F12 | **ПРИШЁЛ** (Ozon) |
| J_OLED_1 | Разъём под ST7789 SPI | **8-pin** | 1 | Conn_01x08 | XH2.54 угловой папа ⚠️ F5 | **STOCK** |
| J_ENC_1 | Разъём под HW-040 (CLK/DT/**SW**/VCC/GND) | **5-pin** | 1 | Conn_01x05 | XH2.54 угловой папа ⚠️ F5 | **STOCK** |
| J_BTN_1 | Разъём под джойстик + RIT (корпус) | **8-pin** | 1 | Conn_01x08 | XH2.54 угловой папа ⚠️ F5 | **STOCK** |
| **U9** | **LDO дисплея** | RT9193-33GB | 1 | RT9193-33 | SOT-23-5 ⚠️ F11 | **ORDERED** (третий) |
| C26 | Развязка U9 вход | 1 мкФ | 1 | Device:C | C_0603...HandSolder | **STOCK** |
| C27 | Развязка U9 выход | 10 мкФ | 1 | Device:C | C_0805_2012Metric_Pad1.15x1.40mm_HandSolder | **STOCK** |
| C28 | BP U9 | 10 нФ | 1 | Device:C | C_0603...HandSolder | **STOCK** |
| U7 | Предусилитель MIC (LM358DR) | 1 каскад, +3V3 | 1 | Amplifier_Operational:LM358 (A) | SOIC-8_3.9x4.9mm_P1.27mm_HandSolder ⚠️ F3 | **STOCK** |
| R23 | Bias электрета (+3V3 → MIC+) | 2.2 к | 1 | Device:R | R_0603...HandSolder | **STOCK** |
| R24 | Делитель смещения (верх, +3V3 → V+) | 10 к | 1 | Device:R | R_0603...HandSolder | **STOCK** |
| R25 | Делитель смещения (низ, V+ → GND) | 10 к | 1 | Device:R | R_0603...HandSolder | **STOCK** |
| R26 | Обратная связь (Vout → V−) | 100 к | 1 | Device:R | R_0603...HandSolder | **STOCK** |
| R27 | Задание усиления (V− → C41 → GND) | 10 к | 1 | Device:R | R_0603...HandSolder | **STOCK** |
| C39 | Входная связь (MIC+ → V+) | 1 мкФ | 1 | Device:C | C_0603...HandSolder | **STOCK** |
| C41 | AC-земля в ОС (последовательно с R27) | 10 мкФ | 1 | Device:C | C_0805...HandSolder | **STOCK** |
| R28 | RC-фильтр RX_audio/ADC | 1 к | 1 | Device:R | R_0603...HandSolder | **STOCK** |
| C40 | RC-фильтр RX_audio/ADC | 10 нФ | 1 | Device:C | C_0603...HandSolder | **STOCK** |
| R31 | Pull-up PTT_IN (гарнитура) | 10 к | 1 | Device:R | R_0603...HandSolder | **STOCK** |
| R32 | Последоват. PTT_IN (ESD-ограничение) | 1 к | 1 | Device:R | R_0603...HandSolder | **STOCK** |
| C44 | Фильтр PTT_IN | 100 нФ | 1 | Device:C | C_0603...HandSolder | **STOCK** |
| J_HS_1 | Разъём гарнитуры MIC/PTT/GND (XH2.54 3P) | 1=MIC, 2=GND, 3=PTT_IN | 1 | Conn_01x03 | Connector_JST:JST_XH_B3B-XH-A_1x03_P2.50mm_Vertical | **STOCK** |

### Раскладка разъёмов UI (UX-решения)
| Разъём | Пины | Сигналы |
|---|---|---|
| **J_OLED_1** (8-pin) | 1=GND, 2=+3V3_DISP, 3=LCD_BL, 4=LCD_RST, 5=OLED_CS, 6=OLED_SCK, 7=OLED_DC, 8=OLED_MOSI | SPI 4-wire + подсветка (переразведён 2026-11-01) |
| **J_ENC_1** (5-pin) | 1=GND, 2=+3V3, 3=ENC_CLK, 4=ENC_DT, 5=ENC_SW | энкодер **с кнопкой** — кнопка функциональна (фиксация/выбор) |
| **J_BTN_1** (8-pin) | 1=BTN_UP, 2=BTN_DOWN, 3=BTN_LEFT, 4=BTN_RIGHT, 5=BTN_PUSH, 6=GND, 7=BTN_RIT, 8=GND | **Джойстик 5-поз. + отдельная кнопка RIT**. Все кнопки — тактильные **без фиксации**, состояние в прошивке (короткое/двойное/длинное) |

### ST7789 модуль — фактическая цоколёвка (ПРИШЁЛ, СВЕРЕНО)
Модуль имеет **два одинаковых ряда 8-pin** (сверху/снизу) — параллельный дубль для удобства монтажа, используется один ряд.
Маркировка по порядку: **GND, VDD, SCL, SDA, RES, DC, CS, BL**. Это **SPI 4-wire** (НЕ I²C): `SCL` = SCK (такт SPI), `SDA` = MOSI (данные SPI). Наличие `DC` и `CS` однозначно подтверждает SPI.

| Пин модуля | Маркировка | Цепь J_OLED_1 (плата) |
|---|---|---|
| 1 | GND | GND |
| 2 | VDD | `+3V3_DISP` |
| 3 | SCL (=SCK) | `OLED_SCK` |
| 4 | SDA (=MOSI) | `OLED_MOSI` |
| 5 | RES | `LCD_RST` |
| 6 | DC | `OLED_DC` |
| 7 | CS | `OLED_CS` |
| 8 | BL | `LCD_BL` |

> ⚠️ **`J_OLED_1` переразведён повторно (2026-11-01):** 1=GND, 2=`+3V3_DISP`, 3=`LCD_BL`, 4=`LCD_RST`, 5=`OLED_CS`, 6=`OLED_SCK`, 7=`OLED_DC`, 8=`OLED_MOSI`. **НЕ прямой шлейф 1:1** с модулем — шлейф кросс-разведён (проверить при монтаже).

### Подсветка `LCD_BLK` (PB0) — ключ (✅ ДОБАВЛЕНО В СХЕМУ)

**Задача (§8 п.2 валидации):** `LCD_BLK` (PB0) нельзя напрямую на `J_OLED_1:8` (BL) —
подсветка ST7789 тянет 150–200 мА, а GPIO MCU держит только ~25 мА. Модуль питается
2.8–3.3 В («без 5 В LDO»), поэтому ключ ставим на `+3V3_DISP`.

**Реализовано в схеме (KiCad, 2026-10-29):**

| Ref | Компонент | Значение | Footprint |
|-----|---|---|---|
| **Q1** | P-MOSFET, высокосторонний ключ | **AO3401** | `Package_TO_SOT_SMD:SOT-23_Handsoldering` |
| **R33** | Резистор в затвор (R_gate) | **100R** | `Resistor_SMD:R_0603_1608Metric_Pad0.98x0.95mm_HandSolder` |
| **R34** | Pull-up затвора (R_BL_PU) | **100k** | `Resistor_SMD:R_0603_1608Metric_Pad0.98x0.95mm_HandSolder` |
| **R35** | Токоограничивающий (R_BL) | **12R** | `Resistor_SMD:R_1210_3225Metric_Pad1.30x2.65mm_HandSolder` |

> **Статус:** **AO3401 (Q1) — ЗАКАЗАН у «ДКО электронщик»**; R35 (12R 1210) — дозаказ; R33/R34 (0603) — склад.

**Топология (BL = анод LED+, катод на GND — подтверждено мультиметром):**

```
+3V3_DISP ──► S (Q1)      Q1.D ──► R35 ──► LCD_BL ──► J_OLED_1:8 (BL)
Q1.G ← R34 (pull-up на +3V3_DISP)   и   Q1.G ← R33 ← LCD_BLK (PB0)
```

- **Логика (active-low):** PB0 = LOW → Q1 открыт → подсветка горит; PB0 = HIGH/Hi-Z → pull-up закрывает Q1.
- **PWM-яркость:** ШИМ на PB0, ~1–10 кГц.

> ✅ **Полярность `BL` подтверждена:** `BL` = анод (`LED+`), катод внутри на GND → только P-MOSFET.

**⚠️ Проверить при bring-up (амперметра нет):**
- **R35 (12R)** — заглушка-ограничитель тока. Если подсветка **не загорится** — убрать R35
  (перемычка/0R) или подобрать номинал по яркости. Если горит тускло — уменьшить R35.

### RC-фильтры на линиях кнопок/энкодера (ОБЯЗАТЕЛЬНО)
**Причина:** провода до корпусных элементов 10–20 см работают как антенна (рядом ВЧ-синтезатор 37 МГц) → без фильтров ложные срабатывания. Все детали — склад 0603.

| Ref | Позиция | Значение | Кол-во | Footprint | Статус |
|-----|---|---|---|---|---|
| **R6–R11** | Pull-up линий J_BTN_1 (UP/DOWN/LEFT/RIGHT/PUSH/RIT) | **10 кОм** | 6 | R_0603...HandSolder | **STOCK** |
| **C29–C34** | Фильтр линий J_BTN_1 | **100 нФ** | 6 | C_0603...HandSolder | **STOCK** |
| **R12–R14** | Pull-up ENC_SW/ENC_DT/ENC_CLK | **10 кОм** | 3 | R_0603...HandSolder | **STOCK** |
| **C35–C37** | Фильтр ENC_SW/ENC_DT/ENC_CLK | **100 нФ** | 3 | C_0603...HandSolder | **STOCK** |
| **R15–R18** | Последовательные в SPI-линии (SCK/MOSI/CS/DC) | **22 Ом** | 4 | R_0603...HandSolder | **STOCK** |

> **Схема на линию кнопки:** `+3V3 ── R_pu 10к ──┬── кнопка ── GND`; от узла — `C 100нФ` на GND и на пин MCU. τ = 10к × 100нФ = **1 мс** — дребезг гасится, реакция мгновенная.
> **Энкодер:** те же RC на CLK/DT/SW. Дополнительно — программный антидребезг.
> **SPI OLED:** R 22 Ом последовательно в SCK/MOSI/CS/DC — гашение звона на быстрых фронтах (рядом ВЧ).
> Итого: +19 деталей 0603, все со склада.

> **Питание дисплея — отдельный LDO U9 (RT9193, 300 мА).** ST7789 с подсветкой 150–200 мА не должен грузить U2 (общий +3V3). Питание подсветки — от +5 В через ограничительный резистор (уточнить по факту модуля), логика/панель — от U9.
> Старый **OLED 0.96" SSD1306 — STOCK, резервный/отладочный**; PCB-разъём под него не делаем.
> U7 LM358 от +3V3 однополярного — выход до ~+1.8 В, для MIC_LINE (~100 мВ) достаточно; входная цепь со смещением 0.5×Vcc (R23 + R24/R25). **СХЕМОТЕХНИКА 1.4 ГОТОВА**: неинвертирующий, K≈11 (R26=100к / R27=10к), DC gain=1 за счёт C41=10мкФ; вход RX_audio → R28=1к / C40=10нФ (τ=10 мкс, антиалиасинг для ADC squelch).
> **RC-фильтр на входе ADC `RX_audio` обязателен** (иначе squelch будет дёргать шум).

> **Вход PTT гарнитуры (`PTT_IN`, добавлен после валидации):** `PTT_IN` (J_HS_1:3, Ring 2.5 мм) → **R32 1к** (последоват.) → `PTT_RC` → **R31 10к** (pull-up на `+3V3`) + **C44 100 нФ** (на GND) → **PB5**. Кнопка замыкает линию на GND (active-low: 0 = передача). Схема зеркалит RC кнопок (τ=1 мс); R32 ограничивает ESD-бросок с кабеля гарнитуры.

## 1.5 — Интерфейсы (совместно с 2.3)
| Разъём | Тип | Сигналы | Статус |
|---|-----|---|---|
| J_PA_CTRL_1 | XH2.54 (4-pin) | GND, PTT, PWR_LIMIT_EN, PWR_LIMIT_SW | **STOCK** (XH 4-pin) |
| J_I_SENSE_1 | XH2.54 (2-pin) | I_sense, GND | **STOCK** (XH 2-pin) |
| J_SWR_1 | XH2.54 (2-pin) | SWR_sense, GND | **STOCK** (XH 2-pin) |
| J_VFO_1 | SMA (розетка) | VFO, GND (экран) | **STOCK** |
| J_BFO_1 | SMA (розетка) | BFO, GND (экран) | **STOCK** |
| J_MODE_1 | XH2.54 (2-pin) | MODE, GND | **STOCK** |
| J_PTT_MUTE_1 | XH2.54 (3-pin) | PTT, GND, MUTE | **STOCK** |
| J_AUDIO_1 | XH2.54 (3-pin) | RX_audio, GND, MIC_LINE | **STOCK** |

### Раздача 12 В — снята с платы, вынесена на WAGO (2026-10-31)
- Разъёмы `J_PA_PWR_1` и `J_RXTX_PWR_1` и 0Ω-звезда **R29/R30 убраны** с платы.
- Питание УМ и RX/TX — **напрямую с внешней клеммы WAGO 221-415** (шина +12V, факт. 13,8 В от LTC3780): `LTC3780`, `01_control` (`J_12V_IN_1`), `02_power_amp`, `03_rx_tx` — 4 провода. GND — отдельный WAGO.
- На `01_control` остаётся только свой вход: `J_12V_IN_1 → VIN_PROT → C1/C2 + U1(LM2596S-5.0)` (D1/D2 сняты, вся защита — на корпусе).
- WAGO 221-415 (5-проводные, 32 А / 450 В, 0.14–4 мм²) — ×2 (шина +12V и шина GND).

### Привязка GPIO (MCU → сигналы, 1.5)
| Пин | Сигнал | Пин | Сигнал |
|-----|---|-----|---|
| PA0 | I_sense | PB0 | LCD_BLK |
| PA1 | SWR_sense | PB1 | BTN_RIGHT |
| PA2 | RX_audio_F | PB2 | BTN_PUSH |
| PA3 | LCD_RST | PB8 | MUTE |
| PA4 | SPI_CS | PB9 | MODE |
| PA5 | SPI_SCK | PB10 | PWR_LIMIT_EN |
| PA6 | SPI_DC | PB12 | ENC_CLK |
| PA7 | SPI_MOSI | PB13 | ENC_DT |
| PA8 | PTT | PB14 | ENC_SW |
| PA11 | PWR_LIMIT_SW | PB15 | BTN_RIT |
| PC13 | BTN_UP | PC14 | BTN_DOWN |
| PC15 | BTN_LEFT | PB5 | PTT_IN |

> **Разъёмы XH2.54:** заказан **набор угловых 2P–12P** — закрывает J_OLED_1 (8P), J_BTN_1 (8P), J_PA_CTRL_1 (4P), J_I_SENSE_1/J_SWR_1 (2P), J_ENC_1 (5P), J_MODE_1 (2P), J_PTT_MUTE_1/J_AUDIO_1 (3P), плюс запас на этапы 2/3. VFO/BFO — **SMA**, не XH.
> **Интерфейс 1↔3 разбит на 5 разъёмов (2026-10-30, обновлено 2026-11-05):** VFO/BFO — **SMA** (коаксиал), MODE (2P), PTT/MUTE и RX_audio/MIC_LINE — отдельными группами (3P). Причина: физическое разнесение гетеродинов. Пинаут — `docs/contracts/control_rxtx.md`.
> **`J_OLED_1` — 8-pin** (модуль: GND/VDD/SCL/SDA/RES/DC/CS/BL; `SCL`=SCK, `SDA`=MOSI — SPI 4-wire). Подсветкой управляем (не на постоянку).

> XH2.54 2/3/4/5-pin + **набор 2P–12P угловых (заказан)**. Провода 26 AWG (сигнальные) — в наличии.
> **Клеммник входного питания `J_12V_IN_1`** — WJ127R-5.0-02P ≡ Phoenix MKDS-1,5-2 (2-pin, 5.0 мм, угловой, винтовой), футпринт `TerminalBlock_Phoenix:TerminalBlock_Phoenix_MKDS-1,5-2_1x02_P5.00mm_Horizontal`.
> Силовые провода (+12V с WAGO) — по возможности толще (≥ AWG-18). Раздача +12V на УМ/RX-TX — **через внешние WAGO 221-415**, не через плату.

## 1.6 — Отладочные светодиоды (дублирующие + вспомогательные)
> Решение зафиксировано в [`docs/led_debug_scheme.md`](../led_debug_scheme.md). Для отладки: панельные LED дублируются на плате; добавлены «power-good» LED после LDO. Новых GPIO не требуется.

| Ref | Компонент | Значение/Сигнал | Кол-во | Footprint | Статус |
|-----|---|---|---|---|---|
| D4 | LED D_PWR (дубль PWR) | `+5V`, зелёный | 1 | `LED_SMD:LED_0805_2012Metric_Pad1.15x1.40mm_HandSolder` | **STOCK** |
| D5 | LED D_TX (дубль TX) | `PTT`, красный | 1 | то же | **STOCK** |
| D6 | LED D_3V3 (power-good U2) | `+3V3`, зелёный | 1 | то же | **STOCK** |
| D7 | LED D_SI (power-good U3) | `+3V3_SI`, зелёный | 1 | то же | **STOCK** |
| D8 | LED D_DISP (power-good U9) | `+3V3_DISP`, зелёный | 1 | то же | **STOCK** |
| R36 | R (D_PWR) | 1 кОм | 1 | R_0603...HandSolder | **STOCK** |
| R37 | R (панель PWR) | 1 кОм | 1 | R_0603...HandSolder | **STOCK** |
| R38 | R (D_TX) | 470 Ом | 1 | R_0603...HandSolder | **STOCK** |
| R39 | R (панель TX) | 470 Ом | 1 | R_0603...HandSolder | **STOCK** |
| R40 | R (D_3V3) | 470 Ом | 1 | R_0603...HandSolder | **STOCK** |
| R41 | R (D_SI) | 470 Ом | 1 | R_0603...HandSolder | **STOCK** |
| R42 | R (D_DISP) | 470 Ом | 1 | R_0603...HandSolder | **STOCK** |
| J_LED_1 | Разъём панельных PWR/TX | XH2.54 **3-pin** (1=`PWR_LED`, 2=`TX_LED`, 3=`GND`) | 1 | `Connector_JST:JST_XH_B3B-XH-A_1x03_P2.50mm_Vertical` | **STOCK** |

> Топология на LED: `шина → R → LED(анод) → GND` (катод на GND). Панельные PWR/TX — резисторы на плате (R37/R39), сам LED 3 мм на панели (DEFERRED, этап 4). Панельный **LIM** — с `02_power_amp` через `J_LIM_LED_1` (не сюда). `D_SI` на `+3V3_SI` **до** R5 (не нагружаем `+3V3_SI_F`).

## Сводный дефицит (TO-ORDER)
**ДЕФИЦИТА НЕТ** по основным позициям. *(R29/R30 0 Ом убраны — раздача +12V вынесена на внешние WAGO 221-415; D1 (SMBJ18A) и D2 (SS34) сняты — компоненты в запас.)*
**EEPROM (U10):** **AT24C02CM/TR** (SOP-8/SOIC-8, 2 Кб I²C) — **TO-ORDER** (новое, добавлено 2026-10-31).
**Отладочные LED (1.6):** **0805 SMD ×5** (зел. ×4, красн. ×1) — **STOCK (в наличии)**; резисторы 0603 (R36–R42) — склад; `J_LED_1` (XH2.54 3-pin) — из набора (STOCK).

**Подсветка `LCD_BLK` — компоненты:** **AO3401 ×1** (P-MOSFET, SOT-23, Q1) — **ЗАКАЗАН у «ДКО электронщик»**; **12R 1210 ×1** (0.5 Вт, R35) — дозаказ. Полярность `BL` подтверждена (анод `LED+`). Резисторы 0603 (R33 100R / R34 100k) — склад.

## Требования к корпусу (для этапа 4) — элементы управления
| Элемент | Габарит | Монтаж |
|---|---|---|
| Джойстик 5-поз. | плата **20×25 мм**, штырёк | 4 винта М2 к стойкам; штырёк в отверстие панели **Ø8 мм** |
| **Насадка-колпачок на штырёк джойстика** | — | **3D-печать (FreeCAD)**, по факту замеров Ø и высоты штырька. Окантовка панели — тоже печать. Заменяет покупной колпачок |
| Энкодер HW-040 | плата модуля, вал с резьбой | панельное отверстие под вал, гайка |
| ST7789 2.0" | модуль ~36×60 мм (уточнить по факту) | окно в панели + 4 стойки |
| Кнопка RIT | тактильная 6×6/12×12 | отверстие панели или толкатель |
| OLED 0.96" (резерв) | — | не монтируется (отладочный) |

> Высота штырька джойстика не указана — **замерить по получении** и внести в требования. От этого зависит глубина посадки и ход колпачка.
> **Колпачок/насадка — задача этапа 4 (Mechanical/FreeCAD), не покупная позиция BOM.**

## Чек-лист приёмки (проверить при получении)
| Позиция | Что проверить |
|---|---|
| **ST7789 2.0"** | ✅ ПРИНЯТ: SPI 4-wire, маркировка **GND/VDD/SCL/SDA/RES/DC/CS/BL** (`SCL`=SCK, `SDA`=MOSI); два ряда 8-pin — дубль; 240×320; 2.8–3.3 В (без 5 В LDO!) |
| **Джойстик 5D** | **6 выводов** (5 кнопок + COM), НЕ аналоговый KY-023 (5 pin); габарит платы 20×25 мм; замерить **Ø и высоту штырька** → требования этапа 4 |
| **Энкодер HW-040** | 5 выводов (CLK/DT/SW/VCC/GND); вал; 20 шагов/оборот |
| **XH2.54 набор** | Наличие **мам (ответных частей) и проводов**, не только пап на плату; в наборе есть 5/6/7/8/10-pin |
| **C1 1000 мкФ 25 В** | Температура **105 °C** (предпочтительно); габарит реально 10×12.5 мм (footprint `CP_Elec_10x12.5`) |
| **LM2596S-5.0** | 5 выводов (TO-263-**5**), не 3 |
| **RT9193-33GB ×3** | SOT-23-5, 3 шт (U2, U3, U9) |
| **Предохранитель корпуса** | 5 А, 5×20, маркировка **T** (медленный) |
| **MMZ2012R601AT000** | 0805, 600 Ом@100 МГц, маркировка TDK |

## Статус
**BOM этапа 1 ЗАКРЫТ — дефицита нет.** ChipDip: 15 позиций + **RT9193 ×3**. Ozon: C1 (1000 мкФ/25 В SMD), энкодер HW-040, **ST7789 2.0" 240×320 SPI**. Всё остальное — склад (STOCK).

**Правка питания (входной узел):** предохранитель **F1 (3 А)** и входные **D1 (TVS SMBJ18A)/D2 (SS34)** **сняты с платы `01_control`**; вся входная защита (5 А + TVS load dump + SS54) перенесена на корпус перед предрегулятором **LTC3780 13,8 В / 7 А**. На плате остался только вход `J_12V_IN_1 → VIN_PROT → C1/C2 + U1`. Схема обновлена, ERC чистый (0 ошибок).

**Переход на SPI-дисплей (UX-решение):** основной экран — **ST7789 2.0" 240×320 SPI**. Старый OLED 0.96" остаётся резервным. Подсветка дисплея 150–200 мА → **отдельный LDO U9 (RT9193)**. SPI + DMA даёт отсутствие фризов и не блокирует Si5351 (I²C на отдельной шине).

**Элементы управления (на корпус, разъёмы на плате):** энкодер HW-040 (кнопка функциональна), джойстик 5-поз. (20×25 мм) + кнопка RIT, ST7789. **Насадка-колпачок на штырёк джойстика — задача этапа 4 (3D-печать), не покупка.**

**KiCad-сессия F1–F13 — ВЫПОЛНЕНА** (схема `01_control` разведена: питание 1.1–1.3, U7 LM358, U8 74AC541, U9 LDO дисплея, разъёмы UI, RC-фильтры). **1.4 — ГОТОВА** (MIC U7, RX_audio/squelch, UI). **1.5 (control-часть) — ГОТОВА**: привязка GPIO (23 сигнала); раздача +12V на УМ/RX-TX **снята с платы** (убраны `J_PA_PWR_1`/`J_RXTX_PWR_1` и 0Ω-звезда R29/R30) — вынесена на внешние WAGO 221-415. **1.6 (отладочные LED) — ДОБАВЛЕНА**: D4–D8 (дублирующие PWR/TX + power-good LDO), R36–R42, разъём `J_LED_1` (3-pin) — см. `docs/led_debug_scheme.md`. ERC: **0 error + 3 warning** (предсуществующие: `lib_symbol_mismatch` U9, 2× микро-стаб U6); блокер `isolated_pin_label` на `+12V_PA`/`+12V_RXTX` устранён.

Открытые вопросы:
- ~~При получении ST7789 проверить подписи пинов~~ — ✅ сверено (GND/VDD/SCL/SDA/RES/DC/CS/BL). ~~Переразвести J_OLED_1 под порядок модуля~~ — ✅ выполнено (прямой шлейф 1:1).
- Замерить высоту/Ø штырька джойстика → в требования этапа 4.
- ~~К 1.5: конкретный GPIO для `MODE`, привязка UI-линий~~ — ✅ сделано (PB9 = `MODE`; см. §1.5).
- К 2.3: согласование выходов 74AC541SC с 50-омным трактом VFO/BFO (серийные R19–R20 уже стоят).
