okunevpy-create/TRX_27MHz/docs/bom/stage3_rx_tx.md

# BOM — Этап 3: тракт RX/TX (03_rx_tx)

> **ПРЕДВАРИТЕЛЬНЫЙ (черновик).** Состав/номиналы/корпуса фиксируются в подэтапах 3.1–3.5. Ниже — каркас BOM по архитектуре `block-diagram.md` и контрактам `control_rxtx.md` / `rxtx_pa.md`.
>
> Правила: пассивные R/C в сигнальных цепях — 0603 (handsoldering); ВЧ-конденсаторы BPF/согласования — **C0G/NPO 100 В**; электролиты — SMD; разъёмы — с индексом на конце (`_1`).

## Назначение документа
BOM служит **ТЗ для отдельной KiCad-сессии (MCP)** этапа 3. Здесь — каркас состава и открытые вопросы до проработки 3.1–3.5.

## Частотный план (основа)
- Приёмный тракт: 27 МГц → BPF → 1-й смеситель (VFO 37 МГц) → **ПЧ 10 МГц** → кварцевый фильтр → детектор AM/SSB → УНЧ.
- Передача: MIC_LINE (line-level ~100 мВ) → балансный модулятор (NE612, DSB @10 МГц) → лестничный кварцевый фильтр → SSB → BPF 27 МГц → TX_RF.
- VFO = 37 МГц (верхняя гетеродинная, ~1 В pp), BFO = 10 МГц (~1 В pp) (с `01_control`).

## Статус наличия (легенда)
| Статус | Значение |
|---|---|
| **STOCK** | В наличии у пользователя |
| **ORDERED** | Заказано на этапе 1/2 (переиспользуется) |
| **TO-ORDER** | Требуется заказать перед началом этапа 3 |
| **DEFERRED** | Зафиксирован, заказ отложен (на сборку в корпус) |
| **TBD** | Уточняется в подэтапе 3.x |

## Ключевые позиции (сводно)
| Позиция | Кол-во | Статус | Примечание | Альтернатива |
|---|---|---|---|---|
| **NE612AD** (балансный смеситель/модулятор, SOP-8, ≡ SA612A/NE602) | 3 | **ORDERED** | смеситель RX + модулятор TX + продукт-детектор SSB | К174ПС4 |
| **Лестничный кварцевый фильтр 10 МГц** | 1 | **ORDERED** | 4× кварц HC-49SM (подобранные) + связующие C0G, полоса AM/SSB | монолит |
| **LM386** (УНЧ, SOP-8) | 1 | **ORDERED** | выход на 8 Ом динамик | TDA2003 |
| **LM7809** (12→9 В) | 1 | **ORDERED** | линейный стабилизатор (LM7809CT, TO-220) | 78L09 |
| Диоды защиты RX (антипараллельная пара) | 2 | **ORDERED** | 1N4148WS ×2 (кремний, ~0.7 В) | BAT54 (Шоттки, ~0.3 В) |
| Резисторы аттенюатора 3–6 дБ (50 Ом) | 3 | **STOCK** | T-pad 3 дБ: 8.2 Ом×2 + 150 Ом; 6 дБ: 16 Ом×2 + 68 Ом | — |
| Разрядник (опц.) | 1 | **TO-ORDER (опц.)** | защита входа RX | — |
| Катушки/конденсаторы BPF 27 МГц | 14 | **ORDERED** (катушки) | SMD 0.47 мкГн (4) заказаны; C0G (10) — расчёт 3.1 | T37-6 тора |

> ⚠️ **Открытые вопросы (решаются в 3.x):**
> 1. **TX-раскачка 0,5 Вт:** SA612 на выходе даёт ~−10 дБм, а контракт требует ~0,5 Вт. **РЕШЕНО: драйвер = 2SC2314** (NPN, TO-92L, класс A/AB) — каскад на `03_rx_tx` в 3.4.
> 2. ✅ **Продукт-детектор SSB** (BFO 10 МГц): **РЕШЕНО — NE612AD #3** (есть в наличии).
> 3. ✅ **Кварцевый фильтр 10 МГц:** **РЕШЕНО — лестничный** из 4 дискретных кварцев 10 МГц HC-49SM (**ЗАКАЗАН**) + связующие конденсаторы.

## 3.1 — BPF 27 МГц
| Ref | Позиция | Значение | Кол-во | Символ | Footprint | Статус |
|-----|---|---|---|---|---|---|
| L1, L2 | Катушки входного BPF (RX) | 0.47 мкГн SMD (MLF2012DR47KT000, 0805) | 2 | `Device:L` | `Inductor_SMD:L_0805_2012Metric_Pad1.05x1.20mm_HandSolder` | **ORDERED** |
| L3, L4 | Катушки выходного BPF (TX) | 0.47 мкГн SMD (MLF2012DR47KT000, 0805, 200 мА) | 2 | `Device:L` | `Inductor_SMD:L_0805_2012Metric_Pad1.05x1.20mm_HandSolder` | **ORDERED** |
| C2, C4 | Подстроечные контуров BPF RX (∥ L) | **51 пФ** C0G/NPO 100 В | 2 | `Device:C` | `Capacitor_SMD:C_0805_2012Metric_Pad1.18x1.45mm_HandSolder` | **TO-ORDER** |
| C1, C5 | Согласующие вх/вых BPF RX (посл.) | **18 пФ** C0G/NPO 100 В | 2 | `Device:C` | то же | **TO-ORDER** |
| C3 | Связь контуров BPF RX | **2.7 пФ** C0G/NPO 100 В | 1 | `Device:C` | то же | **TO-ORDER** |
| C7, C9 | Подстроечные контуров BPF TX (∥ L) | **51 пФ** C0G/NPO 100 В | 2 | `Device:C` | то же | **TO-ORDER** |
| C6, C10 | Согласующие вх/вых BPF TX (посл.) | **18 пФ** C0G/NPO 100 В | 2 | `Device:C` | то же | **TO-ORDER** |
| C8 | Связь контуров BPF TX | **2.7 пФ** C0G/NPO 100 В | 1 | `Device:C` | то же | **TO-ORDER** |

> ✅ **Расчёт 3.1 (SPICE ngspice):** двухконтурный ёмкостно-связанный полосовой фильтр (2 полюса Баттерворт). Номинал на фильтр: **2×0.47 мкГн + 2×51 пФ + 2×18 пФ + 1×2.7 пФ** (C0G/NPO 100 В, 0805). Итого **4×L + 10×C0G** (вместо черновых «6 C0G»). Центр ≈27.5 МГц, полоса −3 дБ ≈1.4 МГц, согласование 50 Ом, подавление 47 МГц (зеркальный) / 54 МГц (2-я гармоника) ≥45 дБ. Расчёт — `docs/calculations/bpf_27mhz.md`.

## 3.2 — Смеситель + ПЧ 10 МГц + кварцевый фильтр
| Ref | Позиция | Значение | Кол-во | Символ | Footprint | Статус |
|-----|---|---|---|---|---|---|
| U1 | 1-й смеситель RX (VFO 37 МГц) | **NE612AD** (SOP-8, ≡ SA612A) | 1 | кастомный | `Package_SO:SOIC-8_3.9x4.9mm_P1.27mm` | **ORDERED** |
| X1, X2, X3, X4 | Кварцы лестничного фильтра | **10 МГц** HC-49SM (подобранные, ≤100 Гц) | 4 (+2 запас) | `Device:Crystal` | `Crystal:Crystal_SMD_HC49-SD_HandSoldering` | **ORDERED** |
| C_lad | Связующие конденсаторы (перекл. AM/SSB) | C0G/NPO, номинал по АЧХ | ~4 | `Device:C` | C_0603/C_0805 HandSolder | **STOCK** |
| R1, R2 | Согласование/терминация фильтра | расчёт в 3.2 | 2 | `Device:R` | R_0603_HandSolder | **STOCK** |
| C7, C8 | Развязка/согласование ПЧ | 100 нФ / расчёт | 2 | `Device:C` | C_0603_HandSolder | **STOCK** |

> ⚠️ **NE612** питание ≤ 8 В (абс. макс 9 В) — питать от локального LDO (3.5), не напрямую от LM7809. **Символ `NE612A` создан (кастомный) и добавлен в библиотеку** (доступность проверяется MCP).
>
> ⚠️ **Лестничный фильтр:** кварцы подобрать по частоте (разброс ≤ 50–100 Гц); полоса задаётся связующими конденсаторами (SSB ~2,4 кГц / AM ~6 кГц), терминация 200–1000 Ом. Топология и номиналы — при проектировании в 3.2.

## 3.3 — Детектор AM/SSB + УНЧ + защита входа RX
| Ref | Позиция | Значение | Кол-во | Символ | Footprint | Статус |
|-----|---|---|---|---|---|---|
| U2 | Продукт-детектор SSB (BFO 10 МГц) | **NE612AD** (SOP-8) | 1 | кастомный | `Package_SO:SOIC-8_3.9x4.9mm_P1.27mm` | **ORDERED** |
| D1, D2 | Антипараллельная пара защиты RX | **1N4148WS** (SOD-323F) | 2 | `Device:D` | `Diode_SMD:D_SOD-323F` | **ORDERED** |
| R3, R4, R5 | Аттенюатор входа RX (3–6 дБ) | π/T-pad, расчёт | 3 | `Device:R` | R_0603_HandSolder | **STOCK** |
| G1 | Разрядник (опц.) | — | 1 | TBD | TBD | **TO-ORDER (опц.)** |
| U3 | УНЧ | **LM386** (SOP-8) | 1 | `Amplifier_Audio:LM386` | `Package_SO:SOIC-8_3.9x4.9mm_P1.27mm` | **ORDERED** |
| C9, C10 | Фильтр/развязка УНЧ | расчёт в 3.3 | 2 | `Device:C` | C_0603_HandSolder / CP_Elec | **STOCK** |

> ⚠️ Защита RX обязательна: RX_RF до 1 Вт просачивания (контракт `rxtx_pa.md`). Аттенюатор 3–6 дБ + антипараллельные диоды + место под разрядник.

## 3.4 — Формирователь SSB (фильтровый метод) + драйвер TX
| Ref | Позиция | Значение | Кол-во | Символ | Footprint | Статус |
|-----|---|---|---|---|---|---|
| U4 | Балансный модулятор TX | **NE612AD** (SOP-8, ≡ SA612A) | 1 | кастомный | `Package_SO:SOIC-8_3.9x4.9mm_P1.27mm` | **ORDERED** |
| Q1 | Драйвер TX | **2SC2314** (NPN, TO-92L, класс A/AB) | 1 | `Transistor_BJT:Q_NPN_BCE` | `Package_TO_SOT_THT:TO-92L_HandSolder` | **ORDERED** |
| R6–R9, C11–C14 | Согласование/фильтр SSB | точные (1 %), расчёт в 3.4 | 8 | `Device:R`/`Device:C` | R/C_0603_HandSolder | **STOCK** |
| — | Смещение/согласование Q1 (2SC2314) | расчёт в 3.4 | TBD | `Device:R`/`Device:C` | R/C_0603_HandSolder | **STOCK** |

> ✅ **Драйвер TX — РЕШЕНО: 2SC2314** (NPN, TO-92L, класс A/AB линейный для SSB/AM). Обеспечивает раскачку УМ (контракт `rxtx_pa.md`).

## 3.5 — Питание
| Ref | Позиция | Значение | Кол-во | Символ | Footprint | Статус |
|-----|---|---|---|---|---|---|
| U5 | Линейный стабилизатор | **LM7809CT** (12→9 В, TO-220) | 1 | `Regulator_Linear:L7809` | `TO-220-3_Vertical` | **ORDERED** |
| U6 | Локальный LDO смесителей (NE612) | **L78L06ABZ** (6 В, 100 мА, TO-92) | 1 | `Regulator_Linear:L78L06_TO92` | `Package_TO_SOT_THT:TO-92_Inline` | **ORDERED** |
| C15, C16 | Развязка вход/выход 7809 | электролит + керамика | 2 | `Device:C` | CP_Elec / C_0805 | **STOCK** |
| FB1 | Феррит питания ВЧ-узлов (опц.) | — | 1 | `Device:FerriteBead` | L_0805 | **STOCK** |

## Разъёмы (J1–J9)
| Ref | Тип | Назначение | Footprint | Статус |
|-----|-----|---|---|---|
| J2 | SMA (розетка) | выход `TX_RF` на `02_power_amp` | `trx_custom:SMA_S-P215` | **STOCK** |
| J1 | SMA (розетка) | вход `RX_RF` от `02_power_amp` | `trx_custom:SMA_S-P215` | **STOCK** |
| J3 | SMA (розетка) | VFO (37 МГц) | `trx_custom:SMA_S-P215` | **STOCK** |
| J4 | SMA (розетка) | BFO (10 МГц) | `trx_custom:SMA_S-P215` | **STOCK** |
| J5 | XH2.54 2-pin | MODE (0=SSB / 1=AM) + GND | `Connector_JST:JST_XH_B2B-XH-A_1x02_P2.50mm_Vertical` | **STOCK** |
| J6 | XH2.54 3-pin | PTT, GND, MUTE | `Connector_JST:JST_XH_B3B-XH-A_1x03_P2.50mm_Vertical` | **STOCK** |
| J7 | XH2.54 3-pin | RX_audio, GND, MIC_LINE | то же | **STOCK** |
| J8 | клеммник 2P 5.0 мм | +12V_RXTX, GND | `TerminalBlock_Phoenix:TerminalBlock_Phoenix_MKDS-1,5-2_1x02_P5.00mm_Horizontal` | **ORDERED** (этап 1) |
| J9 | XH2.54 2-pin | выход УНЧ на динамик 8 Ом (SP+/GND) | `Connector_JST:JST_XH_B2B-XH-A_1x02_P2.50mm_Vertical` | **STOCK** |

> ✅ Разъёмы на схеме `03_rx_tx` — `J1`–`J9` (с числовым индексом на конце). VFO/BFO — **SMA** (как на `01_control`). Сторона `01_control` для тех же сигналов: `J_VFO_1`/`J_BFO_1` (SMA), `J_MODE_1`/`J_PTT_MUTE_1`/`J_AUDIO_1` (XH) — см. `control_rxtx.md`.

## Сводный дефицит (TO-ORDER)
**Весь актив этапа 3 — TO-ORDER (этап ещё не начат):**
- **NE612AD (SOP-8) ×3** (≡ SA612A/NE602) — **ЗАКАЗАН**; смеситель RX + модулятор TX + продукт-детектор SSB.
- **Кварцы 10 МГц HC-49SM ×4** (**ЗАКАЗАН**; +2 запас на подбор) + связующие C0G/NPO конденсаторы.
- **L78L06 ×1** (6 В LDO смесителей) — **ЗАКАЗАН** (L78L06ABZ). **LM386/LM7809 — ЗАКАЗАНЫ** (SOP-8 / LM7809CT).
- **Катушки BPF 27 МГц** — **SMD 0.47 мкГн** 0805 (MLF2012DR47KT000, ×4) — **ЗАКАЗАНЫ** + C0G/NPO конденсаторы BPF (×10: 4×51 пФ + 4×18 пФ + 2×2.7 пФ).
- **Драйвер TX = 2SC2314** (РЕШЕНО, **ЗАКАЗАН**) ×1 + обвязка (смещение/согласование).

**STOCK / переиспользуется с этапов 1–2:** 1N4148WS, BAT54, пассив 0603, C0G, XH2.54 (набор), SMA, клеммник WJ127R-5.0-02P (1 из заказанных ×3).

## Статус
**🟢 СОГЛАСОВАН (базовый BOM).** Все ключевые позиции заказаны: NE612AD ×3, 2SC2314, 1N4148WS ×2, кварцы 10 МГц HC-49SM, LM386 (SOP-8), LM7809CT, L78L06ABZ (LDO 6 В), MLF2012DR47KT000 (0.47 мкГн). Решено: драйвер TX = 2SC2314; смеситель/модулятор/продукт-детектор = NE612AD ×3; кварцевый фильтр = лестничный (4× 10 МГц HC-49SM). Осталось: номиналы контуров/фильтров (C0G) — расчёт в 3.1–3.5.
