okunevpy-create/TRX_27MHz/docs/bom/stage2_power_amp.md

# BOM — Этап 2: усилитель мощности (02_power_amp)

> Правила: пассивные резисторы/керамика в сигнальных цепях — 0603; footprint — handsoldering (при наличии), иначе обычный SMD/THT.
>
> **Исключения из правила 0603 (RF/силовые):** конденсаторы ФНЧ — C0G/NPO 100 В (0805, не X7R); ферриты/трансформаторы/индуктивности — тора/бинокуляры; шунт тока — силовой резистор; электролиты — SMD. Все такие позиции помечены ⚠️ и считаются отдельными позициями заказа.
>
> **Тумблер LIMIT/FULL (SW1) монтируется на панель (корпус); на плате — разъём `J_SW_1` (XH2.54 3-pin).** Аналогично подходу этапа 1: элементы управления на корпусе, на плате — разъёмы под проводной монтаж.

## Назначение документа
BOM служит **техническим заданием для отдельной KiCad-сессии (MCP)**. Здесь зафиксированы: состав, номиналы, корпуса (footprint), символы, статус наличия, альтернативы. Правки KiCad-файлов выполняет MCP-сессия (см. `docs/kicad_task_stage2.md`).

## Статус наличия (легенда)
| Статус | Значение |
|---|---|
| **STOCK** | В наличии у пользователя |
| **ORDERED** | Заказано (ChipDip / Ozon), с датой |
| **TO-ORDER** | Требуется заказать/найти |
| **DEFERRED** | Зафиксирован, заказ отложен (на этап сборки в корпус) |

> ✅ **Корзина ChipDip этапа 2 — `Stock/ChipDipCart-Stage_2.csv`** (12 позиций, доставка 30 окт–10 ноя): BN-61-202 ×3, T50-6 ×2, T68-2 ×1, реле IM06GR ×1, шунт PA2512 ×1, конденсаторы C0G (120пФ ×10 / 220пФ ×5), подстроечник 3296W ×1, 2N7002 ×2, BAT54 ×2, **1N4148WS ×3**, **LM358 ×2**.
>
> ✅ **Заказ «ДКО электронщик»:** **RD16HHF1-501 ×2**, **AO3401 ×1**, **MMZ2012R601AT000**.
>
> ✅ **Тумблер LIMIT/FULL:** **ASW-14-102**, ON-ON, **SPDT 3P**, 20A 12VDC — заказан.
>
> ✅ **Теплоотвод:** радиатор **HS 104-30** (30×102×24.5 мм, Rth 3.1 °C/Вт) ×1 + изоляторы TO-220 ×2 + втулки 3 мм (под винт M3) ×2 — заказаны.

## Ключевые позиции (сводно)
| Позиция | Кол-во | Статус | Примечание | Альтернатива |
|---|---|---|---|---|
| **RD16HHF1-501** (Mitsubishi, ВЧ MOSFET) | 2 | **ORDERED** (ДКО электронщик) | push-pull, класс AB, ~12–15 Вт | RD15HVF1 / 2× IRF510 (хуже) |
| Трансформатор входа (балун) | 1 | **ORDERED** (ChipDip) | BN-61-202 (бинокуляр) | — |
| Трансформатор выхода (балун) | 1 | **ORDERED** (ChipDip) | BN-61-202 (бинокуляр) | — |
| RFC (дроссель стока) | 1 | **ORDERED** (ChipDip) | тор T68-2 (iron powder №2) | феррит-бусы ×n |
| Индуктивности ФНЧ (360 нГн) | 2 | **ORDERED** (ChipDip) | T50-6 (iron powder), ~10 витков | T37-6 / SMD |
| Конденсаторы ФНЧ C0G 100 В | 3 | **ORDERED** (ChipDip) | 120пФ×2 + 220пФ×1, 0805 C0G 100 В | ATC/porcelain |
| Тумблер LIMIT/FULL | 1 | **ORDERED** (ASW-14-102) | ON-ON, SPDT 3P, 20A 12VDC, на панели (через J_SW_1) | — |
| Подстроечник (калибровка 4 Вт) | 1 | **ORDERED** (ChipDip) | Bourns 3296W-1-103LF, 10к, многооборотный | однооборотный 10к |
| Реле T/R 12 В (DPDT) | 1 | **ORDERED** (ChipDip) | TE IM06GR (2-1462037-3), SMD gull-wing, 2А, RF-пригодно | IM06JR (J-leg) |
| Шунт тока (I_sense) | 1 | **ORDERED** (ChipDip) | 0.05 Ом 1%, 2 Вт (Yageo PA2512FKE7W0R05E) | 0.1 Ом |
| Ответвитель КСВ (тор) + диоды | 1 | **ORDERED** (ChipDip) | BN-61-202 + BAT54 | готовый мост |
| SMA (J_RF_TX_1, J_RF_RX_1) | 2 | **STOCK** | s-p215 «стульчик» | — |
| BNC BJ2 (J_ANT_1, панель) | 1 | **DEFERRED** (корпус) | панельный, **BJ2**, на заднюю крышку | SO-239 |
| Радиатор (общий, 2× TO-220) | 1 | **ORDERED** | HS 104-30 (30×102×24.5 мм, Rth 3.1 °C/Вт) + изоляторы/втулки | повторно/профиль |

> **Заказано полностью (ChipDip `Stock/ChipDipCart-Stage_2.csv` + ДКО + тумблер ASW-14-102 + радиатор HS 104-30 + изоляторы/втулки).** **TO-ORDER — нет.** DEFERRED (не блокирует 2.1–2.3): BNC (корпус). Пассив 0603 и SMA/XH — со склада.

## 2.1 — Push-pull УМ (RD16HHF1 + трансформаторы + RFC)
| Ref | Позиция | Значение | Кол-во | Символ | Footprint | Статус |
|-----|---|---|---|---|---|---|
| Q1, Q2 | ВЧ MOSFET push-pull | **RD16HHF1-501** (30 В / 4 А; Po 16–19 Вт, ηD 55–65 %, Idq 0.5 А, Rth_j-c 2.2 °C/Вт) | 2 | `trx_custom:RD16HHF1` ✅ | `Package_TO_SOT_THT:TO-220-3_Vertical` | **ORDERED** (ДКО электронщик) |
| T1 | Входной балун (50 Ом → затворы) | бифиляр, **BN-61-202** (феррит 61) | 1 | `Device:Transformer_1P_1S` ✅ | `Connector_PinHeader_2.54mm:PinHeader_1x04_P2.54mm_Vertical` ✅ (4 пада) | **ORDERED** (ChipDip) |
| T2 | Выходной балун (стоки → 50 Ом) | бифиляр, **BN-61-202** (феррит 61) | 1 | `Device:Transformer_SP_1S` ✅ (первичка с отводом, 5 выв.) | `Connector_PinHeader_2.54mm:PinHeader_1x05_P2.54mm_Vertical` ✅ (5 падов 1–5) | **ORDERED** (ChipDip) |
| L1 | Дроссель питания стоков | 4–6 мкГн, ~2 А (ПЭВ-2 Ø0.5 мм, 26–32 витка, номинал 30) | 1 | `Device:L` | `Inductor_THT:L_Toroid_Vertical_L17.8mm_W8.1mm_P7.62mm_Bourns_5700` ✅ (T68-2) | **ORDERED** (ChipDip) |
| C1, C2 | Развязка стоков (ВЧ) | 100 нФ (C0G/X7R) | 2 | `Device:C` | C_0603_HandSolder | **STOCK** |
| C4 | Электролит питания УМ | 470 мкФ/35 В SMD (10×10.5) | 1 | `Device:C_Polarized` | `CP_Elec_10x10.5` | **STOCK** |
| C3 | Керамика bulk 12 В | 10 мкФ (25 В X7R) | 1 | `Device:C` | C_0805_HandSolder | **STOCK** |
| R1, R2 | Затворные (антипаразитные) | 4.7–10 Ом | 2 | `Device:R` | R_0603_HandSolder | **STOCK** |
| R17, R18 | Отриц. ОС / стабилизация (опц., DNP) | 100–220 Ом | 2 | `Device:R` | R_0603_HandSolder | **STOCK** |

> ⚠️ **RD16HHF1 — корпус TO-220, но цоколёвка НЕСТАНДАРТНАЯ: 1=GATE, 2=SOURCE, 3=DRAIN, 4=FIN(SOURCE).** Вывод 2 = **Source** (а не Drain), вывод 3 = **Drain** (а не Source), фланец = Source. Footprint штатный `Package_TO_SOT_THT:TO-220-3_Vertical` (или Horizontal — по монтажу радиатора); нюанс — только в символе `trx_custom:RD16HHF1`: нумерация пинов **G→1, S→2 (+FIN→4), D→3**. ✅ **Символ создан, цоколёвка проверена (1=G, 2=S, 3=D, 4=FIN(S)).** ⚠️ **Риск — доступность (возможен EOL Mitsubishi):** альтернативы — RD15HVF1 (TO-220), RD06HVF1 (TO-220, меньше мощность), BJT 2SC2078/2SC1971 (TO-220).
>
> **Драйвер (раскачка) — РЕШЕНО: НЕ НУЖЕН.** Вход — `TX_RF` ~0.5 Вт (контракт `rxtx_pa.md`). По даташиту RD16HHF1 (single-ended, VDD=12.5 В, f=30 МГц, Idq=0.5 А): Po=16–19 Вт при Pin=0.4 Вт → усиление **16.0–16.8 дБ**. Для push-pull 12 Вт PEP (по 6 Вт на транзистор) требуется Pin ≈ 6/40 ≈ **0.15 Вт на транзистор** → 0.3 Вт суммарно. Раскачка 0.5 Вт даёт запас **×1.67 (+2.2 дБ)**. Активный драйвер-каскад не ставим; **место/пады зарезервировать** (не монтировать) как страховку.

> ✅ **Ферриты/трансформаторы — финальные символы и footprint'ы (зафиксировано 2026-10-30):**
> - **T1** (входной балун, BN-61-202): `Device:Transformer_1P_1S` (4 выв. P1/P2/S1/S2) + `Connector_PinHeader_2.54mm:PinHeader_1x04_P2.54mm_Vertical` (4 пада 1–4).
> - **T2** (выходной балун, BN-61-202): `Device:Transformer_SP_1S` (5 выв. PR1/PM/PR2/S1/S2 — первичка с отводом) + `Connector_PinHeader_2.54mm:PinHeader_1x05_P2.54mm_Vertical` (5 падов 1–5).
> - **T3** (токовый КСВ, BN-61-202): `Device:Transformer_1P_1S` (4 выв. AA/AB — первичка = 1 проход линии ANT в разрыв; SA/SB — вторичка) + `Connector_PinHeader_2.54mm:PinHeader_1x04_P2.54mm_Vertical` (4 пада).
> - **L1** (T68-2): `Device:L` + `Inductor_THT:L_Toroid_Vertical_L17.8mm_W8.1mm_P7.62mm_Bourns_5700`.
> - **L2, L3** (T50-6): `Device:L` + `Inductor_THT:L_Toroid_Vertical_L13.0mm_W6.5mm_P5.60mm`.
> - **BN-61-202 — бинокуляр** (2 отверстия), стандартного footprint в KiCad нет; используем generic-пады (пин-хедер), silkscreen декоративный. `Connector:CUI_PD-30S_CircularHoles` **отклонён** (пады пронумерованы 1/2/3/4/SH — пин 5 `S2` не связался бы).
> - Поле `Value` символа — название сердечника (`BN-61-202` / `T50-6` / `T68-2`).

## 2.2 — ФНЧ 27 МГц (5-й порядок, Чебышёв 0.1 дБ)
> Расчёт — `docs/calculations/lpf_27mhz.md`. Топология (лестница): C — L — C — L — C, `Z0 = 50 Ом`, `fc = 30 МГц`.

| Ref | Позиция | Значение | Кол-во | Символ | Footprint | Статус |
|-----|---|---|---|---|---|---|
| C6, C8 | Конденсатор ФНЧ (вх/вых) | **120 пФ** C0G 100 В ±2% (0805N121G101CT) | 2 | `Device:C` | C_0805_HandSolder | **ORDERED** (ChipDip) |
| C7 | Конденсатор ФНЧ (сред.) | **220 пФ** C0G 100 В ±5% (CC0805JRNPO0BN221) | 1 | `Device:C` | C_0805_HandSolder | **ORDERED** (ChipDip) |
| L2, L3 | Индуктивность ФНЧ | **360 нГн**, T50-6, 10 витков (ПЭВ-2 Ø0.5 мм) | 2 | `Device:L` | `Inductor_THT:L_Toroid_Vertical_L13.0mm_W6.5mm_P5.60mm` ✅ (T50-6) | **ORDERED** (ChipDip) |

> ⚠️ **Конденсаторы ФНЧ — обязательно C0G/NPO (не X7R!), номинал 100 В** (пиковое ВЧ на 50 Ом при 12 Вт PEP ≈ 35 В). X7R на 27 МГц даёт потери и уход ёмкости. Из склада 0603 (120 пФ — NPO 50 В) **недостаточно** по напряжению; заказ 0805 C0G 100 В.
>
> ⚠️ **Индуктивности — T50-6** (жёлтый, iron powder, тип 6, **AL=4.0 нГн/вит²**), провод **ПЭВ-2 Ø0.5 мм**, **10 витков** (N=√(360/4.0)=9.49). Расчёт — `docs/calculations/pa_stage2.md` §2.6; финально подобрать на готовой плате по КСВ/спектру.

## 2.3 — Датчики + LIMIT/FULL + смещение + T/R
| Ref | Позиция | Значение | Кол-во | Символ | Footprint | Статус |
|-----|---|---|---|---|---|---|
| SW1 | Тумблер LIMIT/FULL | **ASW-14-102**, ON-ON, SPDT 3P, 20A 12VDC | 1 | `Switch:SW_SPDT` | **на панели (корпус)**; на плате — разъём `J_SW_1` (XH2.54 3-pin) ✅ | **ORDERED** |
| RV1 | Подстроечник калибровки 4 Вт | 10к, многооборотный (**Bourns 3296W-1-103LF**) | 1 | `Device:R_Potentiometer` | `Potentiometer_Bourns_3296W_Vertical` | **ORDERED** (ChipDip) |
| D_lim | Светодиод индикации LIMIT | красный, 3 мм, **на передней панели** | 1 | `Device:LED` | — (панель) | **DEFERRED** (корпус) |
| J_LIM_LED_1 | Разъём светодиода LIMIT | XH2.54 2-pin | 1 | `Conn_01x02` | `Connector_JST:JST_XH_B2B-XH-A_1x02_P2.50mm_Vertical` | **STOCK** |
| R9 | Ограничитель тока LED | 1–2.2 к | 1 | `Device:R` | R_0603_HandSolder | **STOCK** |
| Q3 | Ключ PWR_LIMIT_EN (прогр.) | 2N7002 (N-MOSFET 60 В/115 мА) | 1 | `Transistor_FET:2N7002` | `SOT-23` | **ORDERED** (ChipDip) |
| Q4 | Ключ реле PTT | 2N7002 (N-MOSFET 60 В/115 мА) | 1 | `Transistor_FET:2N7002` | `SOT-23` | **ORDERED** (ChipDip) |
| R20 | Подтяжка затвора Q4 (PTT) к GND | 10 кОм (0603) | 1 | `Device:R` | R_0603_HandSolder | **STOCK** |
| R21 | Подтяжка входа PWR_LIMIT_SW→PLIM_LIM (нет тумблера = LIMIT) | 100 кОм (0603) | 1 | `Device:R` | R_0603_HandSolder | **STOCK** |
| D1 | Обратный диод реле | **1N4148WS** (0.15 А/100 В, SOD-323F) | 1 | `Device:D` | `Diode_SMD:D_SOD-323F` | **ORDERED** (ChipDip) |
| K1 | Реле T/R | **TE IM06GR (2-1462037-3)**, 12 В, DPDT 2А, SMD | 1 | `trx_custom:IM06GR` | `trx_custom:Relay_DPDT_AXICOM_IM06GR_GullWing` | **ORDERED** (ChipDip) |
| R16 | Шунт тока I_sense | **0.05 Ом 1% / 2 Вт** (Yageo PA2512FKE7W0R05E) | 1 | `Device:R` | `Resistor_SMD:R_2512_6332Metric` | **ORDERED** (ChipDip) |
| U1 | Усилитель I_sense | LM358 (single supply 12 В) | 1 | `Amplifier_Operational:LM358` | `Package_SO:SOIC-8_3.9x4.9mm_P1.27mm` | **ORDERED** (ChipDip) |
| R12, R13, R14, R15 | Делители/усиление I_sense и SWR | по расчёту (0603) | 4 | `Device:R` | R_0603_HandSolder | **STOCK** |
| T3 | Трансформатор тока (мост КСВ) | **BN-61-202** | 1 | `Device:Transformer_1P_1S` ✅ (первичка — 1 проход линии ANT в разрыв; вторичка → SWR_RF) | `Connector_PinHeader_2.54mm:PinHeader_1x04_P2.54mm_Vertical` ✅ (4 пада) | **ORDERED** (ChipDip) |
| D4, D5 | Детекторные диоды КСВ | BAT54 (0.2 А/30 В, Шоттки) | 2 | `Diode:BAT54W` | `Package_TO_SOT_SMD:SOT-23-3` | **ORDERED** (ChipDip) |
| C11 | Конденсатор выборки напряжения (return-loss мост) | 22 пФ C0G/NP0 100 В (подбор 10–33 пФ) | 1 | `Device:C` | C_0805_HandSolder | **STOCK** |
| R7, R8 | Делитель PWR_LIMIT_SW (+12В→3.3В) | 27к / 10к (0603) | 2 | `Device:R` | R_0603_HandSolder | **STOCK** |
| R3, R4 | Резистор смещения затворов (VGG→GATE) | 10 кОм (0603) | 2 | `Device:R` | R_0603_HandSolder | **STOCK** |
| R5 | Верхнее плечо делителя VGG_FULL | 10 кОм (0603) | 1 | `Device:R` | R_0603_HandSolder | **STOCK** |
| R6 | Нижнее плечо делителя VGG_FULL | 2.7 кОм (0603) | 1 | `Device:R` | R_0603_HandSolder | **STOCK** |
| R19 | Резистор выбора VGG (VGG_FULL→VGG) | 100 кОм (0603) | 1 | `Device:R` | R_0603_HandSolder | **STOCK** |
| C5 | Фильтр шины смещения VGG | 100 нФ (0603) | 1 | `Device:C` | C_0603_HandSolder | **STOCK** |
| C9 | Фильтр датчика I_sense | 100 нФ (0603) | 1 | `Device:C` | C_0603_HandSolder | **STOCK** |
| C10 | Фильтр датчика SWR_sense | 100 нФ (0603) | 1 | `Device:C` | C_0603_HandSolder | **STOCK** |

> ⚠️ **Смещение затворов (ключевой узел 2.3):** RD16HHF1 — MOSFET, ток покоя задаётся напряжением на затворах (**Idq=0.5 А на плечо** по даташиту, 1 А на пару). Смещение формируется делителем от `+12V_PA` (Vgg ≈ 2–2.5 В). **`VGG` (аналог) НЕ покидает плату** — выбор LIMIT/FULL делают MOSFET'ы на плате, на панель (тумблер SW1) уходит только логика.
> - **`VGG_FULL`** = R5/R6 (10к/2.7к от +12В ≈ 2.55 В). **`VGG_LIMIT`** = движок RV1. **`VGG`** (на затворы) подтянут к `VGG_FULL` через **R19 (100к)** (по умолчанию FULL).
> - **LIMIT (вариант C):** тумблер SW1 (SPDT) замыкает `PWR_LIMIT_SW` на `PLIM_LIM` (3.3 В) → MCU читает HIGH и выставляет `PWR_LIMIT_EN`=1 → ключ **Q3 (2N7002)** притягивает `VGG` к `VGG_LIMIT`. FULL — тумблер замыкает `PWR_LIMIT_SW` на GND → MCU читает LOW → Q3 закрыт → `VGG`=FULL. **R21 (100 кОм, 0603)** — подтяжка `PWR_LIMIT_SW`→`PLIM_LIM`: при отключённом тумблере MCU читает HIGH (=LIMIT).
> - **Единственный ключ:** `PWR_LIMIT_EN` (active-high, прошивка) → ключ **Q3 (2N7002)** притягивает `VGG` к `VGG_LIMIT`. Прошивка: `PWR_LIMIT_EN = AM && (тумблер LIMIT)`; в SSB лимит не действует. Захардкоженного дефолта нет — читается положение тумблера.
> - **Светодиод D_lim** — зажигается от `PWR_LIMIT_EN` (состояние Q3) напрямую через R10/R9 (без диодного ИЛИ). **На передней панели**, на плате — разъём `J_LIM_LED_1` (XH2.54 2-pin). В FULL + AM прошивка предупреждает на OLED (читает `PWR_LIMIT_SW`).
> - **Стабилизация (опц.):** последовательный NTC или диод в делителе Vgg — компенсация дрейфа порога с температурой; место зарезервировать.
>
> ⚠️ **I_sense:** шунт 0.05 Ом в плюсовой/минусовой шине `+12V_PA`. Полный ток ~2–3 А → падение 100–150 мВ. Усилитель LM358 (питание `+12V_PA`) → выход 0–3.3 В через делитель на ADC (PA0). Точное усиление — `docs/calculations/pa_stage2.md`.
>
> ⚠️ **SWR_sense:** return-loss мост (отражённая мощность): трансформатор тока T3 (BN-61-202, первичка — 1 проход линии ANT в разрыв, вторичка → SWR_RF) + конденсатор выборки напряжения C11 (22 пФ C0G/NP0, подбор 10–33 пФ) с линии ANT на SWR_RF. Падающая волна гасится → при согласовании 50 Ом SWR_sense≈0. Детектор BAT54 (D4/D5) → 0–3.3 В (PA1). Подбор C11 — с эквивалентом 50 Ом на J_ANT_1 до минимума SWR_sense.
>
> ⚠️ **T/R:** реле K1 = **TE IM06GR (2-1462037-3)** — SMD **gull-wing**, 12 В/140 мВт (Rкат≈1029 Ом), DPDT 2А/250VAC, RF-пригодно (изоляция 37 дБ @100 МГц). Логика контактов: **COM → J_ANT_1**, **NO → выход ФНЧ (TX)**, **NC → RX_RF**; обесточенное состояние = RX. Управление — PTT (3.3 В) через ключ Q4 + обратный диод D1 (1N4148WS, катод на `+12V_PA`). Символ — `trx_custom:IM06GR`. Footprint — **`trx_custom:Relay_DPDT_AXICOM_IM06GR_GullWing`** (кастомный, gull-wing). Физические пины 1–8 — по даташиту §Terminal assignment.

> ✅ **Тумблер SW1 (ASW-14-102) — SPDT 3P (ON-ON, 20A 12VDC)**: на панели, коммутирует только логику `PWR_LIMIT_SW` (COM) между `PLIM_LIM` (LIMIT) и `GND` (FULL). Аналоговый `VGG` на панель не выходит.
>
> ✅ **Разъём `J_SW_1` (XH2.54 3-pin vertical) — под панельный тумблер SW1.** SW1 монтируется на панель; на плате — только разъём. Пины:
> | Пин | Сигнал | Назначение |
> |-----|--------|-----------|
> | 1 | `PWR_LIMIT_SW` | COM (общий контакт тумблера) → вход MCU через `J_PA_CTRL_1:4` |
> | 2 | `PLIM_LIM` | LIMIT → +12В через R7 (27к) → 3.24 В |
> | 3 | `GND` | FULL → земля |

## 2.4 — Теплоотвод (радиатор HS 104-30)
| Ref | Позиция | Значение | Кол-во | Footprint | Статус |
|-----|---|---|---|---|---|
| HS1 | Радиатор (общий, 2× TO-220) | **HS 104-30** (30×102×24.5 мм, Rth 3.1 °C/Вт) | 1 | механический (на плате `02_power_amp`) | **ORDERED** |
| — | Изолятор TO-220 (слюда/силпад) | под TO-220 | 2 | — | **ORDERED** |
| — | Втулка изолирующая 3 мм (под винт M3) | TO-220 | 2 | — | **ORDERED** |
| — | Винты/гайки M3 | крепёж | 2 компл. | — | **STOCK** |
| — | Термопаста | теплоинтерфейс | — | — | **STOCK** |

> Расчёт — `docs/calculations/pa_stage2.md` §5. Po=16 Вт, ηD=55–65 % → Pdiss 8.6–13.1 Вт; покой Idq=0.5 А×2 → 12.5 Вт. Требование — радиатор **≤ ~15 °C/Вт**; **HS 104-30 (Rth 3.1 °C/Вт)** даёт Tj ≈ 96–98 °C (запас до 150 °C ≈ 52–54 °C) — с запасом.
>
> **Решение (2026-10-30):** радиатора на задней крышке корпуса нет — **HS 104-30 монтируется на плате `02_power_amp`** (общий на 2× TO-220), не на корпусе. Изолированный монтаж: изолятор + втулка M3 + термопаста (термопаста — в наличии).

## 2.5 — Отладочные светодиоды (дублирующий LIM + power-good)
> Решение зафиксировано в [`docs/led_debug_scheme.md`](../led_debug_scheme.md). Панельный LIM (`D_lim`) дублируется на плате; добавлен «power-good» на `+12V_PA`.

| Ref | Компонент | Значение/Сигнал | Кол-во | Footprint | Статус |
|-----|---|---|---|---|---|
| D6 | LED (дубль LIM) | LIMIT активен, красный | 1 | `LED_0805_2012Metric_Pad1.15x1.40mm_HandSolder` | **STOCK** |
| D7 | LED (power-good) | `+12V_PA`, зелёный | 1 | то же | **STOCK** |
| R10 | R (D6) | 2.2 кОм | 1 | R_0603_HandSolder | **STOCK** |
| R11 | R (D7) | 3.3 кОм | 1 | R_0603_HandSolder | **STOCK** |

> `D6` + `R10` — платный дубль панельного LIM (`D_lim` через `J_LIM_LED_1`, §2.3). `D7` + `R11` — индикация «`+12V_PA` подан». Оба на одном узле ограничителя/питания, без новых межблочных сигналов.

## Разъёмы (J_*)
| Ref | Тип | Назначение | Footprint | Статус |
|-----|-----|---|---|---|
| J_RF_TX_1 | SMA (розетка, панель/край) | вход `TX_RF` от `03_rx_tx` | `Connector_Coaxial:SMA_*` (s-p215) | **STOCK** |
| J_RF_RX_1 | SMA (розетка) | выход `RX_RF` на `03_rx_tx` | `Connector_Coaxial:SMA_*` (s-p215) | **STOCK** |
| J_ANT_1 | SMA (на плате) → BNC **BJ2** (панель) | антенна: со схемы `J_ANT_1` уходит коаксиалом на гнездо BNC **BJ2** на задней крышке | `Connector_Coaxial:SMA_Amphenol_132289_EdgeMount` (плата); BNC BJ2 — панель ⚠️ | **DEFERRED** (BNC, корпус) |
| J_PA_CTRL_1 | XH2.54 4-pin vertical | PTT, PWR_LIMIT_EN, PWR_LIMIT_SW, GND | `Connector_JST:JST_XH_B4B-XH-A_1x04_P2.50mm_Vertical` | **STOCK** |
| J_I_SENSE_1 | XH2.54 2-pin vertical | I_sense (датчик тока) + GND | `Connector_JST:JST_XH_B2B-XH-A_1x02_P2.50mm_Vertical` | **STOCK** |
| J_SWR_1 | XH2.54 2-pin vertical | SWR_sense (датчик КСВ) + GND | `Connector_JST:JST_XH_B2B-XH-A_1x02_P2.50mm_Vertical` | **STOCK** |
| J_PA_PWR_1 | WJ127R-5.0-02P (2P, 5.0 мм) | +12V_PA, GND | `TerminalBlock_Phoenix:..._MKDS-1,5-2_1x02_P5.00mm_Horizontal` | **ORDERED** |
| J_SW_1 | XH2.54 3-pin vertical | тумблер SW1 (панель): `PWR_LIMIT_SW`/`PLIM_LIM`/`GND` | `Connector_JST:JST_XH_B3B-XH-A_1x03_P2.50mm_Vertical` | **STOCK** |
| J_LIM_LED_1 | XH2.54 2-pin vertical | светодиод LIMIT (панель `D_lim`) | `Connector_JST:JST_XH_B2B-XH-A_1x02_P2.50mm_Vertical` | **STOCK** |

> Пины J_PA_CTRL_1 / J_I_SENSE_1 / J_SWR_1 / J_PA_PWR_1 — строго по контракту `docs/contracts/control_pa.md` (J_PA_CTRL_1: 1=GND, 2=PTT, 3=PWR_LIMIT_EN, 4=PWR_LIMIT_SW; J_I_SENSE_1: 1=I_sense, 2=GND; J_SWR_1: 1=SWR_sense, 2=GND).

## Сводный дефицит
**ИЗМЕНЕНИЯ (2026-10-30, off-board wiring + LIMIT/FULL):**
- Тумблер **KN3(B)-202-A2 (DPDT 6P)** заменён на **ASW-14-102 (SPDT 3P, 20A 12VDC)**.
- ~~+1 × 2N7002 (Q5, аппаратный LIMIT)~~ — отменено: Q5 удалён в варианте C (2026-11-04).
- **R19 = 100 кОм (0603)** — склад.
- Разъёмы: `J_PA_CTRL_1` 6P→4P, `J_SW_1` 6P→3P, добавлены `J_I_SENSE_1`/`J_SWR_1` (2P) — XH2.54 со склада.

**Заказано:**
- **ChipDip (`Stock/ChipDipCart-Stage_2.csv`, доставка 30 окт–10 ноя):** BN-61-202 ×3, T50-6 ×2, T68-2 ×1, реле IM06GR ×1, шунт PA2512 ×1, 120пФ C0G ×10, 220пФ C0G ×5, подстроечник 3296W ×1, 2N7002 ×2, BAT54 ×2, 1N4148WS ×3, LM358 ×2.
- **ДКО электронщик:** RD16HHF1-501 ×2, AO3401 ×1, MMZ2012R601AT000.
- **Тумблер LIMIT/FULL:** ASW-14-102 (ON-ON, SPDT 3P, 20A 12VDC).
- **Теплоотвод:** радиатор HS 104-30 (30×102×24.5 мм, Rth 3.1 °C/Вт) ×1, изоляторы TO-220 ×2, втулки изолирующие 3 мм (под M3) ×2.
- **DEFERRED (не блокирует 2.1–2.3):** BNC (корпус, этап 4).

## Чек-лист приёмки (проверить при получении)
| Позиция | Что проверить |
|---|---|
| **RD16HHF1** | корпус TO-220; подлинность (Mitsubishi) |
| **BN-61-202 / T50-6 / T68-2** | маркировка Fair-Rite/Amidon |
| **Конденсаторы C0G** | маркировка «C0G/NPO» и номинал 100 В (не X7R!) |
| **Реле** | TE IM06GR (2-1462037-3): катушка 12 В (R≈1.03 кОм), DPDT 2А, **gull-wing**, цоколёвка 1–8 по даташиту |
| **Тумблер (SW1)** | **ASW-14-102**: ON-ON, **SPDT 3P** (3 контакта), 20A 12VDC, монтаж на панель |
| **Подстроечник** | Bourns 3296W-1-103LF: 10к, многооборотный, top-adjust, 3 pin 0.1" |
| **BNC** | модель **BJ2** (панельный, с гайкой), Ø9.5 мм |
| **Шунт** | 0.05 Ом 1%, 2 Вт, 2512; PN Yageo PA2512FKE7W0R05E (токовый, low-TCR ±50 ppm/°C) |
| **1N4148WS** | корпус SOD-323F (SMD), маркировка |

## Статус
**✅ БАЗОВЫЙ BOM — СОГЛАСОВАН (обновлён 2026-10-30).** Все позиции заказаны (ChipDip + ДКО + тумблер ASW-14-102 + радиатор HS 104-30 + изоляторы/втулки) или в наличии; TO-ORDER — нет (Q5, D2/D3 удалены в варианте C). Состав/номиналы зафиксированы, footprint'ы/символы — в `docs/kicad_task_stage2.md`. Символы готовы: `trx_custom:RD16HHF1` (✅ цоколёвка проверена), `trx_custom:IM06GR` + `trx_custom:Relay_DPDT_AXICOM_IM06GR_GullWing` (✅). Тумблер SW1 — на панели через разъём `J_SW_1` (XH2.54 3-pin). Контракты `control_pa.md` / `rxtx_pa.md` — **зафиксированы**.
