okunevpy-create/TRX_27MHz/Mechanical/enclosure/exports/assembly.step

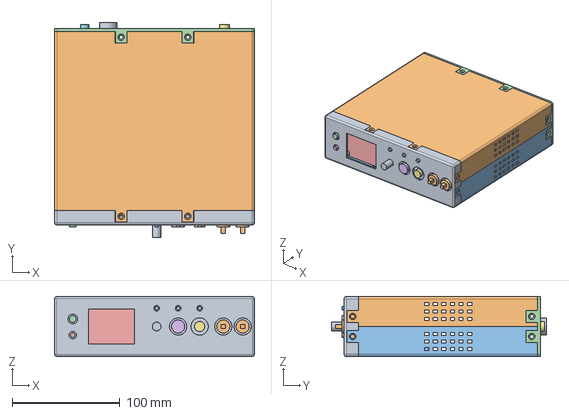
[picture p1: CAD file, 2026-11-05]
Mechanical/enclosure/exports/assembly.step
186.0 x 200.4 x 56.0 mm
