okunevpy-create/TRX_27MHz/Mechanical/enclosure/exports/shell_top.step

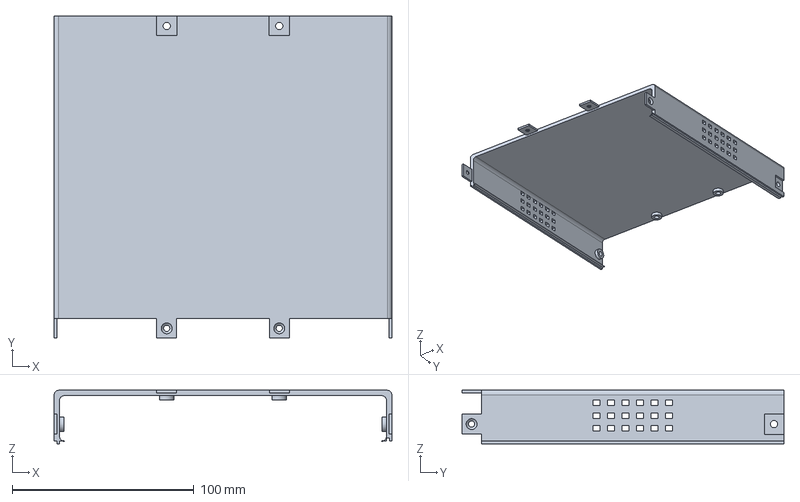
[picture p3: CAD file, 2026-11-05]
Mechanical/enclosure/exports/shell_top.step
186.0 x 177.4 x 29.5 mm
