okunevpy-create/TRX_27MHz/Mechanical/enclosure/exports/back_cover.step

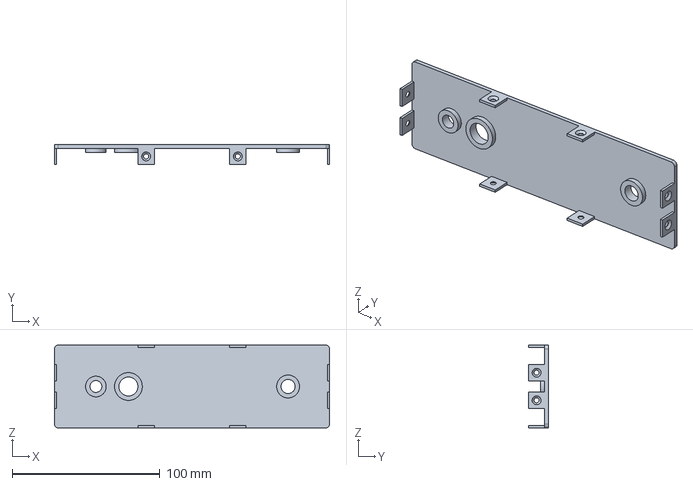
[picture p4: CAD file, 2026-11-05]
Mechanical/enclosure/exports/back_cover.step
186.0 x 13.2 x 56.0 mm
