okunevpy-create/TRX_27MHz/Mechanical/enclosure/exports/front_panel.step

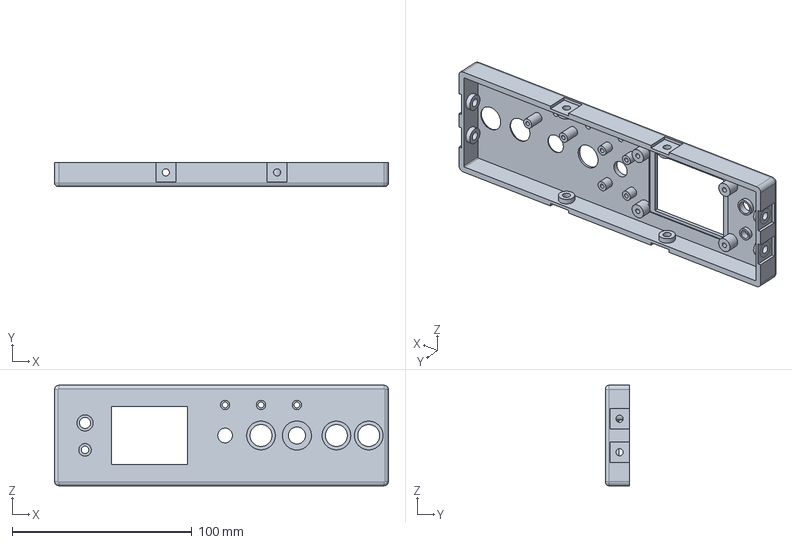
[picture p5: CAD file, 2026-11-03]
Mechanical/enclosure/exports/front_panel.step
186.0 x 13.4 x 56.0 mm
