okunevpy-create/TRX_27MHz/(list of files, cad)

Other CAD files:
Mechanical/enclosure/assembly.FCStd
Mechanical/enclosure/back_cover.FCStd
Mechanical/enclosure/exports/assembly.stl
Mechanical/enclosure/exports/back_cover.stl
Mechanical/enclosure/exports/front_panel.stl
Mechanical/enclosure/exports/shell_bottom.stl
Mechanical/enclosure/exports/shell_top.stl
Mechanical/enclosure/front_panel.FCStd
Mechanical/enclosure/shell_bottom.FCStd
Mechanical/enclosure/shell_top.FCStd
