okunevpy-create/TRX_27MHz/docs/led_debug_scheme.md

# Схема отладочных светодиодов (этапы 1 и 2)

> Решение зафиксировано по запросу: «на схеме должны быть дублирующие диоды и
> вспомогательные диоды. Для отладки. Если диод выводится на переднюю панель —
> просто дублируем его на плате. Подумать, какие вспомогательные диоды нужны,
> напр. после LDO сигнальные, что питание сформировано».

## Принцип

1. **Дублирующие** — для каждого светодиода, вынесенного на переднюю панель,
   на плате ставится его SMD-копия (тот же сигнал, свой токоограничивающий
   резистор). Плату можно отлаживать без корпуса/панели.
2. **Вспомогательные** — сигнальные «power-good» светодиоды на выходах
   преобразователей (DC-DC и LDO), показывающие, что напряжение сформировано.
3. Светодиоды на панели — **3 мм THT (DEFERRED, заказ на этапе 4)**; на плате —
   **0805 SMD**; токоограничивающие резисторы — **0603**, всегда на плате
   (даже для панельных LED — аналог существующего подхода `J_LIM_LED_1`/`R_led`).
4. **Никаких новых GPIO MCU не требуется**: PWR/питание — на шине напрямую,
   TX — с линии `PTT`, LIM — с узла ограничителя УМ.

## Ток и номиналы

Целевой ток ~2–4 мА (отладка, не яркость). Все резисторы 0603 со склада.

| Шина | Vf LED (тип.) | R | I ≈ |
|---|---|---|-----|
| +5V (зелёный) | 2.0 В | 1 кОм | 3.0 мА |
| +3V3 / PTT (зел./красн.) | 2.0 В | 470 Ом | 2.8 мА |
| +12V_PA (зелёный) | 2.0 В | 3.3 кОм | 3.0 мА |
| LIMIT +12В (красный) | 2.0 В | 2.2 кОм | 4.5 мА |

## Этап 1 — `01_control`

### Дублирующие (панель PWR/TX → на плате)

| Ref (плата) | Сигнал | Цвет | R (0603) | Назначение |
|---|---|---|---|---|
| **D4** `D_PWR` | `+5V` | зелёный | R36 = 1 кОм | дубль панельного PWR; одновременно = «+5V сформировано» (DC-DC U1) |
| **D5** `D_TX` | `PTT` | красный | R38 = 470 Ом | дубль панельного TX (передача) |

### Вспомогательные (power-good после LDO)

| Ref (плата) | Шина | LDO | R (0603) |
|---|---|-----|---|
| **D6** `D_3V3` | `+3V3` | U2 (осн. 3.3 В) | R40 = 470 Ом |
| **D7** `D_SI` | `+3V3_SI` | U3 (Si5351) — **до** фильтра R5 | R41 = 470 Ом |
| **D8** `D_DISP` | `+3V3_DISP` | U9 (дисплей) | R42 = 470 Ом |

> `D_SI` вешается на `+3V3_SI` (сырой выход LDO, ДО R5=10 Ом), чтобы не
> нагружать фильтрованный `+3V3_SI_F`, питающий Si5351.

### Разъём панельных светодиодов `J_LED_1`

XH2.54 **3-pin** (набор XH 2P–12P, STOCK). Токоограничивающие резисторы — на плате.

| Пин | Сигнал | Куда (панель) |
|-----|---|---|
| 1 | `PWR_LED` (через R37=1 кОм от `+5V`) | анод панельного LED PWR |
| 2 | `TX_LED` (через R39=470 Ом от `PTT`) | анод панельного LED TX |
| 3 | `GND` | общий катод обоих панельных LED |

> Панельный **LIM** идёт с платы `02_power_amp` через существующий `J_LIM_LED_1`
> (2-pin), не через `J_LED_1`.

### Сводка новых компонентов этапа 1

| Ref | Компонент | Значение | Footprint | Статус |
|-----|---|---|---|---|
| D4–D8 | LED SMD | зел.×4, красн.×1 | `LED_SMD:LED_0805_2012Metric_Pad1.15x1.40mm_HandSolder` | **STOCK** |
| R36 | R (D_PWR) | 1 кОм | R_0603...HandSolder | STOCK |
| R37 | R (панель PWR) | 1 кОм | R_0603...HandSolder | STOCK |
| R38 | R (D_TX) | 470 Ом | R_0603...HandSolder | STOCK |
| R39 | R (панель TX) | 470 Ом | R_0603...HandSolder | STOCK |
| R40 | R (D_3V3) | 470 Ом | R_0603...HandSolder | STOCK |
| R41 | R (D_SI) | 470 Ом | R_0603...HandSolder | STOCK |
| R42 | R (D_DISP) | 470 Ом | R_0603...HandSolder | STOCK |
| J_LED_1 | Разъём 3-pin | XH2.54 | `Connector_JST:JST_XH_B3B-XH-A_1x03_P2.50mm_Vertical` | STOCK |

## Этап 2 — `02_power_amp`

### Дублирующий LIM + power-good +12V_PA

| Ref | Сигнал | Цвет | R (0603) | Назначение |
|-----|---|---|---|---|
| **D_lim_b** `D_LIM_B` | LIMIT активен (узел ограничителя) | красный | R_led_b = 2.2 кОм | дубль панельного LIM (панельный — `D_lim` через `J_LIM_LED_1`) |
| **D_pa_pwr** `D_12V_PA` | `+12V_PA` | зелёный | R_pa_pwr = 3.3 кОм | power-good: питание УМ подано |

> Панельный LIM (`D_lim`, 3 мм, DEFERRED) и `R_led` (2.2 кОм) уже зафиксированы
> в BOM этапа 2 (§2.3). Здесь добавляется **только** платный дубль `D_lim_b` +
> `R_led_b` и power-good `D_pa_pwr` + `R_pa_pwr`.

### Сводка новых компонентов этапа 2

| Ref | Компонент | Значение | Footprint | Статус |
|-----|---|---|---|---|
| D_lim_b | LED SMD красн. | — | `LED_0805_2012Metric...HandSolder` | **STOCK** |
| D_pa_pwr | LED SMD зел. | — | `LED_0805_2012Metric...HandSolder` | **STOCK** |
| R_led_b | R | 2.2 кОм | R_0603...HandSolder | STOCK |
| R_pa_pwr | R | 3.3 кОм | R_0603...HandSolder | STOCK |

## Рассмотренные, но НЕ включённые (кандидаты)

| Кандидат | Решение | Причина |
|---|---|---|
| `+12V_IN` (до/после защиты) | ❌ | дублируется «+5V сформировано» (D4): если +5V есть — вход 12 В исправен |
| `+5V_SI` | ❌ | покрывается `+3V3_SI` (D7): LDO U3 на выходе |
| `IQ_EN` / `MUTE` / `PWR_LIMIT_EN` (активность) | ❌ | режимные, а не power-good; при необходимости — позже, без респина (рядом с MCU) |
| `TX_RF` (ВЧ присутствие) | ❌ | требует ВЧ-детектора, не простого LED; вне scope отладочных диодов |

## Статус

**Все светодиоды (0805 SMD, D4–D8 + D_lim_b + D_pa_pwr) — STOCK (в наличии у пользователя).** Резисторы 0603 — склад. Панельные 3 мм LED (PWR/TX/LIM) — DEFERRED (корпус, этап 4).

Решение зафиксировано. Схемотехника этапа 1 вносится в KiCad через MCP
(подэтап 1.5, доп.). Этап 2 — вносится в `docs/kicad_task_stage2.md`
(схема `02_power_amp` ещё не разведена, подэтапы 2.1–2.3).
