okunevpy-create/TRX_27MHz/KiCad/03_rx_tx/03_rx_tx.kicad_pcb

## KiCad design KiCad/03_rx_tx/03_rx_tx.kicad_pcb (2026-11-05)

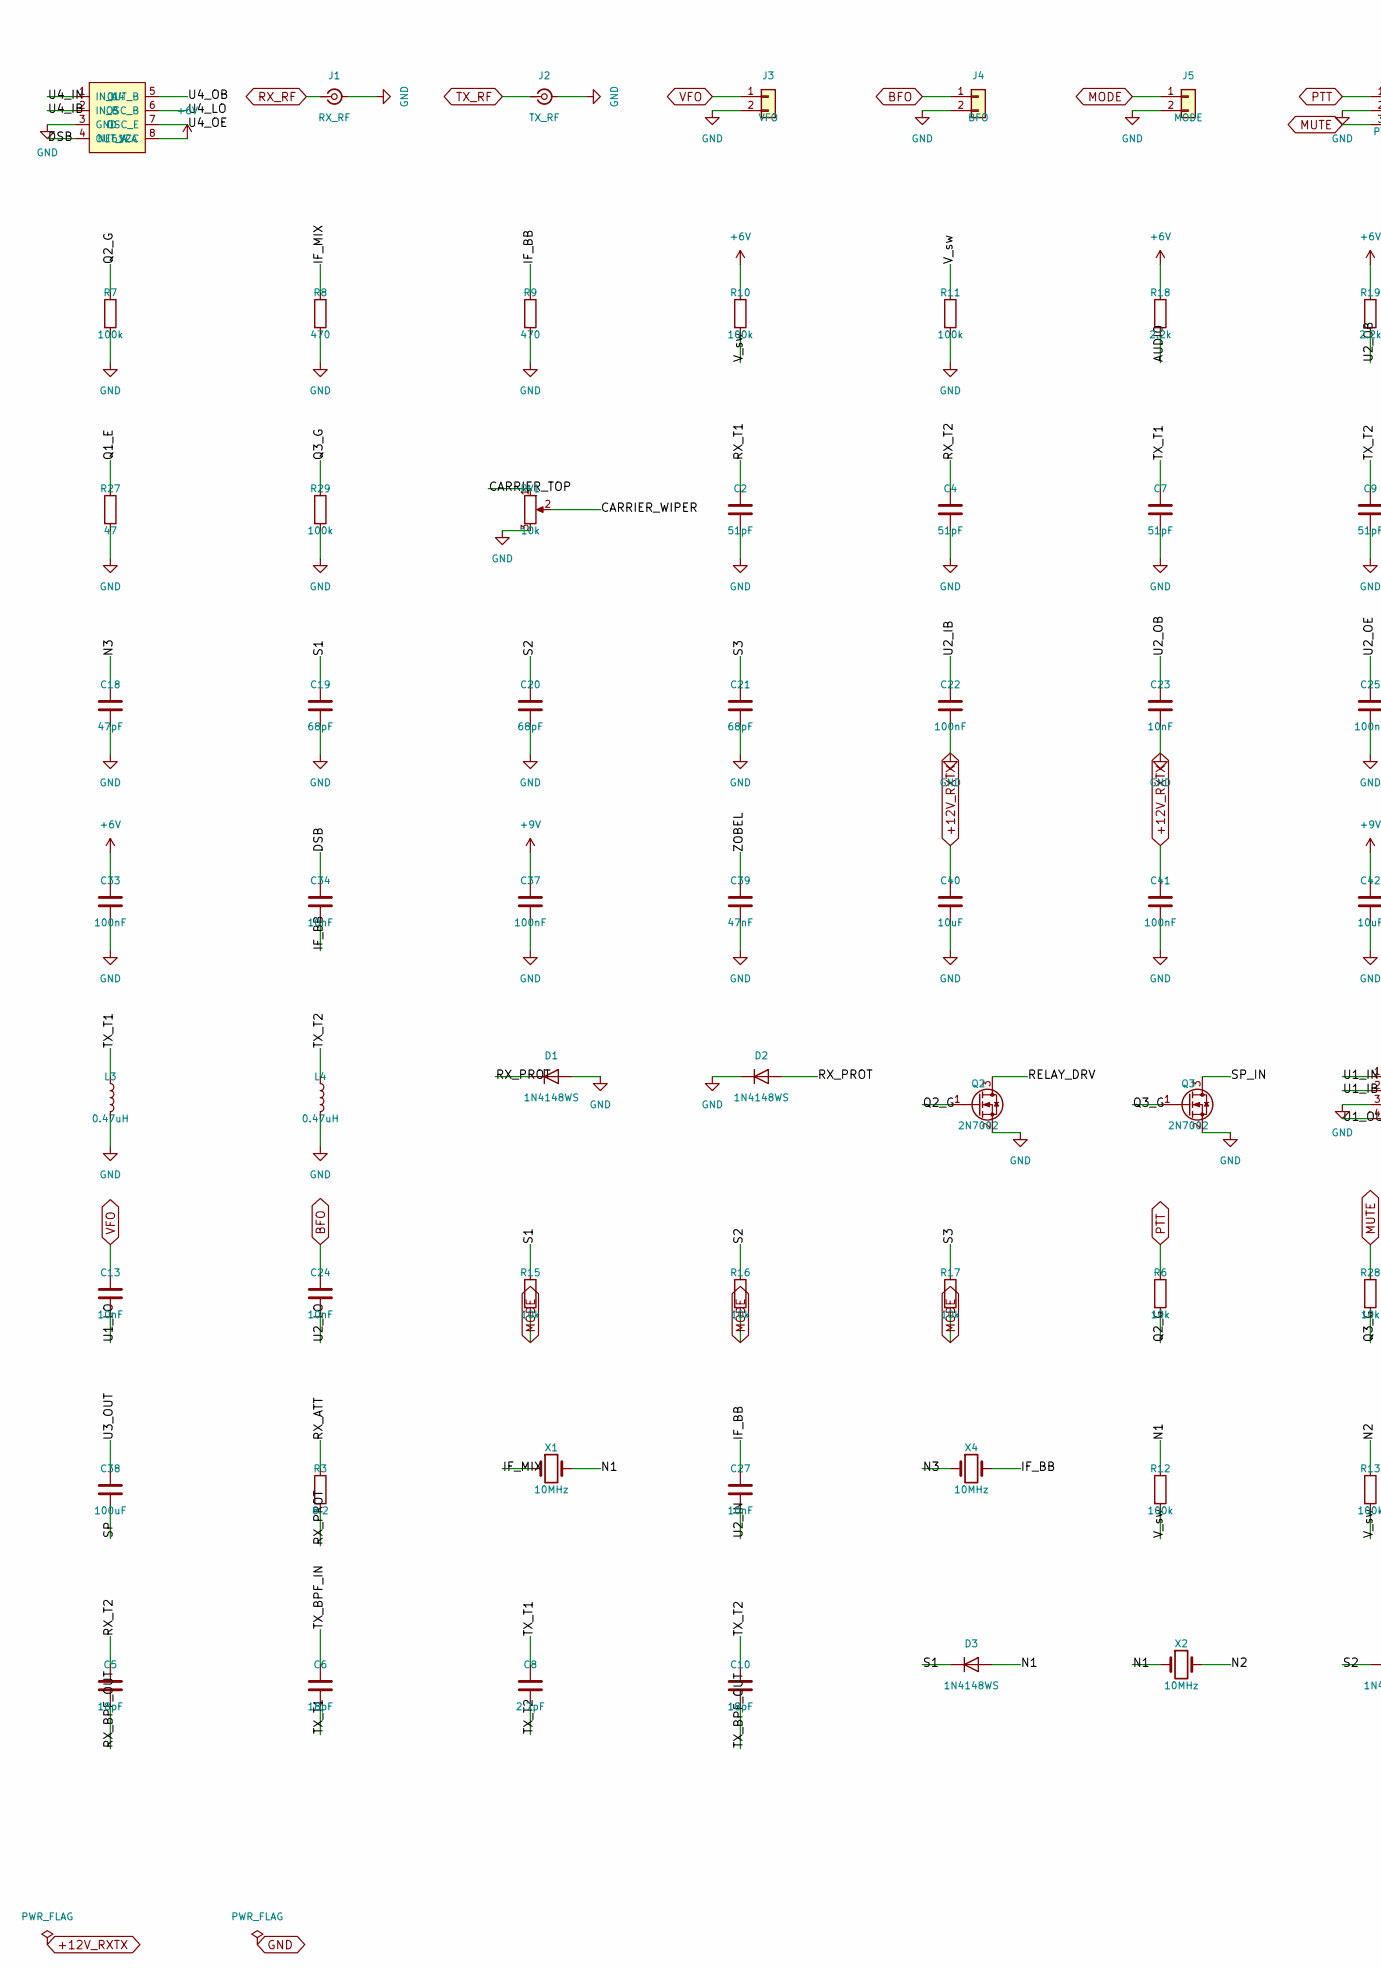
[picture p6: schematic 03_rx_tx.kicad_sch, part in row 1, column 1]

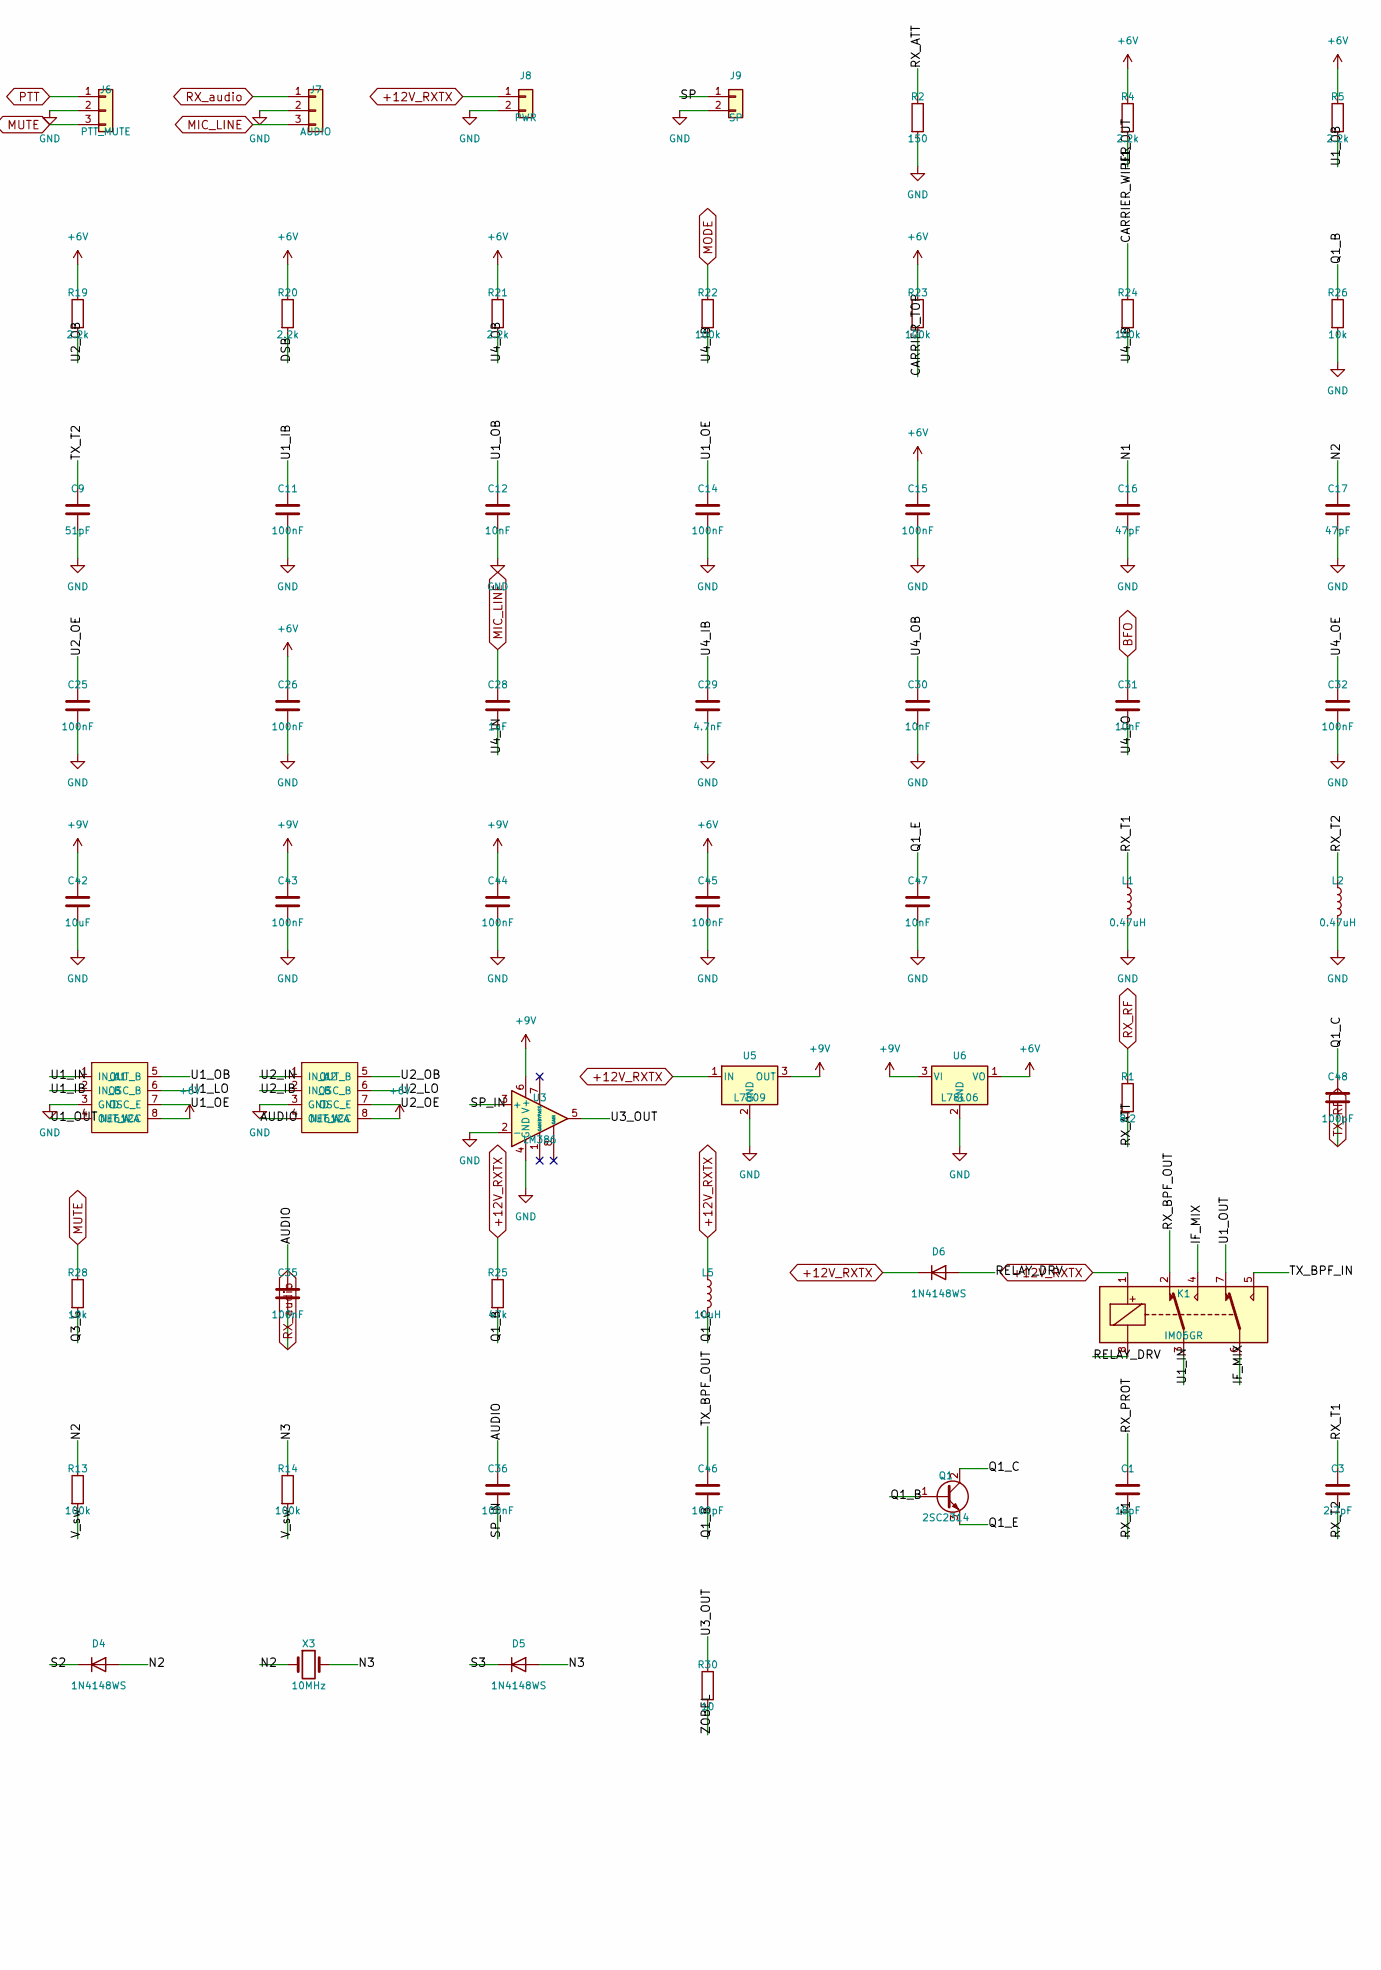
[picture p7: schematic 03_rx_tx.kicad_sch, part in row 1, column 2]

Parts:
C1, C5, C6, C10: 18pF; C_0805_2012Metric_Pad1.18x1.45mm_HandSolder
C2, C4, C7, C9: 51pF; C_0805_2012Metric_Pad1.18x1.45mm_HandSolder
C3, C8: 2.7pF; C_0805_2012Metric_Pad1.18x1.45mm_HandSolder
C11, C14, C15, C22, C25, C26, C32, C33, C35, C36, C37, C41, C43, C44, C45: 100nF; C_0603_1608Metric_Pad1.08x0.95mm_HandSolder
C12, C13, C23, C24, C27, C30, C31, C34, C47: 10nF; C_0603_1608Metric_Pad1.08x0.95mm_HandSolder
C16, C17, C18: 47pF; C_0603_1608Metric_Pad1.08x0.95mm_HandSolder
C19, C20, C21: 68pF; C_0603_1608Metric_Pad1.08x0.95mm_HandSolder
C28: 1uF; C_0603_1608Metric_Pad1.08x0.95mm_HandSolder
C29: 4.7nF; C_0603_1608Metric_Pad1.08x0.95mm_HandSolder
C38: 100uF; CP_Elec_6.3x5.3
C39: 47nF; C_0603_1608Metric_Pad1.08x0.95mm_HandSolder
C40, C42: 10uF; CP_Elec_6.3x5.3
C46, C48: 100pF; C_0603_1608Metric_Pad1.08x0.95mm_HandSolder
D1, D2, D3, D4, D5, D6: 1N4148WS; D_SOD-323F
J1: RX_RF; SMA_S-P215
J2: TX_RF; SMA_S-P215
J3: VFO; SMA_S-P215
J4: BFO; SMA_S-P215
J5: MODE; JST_XH_B2B-XH-A_1x02_P2.50mm_Vertical
J6: PTT_MUTE; JST_XH_B3B-XH-A_1x03_P2.50mm_Vertical
J7: AUDIO; JST_XH_B3B-XH-A_1x03_P2.50mm_Vertical
J8: PWR; TerminalBlock_Phoenix_MKDS-1,5-2_1x02_P5.00mm_Horizontal
J9: SP; JST_XH_B2B-XH-A_1x02_P2.50mm_Vertical
K1: IM06GR; Relay_DPDT_AXICOM_IM06GR_GullWing
L1, L2, L3, L4: 0.47uH; L_0805_2012Metric_Pad1.05x1.20mm_HandSolder
L5: 10uH; L_0805_2012Metric_Pad1.05x1.20mm_HandSolder
Q1: 2SC2314; TO-92L_HandSolder
Q2, Q3: 2N7002; SOT-23_Handsoldering
R1, R3: 8.2; R_0603_1608Metric_Pad0.98x0.95mm_HandSolder
R2: 150; R_0603_1608Metric_Pad0.98x0.95mm_HandSolder
R4, R5, R18, R19, R20, R21: 2.2k; R_0603_1608Metric_Pad0.98x0.95mm_HandSolder
R6, R15, R16, R17, R26, R28: 10k; R_0603_1608Metric_Pad0.98x0.95mm_HandSolder
R7, R10, R11, R12, R13, R14, R22, R23, R24, R29: 100k; R_0603_1608Metric_Pad0.98x0.95mm_HandSolder
R8, R9: 470; R_0603_1608Metric_Pad0.98x0.95mm_HandSolder
R25: 47k; R_0603_1608Metric_Pad0.98x0.95mm_HandSolder
R27: 47; R_0603_1608Metric_Pad0.98x0.95mm_HandSolder
R30: 10; R_0603_1608Metric_Pad0.98x0.95mm_HandSolder
RV1: 10k; Potentiometer_Bourns_3214W_Vertical
U1, U2, U4: NE612A; SOIC-8_3.9x4.9mm_P1.27mm
U3: LM386; SOIC-8_3.9x4.9mm_P1.27mm
U5: L7809; TO-220-3_Vertical
U6: L78L06; TO-92_Inline
X1, X2, X3, X4: 10MHz; Crystal_SMD_HC49-SD_HandSoldering

Connections:
+6V: C15.1, C26.1, C33.1, C45.1, R4.1, R5.1, R10.1, R18.1, R19.1, R20.1, R21.1, R23.1, U1.8 (VCC), U2.8 (VCC), U4.8 (VCC), U6.1 (VO)
+9V: C37.1, C42.1, C43.1, C44.1, U3.6 (V+), U5.3 (OUT), U6.3 (VI)
+12V_RXTX: C40.1, C41.1, D6.1 (K), J8.1, K1.1, L5.1, R25.1, U5.1 (IN)
/AUDIO: C35.1, C36.1, R18.2, U2.4 (OUT_A)
/CARRIER_TOP: R23.2, RV1.1
/CARRIER_WIPER: R24.1, RV1.2
/DSB: C34.1, R20.2, U4.4 (OUT_A)
/IF_BB: C27.1, C34.2, R9.1, X4.2
/IF_MIX: K1.4, K1.6, R8.1, X1.1
/N1: C16.1, D3.2 (A), R12.1, X1.2, X2.1
/N2: C17.1, D4.2 (A), R13.1, X2.2, X3.1
/N3: C18.1, D5.2 (A), R14.1, X3.2, X4.1
/Q1_B: C46.2, Q1.1 (B), R25.2, R26.1
/Q1_C: C48.1, L5.2, Q1.2 (C)
/Q1_E: C47.1, Q1.3 (E), R27.1
/Q2_G: Q2.1 (G), R6.2, R7.1
/Q3_G: Q3.1 (G), R28.2, R29.1
/RELAY_DRV: D6.2 (A), K1.8, Q2.3 (D)
/RX_ATT: R1.2, R2.1, R3.1
/RX_BPF_OUT: C5.2, K1.2
/RX_PROT: C1.1, D1.1 (K), D2.2 (A), R3.2
/RX_T1: C1.2, C2.1, C3.1, L1.1
/RX_T2: C3.2, C4.1, C5.1, L2.1
/S1: C19.1, D3.1 (K), R15.1
/S2: C20.1, D4.1 (K), R16.1
/S3: C21.1, D5.1 (K), R17.1
/SP: C38.2, J9.1
/SP_IN: C36.2, Q3.3 (D), U3.3 (+)
/TX_BPF_IN: C6.1, K1.5
/TX_BPF_OUT: C10.2, C46.1
/TX_T1: C6.2, C7.1, C8.1, L3.1
/TX_T2: C8.2, C9.1, C10.1, L4.1
/U1_IB: C11.1, U1.2 (IN_B)
/U1_IN: K1.3, U1.1 (IN_A)
/U1_LO: C13.2, U1.6 (OSC_B)
/U1_OB: C12.1, R5.2, U1.5 (OUT_B)
/U1_OE: C14.1, U1.7 (OSC_E)
/U1_OUT: K1.7, R4.2, U1.4 (OUT_A)
/U2_IB: C22.1, U2.2 (IN_B)
/U2_IN: C27.2, U2.1 (IN_A)
/U2_LO: C24.2, U2.6 (OSC_B)
/U2_OB: C23.1, R19.2, U2.5 (OUT_B)
/U2_OE: C25.1, U2.7 (OSC_E)
/U3_OUT: C38.1, R30.1, U3.5
/U4_IB: C29.1, R22.2, R24.2, U4.2 (IN_B)
/U4_IN: C28.2, U4.1 (IN_A)
/U4_LO: C31.2, U4.6 (OSC_B)
/U4_OB: C30.1, R21.2, U4.5 (OUT_B)
/U4_OE: C32.1, U4.7 (OSC_E)
/V_sw: R10.2, R11.1, R12.2, R13.2, R14.2
/ZOBEL: C39.1, R30.2
BFO: C24.1, C31.1, J4.1
GND: C2.2, C4.2, C7.2, C9.2, C11.2, C12.2, C14.2, C15.2, C16.2, C17.2, C18.2, C19.2, C20.2, C21.2, C22.2, C23.2, C25.2, C26.2, C29.2, C30.2, C32.2, C33.2, C37.2, C39.2, C40.2, C41.2, C42.2, C43.2, C44.2, C45.2, C47.2, D1.2 (A), D2.1 (K), J1.2 (Ext), J2.2 (Ext), J3.2, J4.2, J5.2, J6.2, J7.2, J8.2, J9.2, L1.2, L2.2, L3.2, L4.2, Q2.2 (S), Q3.2 (S), R2.2, R7.2, R8.2, R9.2, R11.2, R26.2, R27.2, R29.2, RV1.3, U1.3 (GND), U2.3 (GND), U3.2 (-), U3.4 (GND), U4.3 (GND), U5.2 (GND), U6.2 (GND)
MIC_LINE: C28.1, J7.3
MODE: J5.1, R15.2, R16.2, R17.2, R22.1
MUTE: J6.3, R28.1
PTT: J6.1, R6.1
RX_RF: J1.1 (In), R1.1
RX_audio: C35.2, J7.1
TX_RF: C48.2, J2.1 (In)
VFO: C13.1, J3.1

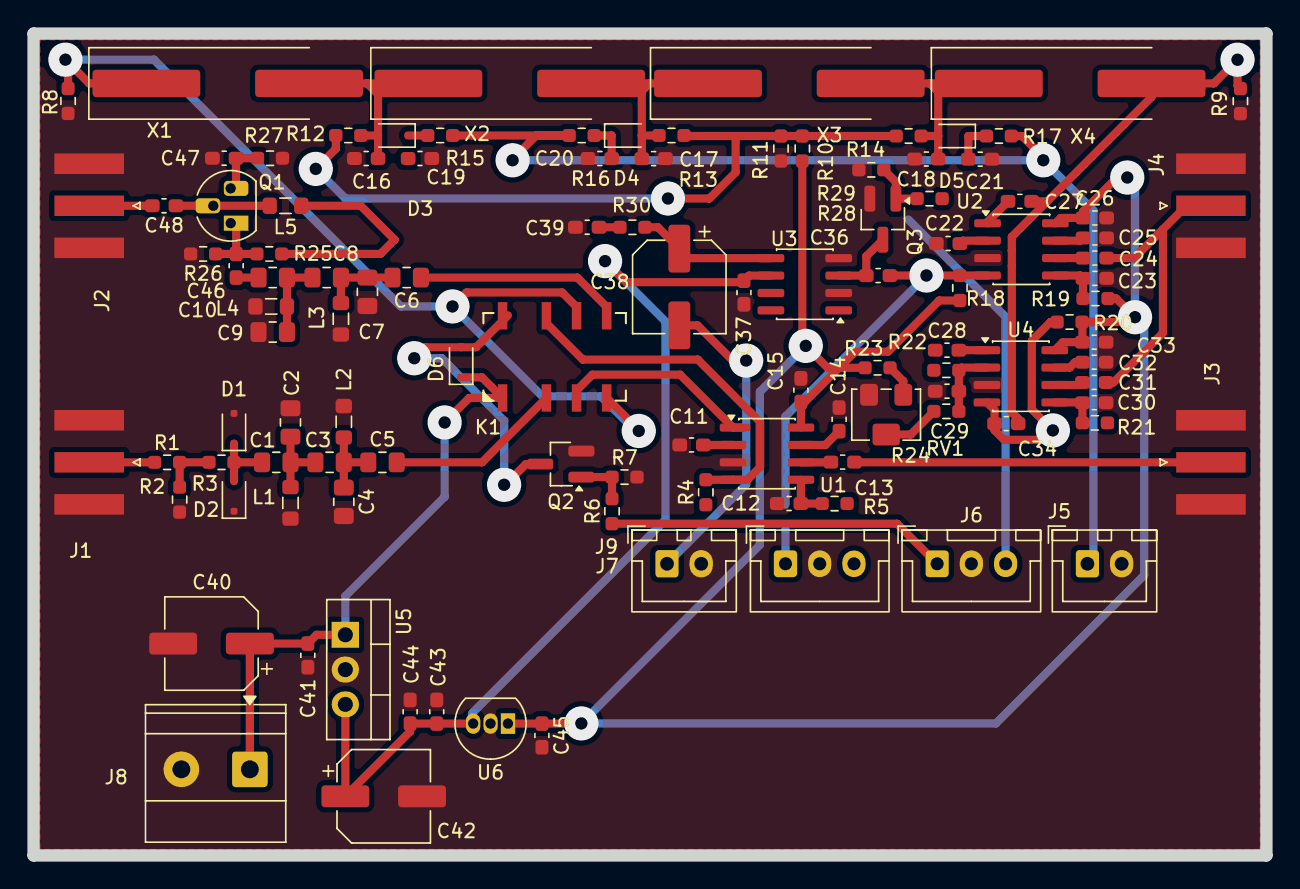
[picture p8: board 03_rx_tx.kicad_pcb from above]

Board: 2 copper layers, 90.0 x 60.0 mm, 113 parts (1 on the bottom side), 61 nets.
