okunevpy-create/TRX_27MHz/KiCad/02_power_amp/02_power_amp.kicad_pcb

## KiCad design KiCad/02_power_amp/02_power_amp.kicad_pcb (2026-11-05)

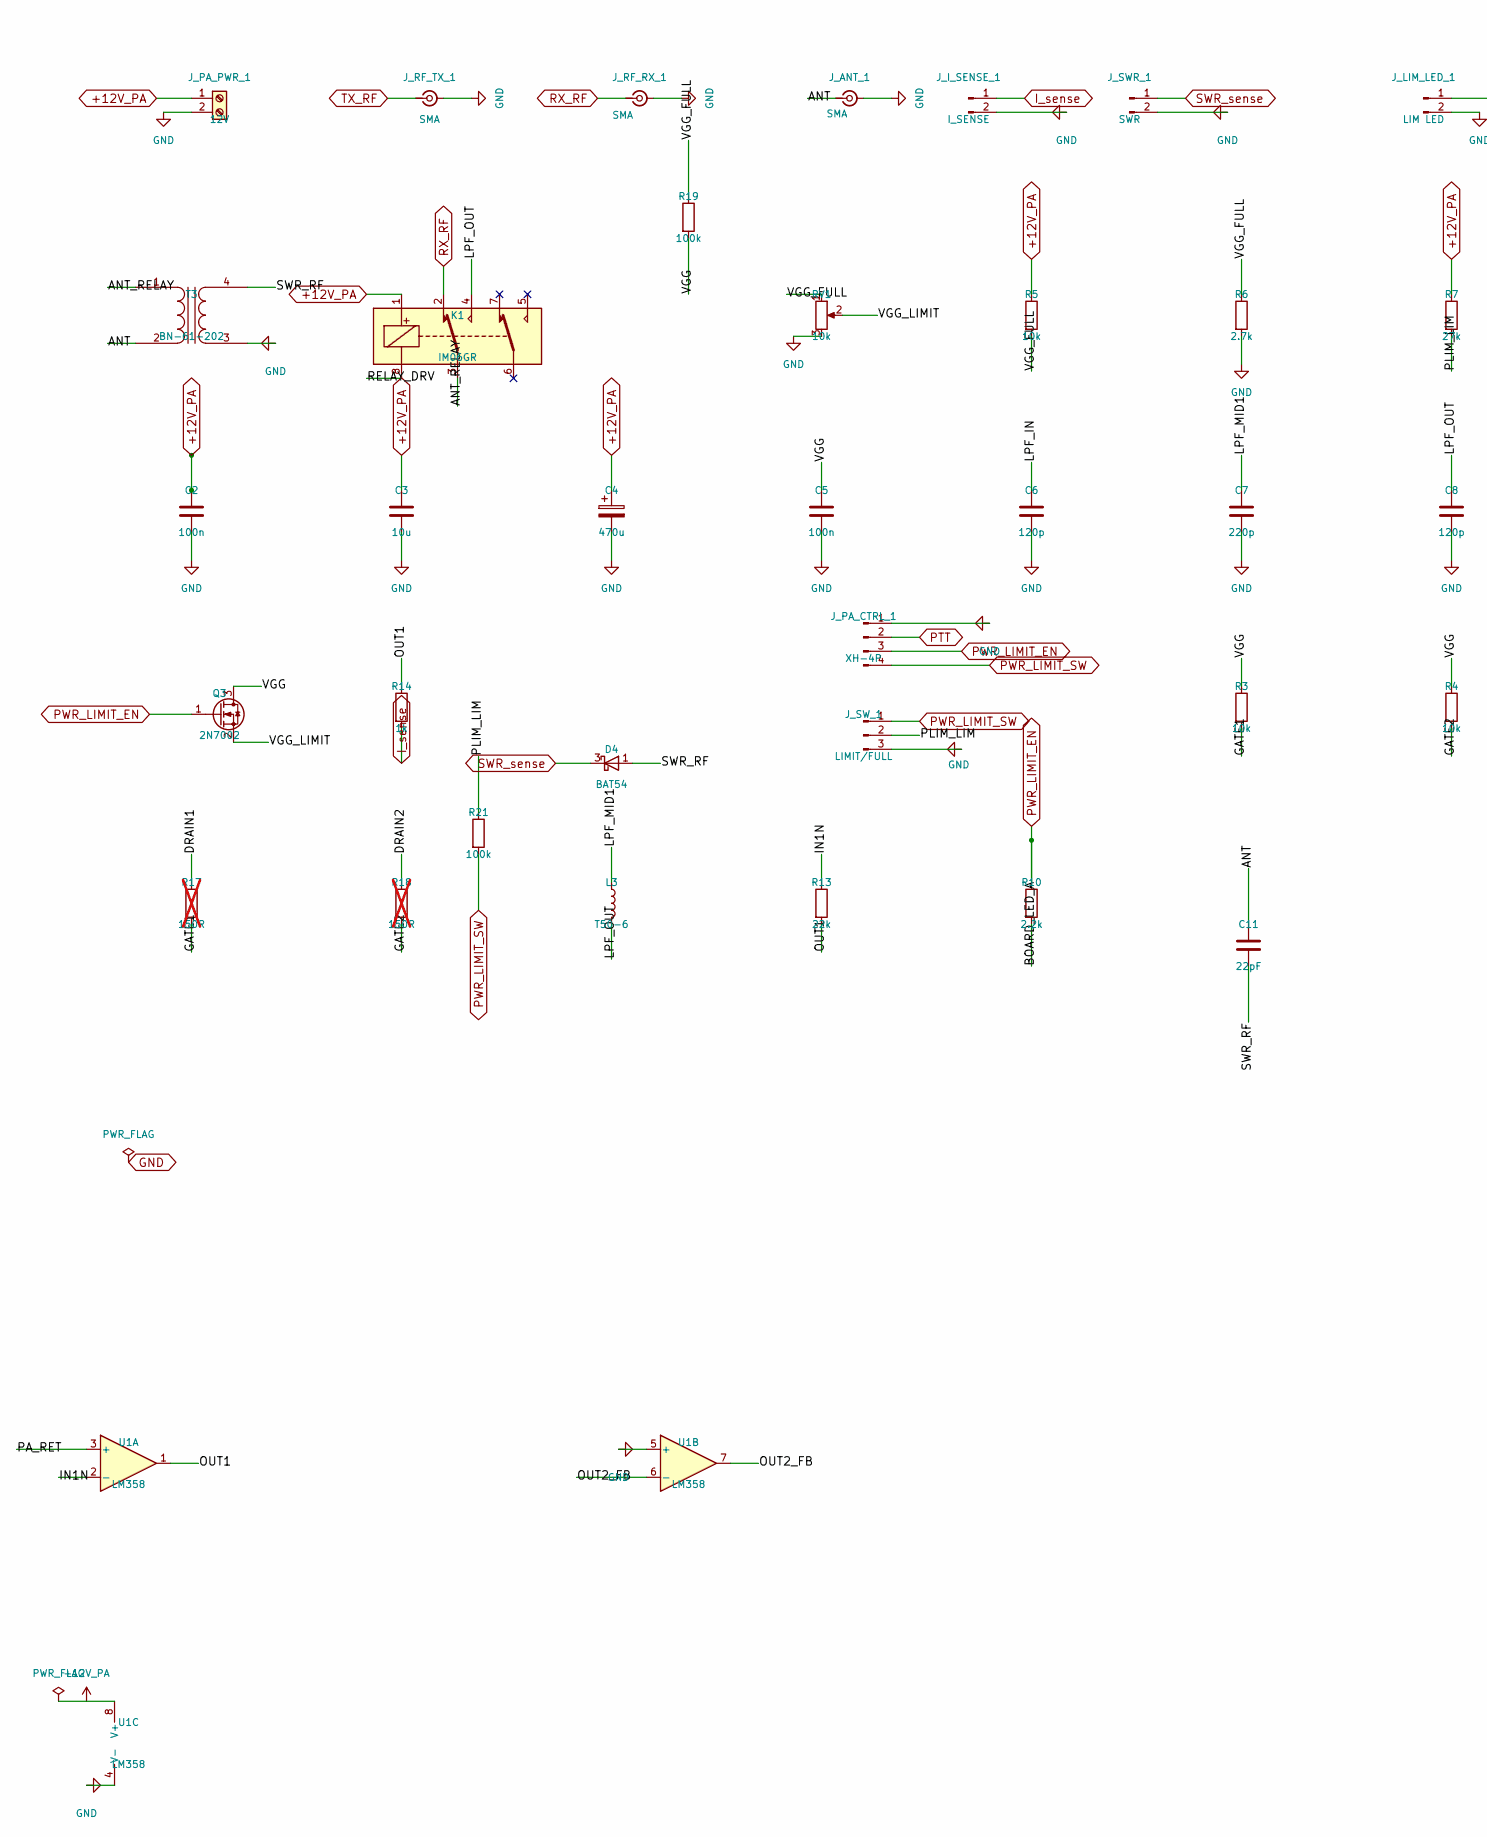
[picture p9: schematic 02_power_amp.kicad_sch, part in row 1, column 1]

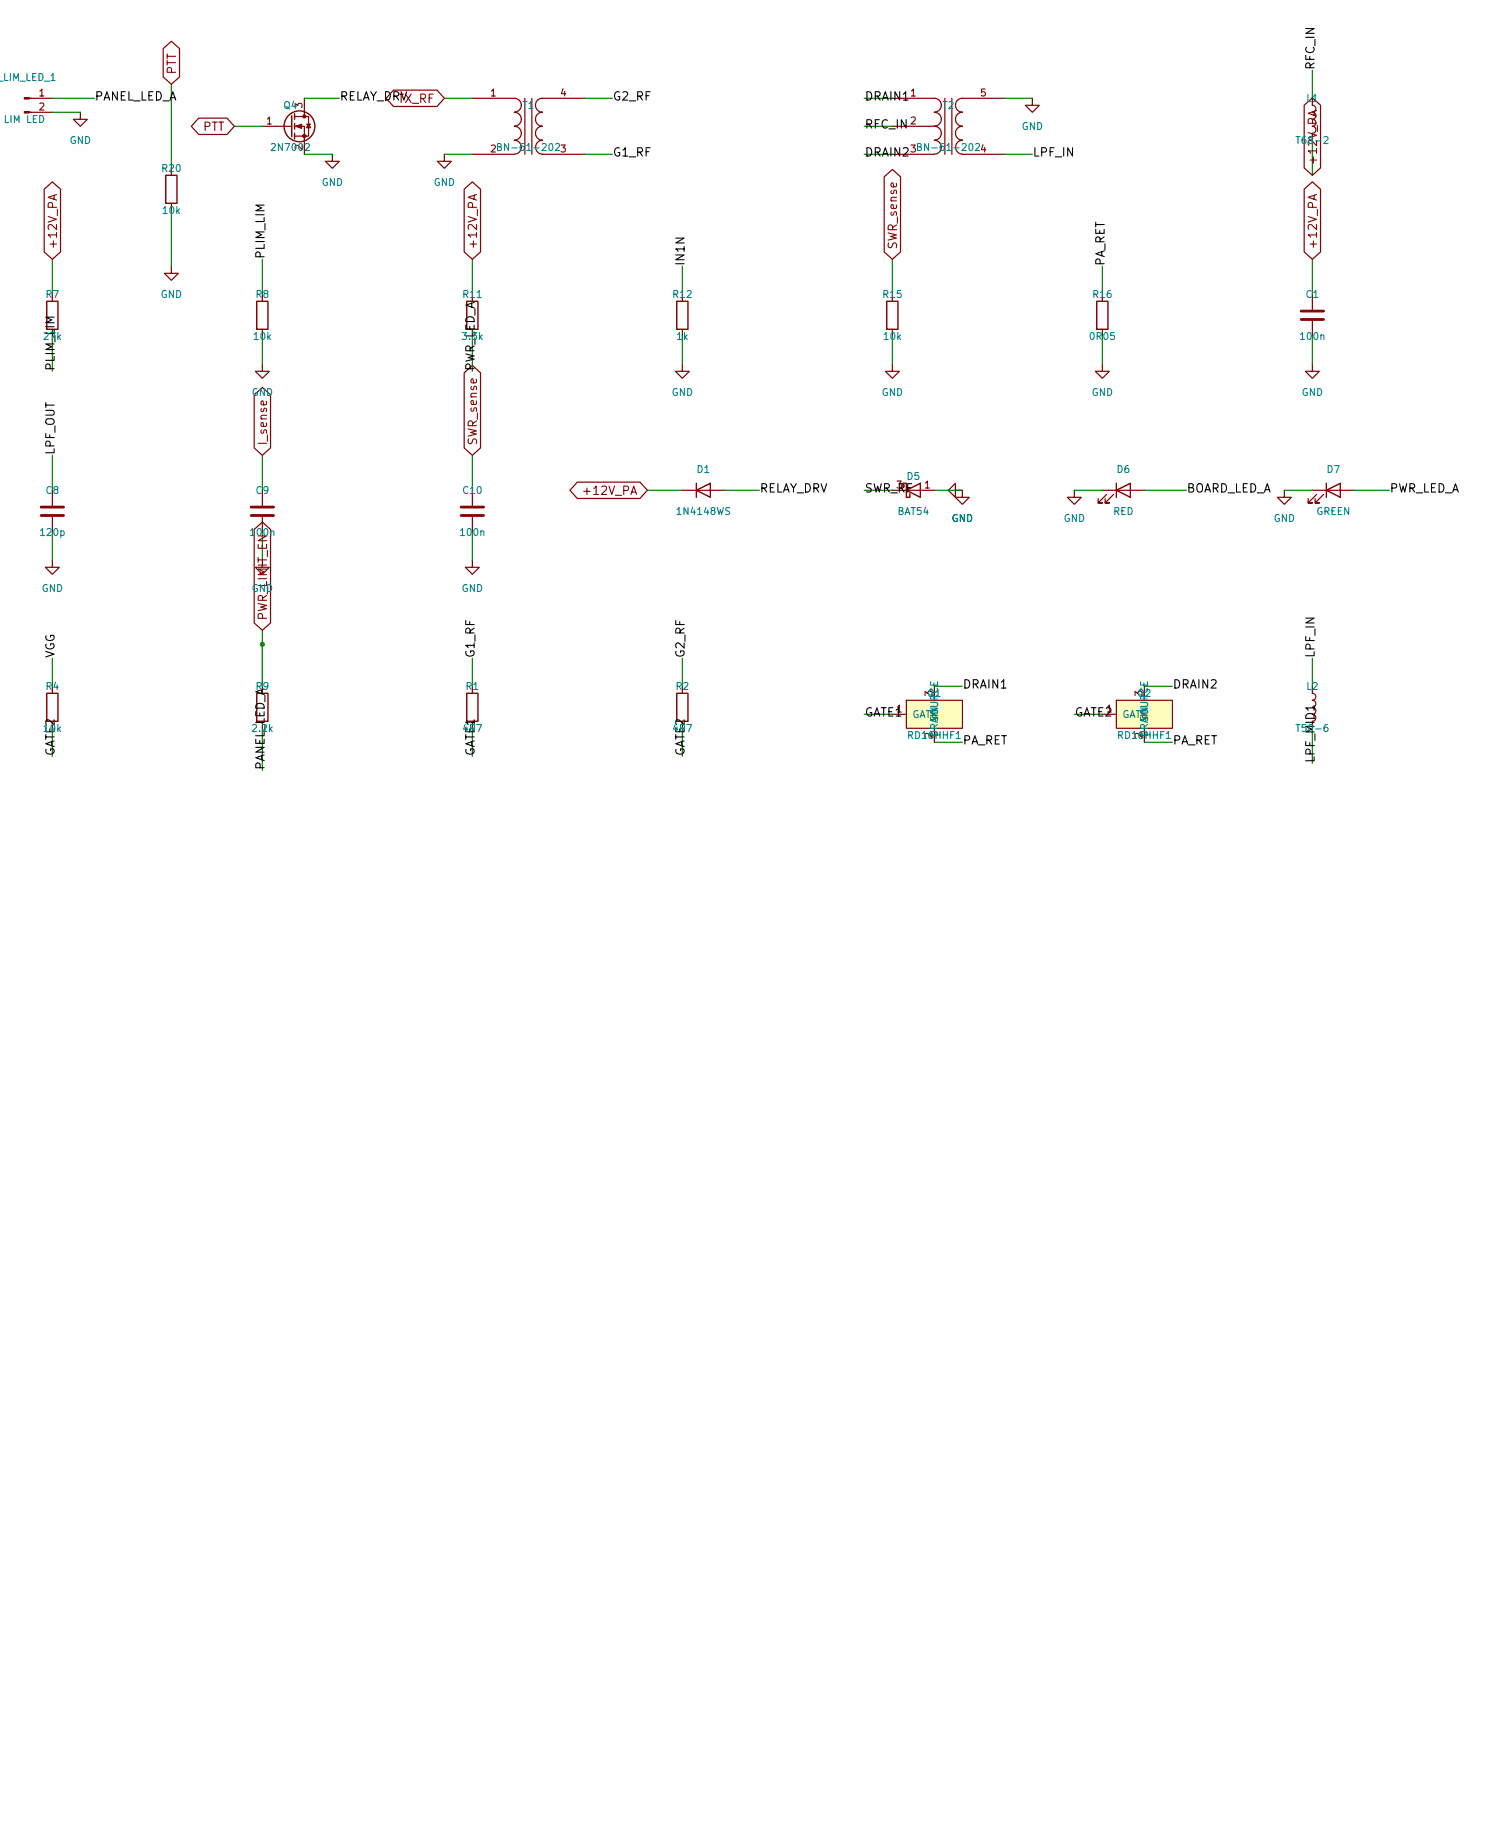
[picture p10: schematic 02_power_amp.kicad_sch, part in row 1, column 2]

Parts:
C1, C2, C5, C9, C10: 100n; C_0603_1608Metric_Pad1.08x0.95mm_HandSolder
C3: 10u; C_0805_2012Metric_Pad1.18x1.45mm_HandSolder
C4: 470u; CP_Elec_10x10.5
C6, C8: 120p; C_0805_2012Metric_Pad1.18x1.45mm_HandSolder
C7: 220p; C_0805_2012Metric_Pad1.18x1.45mm_HandSolder
C11: 22pF; C_0805_2012Metric_Pad1.18x1.45mm_HandSolder
D1: 1N4148WS; D_SOD-323F
D4, D5: BAT54; SOT-23-3
D6: RED; LED_0805_2012Metric_Pad1.15x1.40mm_HandSolder
D7: GREEN; LED_0805_2012Metric_Pad1.15x1.40mm_HandSolder
J_ANT_1: SMA; SMA_S-P215
J_I_SENSE_1: I_SENSE; JST_XH_B2B-XH-A_1x02_P2.50mm_Vertical
J_LIM_LED_1: LIM LED; JST_XH_B2B-XH-A_1x02_P2.50mm_Vertical
J_PA_CTRL_1: XH-4P; JST_XH_B4B-XH-A_1x04_P2.50mm_Vertical
J_PA_PWR_1: 12V; TerminalBlock_Phoenix_MKDS-1,5-2_1x02_P5.00mm_Horizontal
J_RF_RX_1: SMA; SMA_S-P215
J_RF_TX_1: SMA; SMA_S-P215
J_SWR_1: SWR; JST_XH_B2B-XH-A_1x02_P2.50mm_Vertical
J_SW_1: LIMIT/FULL; JST_XH_B3B-XH-A_1x03_P2.50mm_Vertical
K1: IM06GR; Relay_DPDT_AXICOM_IM06GR_GullWing
L1: T68-2; L_Toroid_Vertical_L17.8mm_W8.1mm_P7.62mm_Bourns_5700
L2, L3: T50-6; L_Toroid_Vertical_L13.0mm_W6.5mm_P5.60mm
Q1, Q2: RD16HHF1; TO-220-3_Vertical
Q3, Q4: 2N7002; SOT-23_Handsoldering
R1, R2: 4R7; R_0603_1608Metric_Pad0.98x0.95mm_HandSolder
R3, R4, R5, R8, R15, R20: 10k; R_0603_1608Metric_Pad0.98x0.95mm_HandSolder
R6: 2.7k; R_0603_1608Metric_Pad0.98x0.95mm_HandSolder
R7: 27k; R_0603_1608Metric_Pad0.98x0.95mm_HandSolder
R9, R10: 2.2k; R_0603_1608Metric_Pad0.98x0.95mm_HandSolder
R11: 3.3k; R_0603_1608Metric_Pad0.98x0.95mm_HandSolder
R12, R14: 1k; R_0603_1608Metric_Pad0.98x0.95mm_HandSolder
R13: 22k; R_0603_1608Metric_Pad0.98x0.95mm_HandSolder
R16: 0R05; R_2512_6332Metric
R17, R18: 150R; R_0603_1608Metric_Pad0.98x0.95mm_HandSolder; not fitted
R19, R21: 100k; R_0603_1608Metric_Pad0.98x0.95mm_HandSolder
RV1: 10k; Potentiometer_Bourns_3296W_Vertical
T1, T3: BN-61-202; PinHeader_1x04_P2.54mm_Vertical
T2: BN-61-202; PinHeader_1x05_P2.54mm_Vertical
U1: LM358; SOIC-8_3.9x4.9mm_P1.27mm

Connections:
+12V_PA: C1.1, C2.1, C3.1, C4.1, D1.1 (K), J_PA_PWR_1.1, K1.1, L1.2, R5.1, R7.1, R11.1, U1.8 (V+)
/ANT: C11.1, J_ANT_1.1 (In), T3.2 (AB)
/ANT_RELAY: K1.3, T3.1 (AA)
/BOARD_LED_A: D6.2 (A), R10.2
/DRAIN1: Q1.3 (DRAIN), R17.1, T2.1 (PR1)
/DRAIN2: Q2.3 (DRAIN), R18.1, T2.3 (PR2)
/G1_RF: R1.1, T1.3 (SA)
/G2_RF: R2.1, T1.4 (SB)
/GATE1: Q1.1 (GATE), R1.2, R3.2, R17.2
/GATE2: Q2.1 (GATE), R2.2, R4.2, R18.2
/IN1N: R12.1, R13.1, U1.2 (-)
/LPF_IN: C6.1, L2.1, T2.4 (S1)
/LPF_MID1: C7.1, L2.2, L3.1
/LPF_OUT: C8.1, K1.4, L3.2
/OUT1: R13.2, R14.1, U1.1
/OUT2_FB: U1.6 (-), U1.7
/PANEL_LED_A: J_LIM_LED_1.1, R9.2
/PA_RET: Q1.2 (SOURCE), Q2.2 (SOURCE), R16.1, U1.3 (+)
/PLIM_LIM: J_SW_1.2, R7.2, R8.1, R21.1
/PWR_LED_A: D7.2 (A), R11.2
/RELAY_DRV: D1.2 (A), K1.8, Q4.3 (D)
/RFC_IN: L1.1, T2.2 (PM)
/SWR_RF: C11.2, D4.1 (A), D5.3 (K), T3.4 (SB)
/VGG: C5.1, Q3.3 (D), R3.1, R4.1, R19.2
/VGG_FULL: R5.2, R6.1, R19.1, RV1.1
/VGG_LIMIT: Q3.2 (S), RV1.2
GND: C1.2, C2.2, C3.2, C4.2, C5.2, C6.2, C7.2, C8.2, C9.2, C10.2, D5.1 (A), D6.1 (K), D7.1 (K), J_ANT_1.2 (Ext), J_I_SENSE_1.2, J_LIM_LED_1.2, J_PA_CTRL_1.1, J_PA_PWR_1.2, J_RF_RX_1.2 (Ext), J_RF_TX_1.2 (Ext), J_SWR_1.2, J_SW_1.3, Q4.2 (S), R6.2, R8.2, R12.2, R15.2, R16.2, R20.2, RV1.3, T1.2 (AB), T2.5 (S2), T3.3 (SA), U1.4 (V-), U1.5 (+)
I_sense: C9.1, J_I_SENSE_1.1, R14.2
PTT: J_PA_CTRL_1.2, Q4.1 (G), R20.1
PWR_LIMIT_EN: J_PA_CTRL_1.3, Q3.1 (G), R9.1, R10.1
PWR_LIMIT_SW: J_PA_CTRL_1.4, J_SW_1.1, R21.2
RX_RF: J_RF_RX_1.1 (In), K1.2
SWR_sense: C10.1, D4.3 (K), J_SWR_1.1, R15.1
TX_RF: J_RF_TX_1.1 (In), T1.1 (AA)

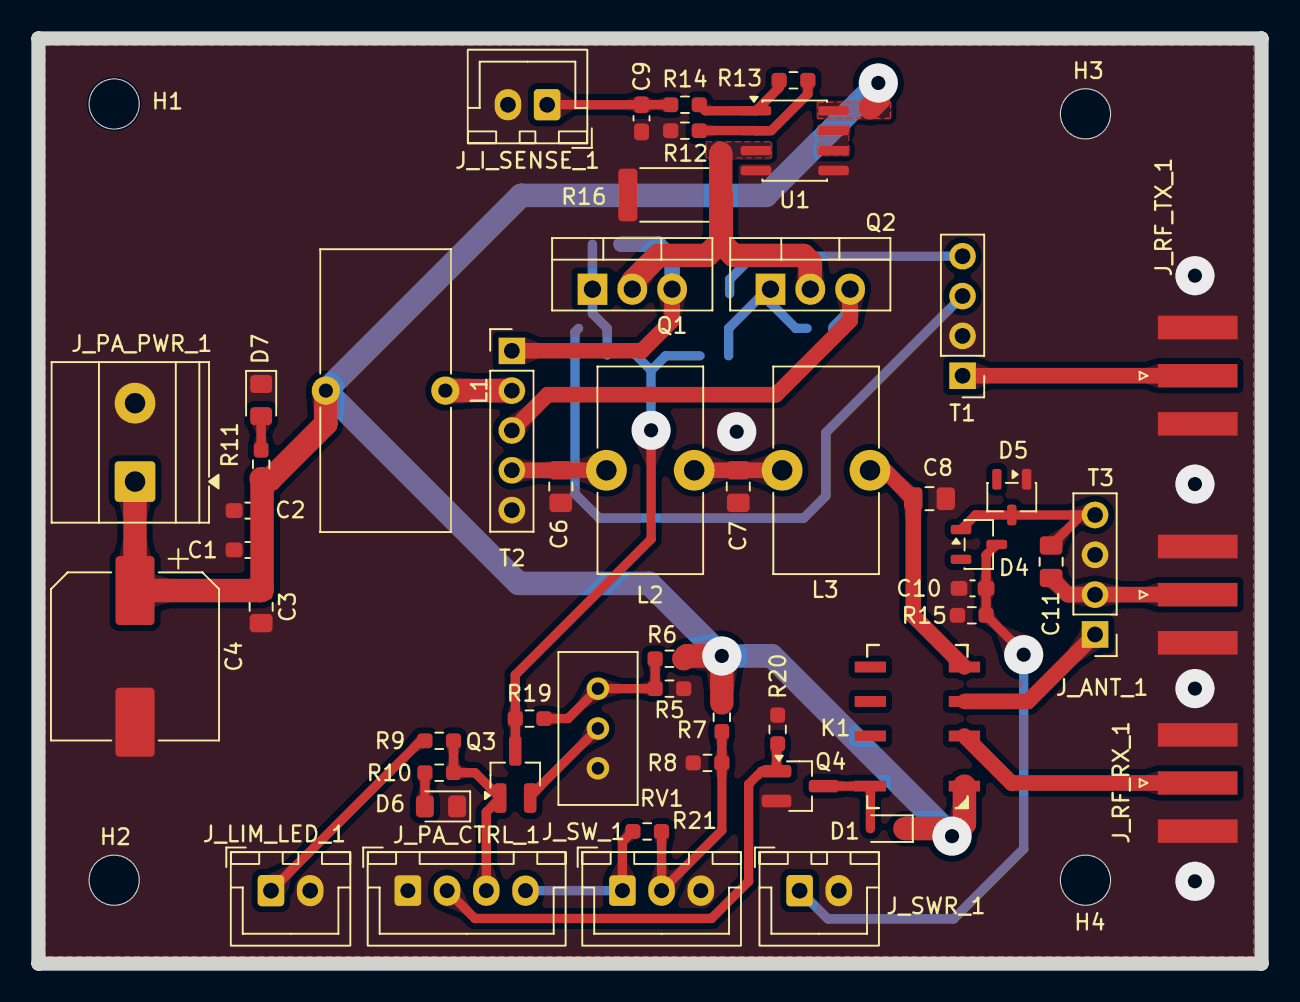
[picture p11: board 02_power_amp.kicad_pcb from above]

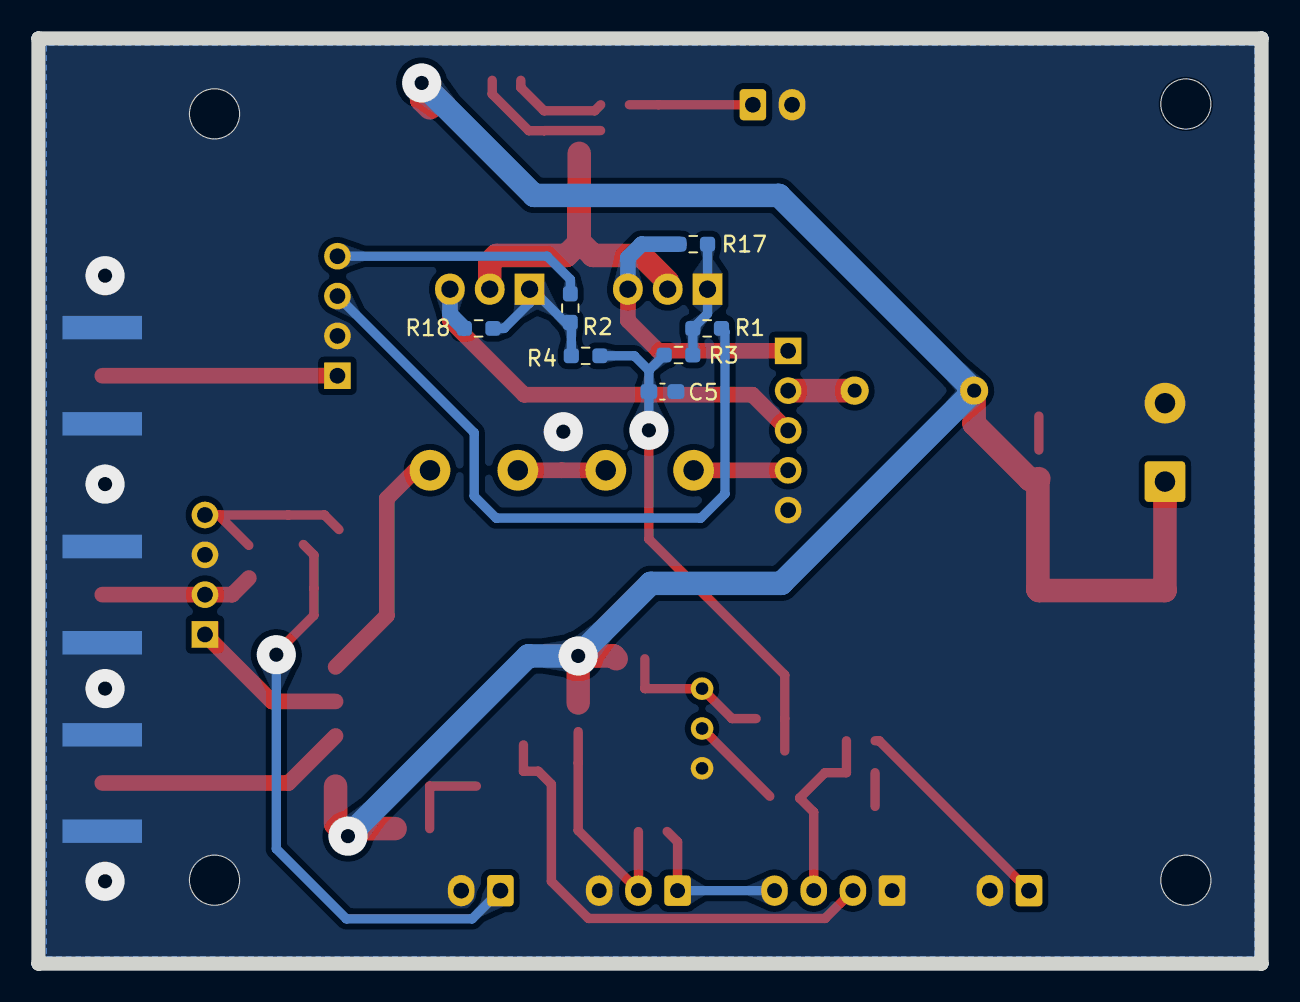
[picture p12: board 02_power_amp.kicad_pcb from below]

Board: 2 copper layers, 78.0 x 59.0 mm, 63 parts (7 on the bottom side), 34 nets.

Other parts of the board:
H1, H2, H3, H4: MountingHole_3.2mm_M3
