okunevpy-create/TRX_27MHz/KiCad/01_control/01_control.kicad_pcb

## KiCad design KiCad/01_control/01_control.kicad_pcb (2026-11-03)

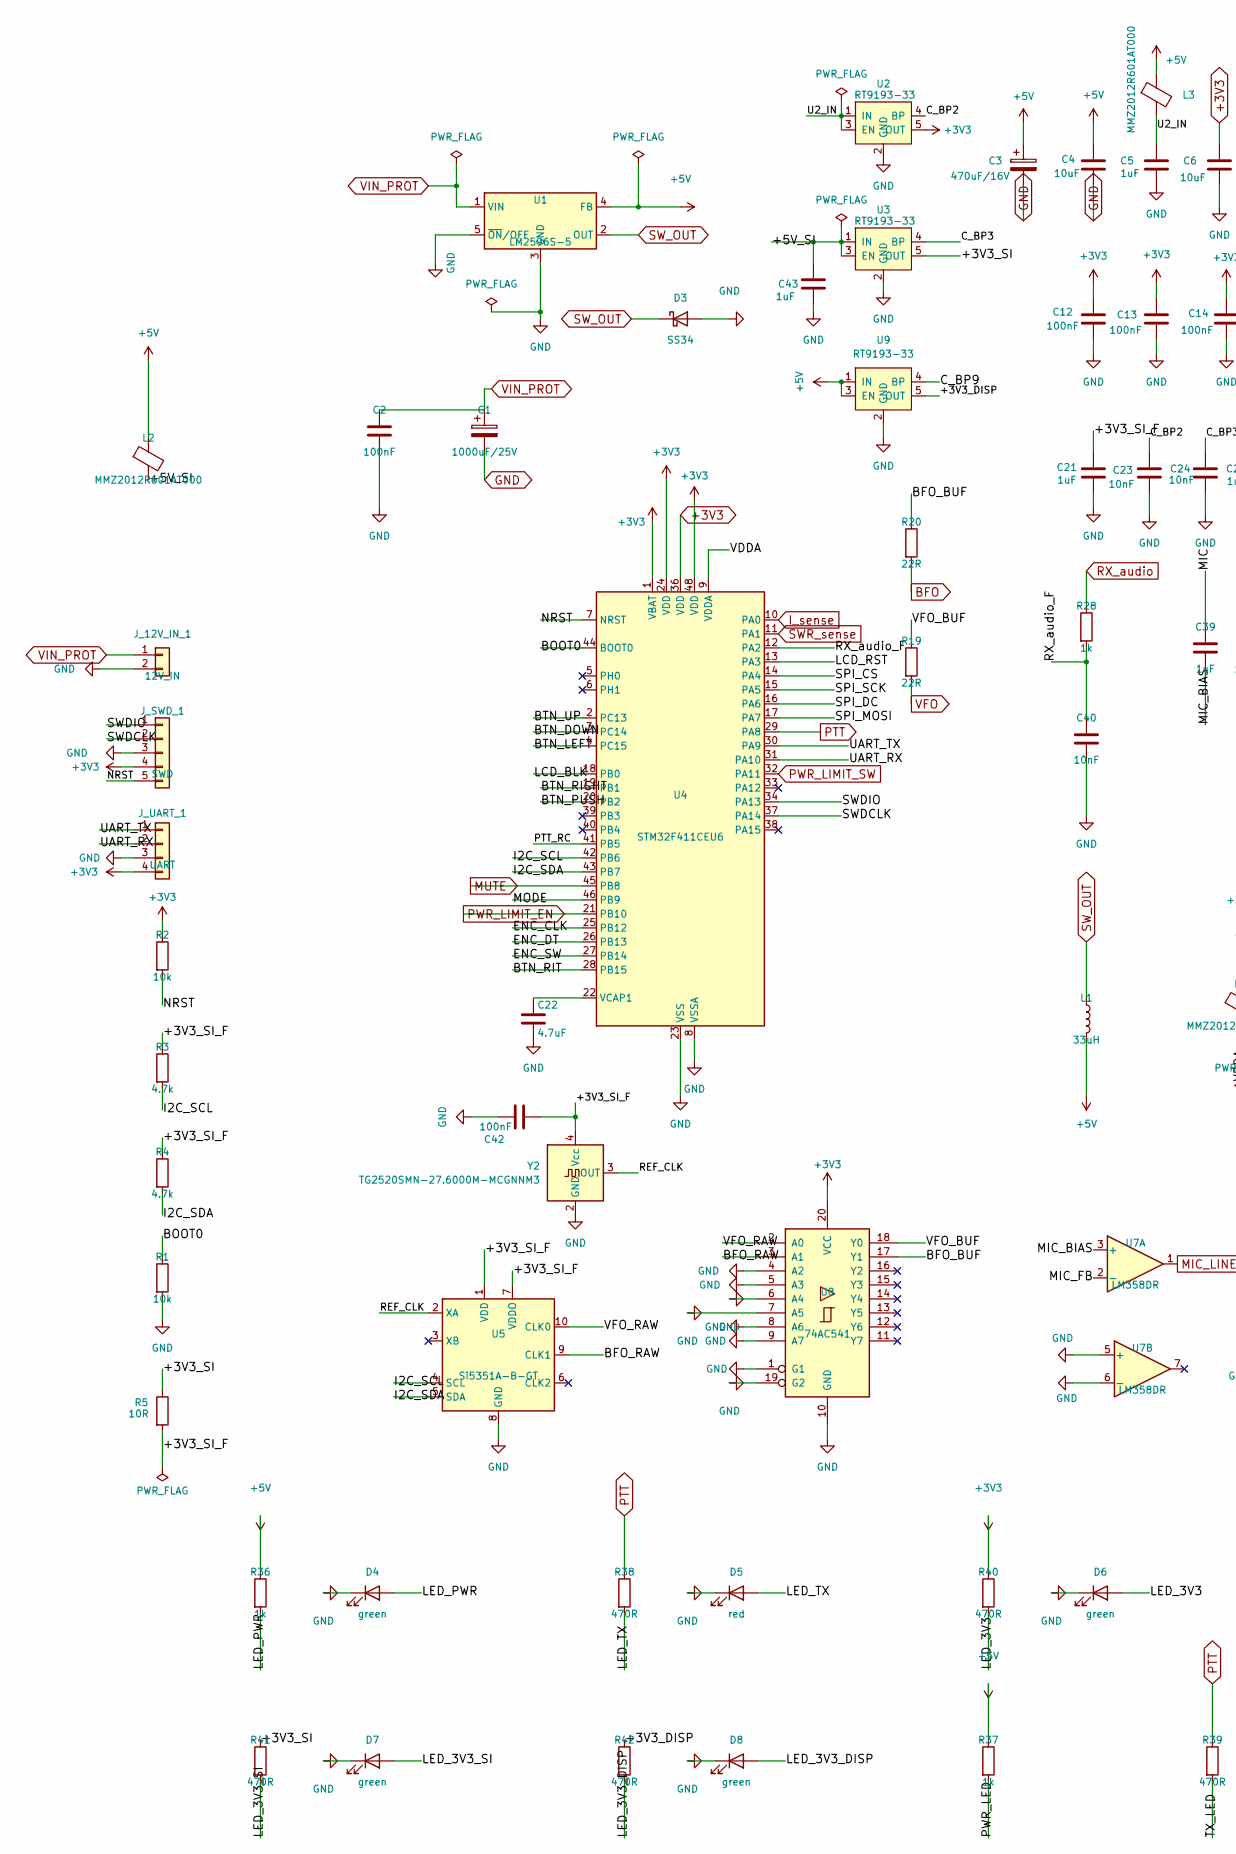
[picture p13: schematic 01_control.kicad_sch, part in row 1, column 1]

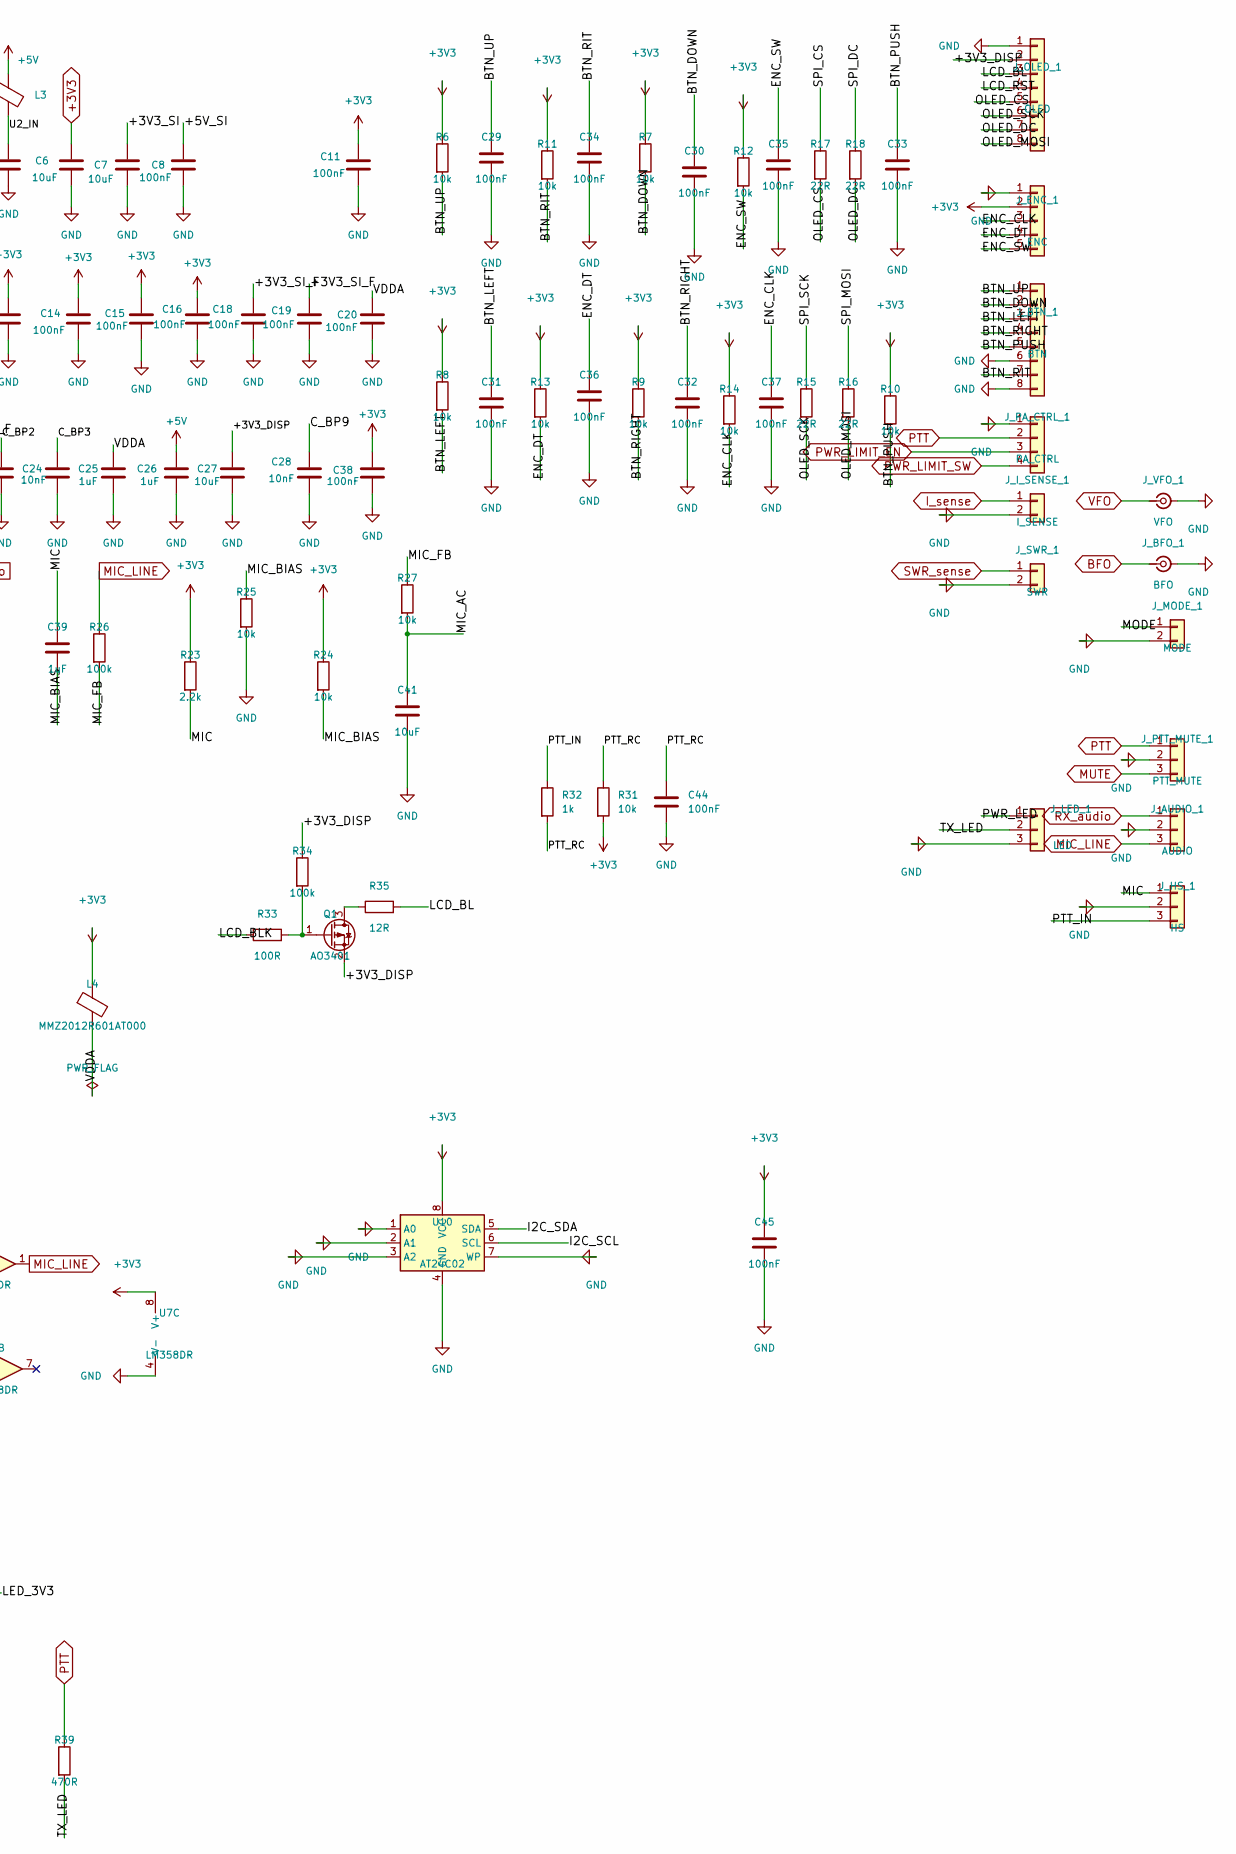
[picture p14: schematic 01_control.kicad_sch, part in row 1, column 2]

Parts:
C1: 1000uF/25V; CP_Elec_10x12.5
C2, C8, C11, C12, C13, C14, C15, C16, C18, C19, C20, C29, C30, C31, C32, C33, C34, C35, C36, C37, C38, C42, C44, C45: 100nF; C_0603_1608Metric_Pad1.08x0.95mm_HandSolder
C3: 470uF/16V; CP_Elec_8x10.5
C4, C6, C7, C27, C41: 10uF; C_0805_2012Metric_Pad1.18x1.45mm_HandSolder
C5, C21, C25, C26, C39, C43: 1uF; C_0603_1608Metric_Pad1.08x0.95mm_HandSolder
C22: 4.7uF; C_0603_1608Metric_Pad1.08x0.95mm_HandSolder
C23, C24, C28, C40: 10nF; C_0603_1608Metric_Pad1.08x0.95mm_HandSolder
D3: SS34; D_SMA_Handsoldering
D4, D6, D7, D8: green; LED_0805_2012Metric_Pad1.15x1.40mm_HandSolder
D5: red; LED_0805_2012Metric_Pad1.15x1.40mm_HandSolder
J_12V_IN_1: 12V_IN; TerminalBlock_Phoenix_MKDS-1,5-2_1x02_P5.00mm_Horizontal
J_AUDIO_1: AUDIO; JST_XH_B3B-XH-A_1x03_P2.50mm_Vertical
J_BFO_1: BFO; SMA_S-P215
J_BTN_1: BTN; JST_XH_B8B-XH-A_1x08_P2.50mm_Vertical
J_ENC_1: ENC; JST_XH_B5B-XH-A_1x05_P2.50mm_Vertical
J_HS_1: HS; JST_XH_B3B-XH-A_1x03_P2.50mm_Vertical
J_I_SENSE_1: I_SENSE; JST_XH_B2B-XH-A_1x02_P2.50mm_Vertical
J_LED_1: LED; JST_XH_B3B-XH-A_1x03_P2.50mm_Vertical
J_MODE_1: MODE; JST_XH_B2B-XH-A_1x02_P2.50mm_Vertical
J_OLED_1: OLED; JST_XH_B8B-XH-A_1x08_P2.50mm_Vertical
J_PA_CTRL_1: PA_CTRL; JST_XH_B4B-XH-A_1x04_P2.50mm_Vertical
J_PTT_MUTE_1: PTT_MUTE; JST_XH_B3B-XH-A_1x03_P2.50mm_Vertical
J_SWD_1: SWD; PinHeader_1x05_P2.54mm_Vertical
J_SWR_1: SWR; JST_XH_B2B-XH-A_1x02_P2.50mm_Vertical
J_UART_1: UART; PinHeader_1x04_P2.54mm_Vertical
J_VFO_1: VFO; SMA_S-P215
L1: 33uH; L_12x12mm_H4.5mm
L2, L3, L4: MMZ2012R601AT000; L_0805_2012Metric
Q1: AO3401; SOT-23_Handsoldering
R1, R2, R6, R7, R8, R9, R10, R11, R12, R13, R14, R24, R25, R27, R31: 10k; R_0603_1608Metric_Pad0.98x0.95mm_HandSolder
R3, R4: 4.7k; R_0603_1608Metric_Pad0.98x0.95mm_HandSolder
R5: 10R; R_0603_1608Metric_Pad0.98x0.95mm_HandSolder
R15, R16, R17, R18, R19, R20: 22R; R_0603_1608Metric_Pad0.98x0.95mm_HandSolder
R23: 2.2k; R_0603_1608Metric_Pad0.98x0.95mm_HandSolder
R26, R34: 100k; R_0603_1608Metric_Pad0.98x0.95mm_HandSolder
R28, R32, R36, R37: 1k; R_0603_1608Metric_Pad0.98x0.95mm_HandSolder
R33: 100R; R_0603_1608Metric_Pad0.98x0.95mm_HandSolder
R35: 12R; R_1210_3225Metric_Pad1.30x2.65mm_HandSolder
R38, R39, R40, R41, R42: 470R; R_0603_1608Metric_Pad0.98x0.95mm_HandSolder
U1: LM2596S-5; TO-263-5_TabPin3
U2, U3, U9: RT9193-33; SOT-23-5
U4: STM32F411CEU6; QFN-48-1EP_7x7mm_P0.5mm_EP5.6x5.6mm
U5: Si5351A-B-GT; MSOP-10_3x3mm_P0.5mm
U7: LM358DR; SOIC-8_3.9x4.9mm_P1.27mm
U8: 74AC541; SOIC-20W_7.5x12.8mm_P1.27mm
U10: AT24C02; SOIC-8_3.9x4.9mm_P1.27mm
Y2: TG2520SMN-27.6000M-MCGNNM3; Oscillator_SMD_SeikoEpson_TG2520SMN-xxx-xxxxxx-4Pin_2.5x2.0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

Connections:
+3V3: C6.1, C11.1, C12.1, C13.1, C14.1, C15.1, C16.1, C38.1, C45.1, J_ENC_1.2, J_SWD_1.4, J_UART_1.4, L4.1, R2.1, R6.1, R7.1, R8.1, R9.1, R10.1, R11.1, R12.1, R13.1, R14.1, R23.1, R24.1, R31.2, R40.1, U2.5 (OUT), U4.1 (VBAT), U4.24 (VDD), U4.36 (VDD), U4.48 (VDD), U7.8 (V+), U8.20 (VCC), U10.8 (VCC)
+5V: C3.1, C4.1, C26.1, L1.2, L2.1, L3.1, R36.1, R37.1, U1.4 (FB), U9.1 (IN), U9.3 (EN)
/+3V3_DISP: C27.1, J_OLED_1.2, Q1.2 (S), R34.1, R42.1, U9.5 (OUT)
/+3V3_SI: C7.1, R5.1, R41.1, U3.5 (OUT)
/+5V_SI: C8.1, C43.1, L2.2, U3.1 (IN), U3.3 (EN)
/BFO_BUF: R20.1, U8.17 (Y1)
/BFO_RAW: U5.9 (CLK1), U8.3 (A1)
/BOOT0: R1.1, U4.44 (BOOT0)
/BTN_DOWN: C30.1, J_BTN_1.2, R7.2, U4.3 (PC14)
/BTN_LEFT: C31.1, J_BTN_1.3, R8.2, U4.4 (PC15)
/BTN_PUSH: C33.1, J_BTN_1.5, R10.2, U4.20 (PB2)
/BTN_RIGHT: C32.1, J_BTN_1.4, R9.2, U4.19 (PB1)
/BTN_RIT: C34.1, J_BTN_1.7, R11.2, U4.28 (PB15)
/BTN_UP: C29.1, J_BTN_1.1, R6.2, U4.2 (PC13)
/C_BP2: C23.1, U2.4 (BP)
/C_BP3: C24.1, U3.4 (BP)
/C_BP9: C28.1, U9.4 (BP)
/ENC_CLK: C37.1, J_ENC_1.3, R14.2, U4.25 (PB12)
/ENC_DT: C36.1, J_ENC_1.4, R13.2, U4.26 (PB13)
/ENC_SW: C35.1, J_ENC_1.5, R12.2, U4.27 (PB14)
/I2C_SCL: R3.2, U4.42 (PB6), U5.4 (SCL), U10.6 (SCL)
/I2C_SDA: R4.2, U4.43 (PB7), U5.5 (SDA), U10.5 (SDA)
/LCD_BL: J_OLED_1.3, R35.2
/LCD_BLK: R33.1, U4.18 (PB0)
/LCD_RST: J_OLED_1.4, U4.13 (PA3)
/LED_3V3: D6.2 (A), R40.2
/LED_3V3_DISP: D8.2 (A), R42.2
/LED_3V3_SI: D7.2 (A), R41.2
/LED_PWR: D4.2 (A), R36.2
/LED_TX: D5.2 (A), R38.2
/MIC: C39.1, J_HS_1.1, R23.2
/MIC_AC: C41.1, R27.2
/MIC_BIAS: C39.2, R24.2, R25.1, U7.3 (+)
/MIC_FB: R26.2, R27.1, U7.2 (-)
/MODE: J_MODE_1.1, U4.46 (PB9)
/NRST: J_SWD_1.5, R2.2, U4.7 (NRST)
/OLED_CS: J_OLED_1.5, R17.2
/OLED_DC: J_OLED_1.7, R18.2
/OLED_MOSI: J_OLED_1.8, R16.2
/OLED_SCK: J_OLED_1.6, R15.2
/PTT_IN: J_HS_1.3, R32.1
/PTT_RC: C44.1, R31.1, R32.2, U4.41 (PB5)
/PWR_LED: J_LED_1.1, R37.2
/REF_CLK: U5.2 (XA), Y2.3 (OUT)
/RX_audio_F: C40.1, R28.2, U4.12 (PA2)
/SPI_CS: R17.1, U4.14 (PA4)
/SPI_DC: R18.1, U4.16 (PA6)
/SPI_MOSI: R16.1, U4.17 (PA7)
/SPI_SCK: R15.1, U4.15 (PA5)
/SWDCLK: J_SWD_1.2, U4.37 (PA14)
/SWDIO: J_SWD_1.1, U4.34 (PA13)
/TX_LED: J_LED_1.2, R39.2
/UART_RX: J_UART_1.2, U4.31 (PA10)
/UART_TX: J_UART_1.1, U4.30 (PA9)
/VFO_BUF: R19.1, U8.18 (Y0)
/VFO_RAW: U5.10 (CLK0), U8.2 (A0)
BFO: J_BFO_1.1 (In), R20.2
GND: C1.2, C2.2, C3.2, C4.2, C5.2, C6.2, C7.2, C8.2, C11.2, C12.2, C13.2, C14.2, C15.2, C16.2, C18.2, C19.2, C20.2, C21.2, C22.2, C23.2, C24.2, C25.2, C26.2, C27.2, C28.2, C29.2, C30.2, C31.2, C32.2, C33.2, C34.2, C35.2, C36.2, C37.2, C38.2, C40.2, C41.2, C42.2, C43.2, C44.2, C45.2, D3.2 (A), D4.1 (K), D5.1 (K), D6.1 (K), D7.1 (K), D8.1 (K), J_12V_IN_1.2, J_AUDIO_1.2, J_BFO_1.2 (Ext), J_BTN_1.6, J_BTN_1.8, J_ENC_1.1, J_HS_1.2, J_I_SENSE_1.2, J_LED_1.3, J_MODE_1.2, J_OLED_1.1, J_PA_CTRL_1.1, J_PTT_MUTE_1.2, J_SWD_1.3, J_SWR_1.2, J_UART_1.3, J_VFO_1.2 (Ext), R1.2, R25.2, U1.3 (GND), U1.5 (~ON/OFF), U2.2 (GND), U3.2 (GND), U4.8 (VSSA), U4.23 (VSS), U4.35 (VSS), U4.47 (VSS), U4.49 (VSS), U5.8 (GND), U7.4 (V-), U7.5 (+), U7.6 (-), U8.1 (G1), U8.4 (A2), U8.5 (A3), U8.6 (A4), U8.7 (A5), U8.8 (A6), U8.9 (A7), U8.10 (GND), U8.19 (G2), U9.2 (GND), U10.1 (A0), U10.2 (A1), U10.3 (A2), U10.4 (GND), U10.7 (WP), Y2.2 (GND)
I_sense: J_I_SENSE_1.1, U4.10 (PA0)
MIC_LINE: J_AUDIO_1.3, R26.1, U7.1
MUTE: J_PTT_MUTE_1.3, U4.45 (PB8)
unnamed: Q1.3 (D), R35.1
unnamed: Q1.1 (G), R33.2, R34.2
unnamed: C22.1, U4.22 (VCAP1)
PTT: J_PA_CTRL_1.2, J_PTT_MUTE_1.1, R38.1, R39.1, U4.29 (PA8)
PWR_LIMIT_EN: J_PA_CTRL_1.3, U4.21 (PB10)
PWR_LIMIT_SW: J_PA_CTRL_1.4, U4.32 (PA11)
RX_audio: J_AUDIO_1.1, R28.1
SWR_sense: J_SWR_1.1, U4.11 (PA1)
SW_OUT: D3.1 (K), L1.1, U1.2 (OUT)
VFO: J_VFO_1.1 (In), R19.2
VIN_PROT: C1.1, C2.1, J_12V_IN_1.1, U1.1 (VIN)

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
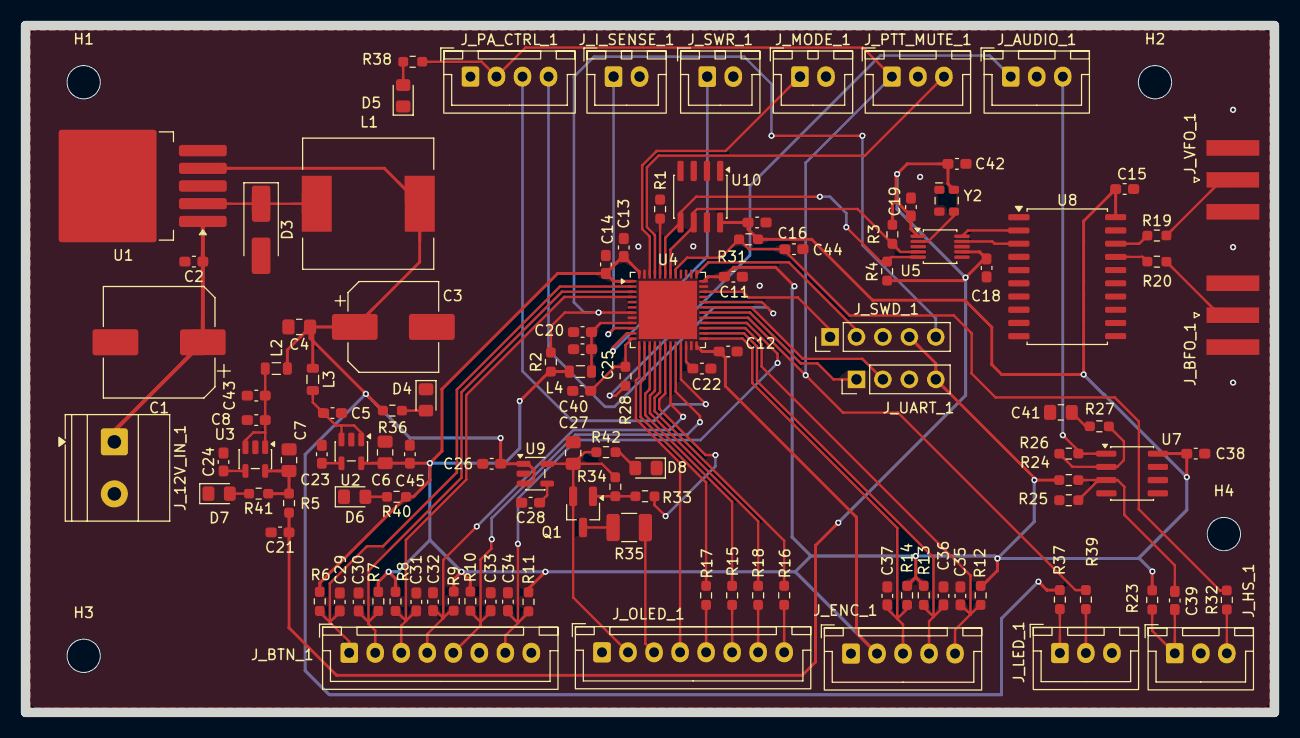
[picture p15: board 01_control.kicad_pcb from above]

Board: 2 copper layers, 120.0 x 66.0 mm, 121 parts (0 on the bottom side), 75 nets.

Other parts of the board:
H1, H2, H3, H4: MountingHole_3.2mm_M3
