okunevpy-create/TRX_27MHz/(commit log)

2026-10-25 repo: initial structure, 5 stages (0-4), contracts, bom, calculations
    [00_master.kicad_sch, 01_control.kicad_sch, 02_power_amp.kicad_sch, 03_rx_tx.kicad_sch, bom_master.csv]
2026-10-25 Доработки и новые правила.
    [00_master.kicad_sch]
2026-10-25 contract: add headset MIC_LINE/MUTE signals and rxtx_pa RF link
    Update control_rxtx and inter-module pinout with headset (MIC/PTT/SP+/GND), MIC_LINE and MUTE signals.
2026-10-25 hw: align block projects, add stub hierarchy in 00_master and labels
    Create .kicad_pro/.kicad_pcb for blocks; 00_master gets 3 sheet symbols + pins; hierarchical stub labels in blocks; update stage READMEs for headset pads; ignore MCP/output artifacts.
    [00_master.kicad_sch, 01_control.kicad_pcb, 01_control.kicad_sch, 02_power_amp.kicad_pcb, 02_power_amp.kicad_sch, 03_rx_tx.kicad_pcb, 03_rx_tx.kicad_sch]
2026-10-25 repo: consolidate KiCad rules, update session context (Stage 0 deferred)
    Merge KiCad rules into kicad_rules.md; record headset decisions and Stage 0 (master) deferral in context.
2026-10-26 hw: stage1.3 Si5351 synth + 74HC74 IQ + BOM updates; fix Y1/D1 parts; UI-on-enclosure rule
    [01_control.kicad_sch, capacitors_ 0603.csv, resistance_0603.csv]
2026-10-26 зафиксирован context.md
2026-10-26 bom: stage1 BOM closed (ChipDip/Ozon/stock), UX decisions, KiCad task F1-F13
    - BOM stage1: all items ORDERED/STOCK, no shortage; exact P/Ns: LM2596 TO-263-5, RT9193 x3 (U2,U3,U9), 74AC541SC, SPQ105-330M, EEEFK1C471P, BLM21SP181SN1D x2, BC507-040 + 522.1300 T3A 5x20 x2, WJ127R-5.0-02P x2, XH2.54 set 2P-12P
    - UX decisions: ST7789 2.0in 240x320 SPI display with dedicated LDO U9; encoder button functional (J_ENC 5pin); joystick 5-way + separate RIT button (J_BTN 7pin); J_OLED 8pin; J_RXTX_SIG single 10pin
    - Mandatory RC filters on UI lines (F13): 10k+100nF on J_BTN x6 and J_ENC x3, 22R series on SPI lines x4
    - New docs/kicad_task_stage1.md: step-by-step KiCad task F1-F13, U8 74AC541 wiring, D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
    [ChipDipCart-utf8.csv, smd_resistors_0603.csv]
2026-10-26 bom: add incoming inspection checklist for stage1 parts
2026-10-26 добавлено описание
2026-10-26 много ошибок. надо пересобирать 1 этап
    [01_control.kicad_sch]
2026-10-26 фиксация
2026-10-27 hw: clean U2/U3 power section and fix rail shorts
    [01_control.kicad_sch]
2026-10-27 hw: remove +3V3/GND bridge wires in power section
    [01_control.kicad_sch]
2026-10-27 docs: record +3V3/GND short fix and power re-route findings
2026-10-27 hw: re-route U2/U3 LDO power section
    - Route +5V through L2 ferrite into U3 IN (new +5V_SI net)
    - Connect C5/C6 to +3V3 and C7 to +3V3_SI as LDO output caps
    - Remove stray +3V3 power symbol on C5 pin2 (was shorting +3V3 to GND)
    [01_control.kicad_sch]
2026-10-27 docs: record U2/U3 re-route and pin-spacing correction
2026-10-27 hw: переразвести секцию U1 (вход/выход 12В->5В)
    [01_control.kicad_sch]
2026-10-27 hw: подключить U4 VDD(36) к +3V3
    [01_control.kicad_sch]
2026-10-27 docs: отметить подключение U4 VDD(36) к +3V3
2026-10-27 hw: fix duplicate C21 refdes
    F10 -> C21, BP U3 bypass -> C24
    [01_control.kicad_sch]
2026-10-27 docs: update context and power cleanup plan
2026-10-27 bom: update stage1_control
2026-10-27 update sheme
    [01_control.kicad_sch]
2026-10-27 update scheme
    [01_control.kicad_sch]
2026-10-28 mech: передняя панель-корытце с галтелью R2
    Галтель (наружная, makeFillet) наносится по простой призме до выреза полости — иначе дефекты и InvalidCurveOnSurface. Внутреннее скругление BASIN_FILLET остаётся отключено.
    [front_panel.FCStd, front_panel.step, front_panel.stl]
2026-10-28 mech: верхняя и нижняя скорлупы корпуса
    Шов Z=25 — шип/паз без винтов; язычки скорлуп в пазы корытца. Исправлен дефект: правый паз шва откалывал угол-«занозу» (2 solid).
    [front_panel.FCStd, front_panel.step, front_panel.stl, shell_bottom.FCStd, shell_bottom.step, shell_bottom.stl, shell_top.FCStd, shell_top.step]
2026-10-28 mech: тумблер питания и шов скорлуп 1+1
    Раскладка панели — равный шаг (6 отрезков), тумблер KN3(B)-101A-A1 справа.
    [front_panel.FCStd, front_panel.step, front_panel.stl, shell_bottom.FCStd, shell_bottom.step, shell_bottom.stl, shell_top.FCStd, shell_top.step]
2026-10-28 mech: цековки, R2.5, винты язычков, задние пазы
    Исправлен баг цековок (старт -0.02). SHELL_FILLET приведён к CORNER_R (2.5). На язычки добавлены Ø3.4 + зенковка Ø6. Заложены пазы под заднюю крышку. Обновлены README, requirements, context.
    [front_panel.FCStd, front_panel.step, front_panel.stl, shell_bottom.FCStd, shell_bottom.step, shell_bottom.stl, shell_top.FCStd, shell_top.step]
2026-10-28 mech: задняя крышка и сборочный макет
    Крышка-заглушка 186×56, 4 язычка в задние пазы скорлуп. Сборка объединяет 4 детали и схематичные органы управления. fc_common: line-buffering stdout. Обновлена документация.
    [assembly.FCStd, assembly.step, assembly.stl, back_cover.FCStd, back_cover.step, back_cover.stl]
2026-10-28 mech: боковые язычки задней крышки и скорлуп
    [assembly.FCStd, assembly.step, assembly.stl, back_cover.FCStd, back_cover.step, back_cover.stl, shell_bottom.FCStd, shell_bottom.step]
2026-10-28 mech: зенковки винтов задней крышки
    [assembly.FCStd, assembly.step, assembly.stl, back_cover.FCStd, back_cover.step, back_cover.stl]
2026-10-28 hw: Развести F3-F13 (U7/U8/U9, UI, RC-фильтры)
    [01_control.kicad_sch]
2026-10-28 bom: Зафиксировать refdes и разъёмы после F12/F13
    [ChipDipCart-utf8.csv]
2026-10-28 docs: Обновить context и ТЗ после F1-F13
2026-10-28 repo: Зафиксировать правила KiCad (символы, 2D-сетка)
2026-10-28 Пофиксил расположение на схеме. Поменял распинковке J_OLED для соотвествия дисплею.
    [01_control.kicad_sch]
2026-10-28 docs: Закрыть сверку ST7789 и порядок J_OLED
2026-10-28 contract: Зафиксировать распиновку гарнитуры
    Kenwood K1 2-pin: 2.5 мм (MIC/PTT), 3.5 мм (SP+).
2026-10-28 hw: Завершить 1.4 (MIC U7, RX_audio RC)
    Исправлено КЗ MIC/MIC_BIAS/MIC_FB. Обновлены BOM и context.
    [01_control.kicad_sch]
2026-10-28 docs: Добавить отчёт сессии 1.4
2026-10-28 hw: Поправить положение U7 на схеме
    [01_control.kicad_sch]
2026-10-28 contract: Зафиксировать типы и пинаут межблочных разъёмов
2026-10-28 docs: Зафиксировать контракты и пинаут в context.md
2026-10-28 hw: переименовать разъёмы J_* в J_*_1
    KiCad GUI требует числовое окончание refdes, иначе помечает разъём как «не обозначен».
    [01_control.kicad_sch]
2026-10-28 docs: обновить refdes разъёмов на *_1
2026-10-28 bom: обновить refdes разъёмов на *_1
2026-10-28 contract: обновить refdes разъёмов на *_1
2026-10-28 добавил не достающие файлы
    [assembly.FCStd]
2026-10-28 hw: Fix validation findings in 01_control
    Add 12V input terminal (J_12V_IN_1) and VDDA ferrite (L4); fix C1 BOM size; document Phoenix/WJ127R equivalence.
    [01_control.kicad_sch]
2026-10-28 hw: заменить Y2 на TCXO TG2520SMN (4-pin, +C42)
    OUT->REF_CLK->Si5351 XA, XB->NC, VCC->+3V3_SI_F; развязка C42 100нФ. Обновлены BOM и docs/context.md.
    [01_control.kicad_sch]
2026-10-29 правки по результам валидации
    [01_control.kicad_sch]
2026-10-29 добавлены новые правила
2026-10-29 STAGE2 подгтовка BOM
2026-10-29 исправление правил создания компонетов
2026-10-29 исправление согласно отчёту
    [01_control.kicad_sch]
2026-10-29 hw: add RD16HHF1 symbol and power amp schematic
    [02_power_amp.kicad_sch]
2026-10-29 bom: finalize PA BOMs and rename stage 1 cart
    [ChipDipCart-Stage_1.csv, ChipDipCart-utf8.csv]
2026-10-30 hw: подготовка этапа 2 (02_power_amp) завершена
    BOM согласован, контракты зафиксированы, символы и footprint готовы. Теплоотвод HS 104-30, расчёт витков, RD16HHF1 по даташиту (Idq 0.5 А).
    [01_control.kicad_sch, 02_power_amp.kicad_sch, ChipDipCart-Stage_2.csv]
2026-10-30 docs: убрать радиатор с задней крышки
    Радиатор HS 104-30 остаётся заказанным и монтируется на плате 02_power_amp, не на корпусе. Зафиксированы: разъём питания KLS1-DC-025A-2.0, драйвер не нужен, термопаста в наличии, отладка на готовой плате. Исправлен срез RC Si5351 (14→15.9 кГц). Актуализирована корзина ChipDip.
    [ChipDipCart-Stage_2.csv]
2026-10-30 Rmove hierarchical lables
    [02_power_amp.kicad_sch]
2026-10-30 remove labels
    [03_rx_tx.kicad_sch]
2026-10-30 cleanup scheme
    [02_power_amp.kicad_sch]
2026-10-30 hw: этап 2 — схема 02_power_amp (2.1–2.3), ERC=0
    BOM/контракты/доки сверены со схемой (простые ref, разъёмы с индексом); R17/R18 — DNP; добавлен session_report_stage2.md.
    [02_power_amp.kicad_sch, ChipDipCart-Stage_2.csv]
2026-10-30 docs: актуализировать трекеры и контекст этапов 1-2
    kicad_task_stage1.md приведён к реальному состоянию: F1-F13, 1.4/1.5 и read-only валидация выполнены; ERC 0 error / 7 warning (excluded); травление этапа 1 разблокировано. kicad_task_stage2.md - отметки готовности 2.1-2.3. context.md - ERC выровнен с фактическим 0/7 excluded.
2026-10-30 hw: разбить 1↔3 на 6 разъёмов и объединить гарнитуру в J_HS_1
    [01_control.kicad_sch]
2026-10-30 docs: актуализировать контекст (разбивка 1↔3 + J_HS_1)
2026-10-30 docs: J_PA_CTRL_1 4P + LIMIT/FULL SPDT
    Разбит J_PA_CTRL_1 6P→4P (GND/PTT/PWR_LIMIT_EN/PWR_LIMIT_SW), вынесены J_I_SENSE_1/J_SWR_1 (2P). LIMIT/FULL переведён на SPDT ASW-14-102 + MOSFET на плате (VGG не покидает 02_power_amp). Синхронизированы contract/BOM/доки.
2026-10-30 hw: J_PA_CTRL_1 4P и LIMIT/FULL SPDT в 02_power_amp
    J_PA_CTRL_1 6P→4P, добавлены J_I_SENSE_1/J_SWR_1 (2P), Q5 (2N7002), R19 (100k). J_SW_1 6P→3P (логика ASW-14-102), VGG остаётся на плате. ERC=0.
    [02_power_amp.kicad_sch]
2026-10-30 hw: разбить J_PA_CTRL_1 в 01_control (4P + J_I_SENSE_1/J_SWR_1)
    J_PA_CTRL_1 6P→4P (GND/PTT/PWR_LIMIT_EN/PWR_LIMIT_SW), добавлены J_I_SENSE_1/J_SWR_1 (2P, I_sense/SWR_sense+GND). ERC=0 err / 7 warn (baseline).
    [01_control.kicad_sch]
2026-10-30 docs: off-board cleanup отчёт и актуализация context
2026-10-30 docs: ASW-14-102 вместо KN3 и 1N4148WS ×3
2026-10-30 bom: ASW-14-102 в корзину ChipDip, 2N7002 ×2 по факту
    [ChipDipCart-Stage_2.csv]
2026-10-30 косметика
    [02_power_amp.kicad_sch, ChipDipCart-Stage_2.csv]
2026-10-30 bom: предварительный BOM этапа 3 (тракт RX/TX)
2026-10-30 bom: этап 3 — 2SC2078 драйвер, замена SA612, диоды 2 шт
2026-10-30 bom: этап 3 — NE612 (≡ SA612A) как смеситель/модулятор
2026-10-30 bom: этап 3 — NE612AD SOP-8 (footprint + кастомный символ)
2026-10-30 bom: этап 3 — NE612AD ×3 (продукт-детектор закрыт)
2026-10-30 bom: этап 3 — лестничный кварцевый фильтр 10,7 МГц
2026-10-31 bom: этап 3 — NE612AD/2SC2078/1N4148WS заказаны
2026-10-31 bom: этап 3 — ПЧ 10 МГц, кварцы HC-49SM заказаны
2026-10-31 hw: символ NE612A и библиотека trx_custom
    [03_rx_tx.kicad_sch]
2026-10-31 contract: J_RF_RX_1 в control_rxtx.md и stage3 BOM
2026-10-31 docs: актуализировать context (этап 3, ПЧ 10 МГц)
2026-10-31 bom: LM386 заказан, катушки BPF — SMD 0.47 мкГн
2026-10-31 bom: катушки BPF — MLF2012DR47KT000 (200 мА) для RX и TX
2026-10-31 bom: этап 3 — L78L06 и катушки заказаны, BOM согласован
2026-10-31 docs: этап 3 — BOM согласован, все позиции заказаны
2026-10-31 docs: фиксация J_SP_1, DC-джека и тумблера питания
2026-10-31 hw: схема 3.1 — BPF 27 МГц построена (ERC=0)
    Двухконтурный ёмкостно-связанный BPF (Баттерворт 2 полюса, 50 Ом): 2×0.47мкГн + 2×51пФ + 2×18пФ + 1×2.7пФ. Добавлен расчёт bpf_27mhz.md; BOM §3.1 обновлён (4×L + 10×C0G).
    [03_rx_tx.kicad_sch]
2026-10-31 hw: убрать I/Q-балласт, добавить MODE
    SSB — фильтровый метод, квадратура (74HC74, J_I_1/J_Q_1) удалена. PB9 (бывш. IQ_EN) -> MODE, новый разъём J_MODE_1 (XH2.54 2P). FM не делаем. Доки/BOM/контракты приведены в соответствие.
    [01_control.kicad_sch]
2026-10-31 hw: схема этапа 3 (3.1-3.5) - тракт RX/TX целиком, ERC=0
    [03_rx_tx.kicad_sch]
2026-10-31 docs: этап 3 - BOM, design_decisions, context, session_report
2026-10-31 hw: триммер AM-несущей как делитель (R23 100к)
    [03_rx_tx.kicad_sch]
2026-10-31 docs: этап 3 - топология триммера AM-несущей (делитель, R23 100к)
2026-10-31 docs: зафиксировать финальную сверку перед PCB
2026-10-31 hw: убрать F1 со схемы 01_control (защита входа — на корпус)
    Предохранитель 3 А снят с платы; защита входа перенесена на корпус (5 А + TVS load dump + SS54) перед предрегулятором LTC3780 13,8 В.
    [01_control.kicad_sch]
2026-10-31 bom: этап 1 — защита входа перенесена на корпус (5 А + TVS + SS54)
    F1 (3 А) снят с платы; на корпус — предохранитель 5 А + TVS load dump + SS54 перед LTC3780.
2026-10-31 docs: план PCB-компоновки и предрегулятор LTC3780
    Новый pcb_placement_plan.md (размещение в корпусе, кабели, стойки M3); обновлены power-distribution, README этапа 1 и context.
2026-10-31 hw: EEPROM U10 и снятие раздачи питания на WAGO
    Добавлен AT24C02 (U10, I2C 0x50) для хранения RIT/каналов; убраны J_PA_PWR_1, J_RXTX_PWR_1 и R29/R30. Раздача +12V вынесена на внешние WAGO 221-415. ERC 0 ошибок.
    [01_control.kicad_sch]
2026-10-31 contract: питание блоков через WAGO 221-415
2026-10-31 bom: этап 1 — EEPROM U10 и WAGO-раздача +12V
2026-10-31 docs: раздача питания через WAGO 221-415
2026-10-31 hw: убрать D1/D2 (TVS+SS34) со входа 01_control
    D1 (TVS SMBJ18A) и D2 (SS34) сняты; вход J_12V_IN_1 -> VIN_PROT напрямую, вся защита на корпусе. ERC 0 ошибок.
    [01_control.kicad_sch]
2026-10-31 docs: входная защита D1/D2 только на корпусе
2026-10-31 hw: DRC-правила и настройки платы 01_control
2026-10-31 docs: PCB этапа 1 — net-классы, план размещения, DRC-регламент
2026-10-31 docs: земля — единый GND, разделение геометрией полигона
2026-11-01 Подогтовка платы
    [01_control.kicad_pcb]
2026-11-01 docs: синтаксис DRC (KiCad 10) и ВЧ-разъёмы SMA S-P215
2026-11-01 hw: SMA S-P215 — footprint для 9 ВЧ-разъёмов
    [01_control.kicad_sch, 02_power_amp.kicad_sch, 03_rx_tx.kicad_sch]
2026-11-01 Правка ВЧ разъёмов
    [01_control.kicad_pcb, 01_control.kicad_sch, 02_power_amp.kicad_sch, 03_rx_tx.kicad_sch]
2026-11-01 PWR complete
    [01_control.kicad_pcb]
2026-11-01 Step 3 complete
    [01_control.kicad_pcb]
2026-11-01 Частично шаг 4. Надо поменять поардок выводов разъёмов UI
    [01_control.kicad_pcb]
2026-11-01 hw: правки разводки 01_control
    Убран кварц Y1/C9/C10 (HSI). Переставлены GPIO PB12-PB15, разведены J_OLED_1/J_ENC_1. Обновлены docs и BOM.
    [01_control.kicad_pcb, 01_control.kicad_sch]
2026-11-01 J_BTN_1 смена назначения пинов
    [01_control.kicad_pcb, 01_control.kicad_sch]
2026-11-02 базово сошлось. Нужно менять сестами блоки
    [01_control.kicad_pcb]
2026-11-02 Осталось только питание
    [01_control.kicad_pcb, 01_control.kicad_sch]
2026-11-02 разводка завершена
    [01_control.kicad_pcb]
2026-11-02 Правка классов цепей
    [01_control.kicad_pcb]
2026-11-02 добавлены исключения
    [01_control.kicad_pcb]
2026-11-02 Удаление лишних VIA
    [01_control.kicad_pcb]
2026-11-02 exclude erros
    [01_control.kicad_pcb]
2026-11-02 hw: финализация разводки 01_control
    GND полигон под MCU выведен наружу; перемычка GND у пина 47 U4; DRC чист (10 исключений на U5, 0 unconnected); обновлены pcb_layout_stage1.md и context.md
    [01_control.kicad_pcb]
2026-11-03 mech: задняя крышка, разъёмы и компоновка корпуса
    Антенна BNC, DC-джек KLS1-DC-025A-2.0 и держатель предохранителя FH10-S-MZ на задней крышке; компоновка передней панели и крепление энкодера; стойки платы 01_control; доки.
    [assembly.FCStd, assembly.step, assembly.stl, back_cover.FCStd, back_cover.step, back_cover.stl, front_panel.FCStd, front_panel.step]
2026-11-03 fw: настройка PlatformIO и UI/UX прошивки
    board genericSTM32F411CE (HSI), DFU, USB CDC; lib_deps Si5351 + Arduino_GFX; UI/UX согласован (docs/firmware_ui_ux.md); отладка — Wokwi Simulator.
2026-11-03 add drill and templates
    [01_control.kicad_pcb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]
2026-11-03 add mask
    [01_control.kicad_pcb]
2026-11-03 подготовка к отправке на завод
    [01_control.kicad_pcb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]
2026-11-03 fw: прошивка 01_control — скелет, Si5351, каналы, native-тесты
    Конечный автомат BOOT/VFO/TX/MENU/RIT, каналы CEPT/RUS, RIT, squelch, PTT, ограничитель. Si5351: делители под TCXO 27.6 МГц (без хака масштабирования) + BFO_OFFSET_HZ. Каналы вынесены в include/channels.h. env:native + Unity (12 тестов).
2026-11-03 contract: исправить Si5351 — VFO=CLK0, BFO=CLK1
2026-11-03 docs: обновить context.md — firmware-сессии 2026-11-03
2026-11-03 fw: вынести VFO/BFO-математику + предупреждение FULL@AM
    RIT/VFO и BFO вынесены в чистый include/rf_math.h; +8 тестов (всего 20, все PASSED). Предупреждение FULL @ AM! на экранах RX/TX при FULL в AM (контракт control_pa.md).
2026-11-03 docs: VFO/BFO-математика, FULL@AM, 20 тестов
2026-11-04 docs: план разводки этапа 2 (02_power_amp)
    Токовый бюджет + ширины (IPC-2221), net-классы PWR_PA/RF_PA/Default, заклёпочная via 0.9/2.5 мм, зазор медь 0.4 / GND 0.5 мм, габарит по факту.
2026-11-04 Исправление BAT54
    [02_power_amp.kicad_sch]
2026-11-04 hw: исправить КСВ-детектор (L4→T3) + DRC-правила этапа 2
    [02_power_amp.kicad_sch]
2026-11-04 docs: синхронизировать документацию этапа 2 (L4→T3, ANT_RELAY)
2026-11-04 hw: унифицировать футпринт T1 на PinHeader (как T2/T3)
    [02_power_amp.kicad_sch]
2026-11-04 docs: обновить T1 → PinHeader в BOM/ТЗ/контексте
2026-11-04 hw: добавить подтяжку Q4 (PTT) — R20 10к на GND
    [02_power_amp.kicad_sch]
2026-11-04 docs: зафиксировать R20 (PTT pull-down) в BOM/решениях/плане
2026-11-04 PCB готов к проверке
    [02_power_amp.kicad_pcb]
2026-11-04 hw: return-loss мост — C11 выборка напряжения
    [02_power_amp.kicad_sch]
2026-11-04 docs: зафиксировать return-loss мост (C11)
2026-11-04 add .kicad_pro to repo
2026-11-04 bom: анализ достаточности компонентов по этапам в Stock/
    CSV склада перенесены в Stock/; добавлены surplus_stage1/2, DKO, Stage_1.1. Пути в AGENTS.md, rules и BOM обновлены на Stock/.
    [ChipDipCart-Stage_1.1.csv, ChipDipCart-Stage_1.csv, ChipDipCart-Stage_2.csv, DKO.csv, capacitors_ 0603.csv, resistance_0603.csv, smd_resistors_0603.csv]
2026-11-04 hw: финальные правки PCB этапа 2 (DRC/ERC clean)
    Уширены /PA_RET (1.0→1.5 мм) и /ANT_RELAY (0.6→1.0 мм); правила .kicad_dru переведены на имена с ведущим слэшем; сняты DRC-exclusions; исправлены netclass_patterns (PA_RET→PWR_PA, добавлен /ANT_RELAY).
    [02_power_amp.kicad_pcb]
2026-11-04 docs: зафиксировать механизм net-классов KiCad 10 + статус PCB этапа 2
    Net-классы определяются в .kicad_pro (net_classes) и привязываются к цепям через шаблоны netclass_patterns, а не явным назначением. Обновлён статус этапа 2 (DRC/ERC чисто).
2026-11-04 hw: добавить подтяжку R21 затвор Q5 (safe default LIMIT)
    [02_power_amp.kicad_sch]
2026-11-04 docs: зафиксировать R21 подтяжку PWR_LIMIT_SW (LIMIT по умолчанию)
2026-11-04 hw: вариант C — убрать Q5/D2/D3, LED на PWR_LIMIT_EN
    [02_power_amp.kicad_sch]
2026-11-04 fw: вариант C — лимит только прошивкой (PWR_LIMIT_EN = AM && LIMIT)
2026-11-04 contract: вариант C — лимит только прошивкой (Q5/D2/D3 удалены)
2026-11-04 bom: вариант C — удалить Q5/D2/D3, счёт 59
2026-11-04 docs: вариант C — design decisions, pcb_layout, power_budget, контекст
2026-11-04 hw: вариант C — удалить Q5/D2/D3 с PCB, LED на PWR_LIMIT_EN
    [02_power_amp.kicad_pcb]
2026-11-04 hw: исправить зазор +12V_PA/GND, переразвести и перезалить зоны
    [02_power_amp.kicad_pcb]
2026-11-05 Add Mounting Hole
    [02_power_amp.kicad_pcb]
2026-11-05 Предварительная разодка платы
    [03_rx_tx.kicad_pcb]
2026-11-05 mech: корпус 180 мм и раскладка плат по периметру
    LTC3780 81x45x12 мм на левой стенке; модели корпуса пересобраны.
    [assembly.FCStd, assembly.step, assembly.stl, back_cover.FCStd, back_cover.step, back_cover.stl, shell_bottom.FCStd, shell_bottom.step]
2026-11-05 docs: план разводки этапа 3 и разъёмы J1-J9 (SMA)
    Поузловой план 113 компонентов, бюджет токов, VFO/BFO = SMA с обеих сторон.
2026-11-05 Восстановил монтажные отверстия
    [02_power_amp.kicad_pcb]
2026-11-05 для первого варинта не плохо. Но надо переразводить
    [03_rx_tx.kicad_pcb]
2026-11-05 mech: сдвиг платы 2, стойки, плата 3 90×60
    Плата 2 вплотную к LTC3780 (зазор 5 мм); стойки платы 2 в build_shells.py; плата 3 90×60; модели пересобраны (BOP CLEAN).
    [assembly.FCStd, assembly.step, assembly.stl, back_cover.FCStd, back_cover.step, shell_bottom.FCStd, shell_bottom.step, shell_bottom.stl]
2026-11-05 docs: плата 3 90×60, дрейф H1 после merge
